gingerologist/am64x/(list of files, drawings)

Other design files:
01.SchDoc
02.SchDoc
03.SchDoc
04.SchDoc
05.SchDoc
06.SchDoc
07.SchDoc
08.SchDoc
09.SchDoc
10.SchDoc
11.SchDoc
12.SchDoc
13.SchDoc
14.SchDoc
15.SchDoc
16.SchDoc
17.SchDoc
18.SchDoc
19.SchDoc
20.SchDoc
21.SchDoc
22.SchDoc
23.SchDoc
24.SchDoc
25.SchDoc
26.SchDoc
27.SchDoc
28.SchDoc
29.SchDoc
30.SchDoc
31.SchDoc
32.SchDoc
33.SchDoc
34.SchDoc
35.SchDoc
36.SchDoc
37.SchDoc
38.SchDoc
39.SchDoc
40.SchDoc
PROC101D_SCH_With_Design_Updates..Notes_V1.0.PrjPcb
PROC101D_SCH_With_Design_Updates..Notes_V1.0_Library.SchLib
