gingerologist/am64x/09.kicad_sch

## KiCad design 09.kicad_sch (2024-08-05)

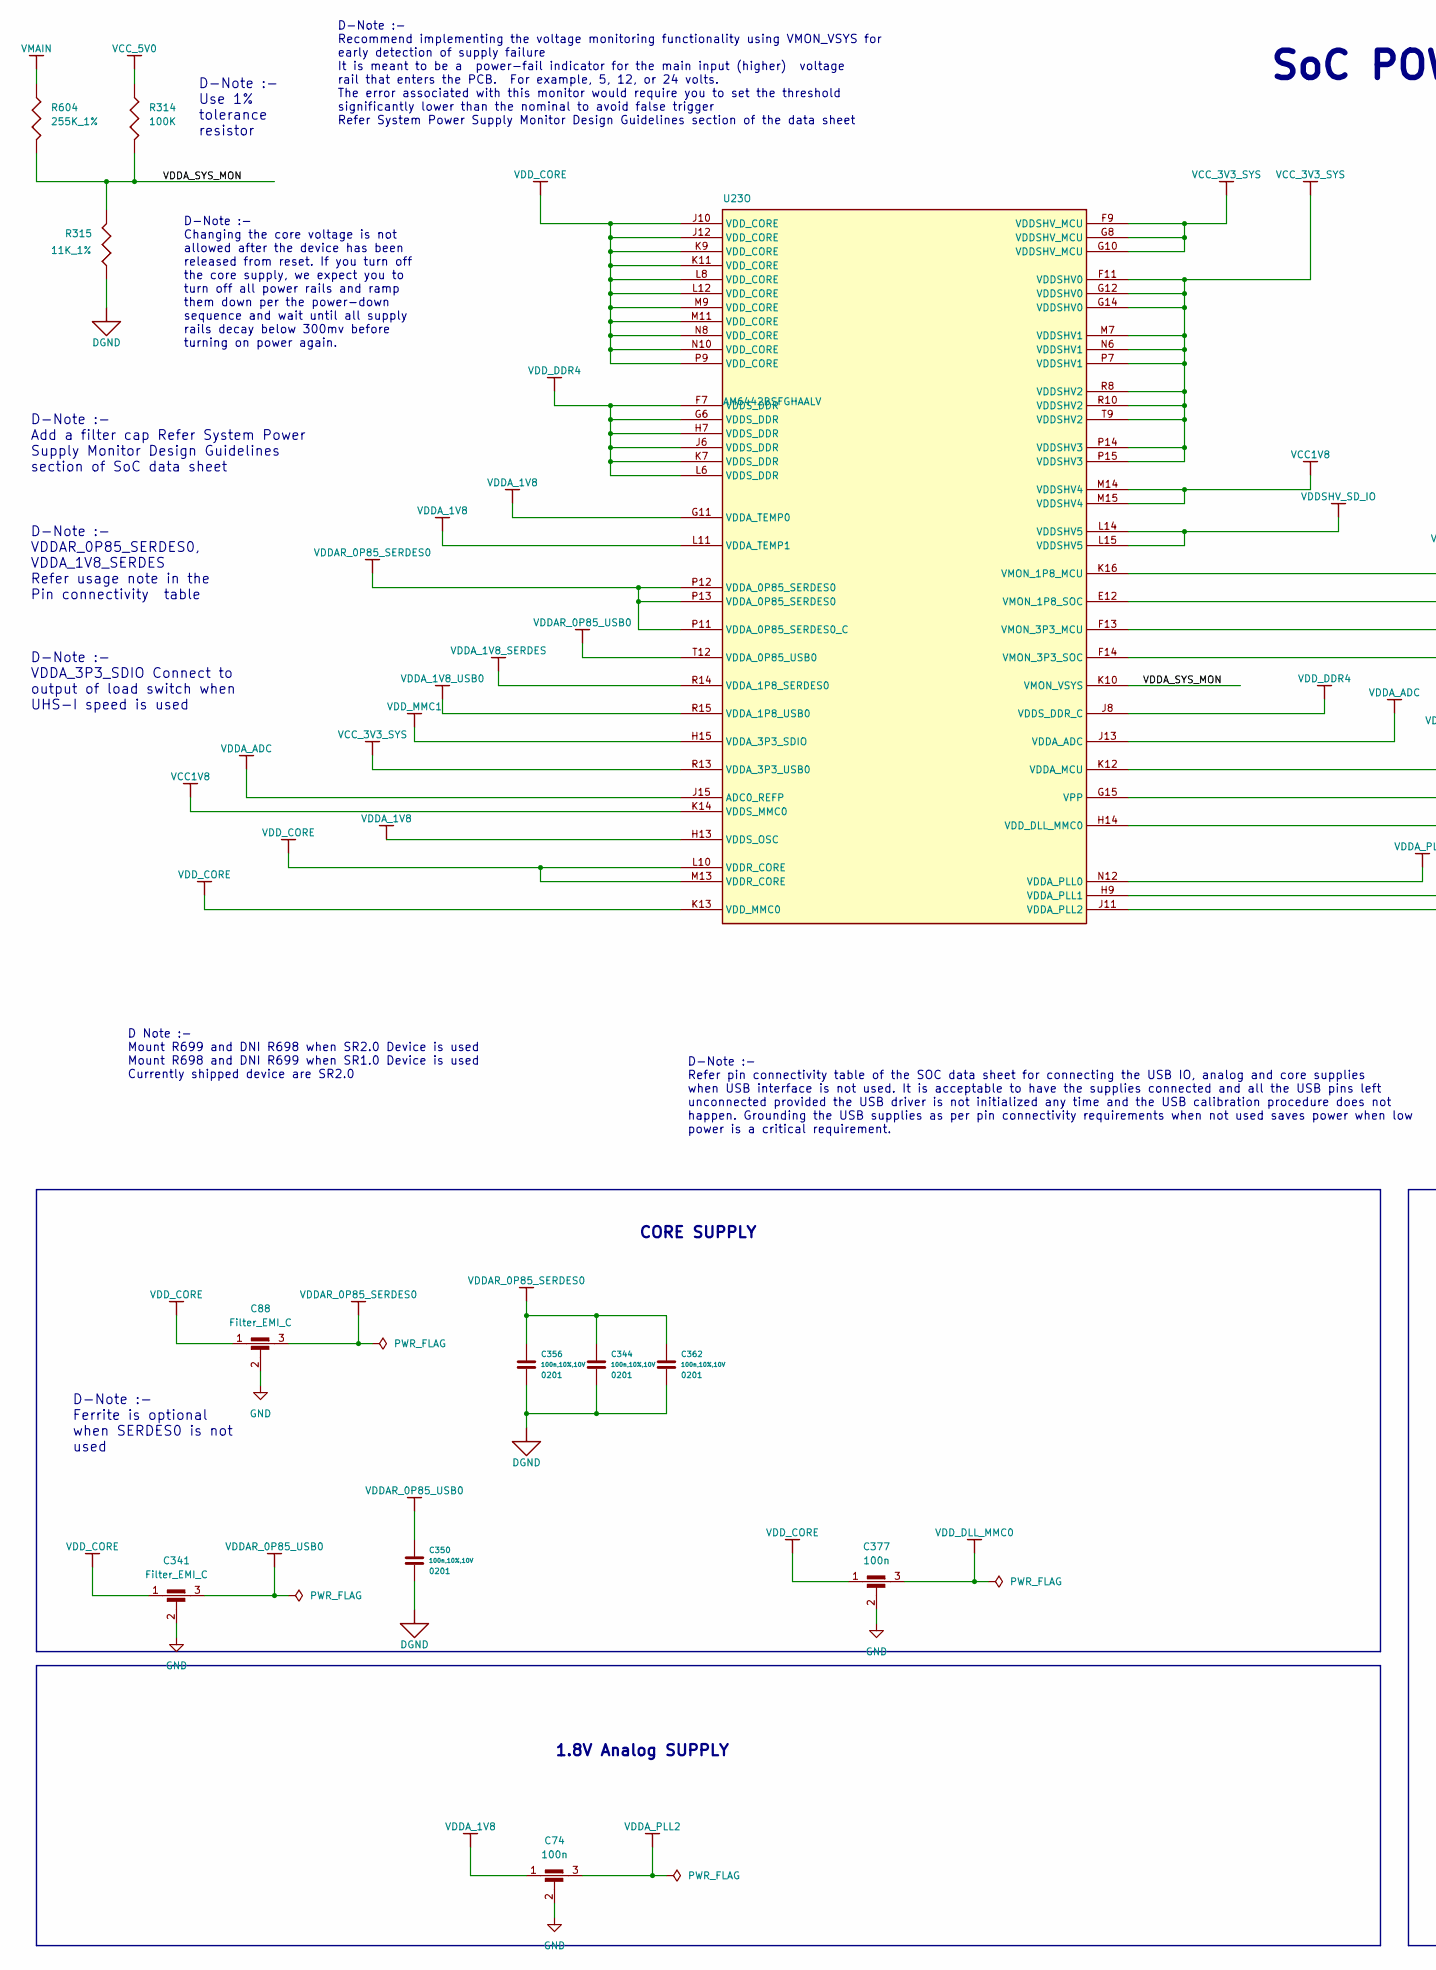
[picture p1: schematic 09.kicad_sch, part in row 1, column 1]

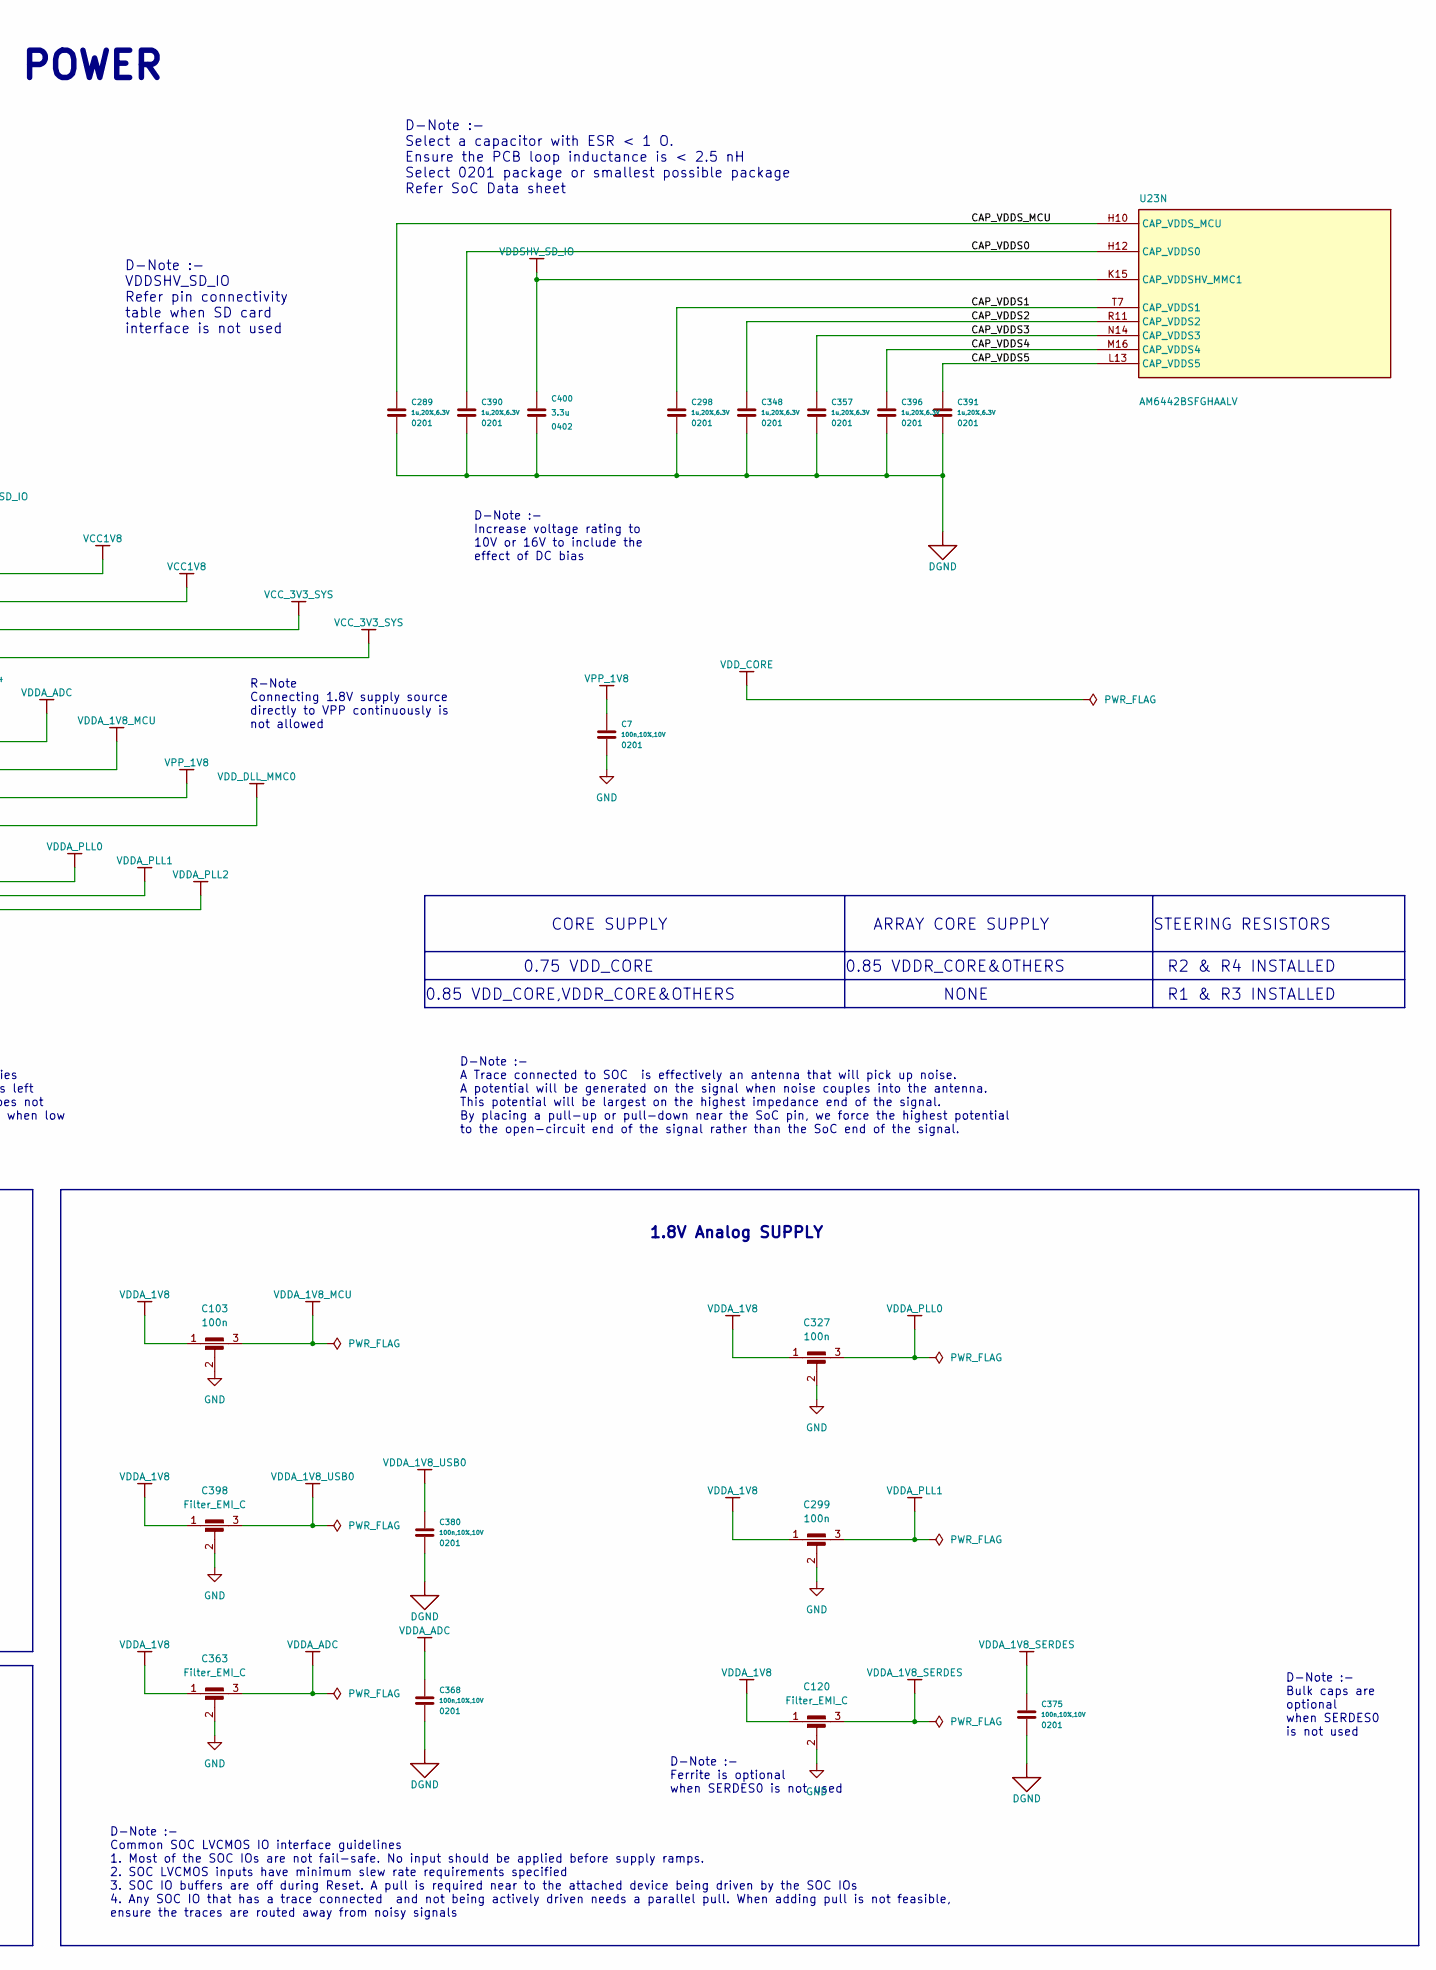
[picture p2: schematic 09.kicad_sch, part in row 1, column 2]

Parts:
C7, C344, C350, C356, C362, C368, C375, C380: 100n,10%,10V; C_0201_0603Metric_0.64x0.32mm_Courtyard; Manufacturer Part GRM033R61A104KE15D
C74, C103, C299, C327, C377: 100n; NFM15
C88, C120, C341, C363, C398: Filter_EMI_C; NFM15
C289, C298, C348, C357, C390, C391, C396: 1u,20%,6.3V; C_0201_0603Metric_0.64x0.32mm_Courtyard; Manufacturer Part GRM033R60J105MEA2D
C400: 3.3u; C_0402_1005Metric
R314: 100K; RES0402_0-5; VOLTAGE NA; TOLERANCE 5%; PART_TYPE RESISTOR~{S}FIXED
R315: 11K_1%; RES0402_0-5; TOLERANCE 1%; VOLTAGE NA; MISTRAL PART NO 110015110012-R
R604: 255K_1%; RES0402_0-5; VOLTAGE NA; TOLERANCE 1%; PART_TYPE RESISTOR~{S}FIXED
U23: AM6442BSFGHAALV; FCBGA441_31-49_680X680_2-6; TOLERANCE NA; VOLTAGE NA; MISTRAL PART NO 141220080002

Connections:
CAP_VDDS0: C390.1, U23.H12 (CAP_VDDS0)
CAP_VDDS1: C298.1, U23.T7 (CAP_VDDS1)
CAP_VDDS2: C348.1, U23.R11 (CAP_VDDS2)
CAP_VDDS3: C357.1, U23.N14 (CAP_VDDS3)
CAP_VDDS4: C396.1, U23.M16 (CAP_VDDS4)
CAP_VDDS5: C391.1, U23.L13 (CAP_VDDS5)
CAP_VDDS_MCU: C289.1, U23.H10 (CAP_VDDS_MCU)
DGND: C289.2, C298.2, C344.2, C348.2, C350.2, C356.2, C357.2, C362.2, C368.2, C375.2, C380.2, C390.2, C391.2, C396.2, C400.2, R315.2
GND: C7.2, C74.2, C88.2, C103.2, C120.2, C299.2, C327.2, C341.2, C363.2, C377.2, C398.2
VCC1V8: U23.E12 (VMON_1P8_SOC), U23.K14 (VDDS_MMC0), U23.K16 (VMON_1P8_MCU), U23.M14 (VDDSHV4), U23.M15 (VDDSHV4)
VCC_3V3_SYS: U23.F9 (VDDSHV_MCU), U23.F11 (VDDSHV0), U23.F13 (VMON_3P3_MCU), U23.F14 (VMON_3P3_SOC), U23.G8 (VDDSHV_MCU), U23.G10 (VDDSHV_MCU), U23.G12 (VDDSHV0), U23.G14 (VDDSHV0), U23.M7 (VDDSHV1), U23.N6 (VDDSHV1), U23.P7 (VDDSHV1), U23.P14 (VDDSHV3), U23.P15 (VDDSHV3), U23.R8 (VDDSHV2), U23.R10 (VDDSHV2), U23.R13 (VDDA_3P3_USB0), U23.T9 (VDDSHV2)
VCC_5V0: R314.1
VDDAR_0P85_SERDES0: C88.3, C344.1, C356.1, C362.1, U23.P11 (VDDA_0P85_SERDES0_C), U23.P12 (VDDA_0P85_SERDES0), U23.P13 (VDDA_0P85_SERDES0)
VDDAR_0P85_USB0: C341.3, C350.1, U23.T12 (VDDA_0P85_USB0)
VDDA_1V8: C74.1, C103.1, C120.1, C299.1, C327.1, C363.1, C398.1, U23.G11 (VDDA_TEMP0), U23.H13 (VDDS_OSC), U23.L11 (VDDA_TEMP1)
VDDA_1V8_MCU: C103.3, U23.K12 (VDDA_MCU)
VDDA_1V8_SERDES: C120.3, C375.1, U23.R14 (VDDA_1P8_SERDES0)
VDDA_1V8_USB0: C380.1, C398.3, U23.R15 (VDDA_1P8_USB0)
VDDA_ADC: C363.3, C368.1, U23.J13 (VDDA_ADC), U23.J15 (ADC0_REFP)
VDDA_PLL0: C327.3, U23.N12 (VDDA_PLL0)
VDDA_PLL1: C299.3, U23.H9 (VDDA_PLL1)
VDDA_PLL2: C74.3, U23.J11 (VDDA_PLL2)
VDDA_SYS_MON: R314.2, R315.1, R604.2, U23.K10 (VMON_VSYS)
VDDSHV_SD_IO: C400.1, U23.K15 (CAP_VDDSHV_MMC1), U23.L14 (VDDSHV5), U23.L15 (VDDSHV5)
VDD_CORE: C88.1, C341.1, C377.1, U23.J10 (VDD_CORE), U23.J12 (VDD_CORE), U23.K9 (VDD_CORE), U23.K11 (VDD_CORE), U23.K13 (VDD_MMC0), U23.L8 (VDD_CORE), U23.L10 (VDDR_CORE), U23.L12 (VDD_CORE), U23.M9 (VDD_CORE), U23.M11 (VDD_CORE), U23.M13 (VDDR_CORE), U23.N8 (VDD_CORE), U23.N10 (VDD_CORE), U23.P9 (VDD_CORE)
VDD_DDR4: U23.F7 (VDDS_DDR), U23.G6 (VDDS_DDR), U23.H7 (VDDS_DDR), U23.J6 (VDDS_DDR), U23.J8 (VDDS_DDR_C), U23.K7 (VDDS_DDR), U23.L6 (VDDS_DDR)
VDD_DLL_MMC0: C377.3, U23.H14 (VDD_DLL_MMC0)
VDD_MMC1: U23.H15 (VDDA_3P3_SDIO)
VMAIN: R604.1
VPP_1V8: C7.1, U23.G15 (VPP)

Notes on the sheet:
D-Note :- Changing the core voltage is not allowed after the device has been released from reset. If you turn off the core supply, we expect you to turn off all power rails and ramp them down per the power-down sequence and wait until all supply rails decay below 300mv before turning on power again.
D-Note :- Ferrite is optional when SERDES0 is not used
D-Note :- Bulk caps are optional when SERDES0 is not used
D-Note :- Increase voltage rating to 10V or 16V to include the effect of DC bias
D-Note :- Ferrite is optional when SERDES0 is not used
D-Note :- VDDAR_0P85_SERDES0, VDDA_1V8_SERDES Refer usage note in the Pin connectivity table
D-Note :- Recommend implementing the voltage monitoring functionality using VMON_VSYS for early detection of supply failure It is meant to be a power-fail indicator for the main input (higher) voltage rail that enters the PCB. For example, 5, 12, or 24 volts. The error associated with this monitor 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
R-Note Connecting 1.8V supply source directly to VPP continuously is not allowed
D-Note :- VDDA_3P3_SDIO Connect to output of load switch when UHS-I speed is used
D-Note :- Add a filter cap Refer System Power Supply Monitor Design Guidelines section of SoC data sheet
D Note :- Mount R699 and DNI R698 when SR2.0 Device is used Mount R698 and DNI R699 when SR1.0 Device is used Currently shipped device are SR2.0
D-Note :- A Trace connected to SOC is effectively an antenna that will pick up noise. A potential will be generated on the signal when noise couples into the antenna. This potential will be largest on the highest impedance end of the signal. By placing a pull-up or pull-down near the SoC pin, we fo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
D-Note :- Common SOC LVCMOS IO interface guidelines 1. Most of the SOC IOs are not fail-safe. No input should be applied before supply ramps. 2. SOC LVCMOS inputs have minimum slew rate requirements specified 3. SOC IO buffers are off during Reset. A pull is required near to the attached device bei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
D-Note :- Use 1% tolerance resistor
D-Note :- VDDSHV_SD_IO Refer pin connectivity table when SD card interface is not used
D-Note :- Select a capacitor with ESR < 1 O. Ensure the PCB loop inductance is < 2.5 nH Select 0201 package or smallest possible package Refer SoC Data sheet
D-Note :- Refer pin connectivity table of the SOC data sheet for connecting the USB IO, analog and core supplies when USB interface is not used. It is acceptable to have the supplies connected and all the USB pins left unconnected provided the USB driver is not initialized any time and the USB cali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
CORE SUPPLY
1.8V Analog SUPPLY
0.85 VDDR_CORE&OTHERS
SoC POWER
STEERING RESISTORS
NONE
0.85 VDD_CORE,VDDR_CORE&OTHERS
ARRAY CORE SUPPLY
R1 & R3 INSTALLED
0.75 VDD_CORE
R2 & R4 INSTALLED
