gingerologist/am64x/10.kicad_sch

## KiCad design 10.kicad_sch (2024-08-05)

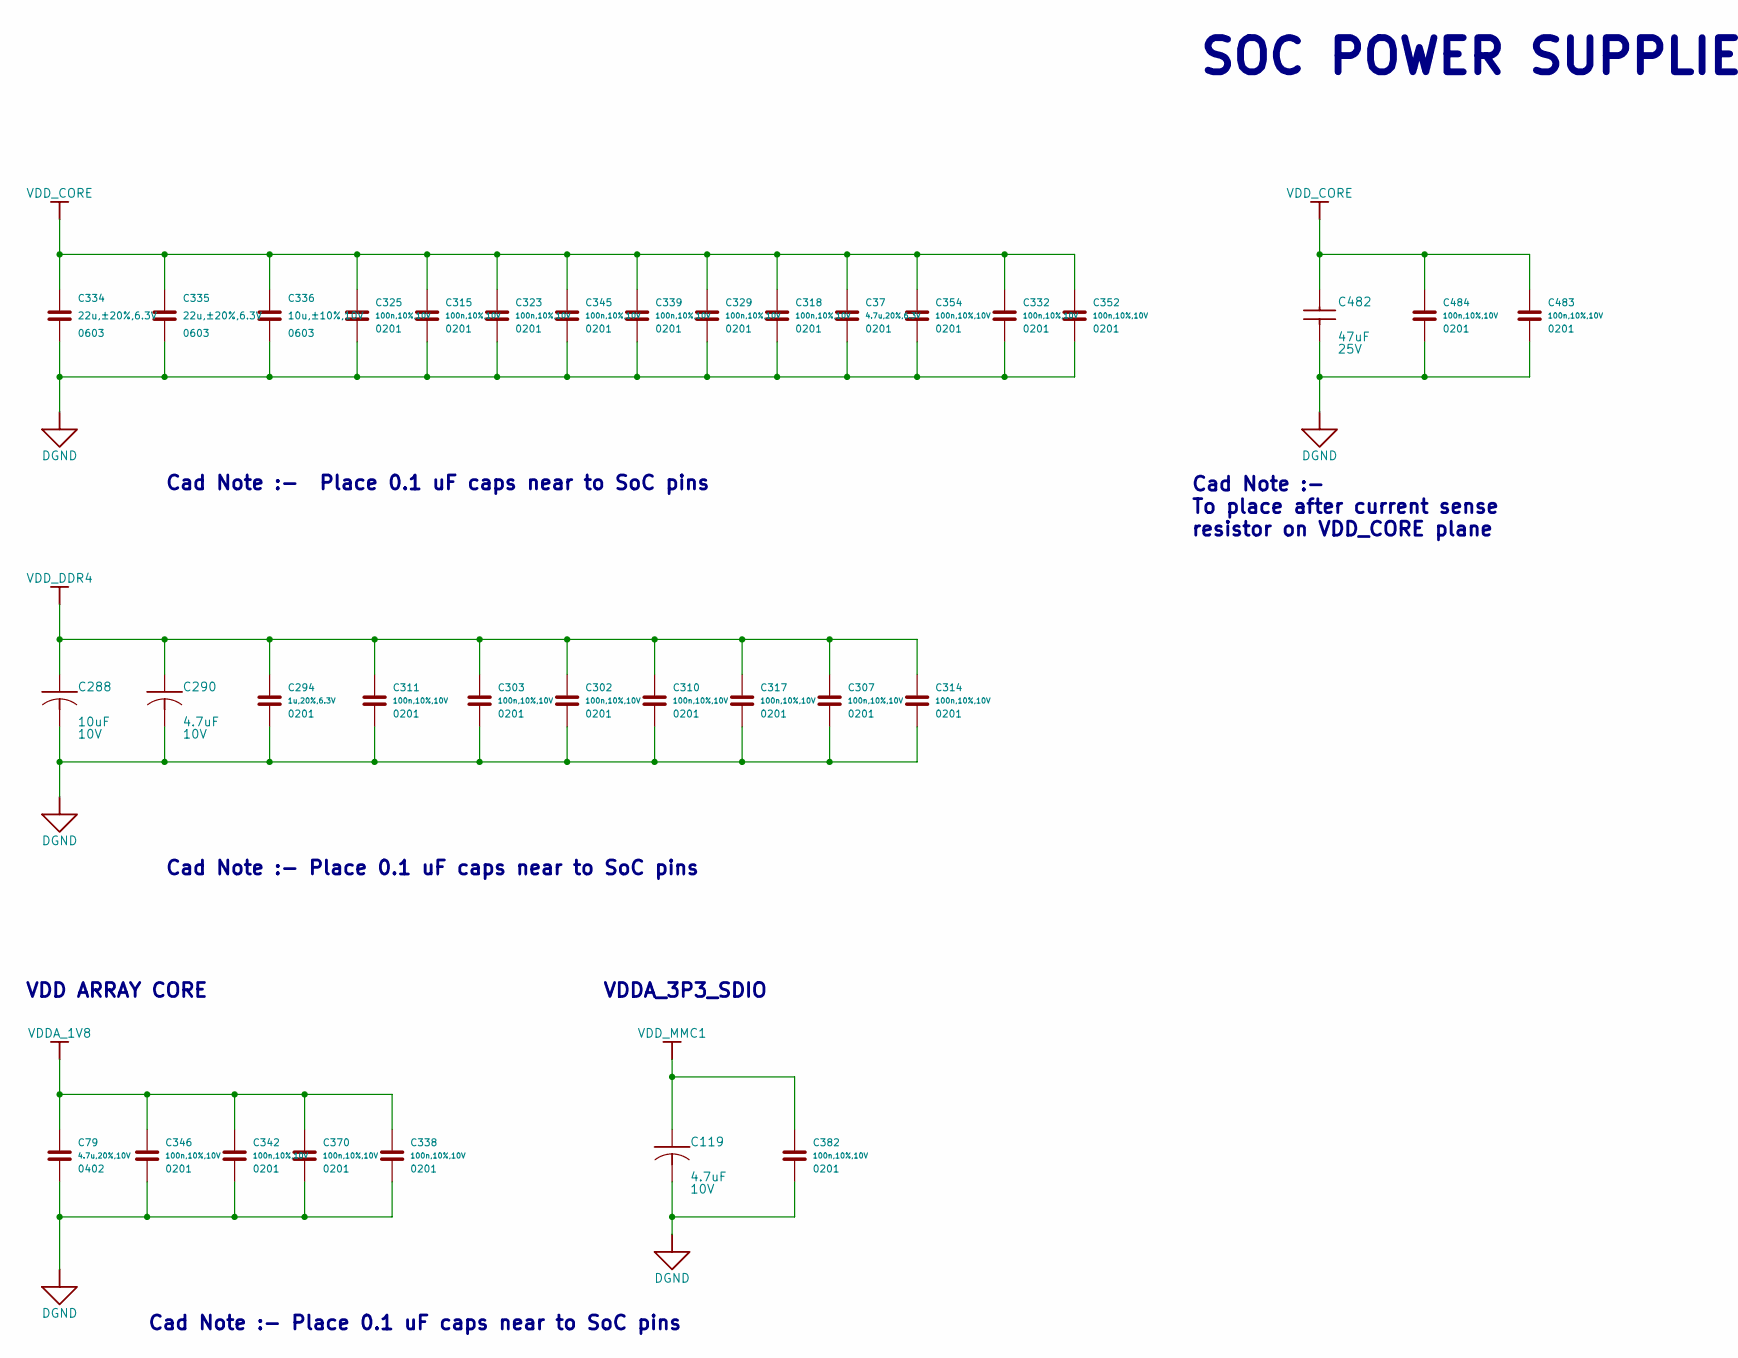
[picture p3: schematic 10.kicad_sch, part in row 1, column 1]

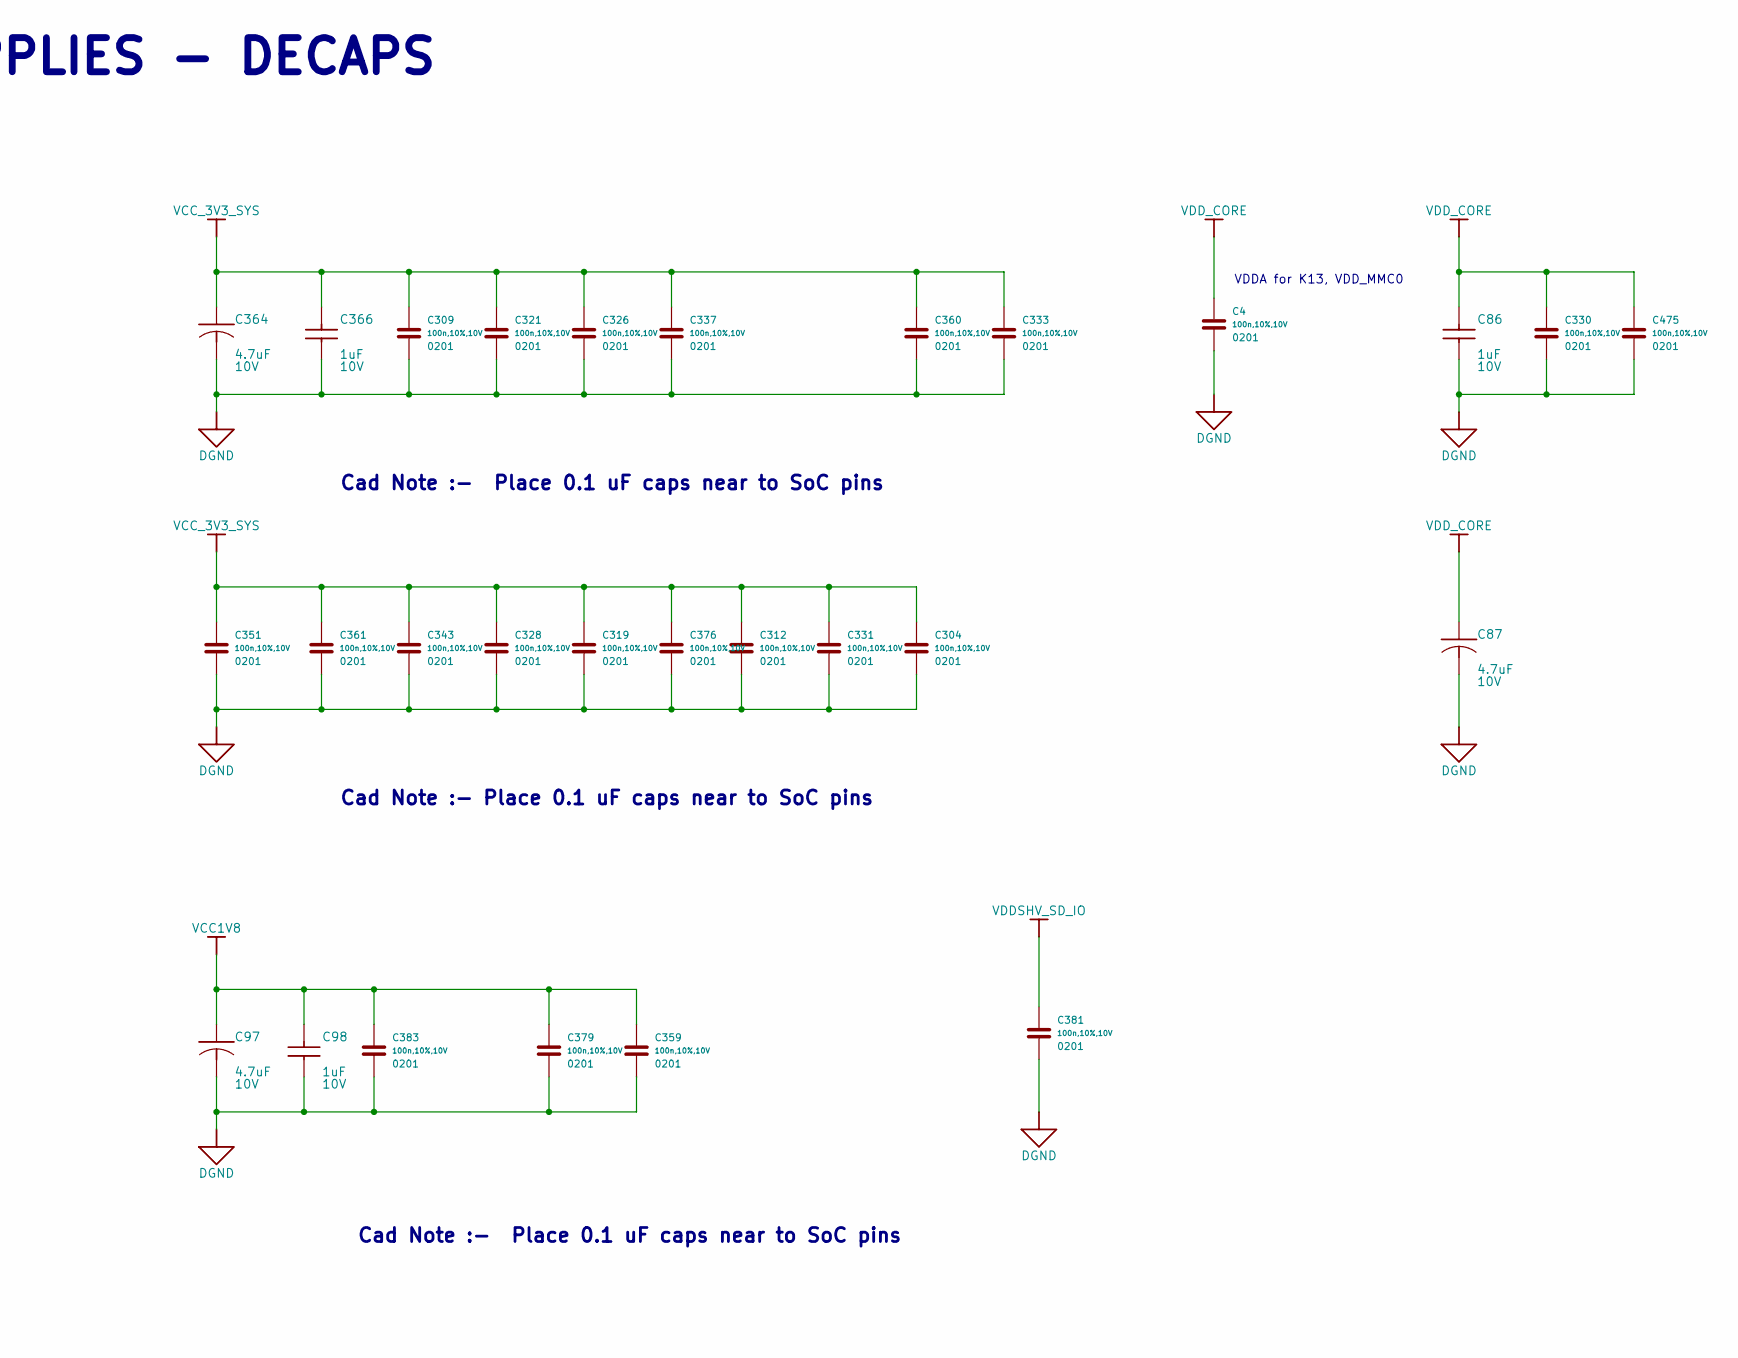
[picture p4: schematic 10.kicad_sch, part in row 1, column 2]

Parts:
C4, C302, C303, C304, C307, C309, C310, C311, C312, C314, C315, C317, C318, C319, C321, C323, C325, C326, C328, C329, C330, C331, C332, C333, C337, C338, C339, C342, C343, C345, C346, C351, C352, C354, C359, C360, C361, C370, C376, C379, C381, C382, C383, C475, C483, C484: 100n,10%,10V; C_0201_0603Metric_0.64x0.32mm_Courtyard; Manufacturer Part GRM033R61A104KE15D
C37: 4.7u,20%,6.3V; C_0201_0603Metric_0.64x0.32mm_Courtyard; Manufacturer Part GRM035R60J475ME15D
C79: 4.7u,20%,10V; C_0402_1005Metric_for_0.25mm_grid; Manufacturer Part CL05A475MP5NRNC
C86, C98: 1uF; CAP0402_0-75; TOLERANCE 20%; VOLTAGE 10V; MISTRAL PART NO 120020080009-R
C87, C119, C290, C364: 4.7uF; CAP0402_0-75; TOLERANCE 20%; VOLTAGE 10V; MISTRAL PART NO 120012060002-R
C97: 4.7uF; CAP0402_0-75; VOLTAGE 10V; TOLERANCE 20%; PART_TYPE CAPACITOR~{S}CERAMIC
C288: 10uF; CAP0402_0-75; TOLERANCE 20%; VOLTAGE 10V; MISTRAL PART NO 120013110019-R
C294: 1u,20%,6.3V; C_0201_0603Metric_0.64x0.32mm_Courtyard; Manufacturer Part GRM033R60J105MEA2D
C334, C335: 22u,±20%,6.3V; C_0603_1608Metric_1.28x0.64mm_Courtyard; Manufacturer Part CL10A226MQ8NRNC
C336: 10u,±10%,10V; C_0603_1608Metric_1.28x0.64mm_Courtyard; Manufacturer Part CL10A106KP8NNNC
C366: 1uF; CAP0402_0-75; VOLTAGE 10V; TOLERANCE 20%; PART_TYPE CAPACITOR~{S}CERAMIC
C482: 47uF; CAP1206_2; TOLERANCE 20%; VOLTAGE 25V; MISTRAL PART NO 120013050002-R

Connections:
DGND: C4.2, C37.2, C79.2, C86.1, C87.2, C97.2, C98.1, C119.2, C288.2, C290.2, C294.2, C302.2, C303.2, C304.2, C307.2, C309.2, C310.2, C311.2, C312.2, C314.2, C315.2, C317.2, C318.2, C319.2, C321.2, C323.2, C325.2, C326.2, C328.2, C329.2, C330.2, C331.2, C332.2, C333.2, C334.2, C335.2, C336.2, C337.2, C338.2, C339.2, C342.2, C343.2, C345.2, C346.2, C351.2, C352.2, C354.2, C359.2, C360.2, C361.2, C364.2, C366.1, C370.2, C376.2, C379.2, C381.2, C382.2, C383.2, C475.2, C482.2, C483.2, C484.2
VCC1V8: C97.1, C98.2, C359.1, C379.1, C383.1
VCC_3V3_SYS: C304.1, C309.1, C312.1, C319.1, C321.1, C326.1, C328.1, C331.1, C333.1, C337.1, C343.1, C351.1, C360.1, C361.1, C364.1, C366.2, C376.1
VDDA_1V8: C79.1, C338.1, C342.1, C346.1, C370.1
VDDSHV_SD_IO: C381.1
VDD_CORE: C4.1, C37.1, C86.2, C87.1, C315.1, C318.1, C323.1, C325.1, C329.1, C330.1, C332.1, C334.1, C335.1, C336.1, C339.1, C345.1, C352.1, C354.1, C475.1, C482.1, C483.1, C484.1
VDD_DDR4: C288.1, C290.1, C294.1, C302.1, C303.1, C307.1, C310.1, C311.1, C314.1, C317.1
VDD_MMC1: C119.1, C382.1

Notes on the sheet:
Cad Note :- To place after current sense resistor on VDD_CORE plane
Cad Note :- Place 0.1 uF caps near to SoC pins
Cad Note :- Place 0.1 uF caps near to SoC pins
SOC POWER SUPPLIES - DECAPS
VDDA_3P3_SDIO
VDDA for K13, VDD_MMC0
VDD ARRAY CORE
