gingerologist/am64x/11.kicad_sch

## KiCad design 11.kicad_sch (2024-08-05)

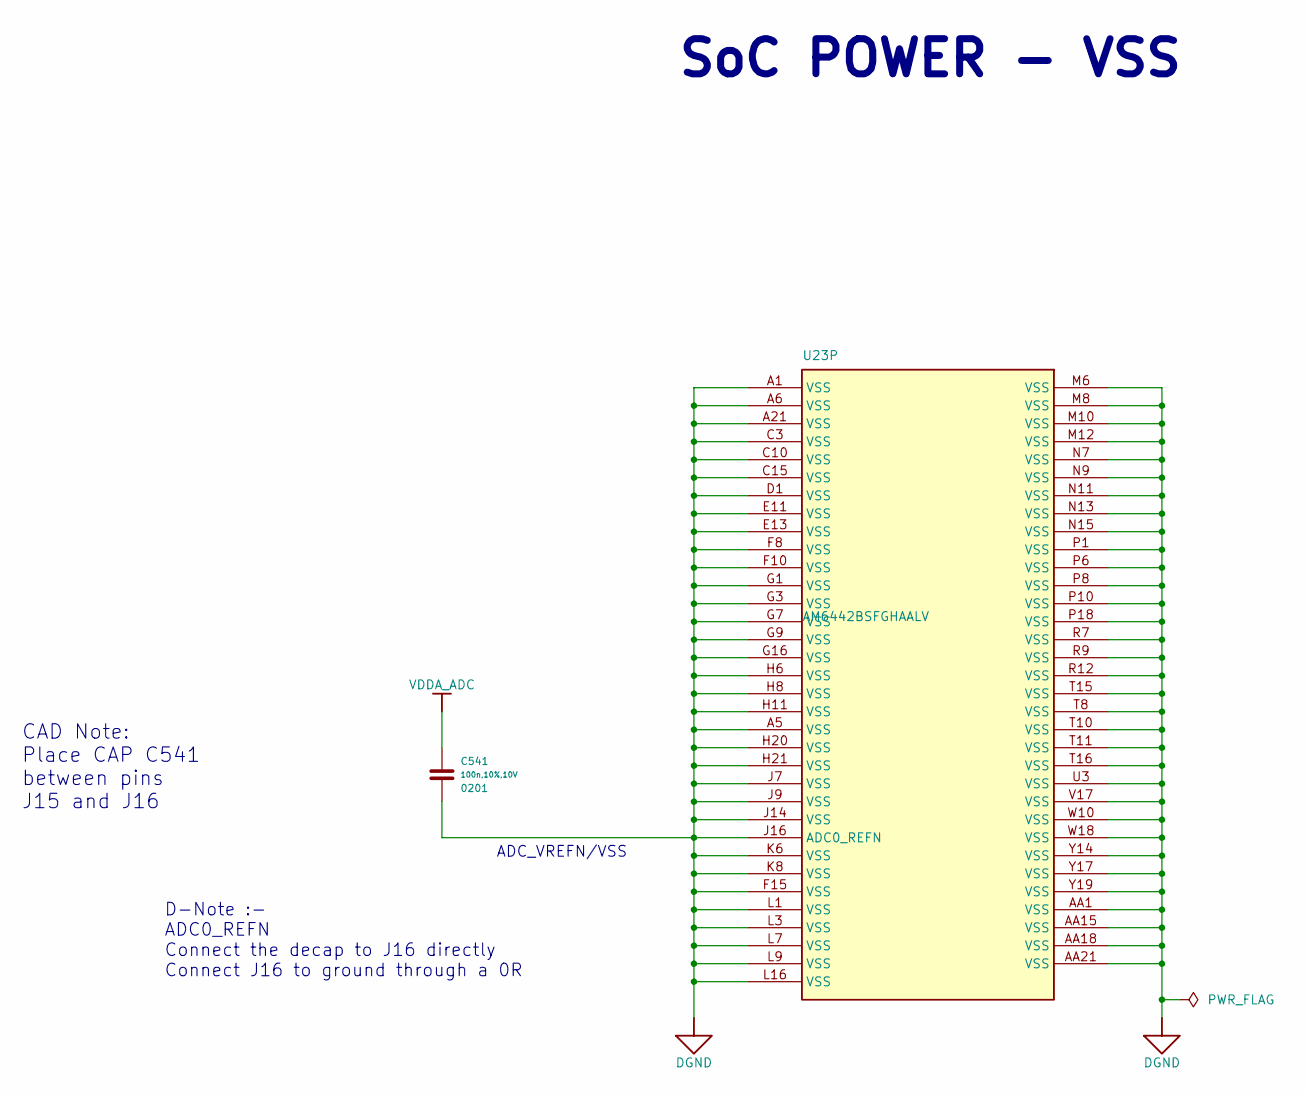
[picture p5: schematic 11.kicad_sch]

Parts:
C541: 100n,10%,10V; C_0201_0603Metric_0.64x0.32mm_Courtyard; Manufacturer Part GRM033R61A104KE15D
U23: AM6442BSFGHAALV; FCBGA441_31-49_680X680_2-6; TOLERANCE NA; VOLTAGE NA; MISTRAL PART NO 141220080002

Connections:
DGND: C541.2, U23.A1 (VSS), U23.A5 (VSS), U23.A6 (VSS), U23.A21 (VSS), U23.AA1 (VSS), U23.AA15 (VSS), U23.AA18 (VSS), U23.AA21 (VSS), U23.C3 (VSS), U23.C10 (VSS), U23.C15 (VSS), U23.D1 (VSS), U23.E11 (VSS), U23.E13 (VSS), U23.F8 (VSS), U23.F10 (VSS), U23.F15 (VSS), U23.G1 (VSS), U23.G3 (VSS), U23.G7 (VSS), U23.G9 (VSS), U23.G16 (VSS), U23.H6 (VSS), U23.H8 (VSS), U23.H11 (VSS), U23.H20 (VSS), U23.H21 (VSS), U23.J7 (VSS), U23.J9 (VSS), U23.J14 (VSS), U23.J16 (ADC0_REFN), U23.K6 (VSS), U23.K8 (VSS), U23.L1 (VSS), U23.L3 (VSS), U23.L7 (VSS), U23.L9 (VSS), U23.L16 (VSS), U23.M6 (VSS), U23.M8 (VSS), U23.M10 (VSS), U23.M12 (VSS), U23.N7 (VSS), U23.N9 (VSS), U23.N11 (VSS), U23.N13 (VSS), U23.N15 (VSS), U23.P1 (VSS), U23.P6 (VSS), U23.P8 (VSS), U23.P10 (VSS), U23.P18 (VSS), U23.R7 (VSS), U23.R9 (VSS), U23.R12 (VSS), U23.T8 (VSS), U23.T10 (VSS), U23.T11 (VSS), U23.T15 (VSS), U23.T16 (VSS), U23.U3 (VSS), U23.V17 (VSS), U23.W10 (VSS), U23.W18 (VSS), U23.Y14 (VSS), U23.Y17 (VSS), U23.Y19 (VSS)
VDDA_ADC: C541.1

Notes on the sheet:
D-Note :- ADC0_REFN Connect the decap to J16 directly Connect J16 to ground through a 0R
CAD Note: Place CAP C541 between pins J15 and J16
SoC POWER - VSS
ADC_VREFN/VSS
