gingerologist/am64x/12.kicad_sch

## KiCad design 12.kicad_sch (2024-08-05)

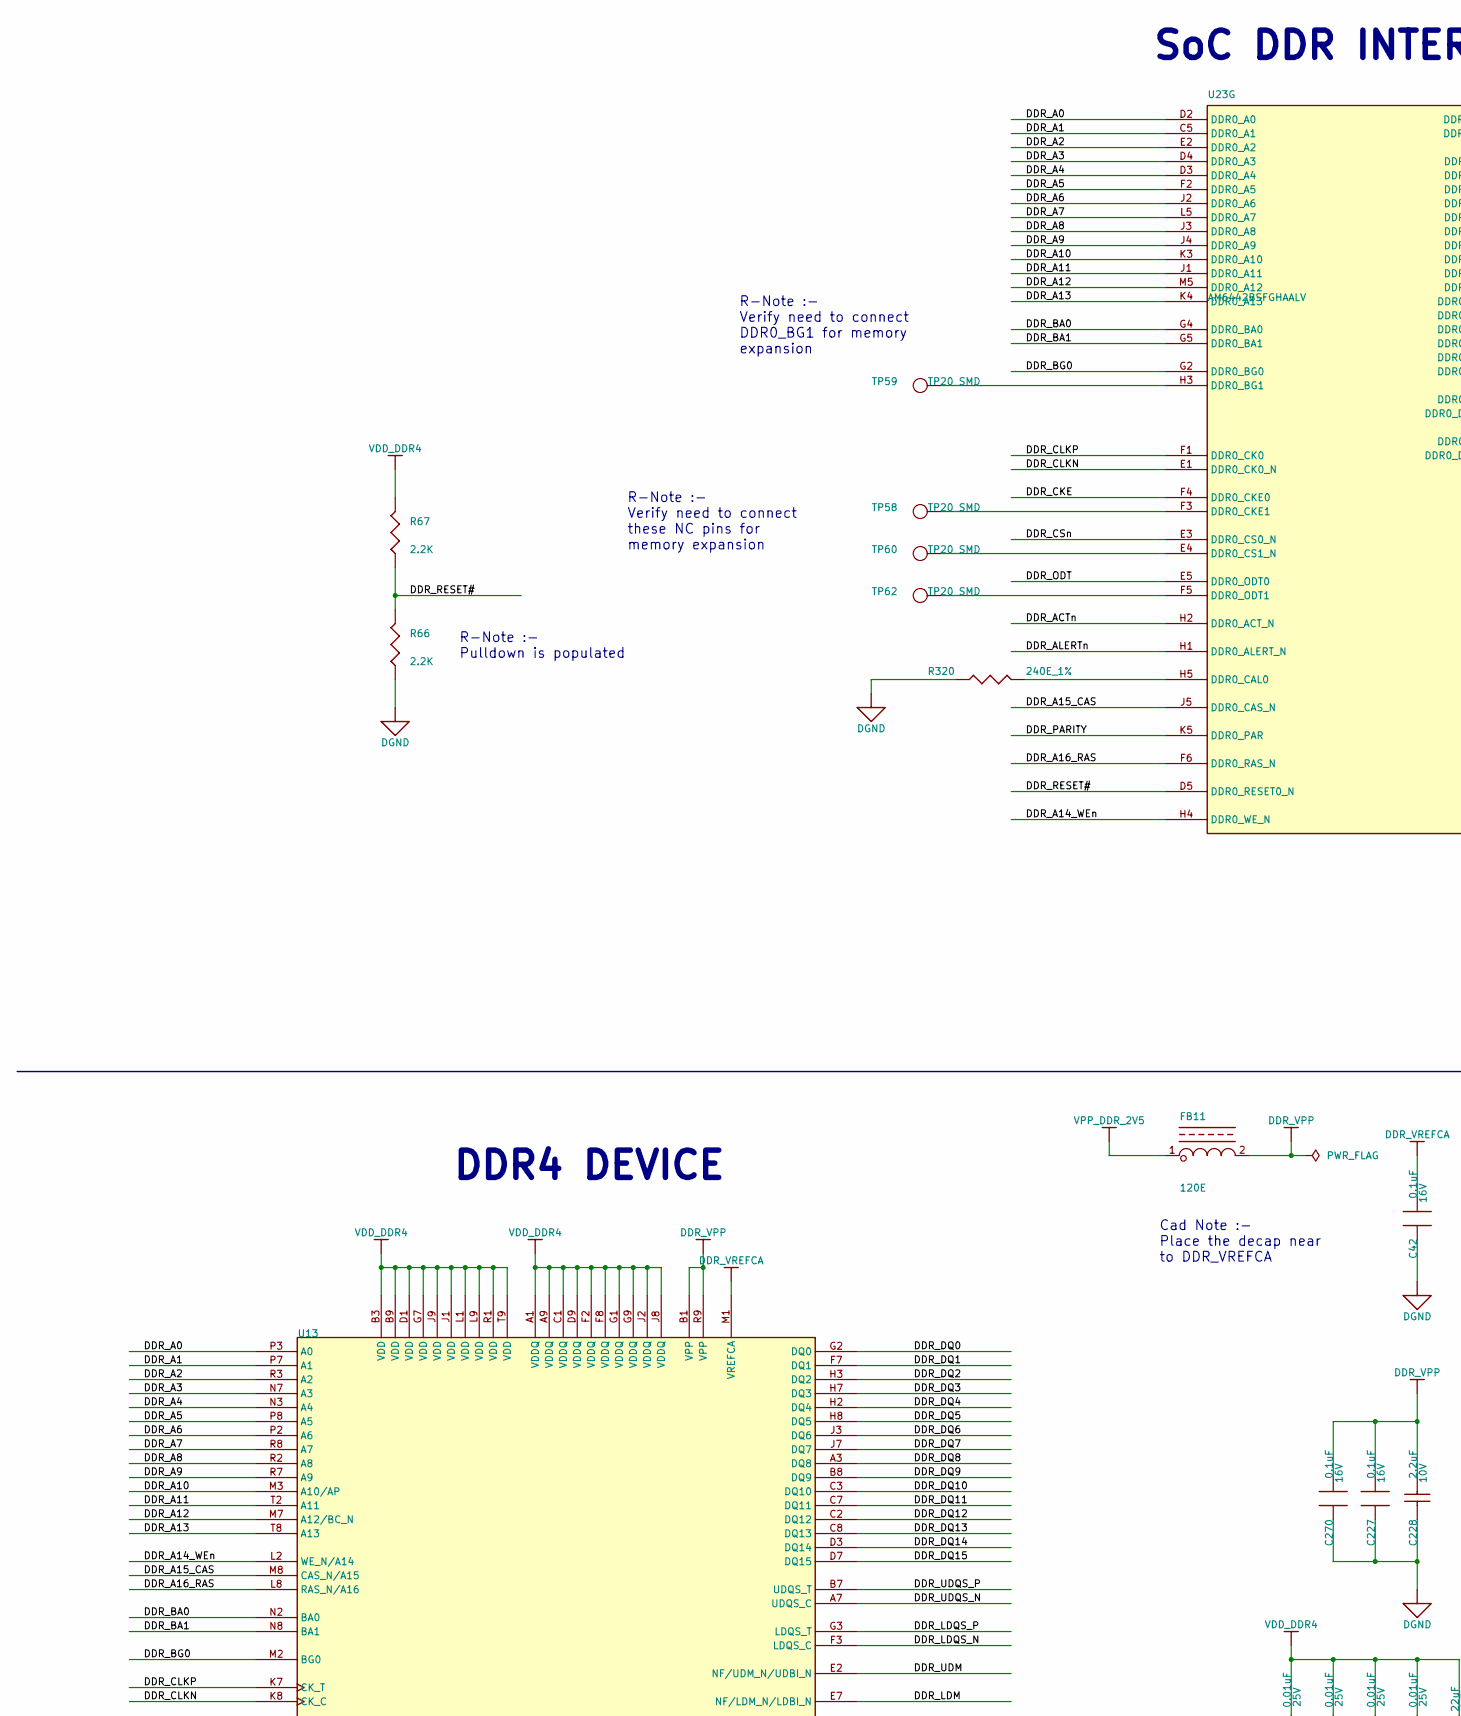
[picture p6: schematic 12.kicad_sch, part in row 1, column 1]

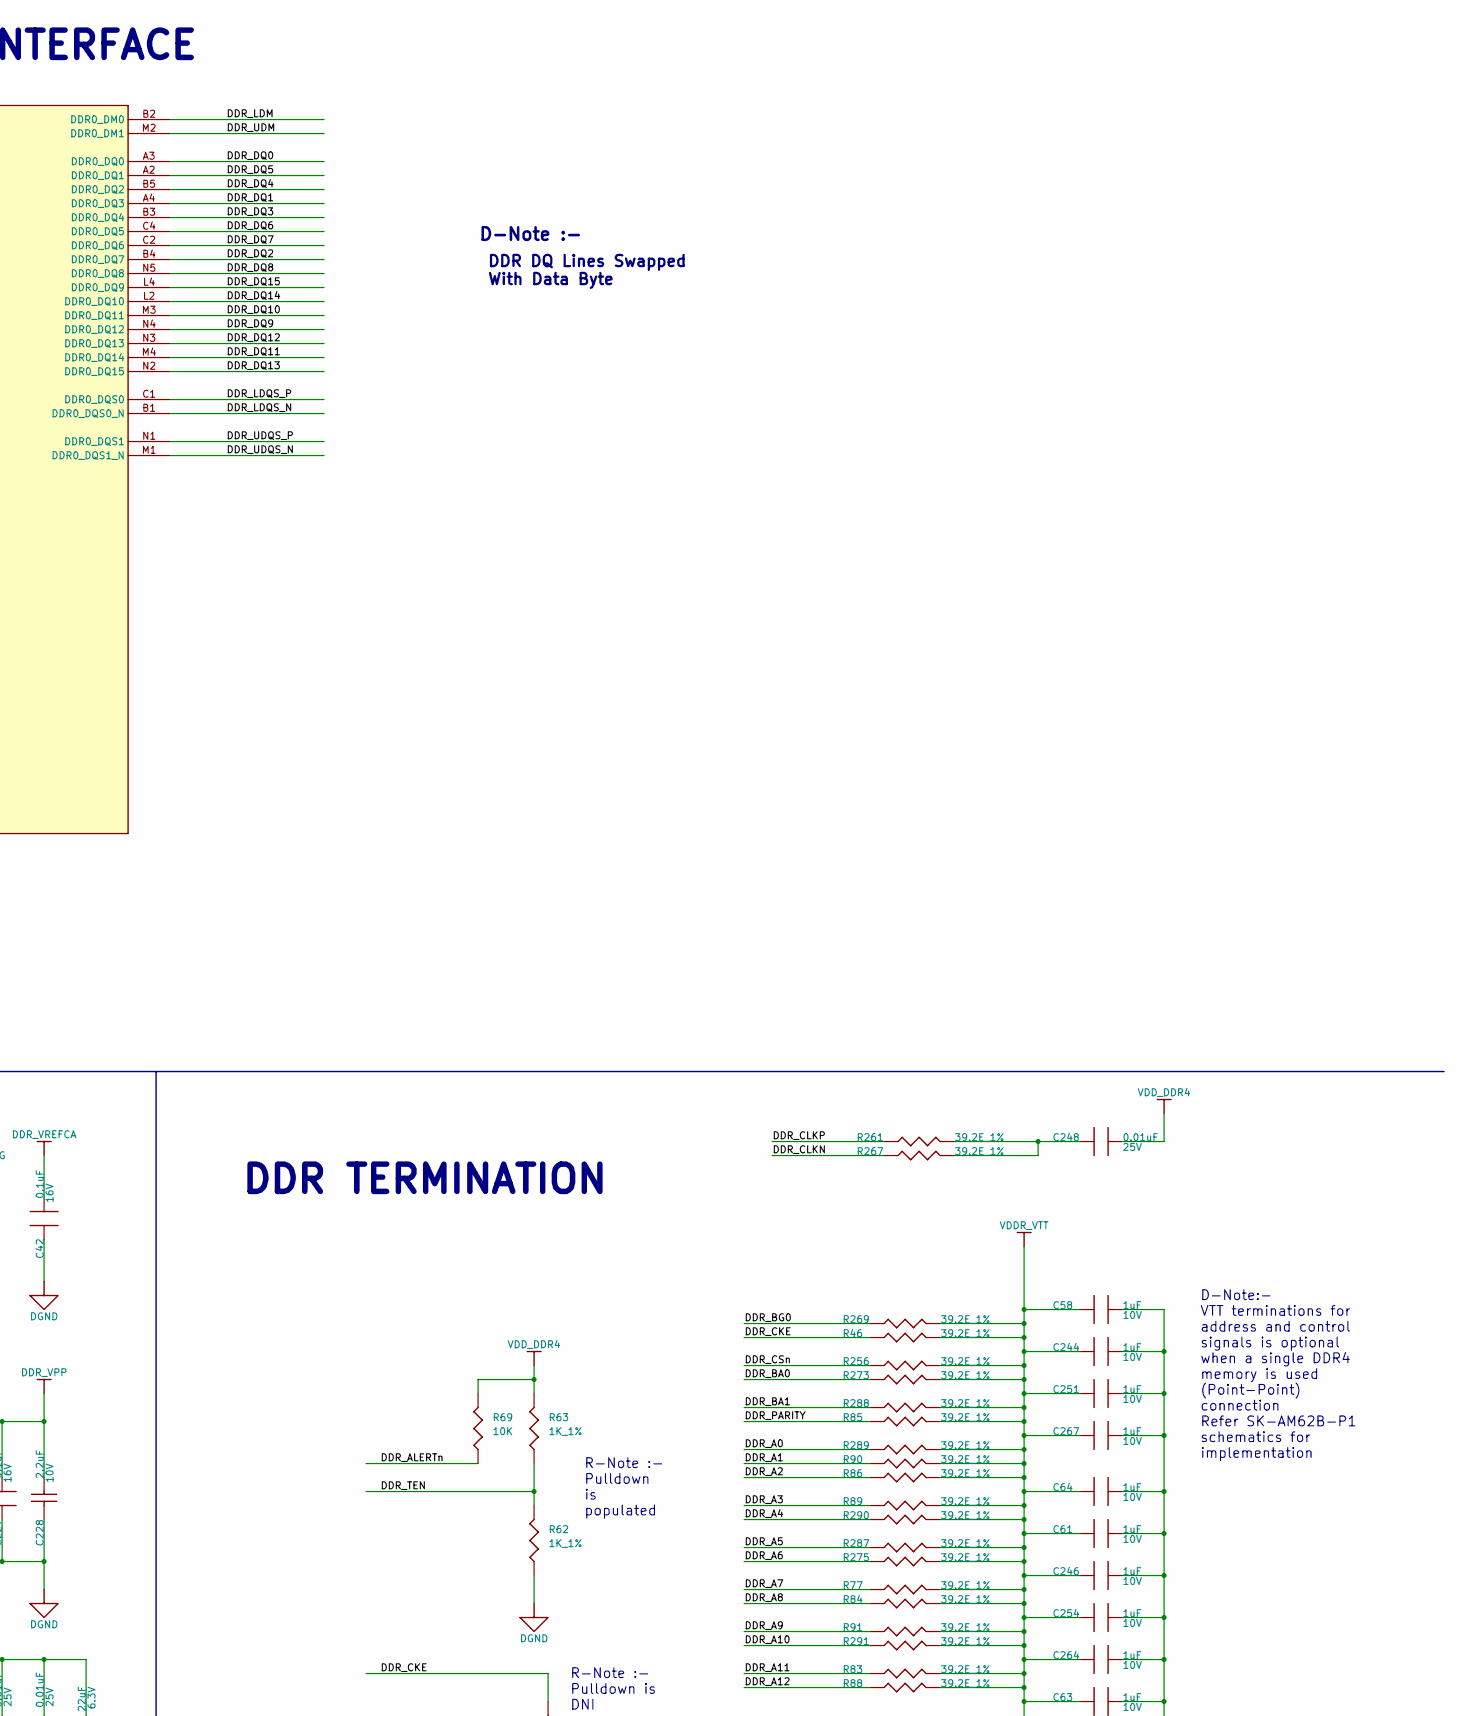
[picture p7: schematic 12.kicad_sch, part in row 1, column 2]

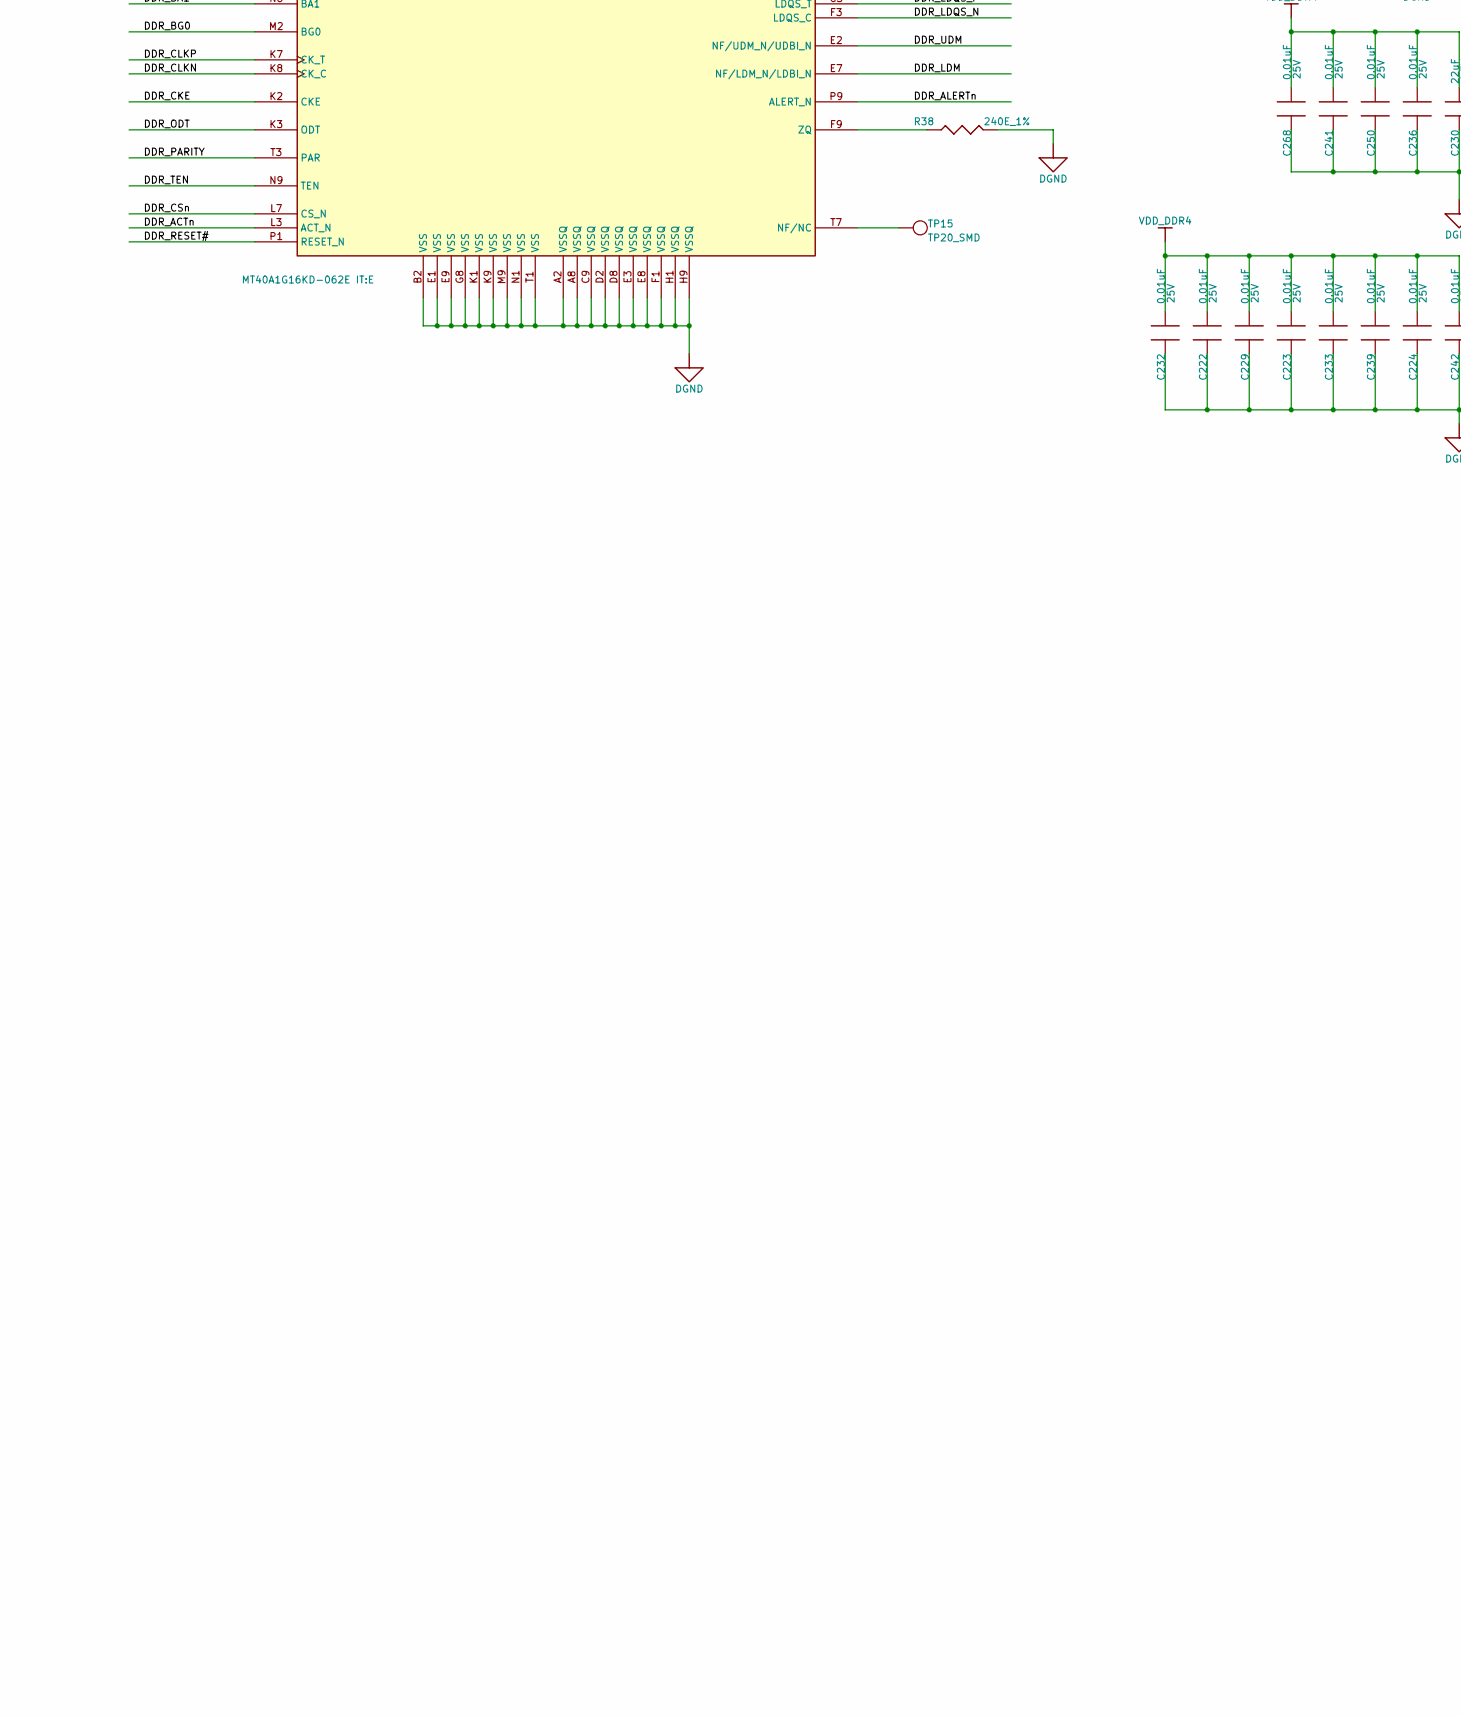
[picture p8: schematic 12.kicad_sch, part in row 2, column 1]

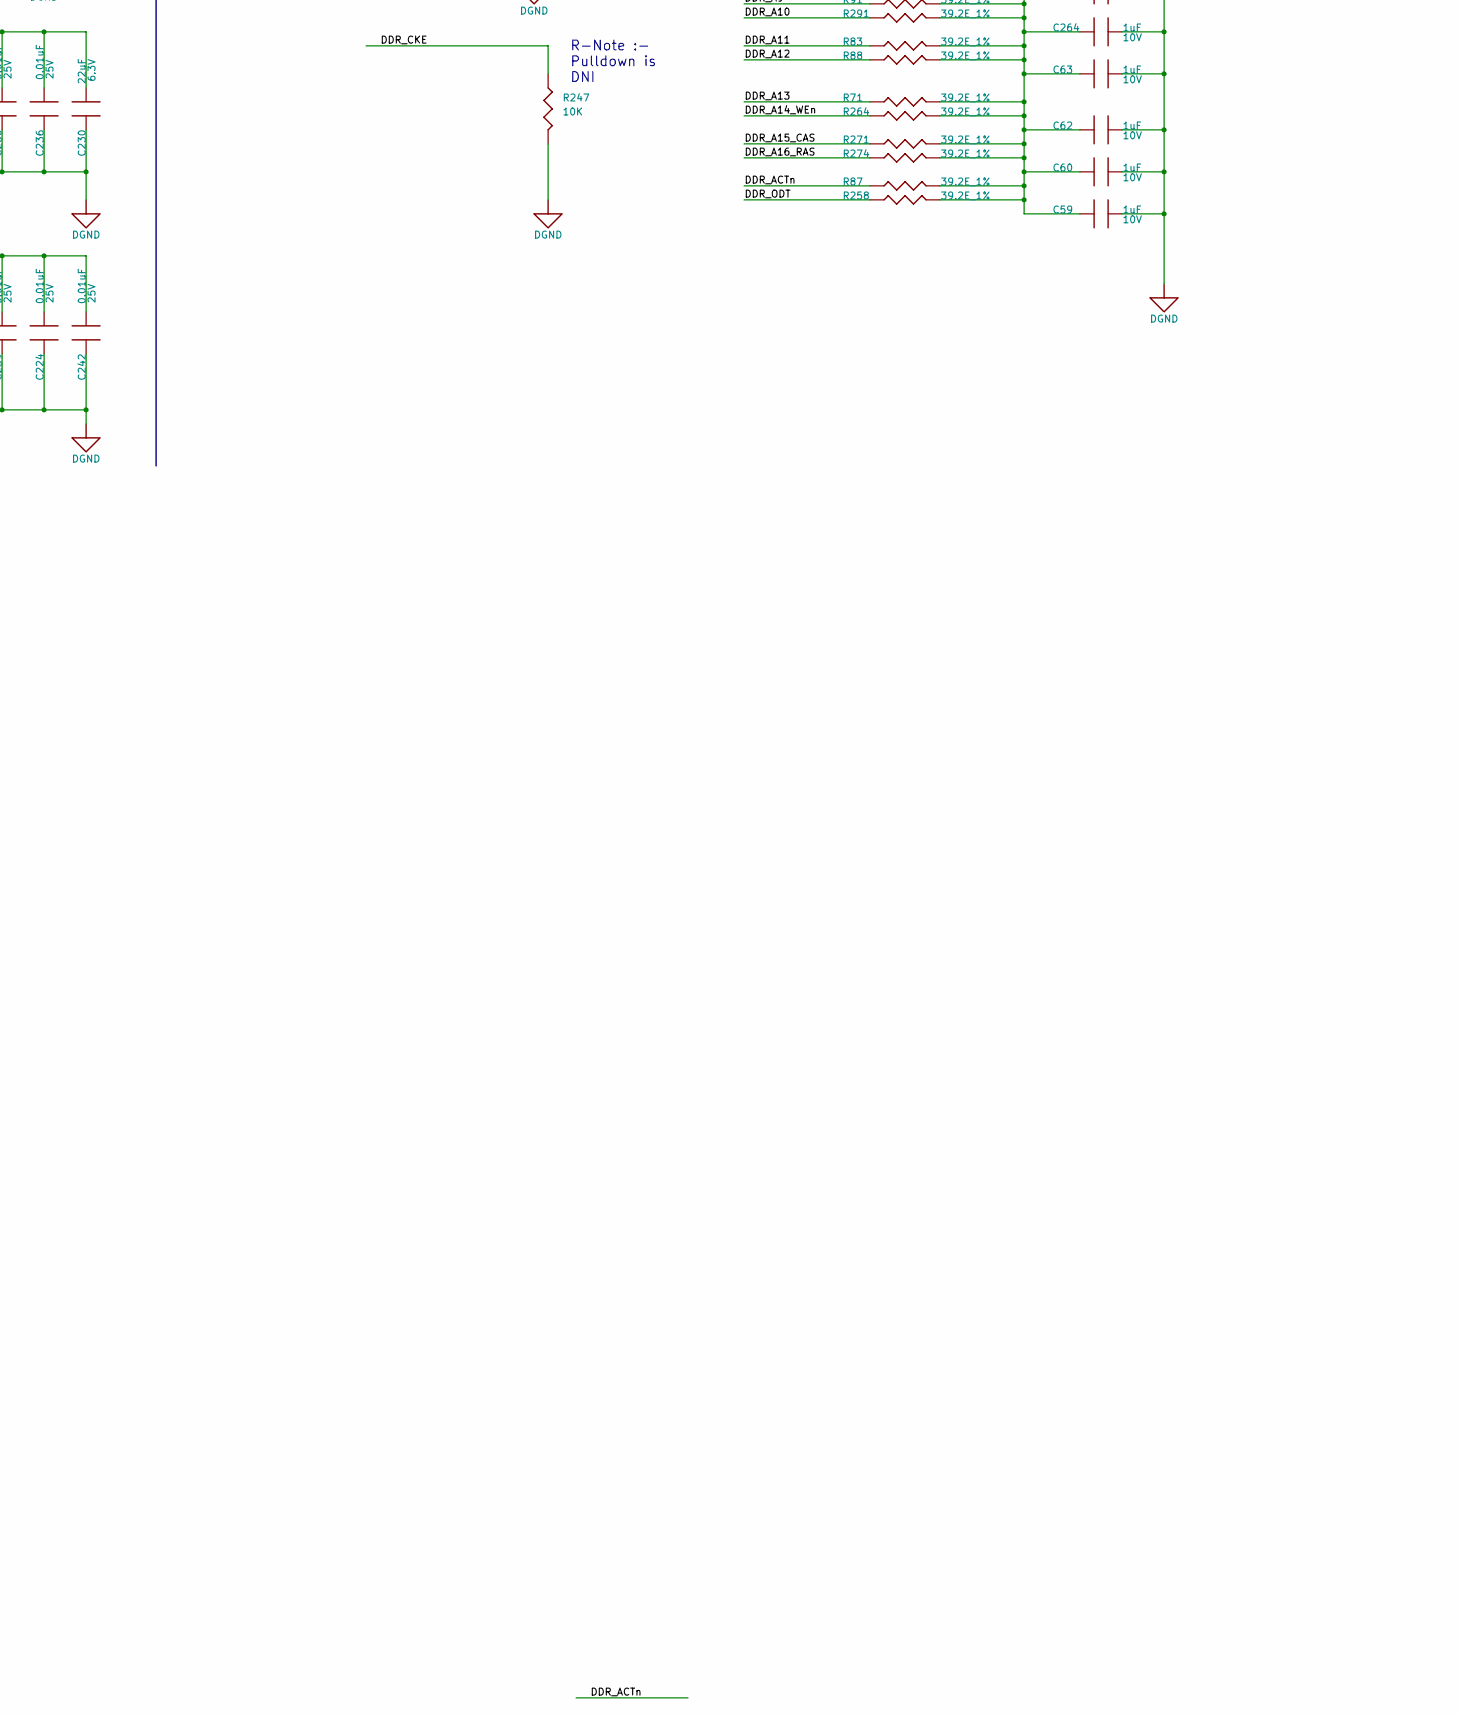
[picture p9: schematic 12.kicad_sch, part in row 2, column 2]

Parts:
C42: 0.1uF; CAP0402N; TOLERANCE 10%; VOLTAGE 16V; MISTRAL PART NO 120009030072-R
C58, C60, C61, C63, C64, C244, C246, C254, C264, C267: 1uF; CAP0402N; VOLTAGE 10V; TOLERANCE 20%; PART_TYPE CAPACITOR~{S}CERAMIC
C59, C62, C251: 1uF; CAP0402N; TOLERANCE 20%; VOLTAGE 10V; MISTRAL PART NO 120020080009-R
C222, C223, C224, C229, C232, C233, C236, C239, C241, C250, C268: 0.01uF; CAP0402N; VOLTAGE 25V; TOLERANCE 10%; PART_TYPE CAPACITOR~{S}CERAMIC
C227, C270: 0.1uF; CAP0402N; VOLTAGE 16V; TOLERANCE 10%; PART_TYPE CAPACITOR~{S}CERAMIC
C228: 2.2uF; CAP0402_0-75; TOLERANCE 20%; VOLTAGE 10V; MISTRAL PART NO 120019040036-R
C230: 22uF; CAP0402N; TOLERANCE 20%; VOLTAGE 6.3V; MISTRAL PART NO 120015090007-R
C242, C248: 0.01uF; CAP0402N; TOLERANCE 10%; VOLTAGE 25V; MISTRAL PART NO 120018010007-R
FB11: 120E; IND0603_1; TOLERANCE 25%; VOLTAGE NA; MISTRAL PART NO 130020080015-R
R38: 240E_1%; RES0402N; TOLERANCE 1%; VOLTAGE NA; MISTRAL PART NO 110011060017-R
R46, R71, R77, R83, R84, R87, R88, R89, R264, R269, R274, R275, R287, R288, R290: 39.2E_1%; RES0402_0-5; VOLTAGE NA; TOLERANCE 1%; PART_TYPE RESISTOR~{S}FIXED
R62: 1K_1%; RES0402_0-5; VOLTAGE NA; TOLERANCE 1%; PART_TYPE RESISTOR~{S}FIXED
R63: 1K_1%; RES0402_0-5; TOLERANCE 1%; VOLTAGE NA; MISTRAL PART NO 110009030411-R
R66, R67: 2.2K; RES0402_0-5; TOLERANCE 5%; VOLTAGE NA; MISTRAL PART NO 110010120018-R
R69: 10K; RES0402_0-5; VOLTAGE NA; TOLERANCE 5%; PART_TYPE RESISTOR~{S}FIXED
R85, R86, R90, R91, R256, R258, R261, R267, R271, R273, R289, R291: 39.2E_1%; RES0402_0-5; TOLERANCE 1%; VOLTAGE NA; MISTRAL PART NO 110011040030-R
R247: 10K; RES0402_0-5; TOLERANCE 5%; VOLTAGE NA; MISTRAL PART NO 110011060021-R
R320: 240E_1%; RES0402N; VOLTAGE NA; TOLERANCE 1%; PART_TYPE RESISTOR~{S}FIXED
TP15, TP58: TP20_SMD; TOLERANCE NA; VOLTAGE NA; PART_TYPE TESTPOINT
TP59: TP20_SMD; VOLTAGE NA; TOLERANCE NA; PART_TYPE TESTPOINT
TP60, TP62: TP20_SMD; TOLERANCE NA; VOLTAGE NA; MISTRAL PART NO NA
U13: MT40A1G16KD-062E IT:E; FBGA96_31-49_520X360_1-2; VOLTAGE NA; TOLERANCE NA; PART_TYPE IC~{S}DIGITA~{L}MEMORY
U23: AM6442BSFGHAALV; FCBGA441_31-49_680X680_2-6; TOLERANCE NA; VOLTAGE NA; MISTRAL PART NO 141220080002

Connections:
DDR_A0: R289.1, U13.P3 (A0), U23.D2 (DDR0_A0)
DDR_A1: R90.1, U13.P7 (A1), U23.C5 (DDR0_A1)
DDR_A2: R86.1, U13.R3 (A2), U23.E2 (DDR0_A2)
DDR_A3: R89.1, U13.N7 (A3), U23.D4 (DDR0_A3)
DDR_A4: R290.1, U13.N3 (A4), U23.D3 (DDR0_A4)
DDR_A5: R287.1, U13.P8 (A5), U23.F2 (DDR0_A5)
DDR_A6: R275.1, U13.P2 (A6), U23.J2 (DDR0_A6)
DDR_A7: R77.1, U13.R8 (A7), U23.L5 (DDR0_A7)
DDR_A8: R84.1, U13.R2 (A8), U23.J3 (DDR0_A8)
DDR_A9: R91.1, U13.R7 (A9), U23.J4 (DDR0_A9)
DDR_A10: R291.1, U13.M3 (A10/AP), U23.K3 (DDR0_A10)
DDR_A11: R83.1, U13.T2 (A11), U23.J1 (DDR0_A11)
DDR_A12: R88.1, U13.M7 (A12/BC_N), U23.M5 (DDR0_A12)
DDR_A13: R71.1, U13.T8 (A13), U23.K4 (DDR0_A13)
DDR_A14_WEn: R264.1, U13.L2 (WE_N/A14), U23.H4 (DDR0_WE_N)
DDR_A15_CAS: R271.1, U13.M8 (CAS_N/A15), U23.J5 (DDR0_CAS_N)
DDR_A16_RAS: R274.1, U13.L8 (RAS_N/A16), U23.F6 (DDR0_RAS_N)
DDR_ACTn: R87.1, U13.L3 (ACT_N), U23.H2 (DDR0_ACT_N)
DDR_ALERTn: R69.1, U13.P9 (ALERT_N), U23.H1 (DDR0_ALERT_N)
DDR_BA0: R273.1, U13.N2 (BA0), U23.G4 (DDR0_BA0)
DDR_BA1: R288.1, U13.N8 (BA1), U23.G5 (DDR0_BA1)
DDR_BG0: R269.1, U13.M2 (BG0), U23.G2 (DDR0_BG0)
DDR_CKE: R46.1, R247.1, U13.K2 (CKE), U23.F4 (DDR0_CKE0)
DDR_CLKN: R267.1, U13.K8 (CK_C), U23.E1 (DDR0_CK0_N)
DDR_CLKP: R261.1, U13.K7 (CK_T), U23.F1 (DDR0_CK0)
DDR_CSn: R256.1, U13.L7 (CS_N), U23.E3 (DDR0_CS0_N)
DDR_DQ0: U13.G2 (DQ0), U23.A3 (DDR0_DQ0)
DDR_DQ1: U13.F7 (DQ1), U23.A4 (DDR0_DQ3)
DDR_DQ2: U13.H3 (DQ2), U23.B4 (DDR0_DQ7)
DDR_DQ3: U13.H7 (DQ3), U23.B3 (DDR0_DQ4)
DDR_DQ4: U13.H2 (DQ4), U23.B5 (DDR0_DQ2)
DDR_DQ5: U13.H8 (DQ5), U23.A2 (DDR0_DQ1)
DDR_DQ6: U13.J3 (DQ6), U23.C4 (DDR0_DQ5)
DDR_DQ7: U13.J7 (DQ7), U23.C2 (DDR0_DQ6)
DDR_DQ8: U13.A3 (DQ8), U23.N5 (DDR0_DQ8)
DDR_DQ9: U13.B8 (DQ9), U23.N4 (DDR0_DQ12)
DDR_DQ10: U13.C3 (DQ10), U23.M3 (DDR0_DQ11)
DDR_DQ11: U13.C7 (DQ11), U23.M4 (DDR0_DQ14)
DDR_DQ12: U13.C2 (DQ12), U23.N3 (DDR0_DQ13)
DDR_DQ13: U13.C8 (DQ13), U23.N2 (DDR0_DQ15)
DDR_DQ14: U13.D3 (DQ14), U23.L2 (DDR0_DQ10)
DDR_DQ15: U13.D7 (DQ15), U23.L4 (DDR0_DQ9)
DDR_LDM: U13.E7 (NF/LDM_N/LDBI_N), U23.B2 (DDR0_DM0)
DDR_LDQS_N: U13.F3 (LDQS_C), U23.B1 (DDR0_DQS0_N)
DDR_LDQS_P: U13.G3 (LDQS_T), U23.C1 (DDR0_DQS0)
DDR_ODT: R258.1, U13.K3 (ODT), U23.E5 (DDR0_ODT0)
DDR_PARITY: R85.1, U13.T3 (PAR), U23.K5 (DDR0_PAR)
DDR_RESET#: R66.2, R67.1, U13.P1 (RESET_N), U23.D5 (DDR0_RESET0_N)
DDR_TEN: R62.2, R63.1, U13.N9 (TEN)
DDR_UDM: U13.E2 (NF/UDM_N/UDBI_N), U23.M2 (DDR0_DM1)
DDR_UDQS_N: U13.A7 (UDQS_C), U23.M1 (DDR0_DQS1_N)
DDR_UDQS_P: U13.B7 (UDQS_T), U23.N1 (DDR0_DQS1)
DDR_VPP: C227.2, C228.1, C270.2, FB11.2, U13.B1 (VPP), U13.R9 (VPP)
DDR_VREFCA: C42.2, U13.M1 (VREFCA)
DGND: C42.1, C58.2, C59.2, C60.2, C61.2, C62.2, C63.2, C64.2, C222.2, C223.2, C224.2, C227.1, C228.2, C229.2, C230.2, C232.2, C233.2, C236.2, C239.2, C241.2, C242.2, C244.2, C246.2, C250.2, C251.2, C254.2, C264.2, C267.2, C268.2, C270.1, R38.2, R62.1, R66.1, R247.2, R320.2, U13.A2 (VSSQ), U13.A8 (VSSQ), U13.B2 (VSS), U13.C9 (VSSQ), U13.D2 (VSSQ), U13.D8 (VSSQ), U13.E1 (VSS), U13.E3 (VSSQ), U13.E8 (VSSQ), U13.E9 (VSS), U13.F1 (VSSQ), U13.G8 (VSS), U13.H1 (VSSQ), U13.H9 (VSSQ), U13.K1 (VSS), U13.K9 (VSS), U13.M9 (VSS), U13.N1 (VSS), U13.T1 (VSS)
unnamed: C248.1, R261.2, R267.2
unnamed: R38.1, U13.F9 (ZQ)
unnamed: R320.1, U23.H5 (DDR0_CAL0)
unnamed: TP15.1, U13.T7 (NF/NC)
unnamed: TP58.1, U23.F3 (DDR0_CKE1)
unnamed: TP59.1, U23.H3 (DDR0_BG1)
unnamed: TP60.1, U23.E4 (DDR0_CS1_N)
unnamed: TP62.1, U23.F5 (DDR0_ODT1)
VDDR_VTT: C58.1, C59.1, C60.1, C61.1, C62.1, C63.1, C64.1, C244.1, C246.1, C251.1, C254.1, C264.1, C267.1, R46.2, R71.2, R77.2, R83.2, R84.2, R85.2, R86.2, R87.2, R88.2, R89.2, R90.2, R91.2, R256.2, R258.2, R264.2, R269.2, R271.2, R273.2, R274.2, R275.2, R287.2, R288.2, R289.2, R290.2, R291.2
VDD_DDR4: C222.1, C223.1, C224.1, C229.1, C230.1, C232.1, C233.1, C236.1, C239.1, C241.1, C242.1, C248.2, C250.1, C268.1, R63.2, R67.2, R69.2, U13.A1 (VDDQ), U13.A9 (VDDQ), U13.B3 (VDD), U13.B9 (VDD), U13.C1 (VDDQ), U13.D1 (VDD), U13.D9 (VDDQ), U13.F2 (VDDQ), U13.F8 (VDDQ), U13.G1 (VDDQ), U13.G7 (VDD), U13.G9 (VDDQ), U13.J1 (VDD), U13.J2 (VDDQ), U13.J8 (VDDQ), U13.J9 (VDD), U13.L1 (VDD), U13.L9 (VDD), U13.R1 (VDD), U13.T9 (VDD)
VPP_DDR_2V5: FB11.1

Notes on the sheet:
R-Note :- Verify need to connect DDR0_BG1 for memory expansion
Cad Note :- Place the decap near to DDR_VREFCA
R-Note :- Pulldown is DNI
R-Note :- Pulldown is populated
R-Note :- Verify need to connect these NC pins for memory expansion
DDR DQ Lines Swapped With Data Byte
R-Note :- Pulldown is populated
D-Note:- VTT terminations for address and control signals is optional when a single DDR4 memory is used (Point-Point) connection Refer SK-AM62B-P1 schematics for implementation
DDR4 DEVICE
DDR TERMINATION
SoC DDR INTERFACE
D-Note :-
