gingerologist/am64x/13.kicad_sch

## KiCad design 13.kicad_sch (2024-08-05)

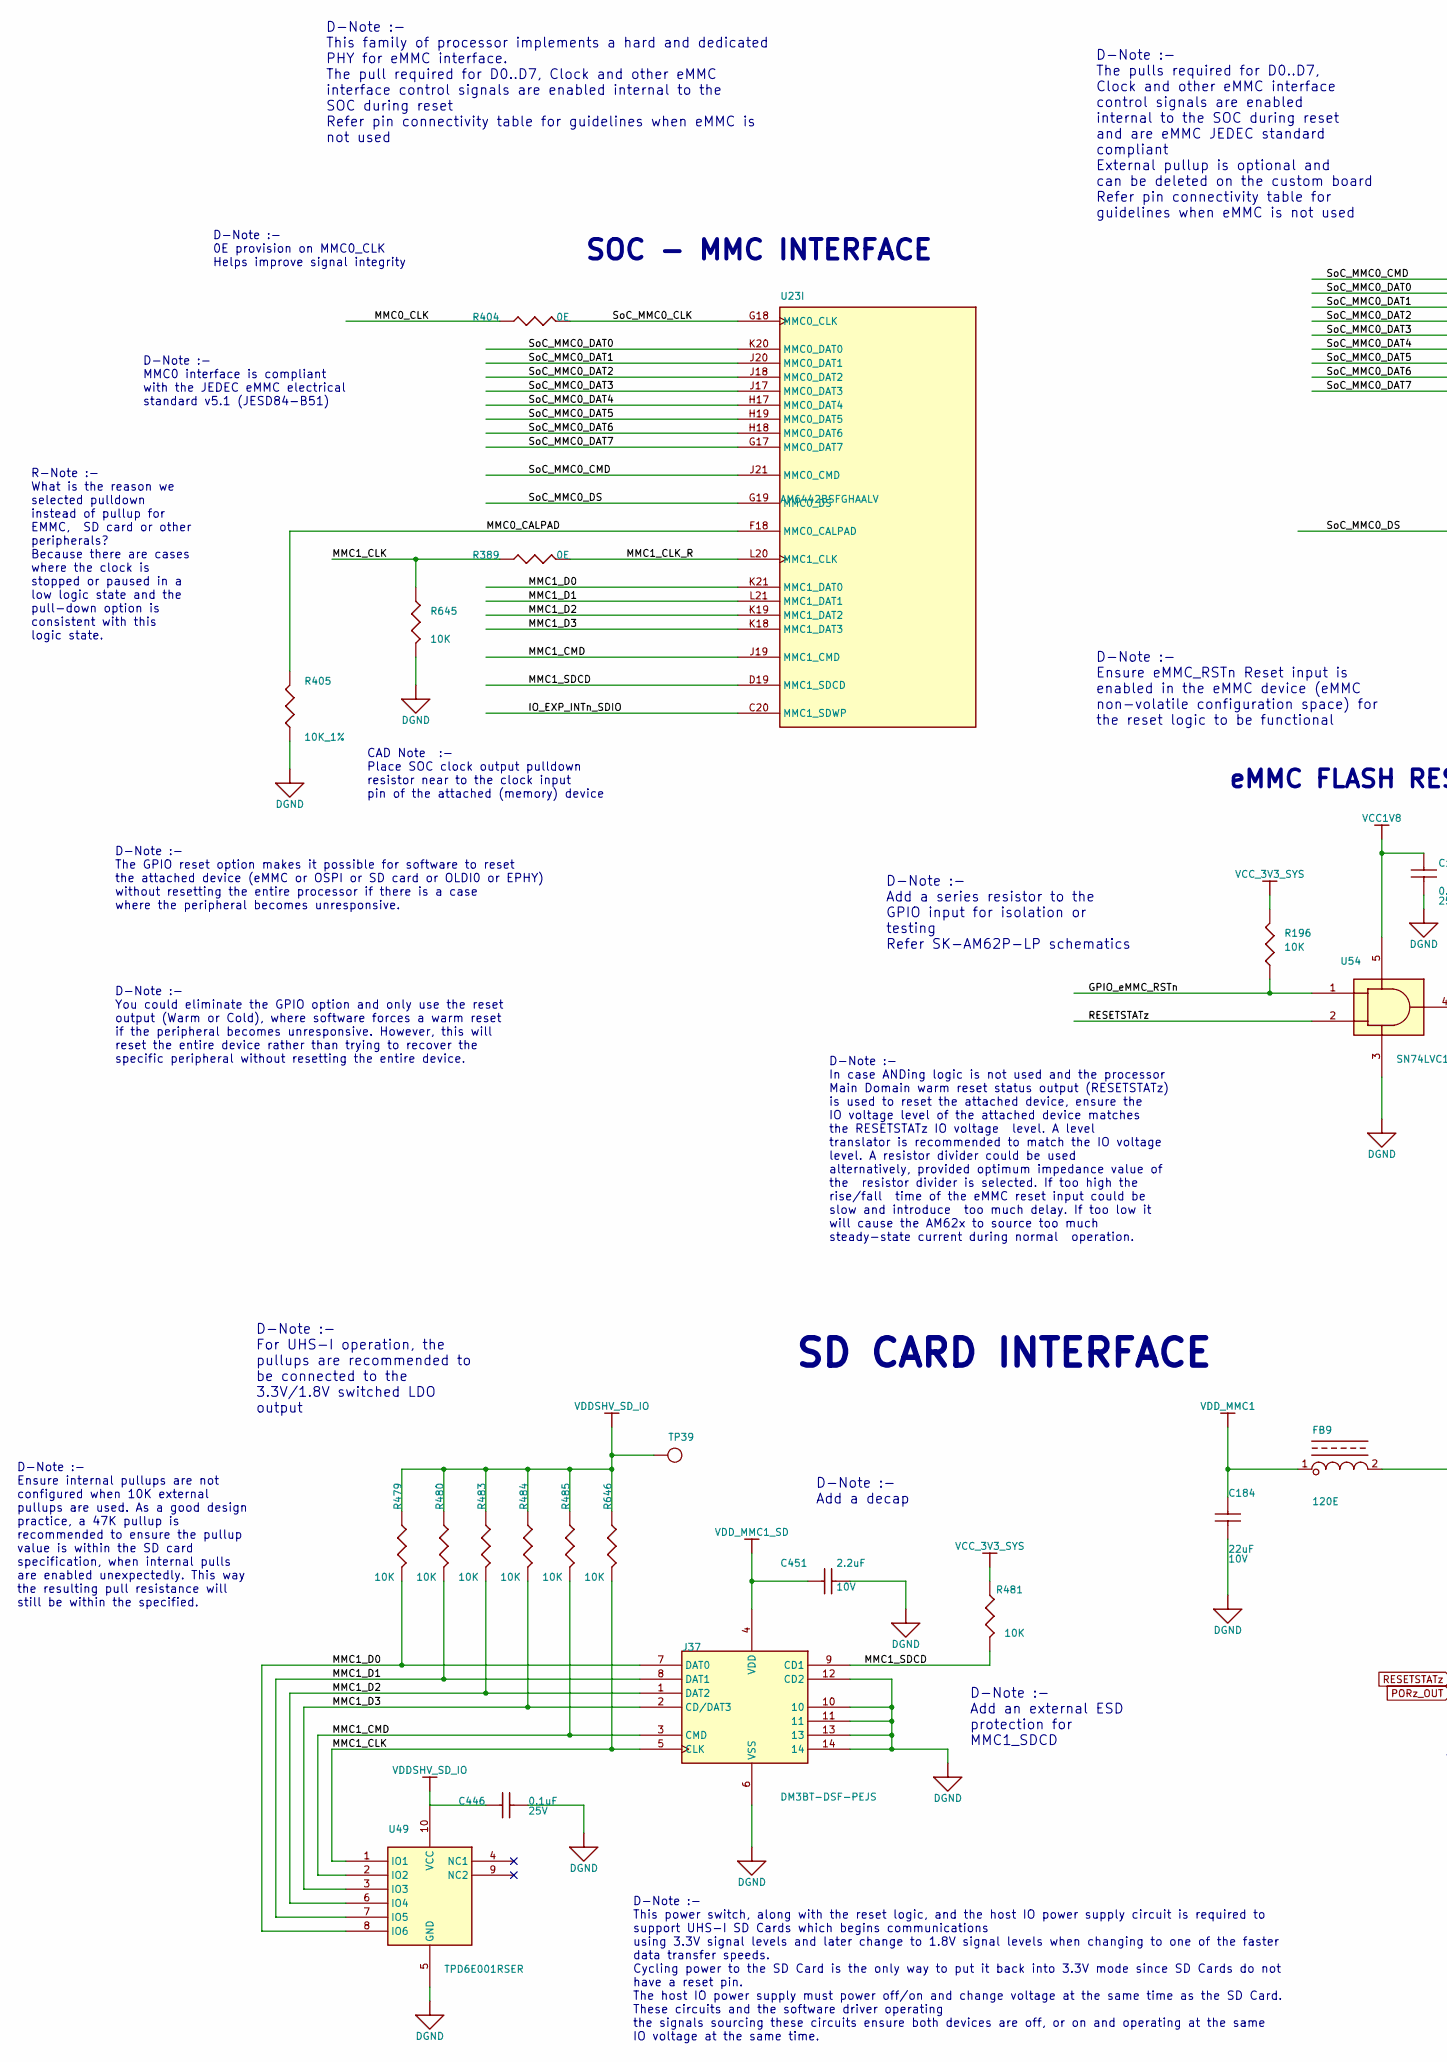
[picture p10: schematic 13.kicad_sch, part in row 1, column 1]

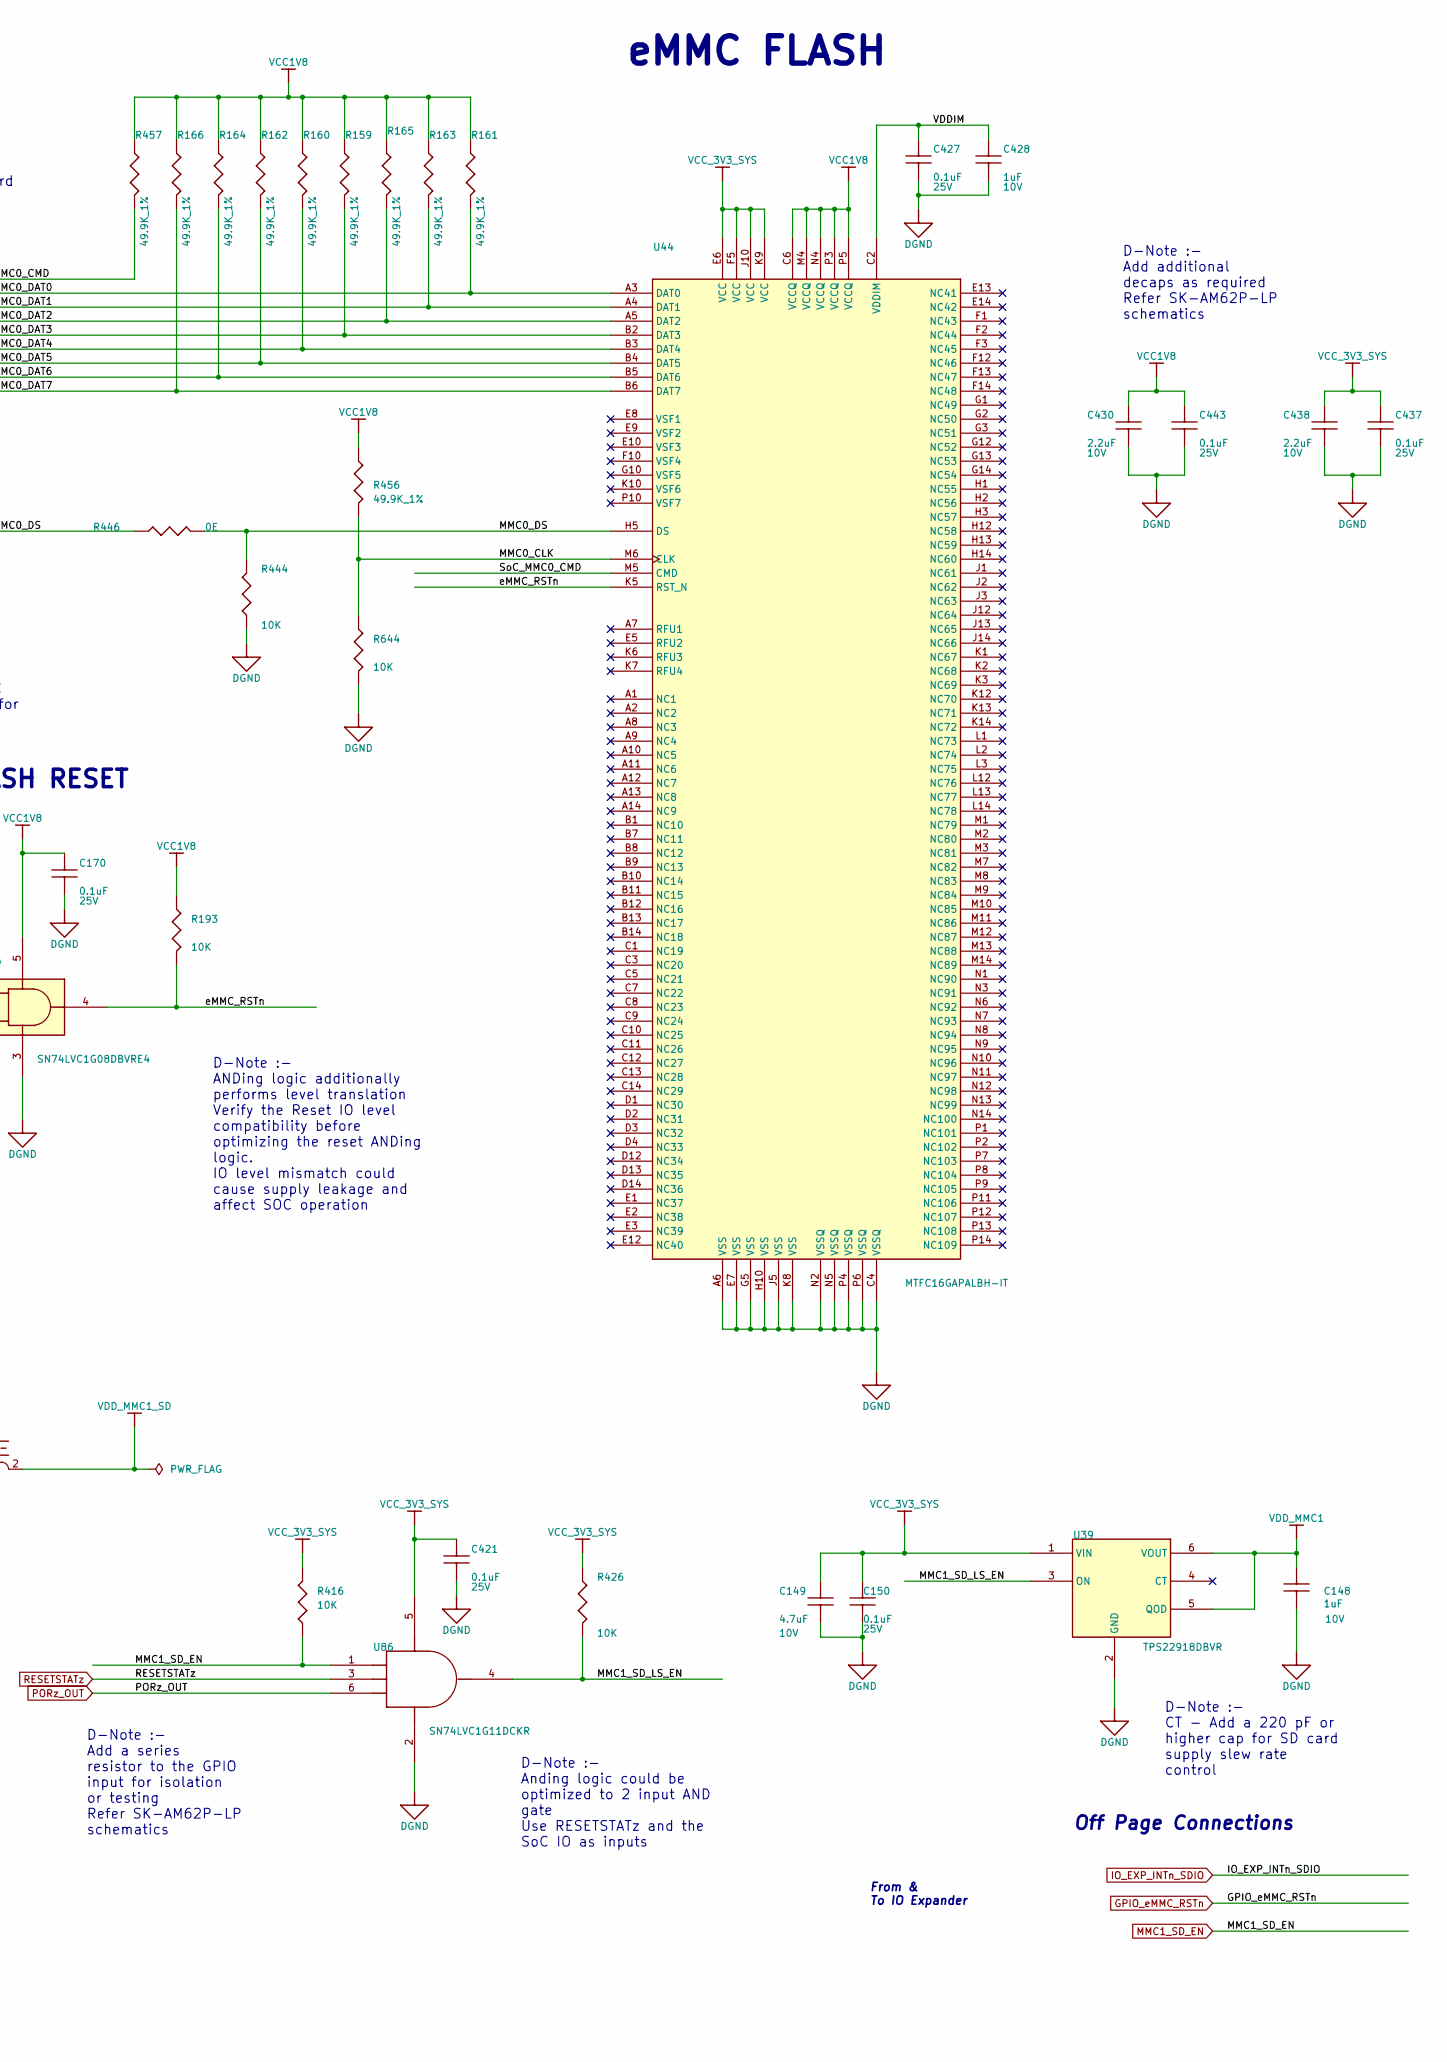
[picture p11: schematic 13.kicad_sch, part in row 1, column 2]

Parts:
C148, C428: 1uF; CAP0402_0-75; VOLTAGE 10V; TOLERANCE 20%; PART_TYPE CAPACITOR~{S}CERAMIC
C149: 4.7uF; CAP0402_0-75; TOLERANCE 20%; VOLTAGE 10V; MISTRAL PART NO 120012060002-R
C150, C170, C421, C427, C437, C443, C446: 0.1uF; CAP0402_0-75; TOLERANCE 20%; VOLTAGE 25V; MISTRAL PART NO 120020080003-R
C184: 22uF; CAP0805_1-5; TOLERANCE 20%; VOLTAGE 10V; MISTRAL PART NO 120020080010-R
C430, C438, C451: 2.2uF; CAP0402_0-75; TOLERANCE 20%; VOLTAGE 10V; MISTRAL PART NO 120019040036-R
FB9: 120E; IND0603_1; VOLTAGE NA; TOLERANCE 25%; PART_TYPE INDUCTOR
J37: CON_SDCARD10_DM3BT-DSF-PEJS; CON_SD10_DM3BT-DSF-PEJS_S_R_S_2-4; TOLERANCE NA; VOLTAGE NA; MISTRAL PART NO 150011010020-R
R159, R160, R161, R162, R163, R164, R166, R456, R457: 49.9K_1%; RES0402_0-5; VOLTAGE NA; TOLERANCE 1%; PART_TYPE RESISTOR~{S}FIXED
R165: 49.9K_1%; RES0402_0-5; TOLERANCE 1%; VOLTAGE NA; MISTRAL PART NO 110009030902-R
R193, R196, R426, R444, R479, R480, R481, R483, R484, R485, R644, R645: 10K; RES0402_0-5; TOLERANCE 5%; VOLTAGE NA; MISTRAL PART NO 110011060021-R
R389, R404: 0E; RES0402_0-5; VOLTAGE NA; TOLERANCE NA; PART_TYPE RESISTOR~{S}FIXED
R405: 10K_1%; RES0402_0-5; TOLERANCE 1%; VOLTAGE NA; MISTRAL PART NO 110015090015-R
R416, R646: 10K; RES0402_0-5; VOLTAGE NA; TOLERANCE 5%; PART_TYPE RESISTOR~{S}FIXED
R446: 0E; RES0402_0-5; TOLERANCE NA; VOLTAGE NA; MISTRAL PART NO 110010080019-R
TP39: TP20_SMD; TOLERANCE NA; VOLTAGE NA; MISTRAL PART NO NA
U23: AM6442BSFGHAALV; FCBGA441_31-49_680X680_2-6; VOLTAGE NA; TOLERANCE NA; PART_TYPE IC~{S}DIGITA~{L}MICROPROCESSOR
U39: TPS22918DBVR; SOT23-6; TOLERANCE NA; VOLTAGE NA; MISTRAL PART NO 142016050007-R
U44: MTFC16GAPALBH-IT; VFBGA153_19-68_460X520_1-1; TOLERANCE NA; VOLTAGE NA; MISTRAL PART NO 141120020001-R
U49: TPD6E001RSER; UQFN10_19-68_80X60_0-6; VOLTAGE NA; TOLERANCE NA; PART_TYPE IC~{S}INTERFACE
U54: SN74LVC1G08DBVRE4; SOT23-5; MISTRAL PART NO 141009060026-R
U86: SN74LVC1G11DCKR; SC70-6; MISTRAL PART NO 141009030230-R

Connections:
DGND: C148.2, C149.2, C150.2, C170.2, C184.2, C421.2, C427.2, C428.2, C430.2, C437.2, C438.2, C443.2, C446.2, C451.2, J37.6 (VSS), J37.10, J37.11, J37.12 (CD2), J37.13, J37.14, R405.2, R444.1, R644.2, R645.2, U39.2 (GND), U44.A6 (VSS), U44.C4 (VSSQ), U44.E7 (VSS), U44.G5 (VSS), U44.H10 (VSS), U44.J5 (VSS), U44.K8 (VSS), U44.N2 (VSSQ), U44.N5 (VSSQ), U44.P4 (VSSQ), U44.P6 (VSSQ), U49.5 (GND), U54.3 (GND), U86.2 (GND)
GPIO_eMMC_RSTn: R196.1, U54.1 (A)
IO_EXP_INTn_SDIO: U23.C20 (MMC1_SDWP)
MMC0_CALPAD: R405.1, U23.F18 (MMC0_CALPAD)
MMC0_CLK: R404.1, R456.2, R644.1, U44.M6 (CLK)
MMC0_DS: R444.2, R446.2, U44.H5 (DS)
MMC1_CLK: J37.5 (CLK), R389.1, R645.1, R646.2, U49.1 (IO1)
MMC1_CLK_R: R389.2, U23.L20 (MMC1_CLK)
MMC1_CMD: J37.3 (CMD), R485.2, U23.J19 (MMC1_CMD), U49.2 (IO2)
MMC1_D0: J37.7 (DAT0), R479.2, U23.K21 (MMC1_DAT0), U49.8 (IO6)
MMC1_D1: J37.8 (DAT1), R480.2, U23.L21 (MMC1_DAT1), U49.7 (IO5)
MMC1_D2: J37.1 (DAT2), R483.2, U23.K19 (MMC1_DAT2), U49.6 (IO4)
MMC1_D3: J37.2 (CD/DAT3), R484.2, U23.K18 (MMC1_DAT3), U49.3 (IO3)
MMC1_SDCD: J37.9 (CD1), R481.2, U23.D19 (MMC1_SDCD)
MMC1_SD_EN: R416.1, U86.1 (A)
MMC1_SD_LS_EN: R426.2, U39.3 (ON), U86.4 (Y)
PORz_OUT: U86.6 (C)
RESETSTATz: U54.2 (B), U86.3 (B)
SoC_MMC0_CLK: R404.2, U23.G18 (MMC0_CLK)
SoC_MMC0_CMD: R457.2, U23.J21 (MMC0_CMD), U44.M5 (CMD)
SoC_MMC0_DAT0: R161.2, U23.K20 (MMC0_DAT0), U44.A3 (DAT0)
SoC_MMC0_DAT1: R163.2, U23.J20 (MMC0_DAT1), U44.A4 (DAT1)
SoC_MMC0_DAT2: R165.2, U23.J18 (MMC0_DAT2), U44.A5 (DAT2)
SoC_MMC0_DAT3: R159.2, U23.J17 (MMC0_DAT3), U44.B2 (DAT3)
SoC_MMC0_DAT4: R160.2, U23.H17 (MMC0_DAT4), U44.B3 (DAT4)
SoC_MMC0_DAT5: R162.2, U23.H19 (MMC0_DAT5), U44.B4 (DAT5)
SoC_MMC0_DAT6: R164.2, U23.H18 (MMC0_DAT6), U44.B5 (DAT6)
SoC_MMC0_DAT7: R166.2, U23.G17 (MMC0_DAT7), U44.B6 (DAT7)
SoC_MMC0_DS: R446.1, U23.G19 (MMC0_DS)
VCC1V8: C170.1, C430.1, C443.1, R159.1, R160.1, R161.1, R162.1, R163.1, R164.1, R165.1, R166.1, R193.1, R456.1, R457.1, U44.C6 (VCCQ), U44.M4 (VCCQ), U44.N4 (VCCQ), U44.P3 (VCCQ), U44.P5 (VCCQ), U54.5 (VCC)
VCC_3V3_SYS: C149.1, C150.1, C421.1, C437.1, C438.1, R196.2, R416.2, R426.1, R481.1, U39.1 (VIN), U44.E6 (VCC), U44.F5 (VCC), U44.J10 (VCC), U44.K9 (VCC), U86.5 (VCC)
VDDIM: C427.1, C428.1, U44.C2 (VDDIM)
VDDSHV_SD_IO: C446.1, R479.1, R480.1, R483.1, R484.1, R485.1, R646.1, TP39.1, U49.10 (VCC)
VDD_MMC1: C148.1, C184.1, FB9.1, U39.5 (QOD), U39.6 (VOUT)
VDD_MMC1_SD: C451.1, FB9.2, J37.4 (VDD)
eMMC_RSTn: R193.2, U44.K5 (RST_N), U54.4 (Y)

Notes on the sheet:
D-Note :- Ensure eMMC_RSTn Reset input is enabled in the eMMC device (eMMC non-volatile configuration space) for the reset logic to be functional
D-Note :- In case ANDing logic is not used and the processor Main Domain warm reset status output (RESETSTATz) is used to reset the attached device, ensure the IO voltage level of the attached device matches the RESETSTATz IO voltage level. A level translator is recommended to match the IO voltage 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
D-Note :- Ensure internal pullups are not configured when 10K external pullups are used. As a good design practice, a 47K pullup is recommended to ensure the pullup value is within the SD card specification, when internal pulls are enabled unexpectedly. This way the resulting pull resistance will s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
D-Note :- For UHS-I operation, the pullups are recommended to be connected to the 3.3V/1.8V switched LDO output
D-Note :- 0E provision on MMC0_CLK Helps improve signal integrity
D-Note :- You could eliminate the GPIO option and only use the reset output (Warm or Cold), where software forces a warm reset if the peripheral becomes unresponsive. However, this will reset the entire device rather than trying to recover the specific peripheral without resetting the entire device.
R-Note :- What is the reason we selected pulldown instead of pullup for EMMC, SD card or other peripherals? Because there are cases where the clock is stopped or paused in a low logic state and the pull-down option is consistent with this logic state.
D-Note :- MMC0 interface is compliant with the JEDEC eMMC electrical standard v5.1 (JESD84-B51)
D-Note :- Add an external ESD protection for MMC1_SDCD
D-Note :- The pulls required for D0..D7, Clock and other eMMC interface control signals are enabled internal to the SOC during reset and are eMMC JEDEC standard compliant External pullup is optional and can be deleted on the custom board Refer pin connectivity table for guidelines when eMMC is not 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
D-Note :- ANDing logic additionally performs level translation Verify the Reset IO level compatibility before optimizing the reset ANDing logic. IO level mismatch could cause supply leakage and affect SOC operation
From & To IO Expander
D-Note :- This family of processor implements a hard and dedicated PHY for eMMC interface. The pull required for D0..D7, Clock and other eMMC interface control signals are enabled internal to the SOC during reset Refer pin connectivity table for guidelines when eMMC is not used
D-Note :- Anding logic could be optimized to 2 input AND gate Use RESETSTATz and the SoC IO as inputs
D-Note :- Add a decap
D-Note :- This power switch, along with the reset logic, and the host IO power supply circuit is required to support UHS-I SD Cards which begins communications using 3.3V signal levels and later change to 1.8V signal levels when changing to one of the faster data transfer speeds. Cycling power to t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
D-Note :- CT - Add a 220 pF or higher cap for SD card supply slew rate control
D-Note :- Add additional decaps as required Refer SK-AM62P-LP schematics
D-Note :- Add a series resistor to the GPIO input for isolation or testing Refer SK-AM62P-LP schematics
CAD Note :- Place SOC clock output pulldown resistor near to the clock input pin of the attached (memory) device
D-Note :- Add a series resistor to the GPIO input for isolation or testing Refer SK-AM62P-LP schematics
D-Note :- The GPIO reset option makes it possible for software to reset the attached device (eMMC or OSPI or SD card or OLDI0 or EPHY) without resetting the entire processor if there is a case where the peripheral becomes unresponsive.
SOC - MMC INTERFACE
eMMC FLASH
Off Page Connections
SD CARD INTERFACE
eMMC FLASH RESET
