gingerologist/am64x/14.kicad_sch

## KiCad design 14.kicad_sch (2024-08-05)

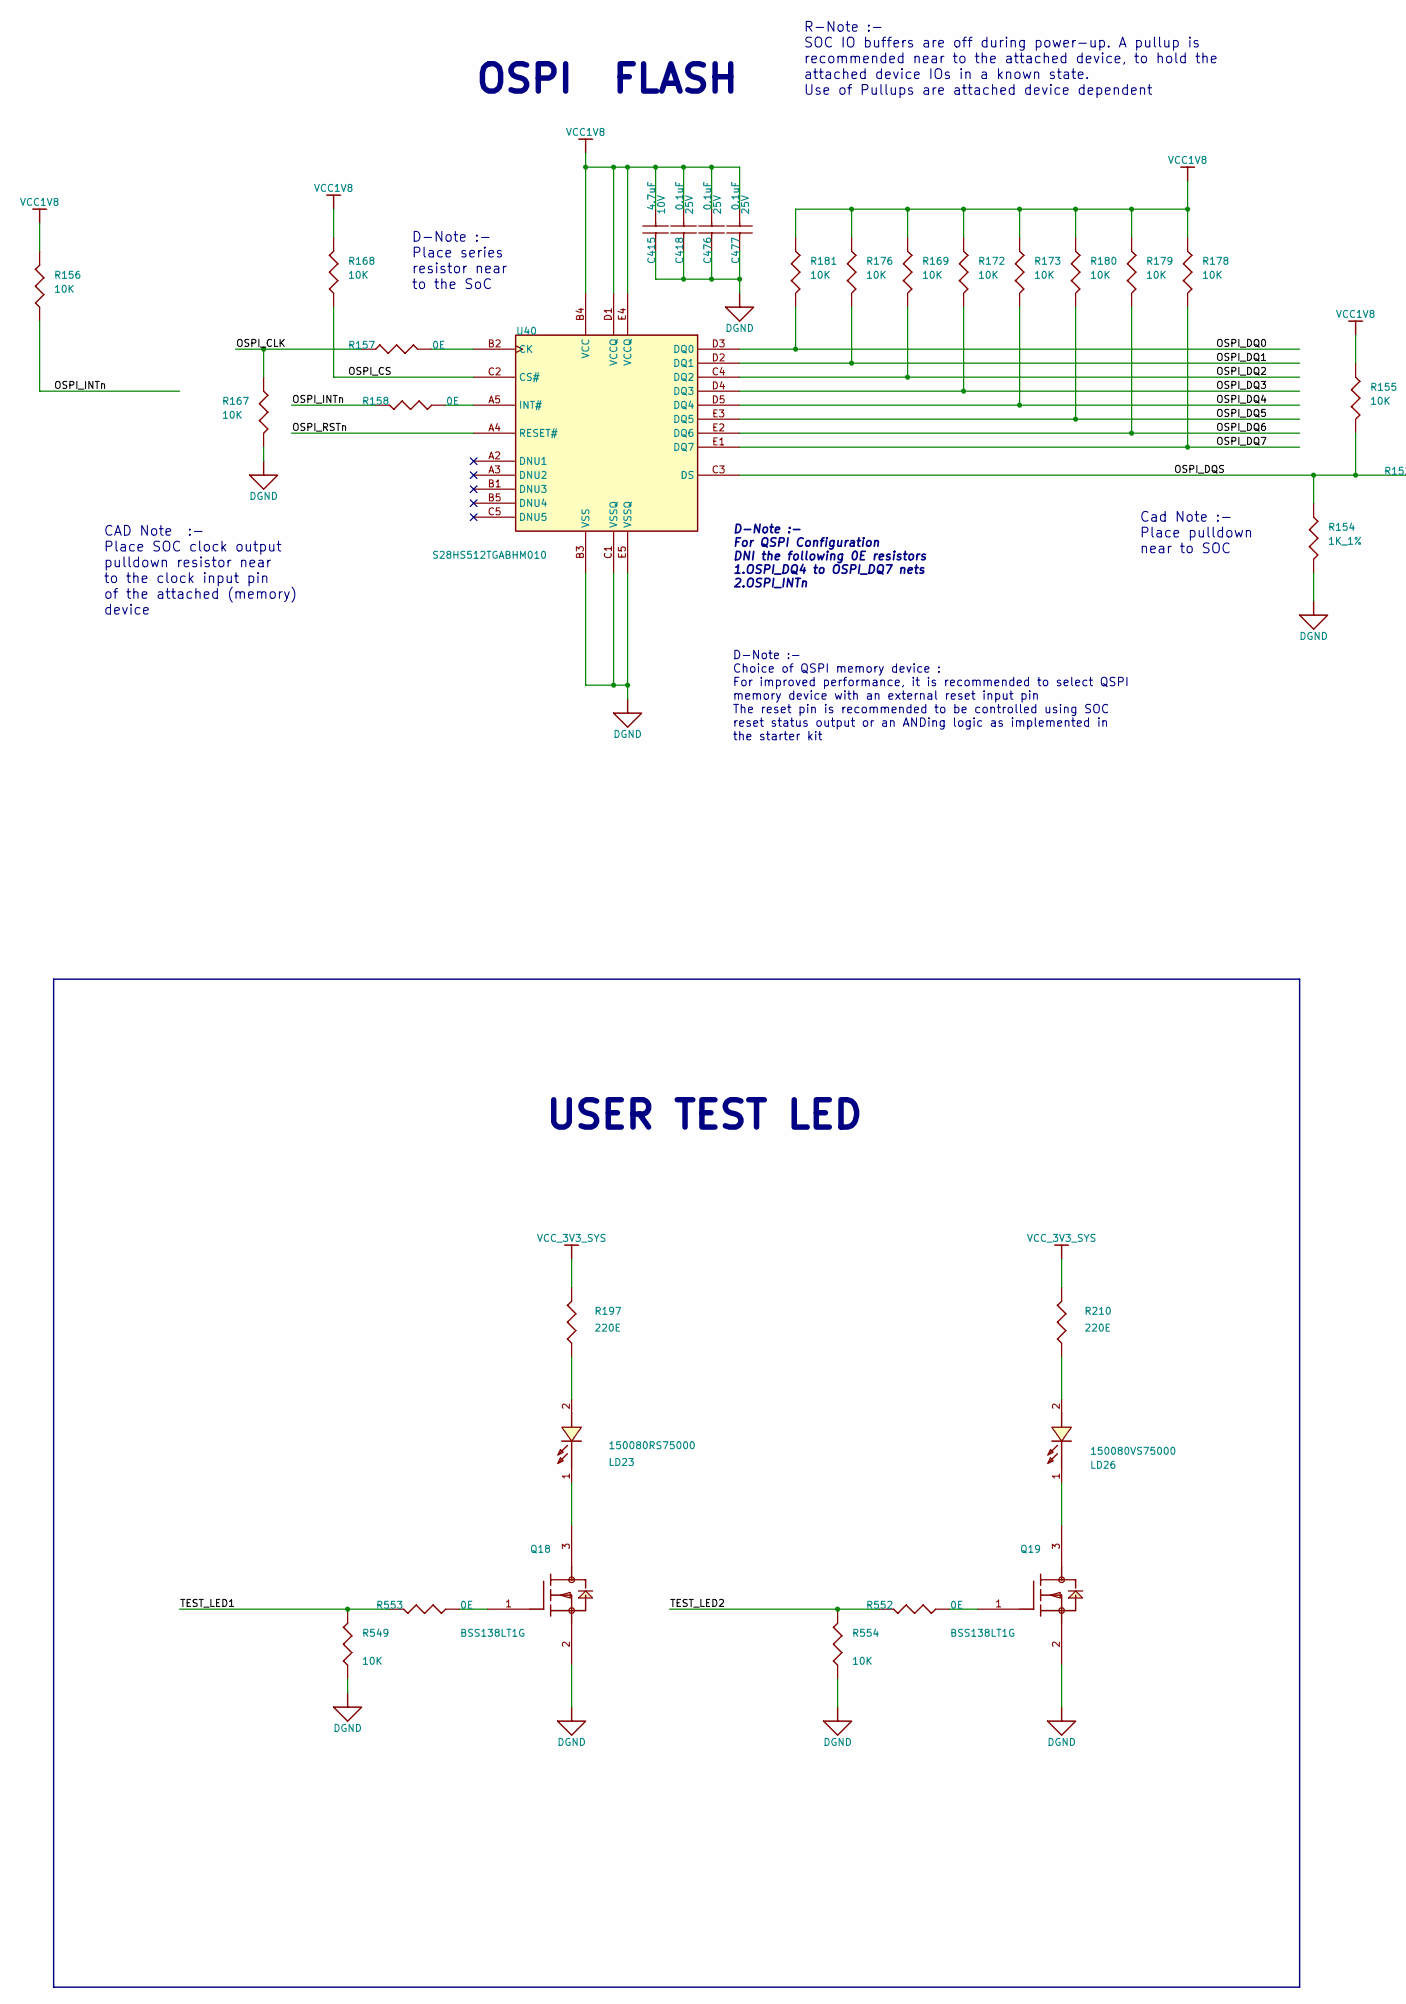
[picture p12: schematic 14.kicad_sch, part in row 1, column 1]

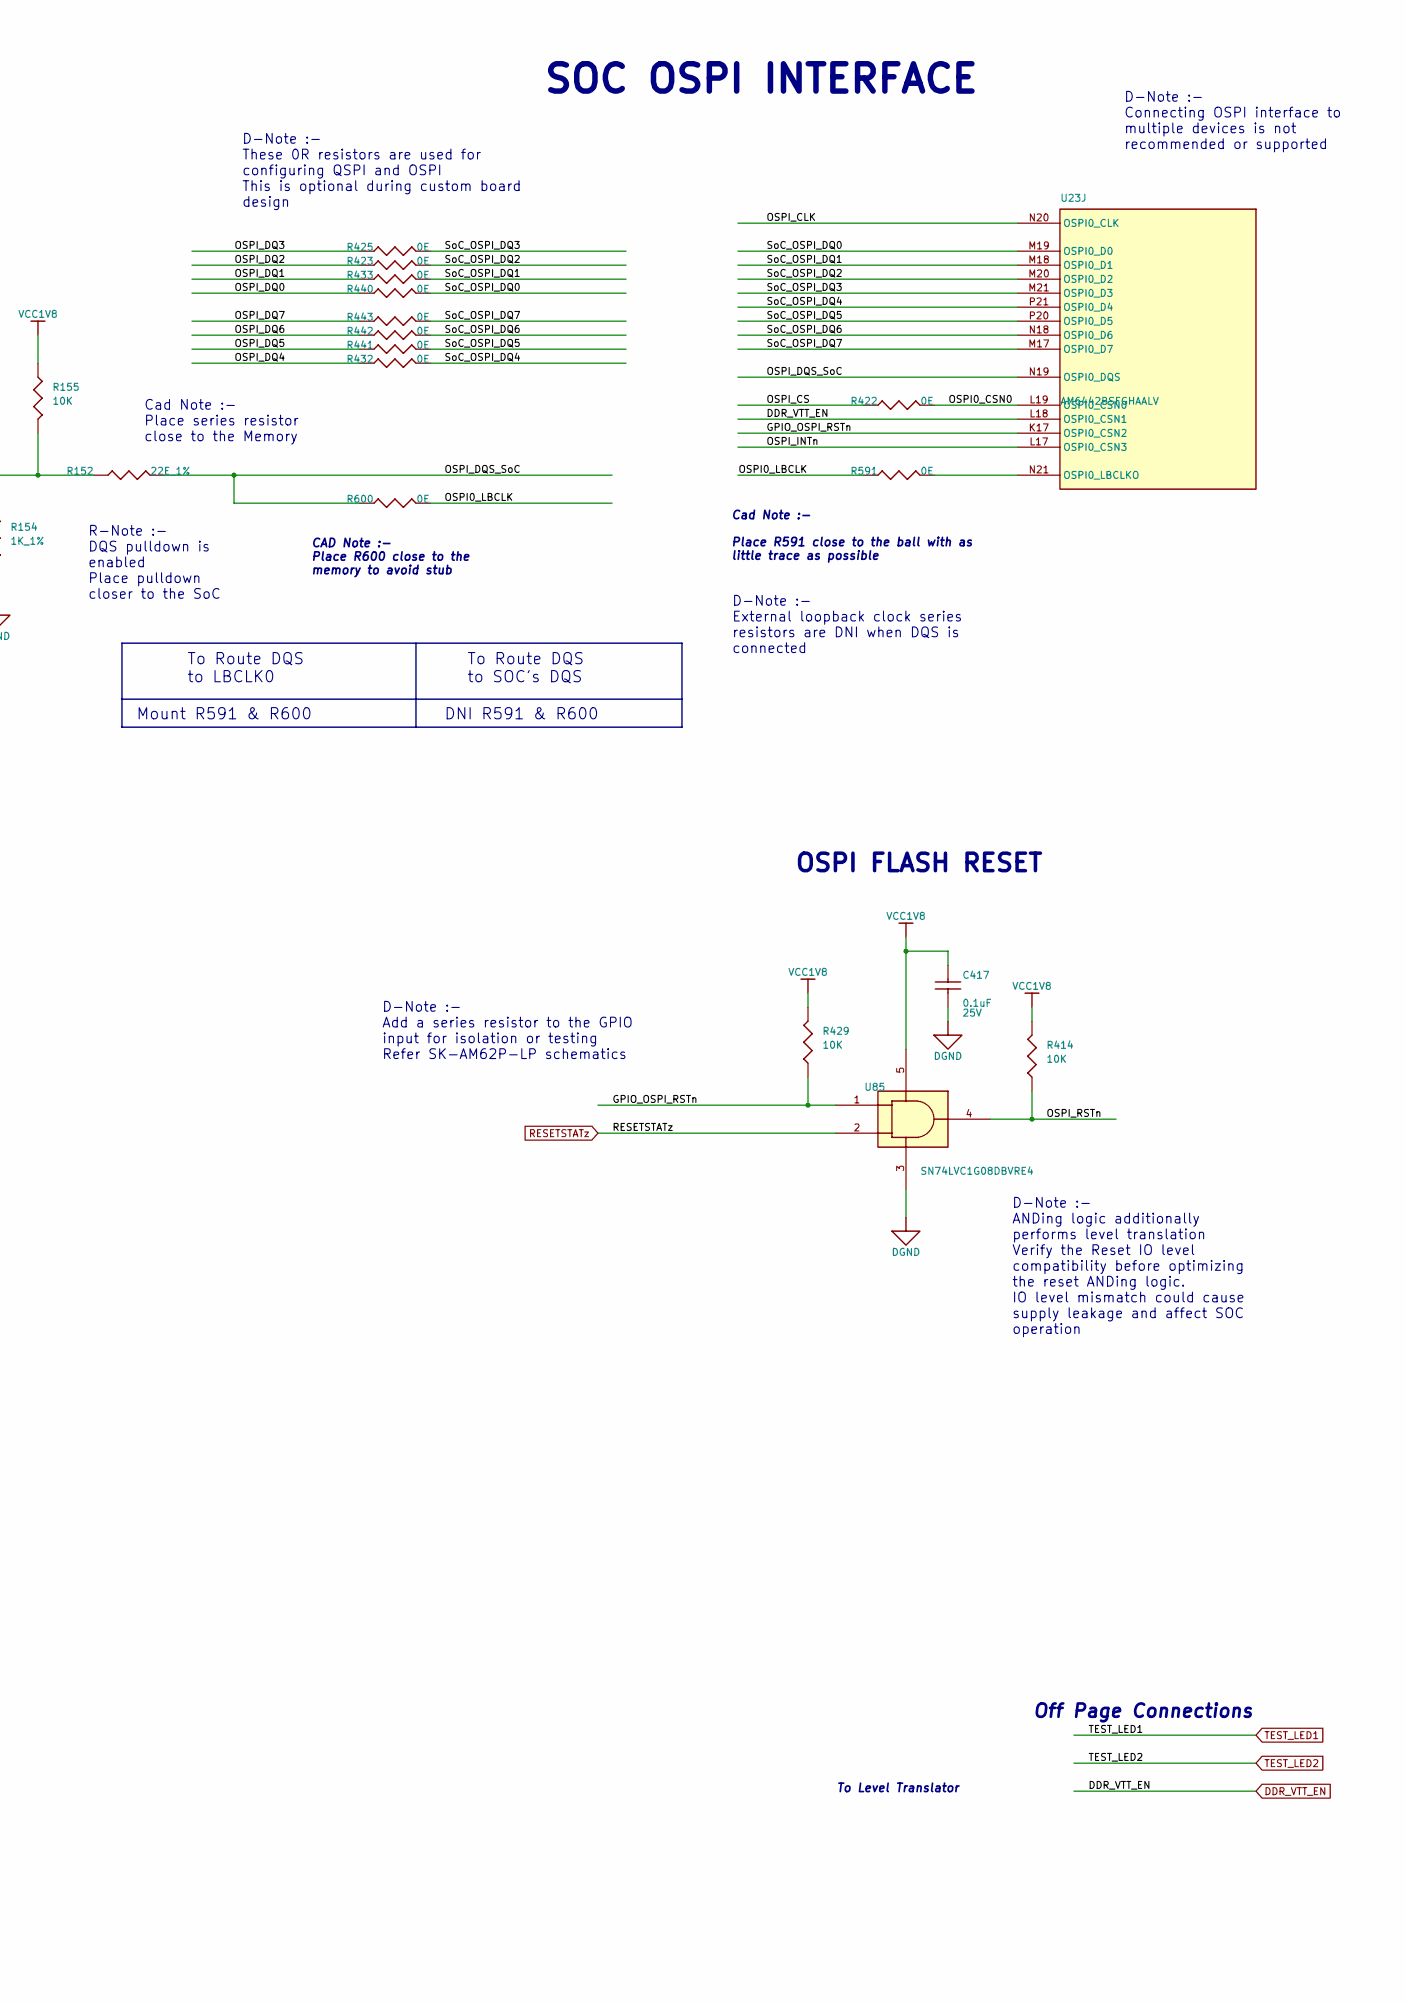
[picture p13: schematic 14.kicad_sch, part in row 1, column 2]

Parts:
C415: 4.7uF; CAP0402_0-75; TOLERANCE 20%; VOLTAGE 10V; MISTRAL PART NO 120012060002-R
C417, C418, C477: 0.1uF; CAP0402_0-75; VOLTAGE 25V; TOLERANCE 20%; PART_TYPE CAPACITOR~{S}CERAMIC
C476: 0.1uF; CAP0402_0-75; TOLERANCE 20%; VOLTAGE 25V; MISTRAL PART NO 120020080003-R
LD23: 150080RS75000; LED_150080VS75000_80X50_SMD_0-8; VOLTAGE NA; TOLERANCE NA; PART_TYPE OPT~{O}LED
LD26: 150080VS75000; LED_150080VS75000_80X50_SMD_0-8; TOLERANCE NA; VOLTAGE NA; MISTRAL PART NO 130020080012-R
Q18: BSS138LT1G; SOT23-123_1-2; VOLTAGE NA; TOLERANCE NA; PART_TYPE IC~{S}POWE~{R}MOSFET
Q19: BSS138LT1G; SOT23-123_1-2; TOLERANCE NA; VOLTAGE NA; MISTRAL PART NO 142016040001-R
R152: 22E_1%; RES0402_0-5; VOLTAGE NA; TOLERANCE 1%; PART_TYPE RESISTOR~{S}FIXED
R154: 1K_1%; RES0402_0-5; VOLTAGE NA; TOLERANCE 1%; PART_TYPE RESISTOR~{S}FIXED
R155, R181, R429, R554: 10K; RES0402_0-5; TOLERANCE 5%; VOLTAGE NA; MISTRAL PART NO 110011060021-R
R156, R167, R168, R169, R172, R173, R176, R178, R179, R180, R414, R549: 10K; RES0402_0-5; VOLTAGE NA; TOLERANCE 5%; PART_TYPE RESISTOR~{S}FIXED
R157: 0E; RES0402N; VOLTAGE NA; TOLERANCE NA; MISTRAL PART NO 110010080019-R
R158, R422, R432, R441, R442, R443, R552, R591, R600: 0E; RES0402_0-5; TOLERANCE NA; VOLTAGE NA; MISTRAL PART NO 110010080019-R
R197: 220E; RES0402_0-5; TOLERANCE 5%; VOLTAGE NA; PART_TYPE RESISTOR~{S}FIXED
R210: 220E; RES0402_0-5; VOLTAGE NA; TOLERANCE 5%; MISTRAL PART NO 110009030506-R
R423, R425, R433, R440, R553: 0E; RES0402_0-5; VOLTAGE NA; TOLERANCE NA; PART_TYPE RESISTOR~{S}FIXED
U23: AM6442BSFGHAALV; FCBGA441_31-49_680X680_2-6; VOLTAGE NA; TOLERANCE NA; PART_TYPE IC~{S}DIGITA~{L}MICROPROCESSOR
U40: S28HS512TGABHM010; BGA24_39-37_240X310_1; TOLERANCE NA; VOLTAGE NA; MISTRAL PART NO 141120010002
U85: SN74LVC1G08DBVRE4; SOT23-5; MISTRAL PART NO 141009060026-R

Connections:
DDR_VTT_EN: U23.L18 (OSPI0_CSN1)
DGND: C415.2, C417.2, C418.2, C476.2, C477.2, Q18.2 (S), Q19.2 (S), R154.2, R167.2, R549.1, R554.1, U40.B3 (VSS), U40.C1 (VSSQ), U40.E5 (VSSQ), U85.3 (GND)
GPIO_OSPI_RSTn: R429.1, U23.K17 (OSPI0_CSN2), U85.1 (A)
unnamed: LD23.1 (CATHODE), Q18.3 (D)
unnamed: LD23.2 (ANODE), R197.1
unnamed: LD26.1 (CATHODE), Q19.3 (D)
unnamed: LD26.2 (ANODE), R210.1
unnamed: Q18.1 (G), R553.1
unnamed: Q19.1 (G), R552.1
unnamed: R157.2, U40.B2 (CK)
unnamed: R158.1, U40.A5 (INT#)
unnamed: R591.2, U23.N21 (OSPI0_LBCLKO)
OSPI0_CSN0: R422.2, U23.L19 (OSPI0_CSN0)
OSPI0_LBCLK: R591.1, R600.2
OSPI_CLK: R157.1, R167.1, U23.N20 (OSPI0_CLK)
OSPI_CS: R168.1, R422.1, U40.C2 (CS#)
OSPI_DQ0: R181.2, R440.1, U40.D3 (DQ0)
OSPI_DQ1: R176.2, R433.1, U40.D2 (DQ1)
OSPI_DQ2: R169.2, R423.1, U40.C4 (DQ2)
OSPI_DQ3: R172.2, R425.1, U40.D4 (DQ3)
OSPI_DQ4: R173.2, R432.1, U40.D5 (DQ4)
OSPI_DQ5: R180.2, R441.1, U40.E3 (DQ5)
OSPI_DQ6: R179.2, R442.1, U40.E2 (DQ6)
OSPI_DQ7: R178.2, R443.1, U40.E1 (DQ7)
OSPI_DQS: R152.1, R154.1, R155.2, U40.C3 (DS)
OSPI_DQS_SoC: R152.2, R600.1, U23.N19 (OSPI0_DQS)
OSPI_INTn: R156.1, R158.2, U23.L17 (OSPI0_CSN3)
OSPI_RSTn: R414.1, U40.A4 (RESET#), U85.4 (Y)
RESETSTATz: U85.2 (B)
SoC_OSPI_DQ0: R440.2, U23.M19 (OSPI0_D0)
SoC_OSPI_DQ1: R433.2, U23.M18 (OSPI0_D1)
SoC_OSPI_DQ2: R423.2, U23.M20 (OSPI0_D2)
SoC_OSPI_DQ3: R425.2, U23.M21 (OSPI0_D3)
SoC_OSPI_DQ4: R432.2, U23.P21 (OSPI0_D4)
SoC_OSPI_DQ5: R441.2, U23.P20 (OSPI0_D5)
SoC_OSPI_DQ6: R442.2, U23.N18 (OSPI0_D6)
SoC_OSPI_DQ7: R443.2, U23.M17 (OSPI0_D7)
TEST_LED1: R549.2, R553.2
TEST_LED2: R552.2, R554.2
VCC1V8: C415.1, C417.1, C418.1, C476.1, C477.1, R155.1, R156.2, R168.2, R169.1, R172.1, R173.1, R176.1, R178.1, R179.1, R180.1, R181.1, R414.2, R429.2, U40.B4 (VCC), U40.D1 (VCCQ), U40.E4 (VCCQ), U85.5 (VCC)
VCC_3V3_SYS: R197.2, R210.2

Notes on the sheet:
CAD Note :- Place R600 close to the memory to avoid stub
To Route DQS to LBCLK0
D-Note :- Choice of QSPI memory device : For improved performance, it is recommended to select QSPI memory device with an external reset input pin The reset pin is recommended to be controlled using SOC reset status output or an ANDing logic as implemented in the starter kit
Cad Note :- Place series resistor close to the Memory
D-Note :- These 0R resistors are used for configuring QSPI and OSPI This is optional during custom board design
CAD Note :- Place SOC clock output pulldown resistor near to the clock input pin of the attached (memory) device
R-Note :- DQS pulldown is enabled Place pulldown closer to the SoC
D-Note :- ANDing logic additionally performs level translation Verify the Reset IO level compatibility before optimizing the reset ANDing logic. IO level mismatch could cause supply leakage and affect SOC operation
Cad Note :- Place pulldown near to SOC
Cad Note :- Place R591 close to the ball with as little trace as possible
D-Note :- For QSPI Configuration DNI the following 0E resistors 1.OSPI_DQ4 to OSPI_DQ7 nets 2.OSPI_INTn
D-Note :- External loopback clock series resistors are DNI when DQS is connected
D-Note :- Connecting OSPI interface to multiple devices is not recommended or supported
To Route DQS to SOC's DQS
D-Note :- Add a series resistor to the GPIO input for isolation or testing Refer SK-AM62P-LP schematics
D-Note :- Place series resistor near to the SoC
R-Note :- SOC IO buffers are off during power-up. A pullup is recommended near to the attached device, to hold the attached device IOs in a known state. Use of Pullups are attached device dependent
USER TEST LED
Off Page Connections
DNI R591 & R600
To Level Translator
OSPI FLASH RESET
OSPI FLASH
SOC OSPI INTERFACE
Mount R591 & R600
