gingerologist/am64x/15.kicad_sch

## KiCad design 15.kicad_sch (2024-08-05)

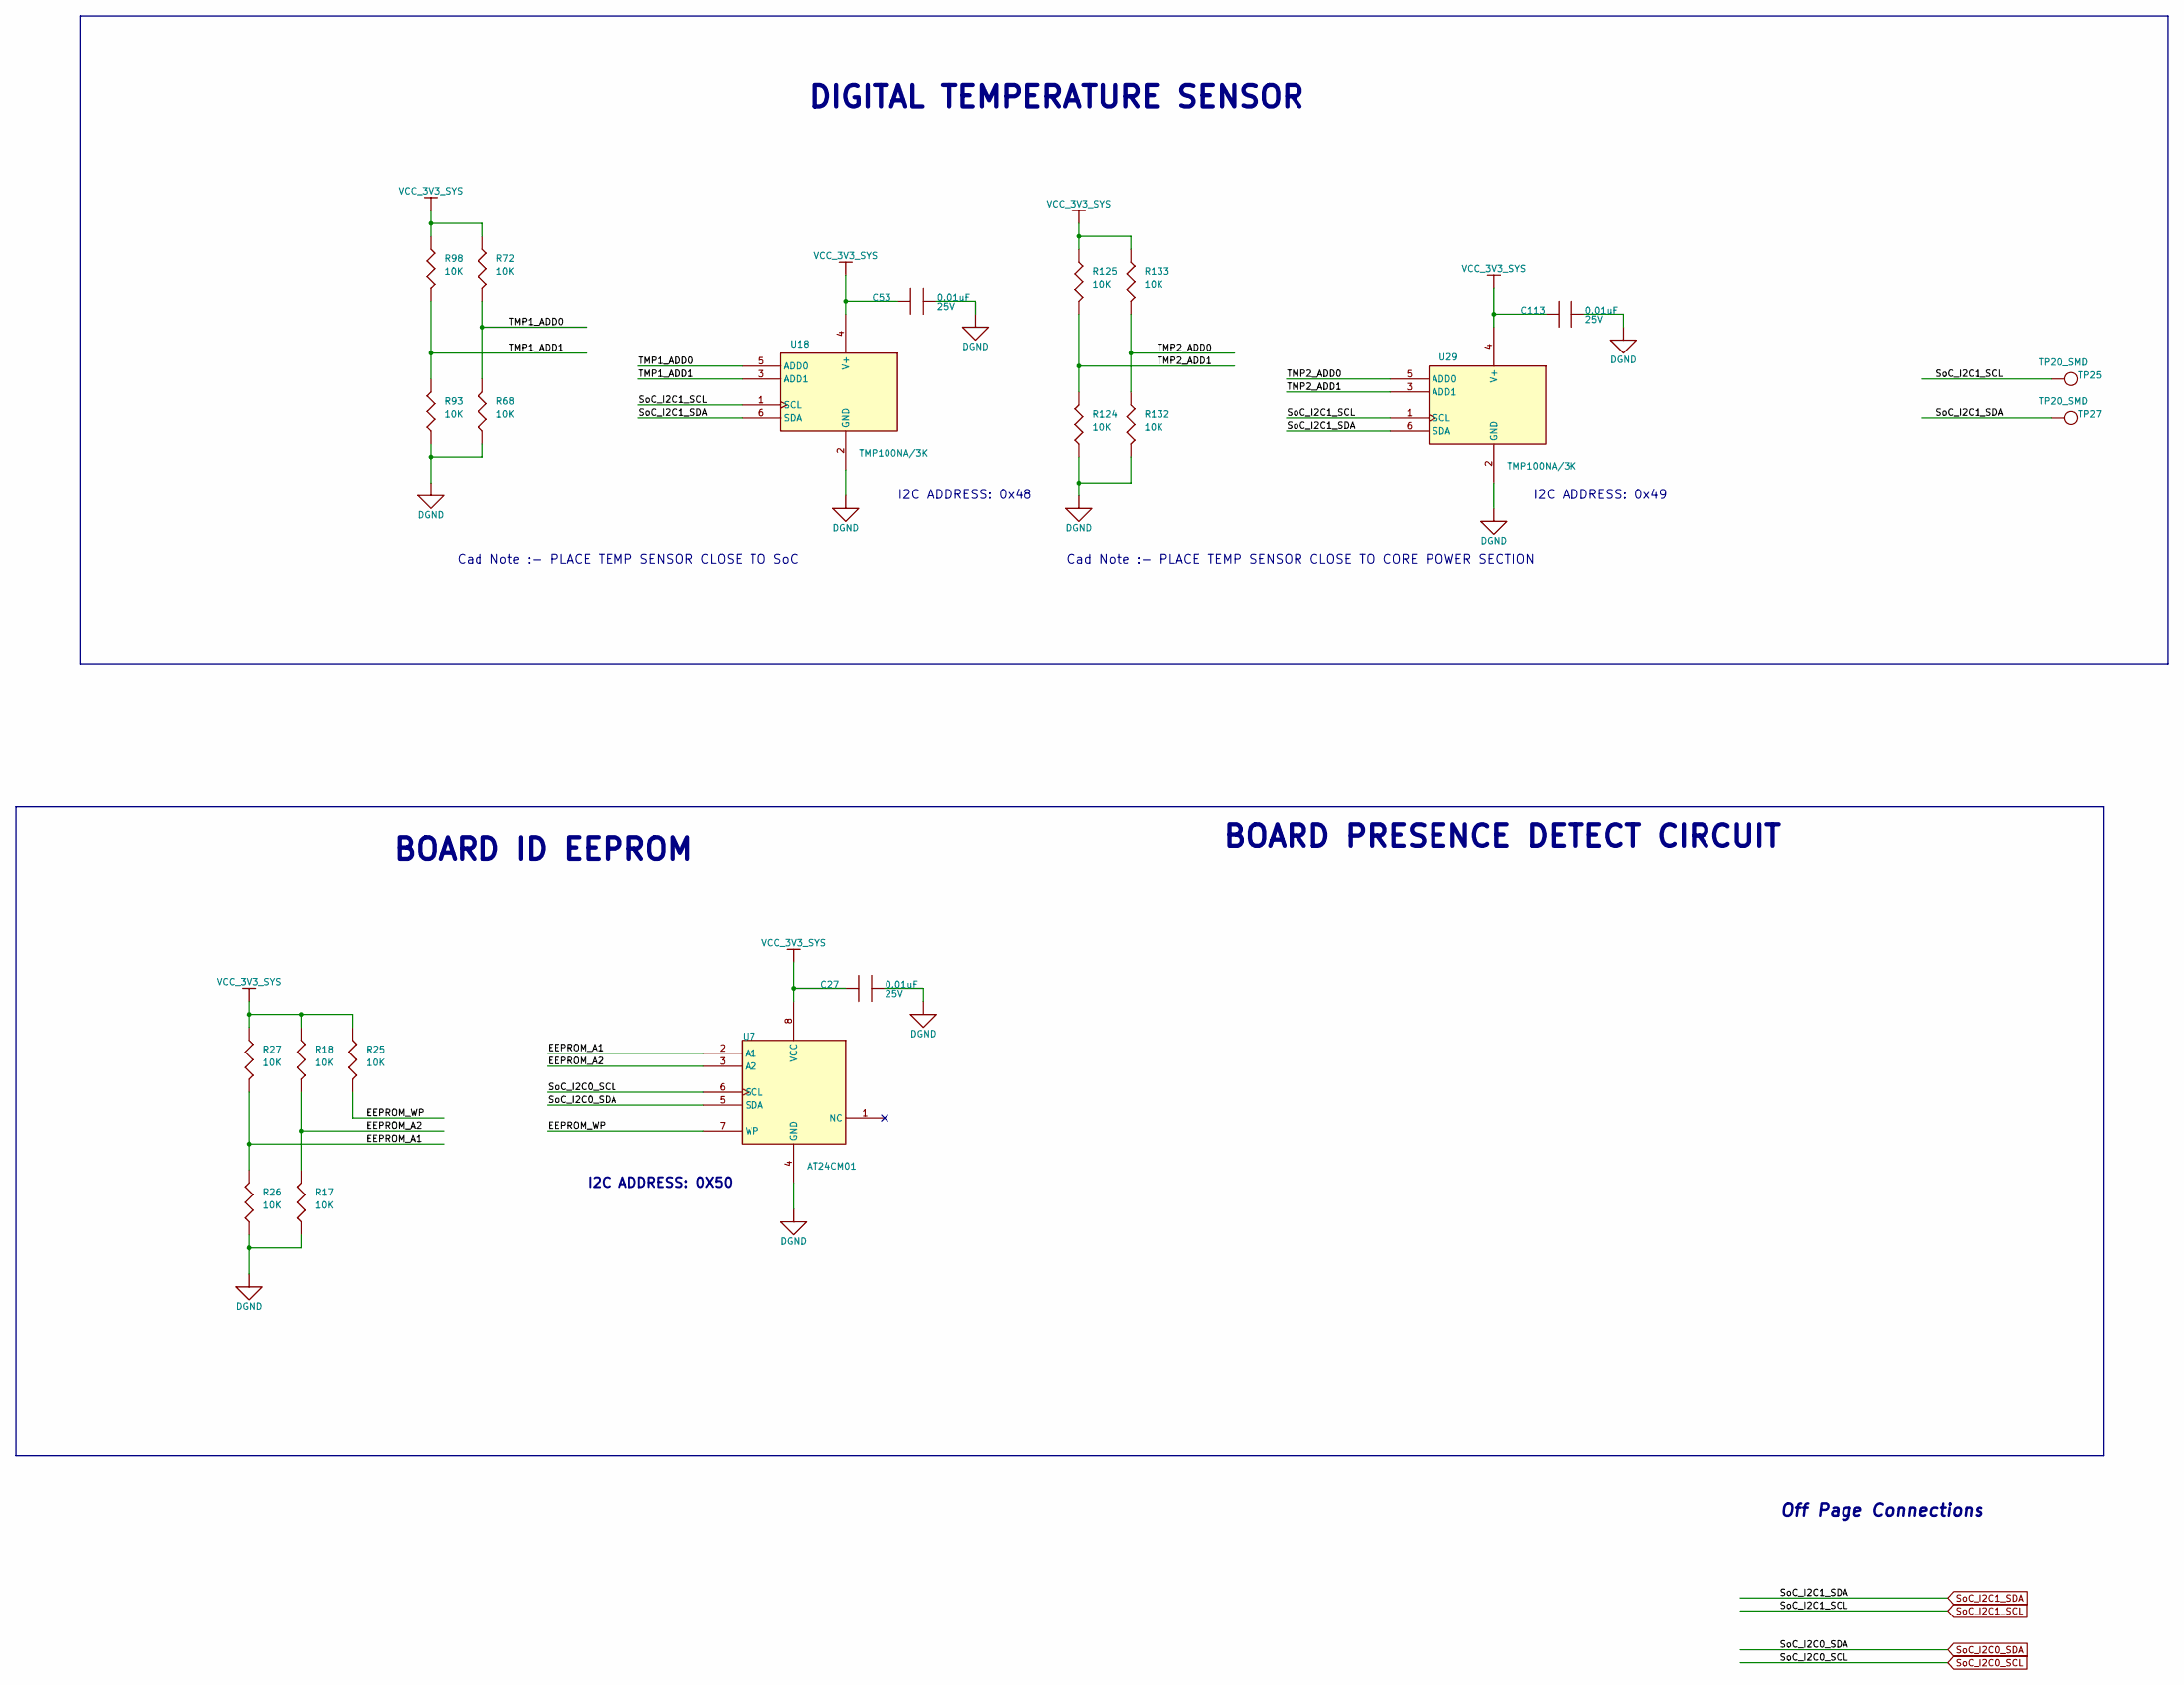
[picture p14: schematic 15.kicad_sch]

Parts:
C27: 0.01uF; CAP0402N; VOLTAGE 25V; TOLERANCE 10%; PART_TYPE CAPACITOR~{S}CERAMIC
C53, C113: 0.01uF; CAP0402N; TOLERANCE 10%; VOLTAGE 25V; MISTRAL PART NO 120011090040-R
R17, R68, R72, R98, R124: 10K; RES0402_0-5; VOLTAGE NA; TOLERANCE 5%; PART_TYPE RESISTOR~{S}FIXED
R18, R25, R26, R27, R93, R125, R132, R133: 10K; RES0402_0-5; TOLERANCE 5%; VOLTAGE NA; MISTRAL PART NO 110011060021-R
TP25, TP27: TP20_SMD; TOLERANCE NA; VOLTAGE NA; MISTRAL PART NO NA
U7: AT24CM01; TSSOP8_25-59_125X180_1-2; TOLERANCE NA; VOLTAGE NA; MISTRAL PART NO 141114090006-R
U18: TMP100NA/3K; SOT23-6_1-5; VOLTAGE NA; TOLERANCE NA; PART_TYPE IC~{S}DIGITA~{L}PERIPHERAL
U29: TMP100NA/3K; SOT23-6_1-5; TOLERANCE NA; VOLTAGE NA; MISTRAL PART NO 141017080030-R

Connections:
DGND: C27.1, C53.1, C113.1, R17.1, R26.1, R68.1, R93.1, R124.1, R132.2, U7.4 (GND), U18.2 (GND), U29.2 (GND)
EEPROM_A1: R26.2, R27.2, U7.2 (A1)
EEPROM_A2: R17.2, R18.2, U7.3 (A2)
EEPROM_WP: R25.2, U7.7 (WP)
SoC_I2C0_SCL: U7.6 (SCL)
SoC_I2C0_SDA: U7.5 (SDA)
SoC_I2C1_SCL: TP25.1, U18.1 (SCL), U29.1 (SCL)
SoC_I2C1_SDA: TP27.1, U18.6 (SDA), U29.6 (SDA)
TMP1_ADD0: R68.2, R72.2, U18.5 (ADD0)
TMP1_ADD1: R93.2, R98.2, U18.3 (ADD1)
TMP2_ADD0: R132.1, R133.2, U29.5 (ADD0)
TMP2_ADD1: R124.2, R125.2, U29.3 (ADD1)
VCC_3V3_SYS: C27.2, C53.2, C113.2, R18.1, R25.1, R27.1, R72.1, R98.1, R125.1, R133.1, U7.8 (VCC), U18.4 (V+), U29.4 (V+)

Notes on the sheet:
DIGITAL TEMPERATURE SENSOR
I2C ADDRESS: 0x49
BOARD ID EEPROM
I2C ADDRESS: 0x48
Off Page Connections
BOARD PRESENCE DETECT CIRCUIT
Cad Note :- PLACE TEMP SENSOR CLOSE TO SoC
I2C ADDRESS: 0X50
Cad Note :- PLACE TEMP SENSOR CLOSE TO CORE POWER SECTION
