gingerologist/am64x/16.kicad_sch

## KiCad design 16.kicad_sch (2024-08-05)

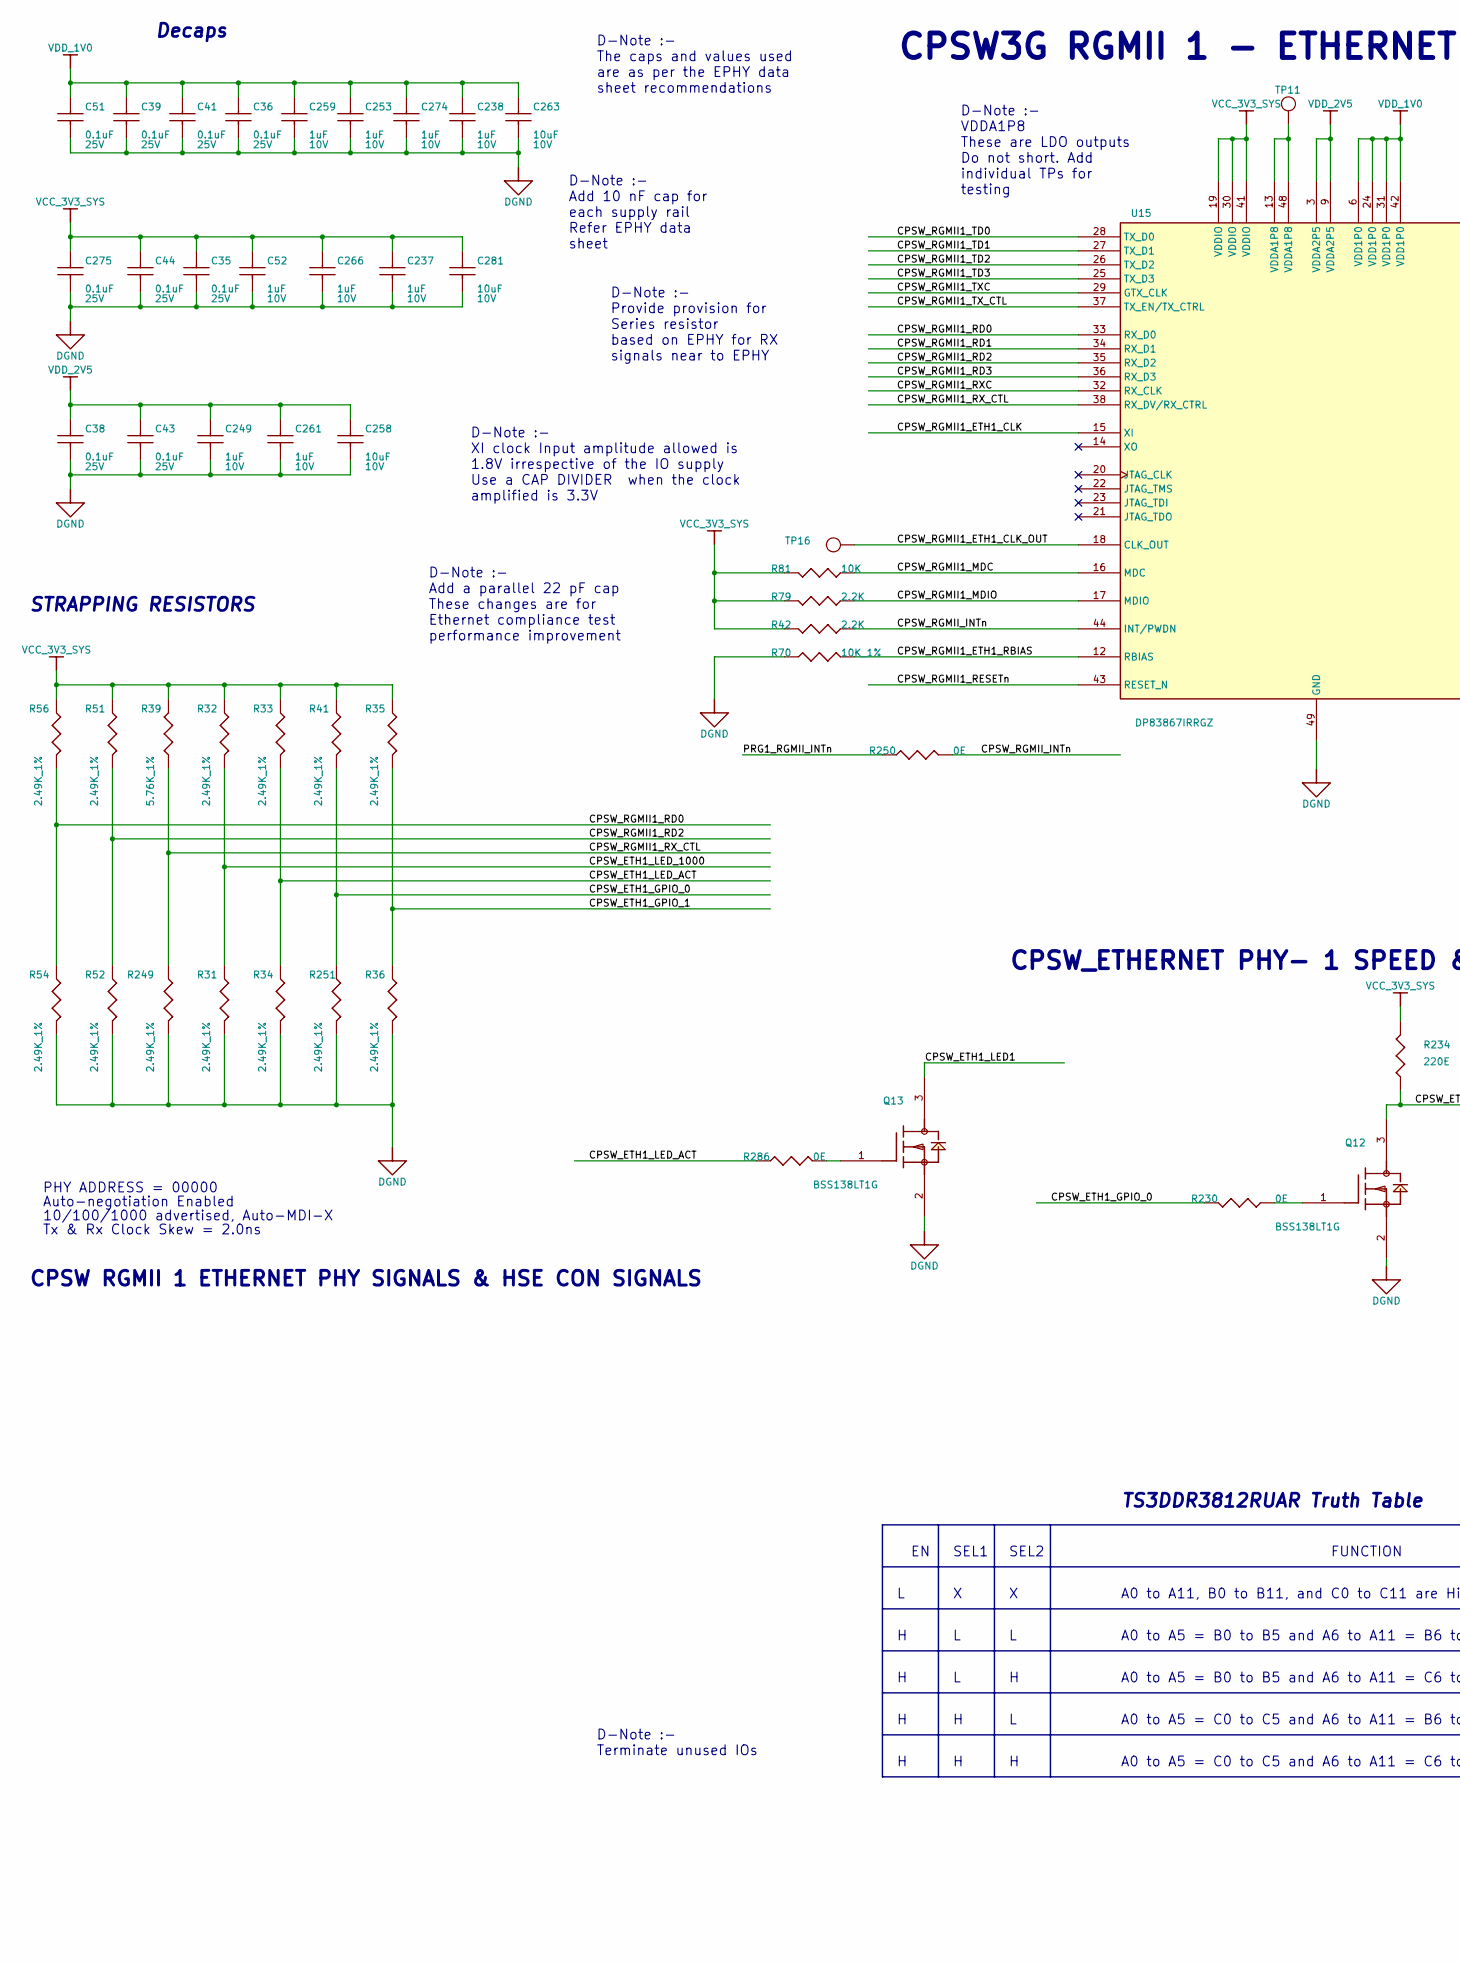
[picture p15: schematic 16.kicad_sch, part in row 1, column 1]

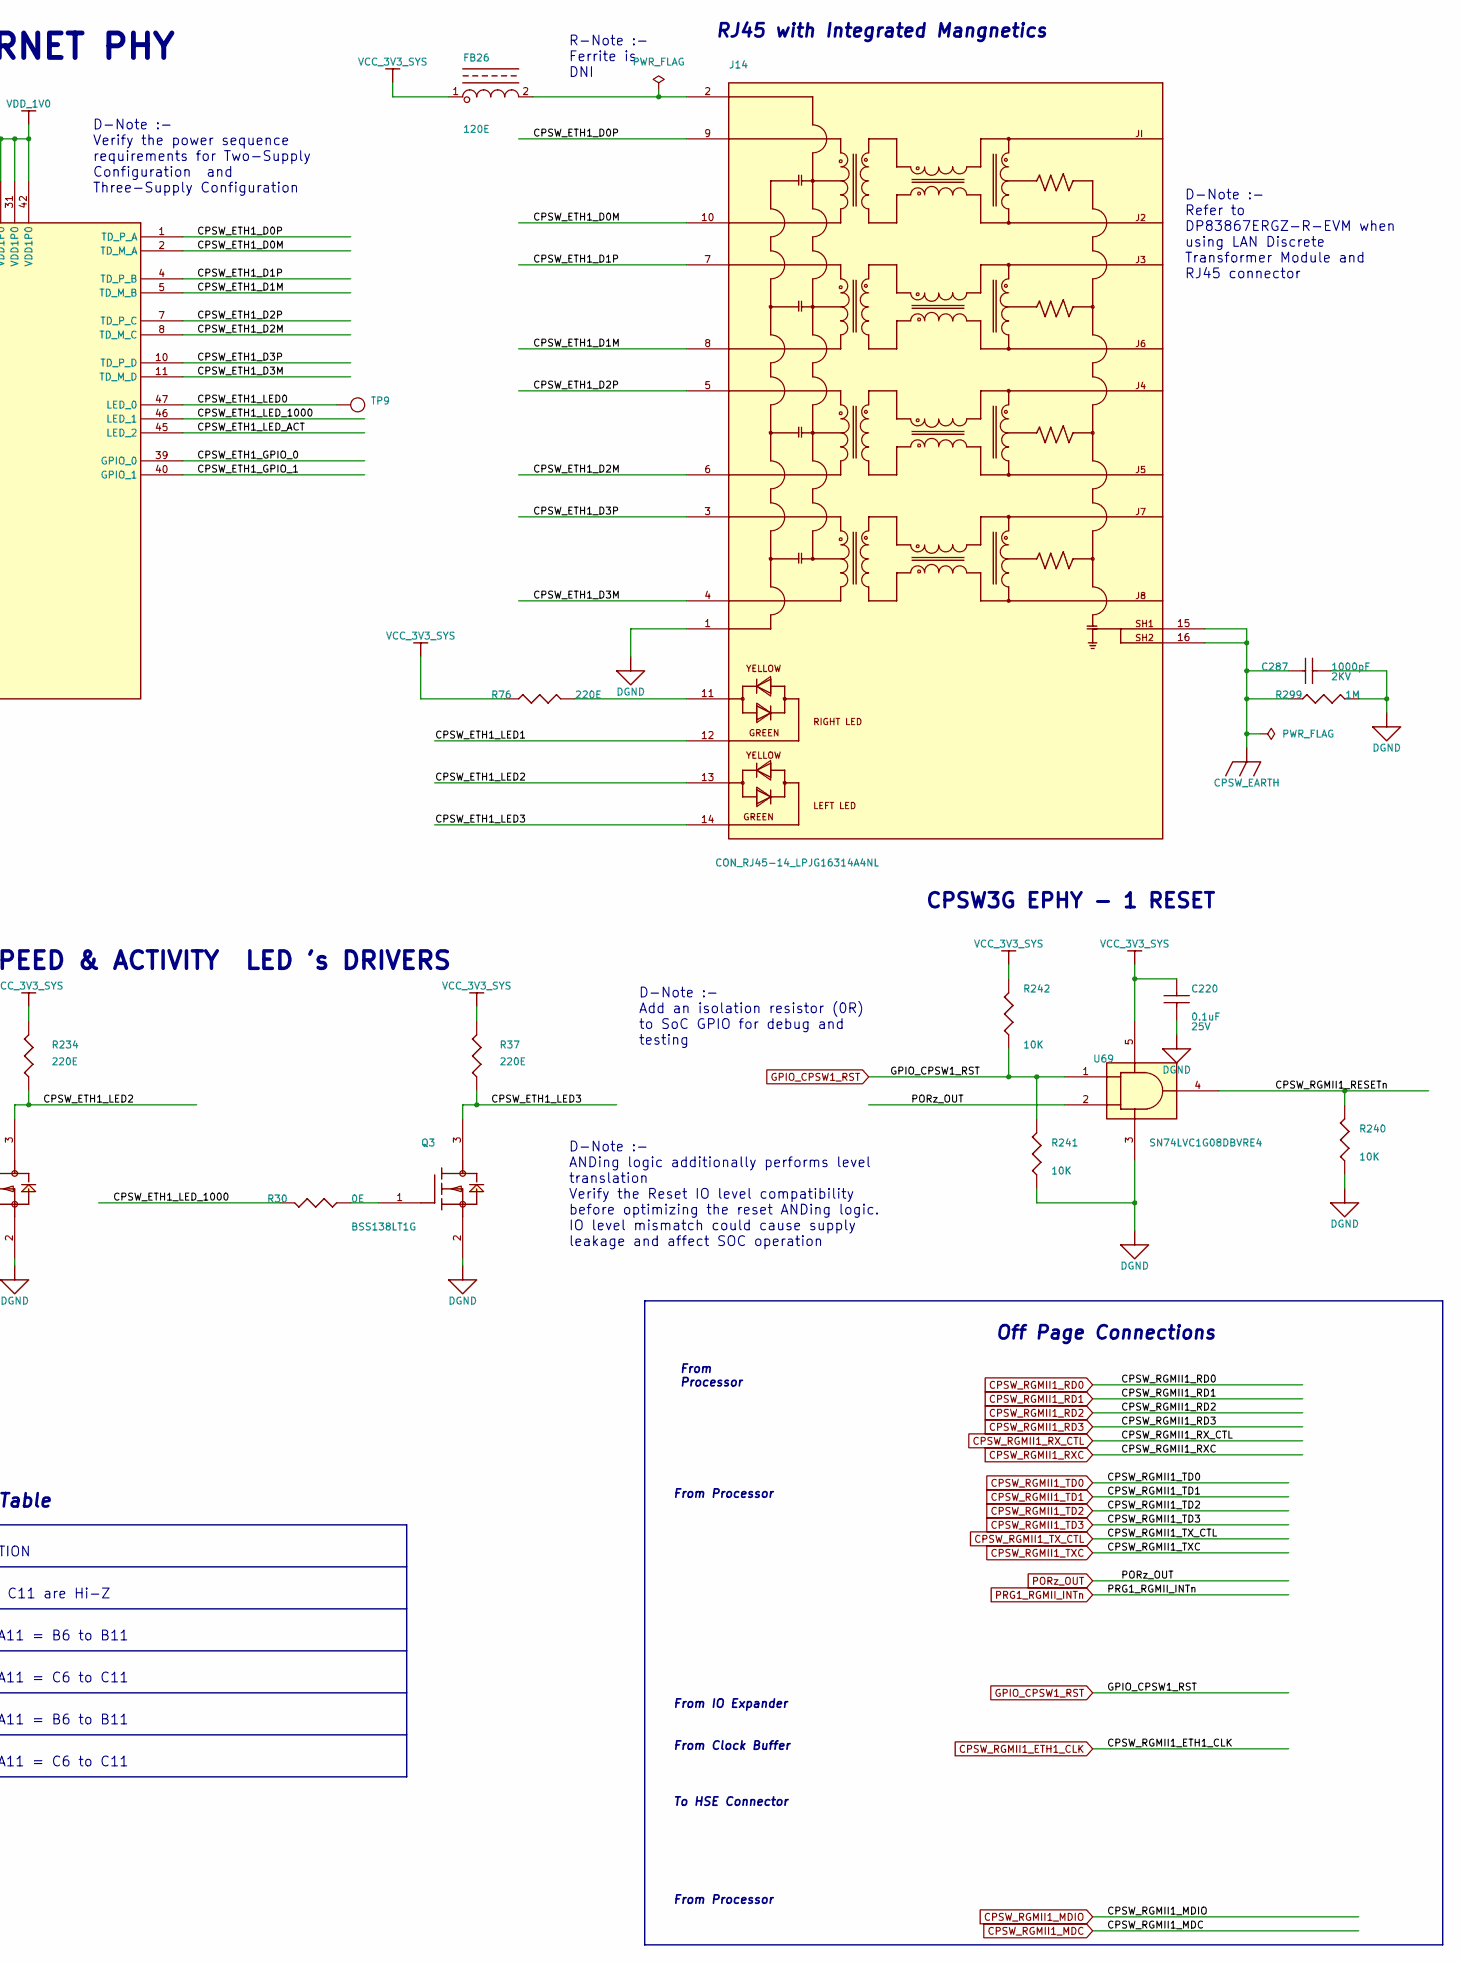
[picture p16: schematic 16.kicad_sch, part in row 1, column 2]

Parts:
C35, C36, C38, C39, C41, C43, C44, C51, C275: 0.1uF; CAP0402_0-75; TOLERANCE 20%; VOLTAGE 25V; MISTRAL PART NO 120020080003-R
C52, C249, C259, C261, C266, C274: 1uF; CAP0402_0-75; VOLTAGE 10V; TOLERANCE 20%; PART_TYPE CAPACITOR~{S}CERAMIC
C220: 0.1uF; CAP0402_0-75; VOLTAGE 25V; TOLERANCE 20%; PART_TYPE CAPACITOR~{S}CERAMIC
C237, C238, C253: 1uF; CAP0402_0-75; TOLERANCE 20%; VOLTAGE 10V; MISTRAL PART NO 120020080009-R
C258, C281: 10uF; CAP0402_0-75; VOLTAGE 10V; TOLERANCE 20%; PART_TYPE CAPACITOR~{S}CERAMIC
C263: 10uF; CAP0402_0-75; TOLERANCE 20%; VOLTAGE 10V; MISTRAL PART NO 120013110019-R
C287: 1000pF; CAP1206_1-75; TOLERANCE 10%; VOLTAGE 2KV; MISTRAL PART NO 120015080006-R
FB26: 120E; IND0603_1; VOLTAGE NA; TOLERANCE 25%; PART_TYPE INDUCTOR
J14: CON_RJ45-14_LPJG16314A4NL; CON_RJ45-14_LPJG16314A4NL_S_R_T_13-6; TOLERANCE NA; VOLTAGE NA; MISTRAL PART NO 150014060029-R
Q3: BSS138LT1G; SOT23-123_1-2; TOLERANCE NA; VOLTAGE NA; MISTRAL PART NO 142016040001-R
Q12, Q13: BSS138LT1G; SOT23-123_1-2; VOLTAGE NA; TOLERANCE NA; PART_TYPE IC~{S}POWE~{R}MOSFET
R30: 0E; RES0402_0-5; TOLERANCE NA; VOLTAGE NA; MISTRAL PART NO 110010080019-R
R31, R34, R35, R36, R41, R51, R54, R251: 2.49K_1%; RES0402_0-5; VOLTAGE NA; TOLERANCE 1%; PART_TYPE RESISTOR~{S}FIXED
R32, R33, R52, R56, R249: 2.49K_1%; RES0402_0-5; TOLERANCE 1%; VOLTAGE NA; MISTRAL PART NO 110016050020-R
R37: 220E; RES0402_0-5; VOLTAGE NA; TOLERANCE 5%; MISTRAL PART NO 110009030506-R
R39: 5.76K_1%; RES0402_0-5; VOLTAGE NA; TOLERANCE 1%; PART_TYPE RESISTOR~{S}FIXED
R42: 2.2K; RES0402_0-5; VOLTAGE NA; TOLERANCE 5%; PART_TYPE RESISTOR~{S}FIXED
R70: 10K_1%; RES0402_0-5; TOLERANCE 1%; VOLTAGE NA; MISTRAL PART NO 110020100039-R
R76: 220E; RES0402_0-5; TOLERANCE 5%; VOLTAGE NA; PART_TYPE RESISTOR~{S}FIXED
R79: 2.2K; RES0402_0-5; TOLERANCE 5%; VOLTAGE NA; MISTRAL PART NO 110010120018-R
R81, R240, R242: 10K; RES0402_0-5; TOLERANCE 5%; VOLTAGE NA; MISTRAL PART NO 110011060021-R
R230, R250, R286: 0E; RES0402_0-5; VOLTAGE NA; TOLERANCE NA; PART_TYPE RESISTOR~{S}FIXED
R234: 220E; RES0402_0-5; VOLTAGE NA; TOLERANCE 5%; PART_TYPE RESISTOR~{S}FIXED
R241: 10K; RES0402_0-5; VOLTAGE NA; TOLERANCE 5%; PART_TYPE RESISTOR~{S}FIXED
R299: 1M; RES0603_0-75; VOLTAGE NA; TOLERANCE 5%; PART_TYPE RESISTOR~{S}FIXED
TP9, TP16: TP20_SMD; TOLERANCE NA; VOLTAGE NA; PART_TYPE TESTPOINT
TP11: TP20_SMD; VOLTAGE NA; TOLERANCE NA; PART_TYPE TESTPOINT
U15: DP83867IRRGZ; QFN48_19-68_280X280_1; TOLERANCE NA; VOLTAGE NA; MISTRAL PART NO 143017080002-R
U69: SN74LVC1G08DBVRE4; SOT23-5; MISTRAL PART NO 141009060026-R

Connections:
CPSW_EARTH: C287.1, J14.15 (SH1), J14.16 (SH2), R299.1
CPSW_ETH1_D0M: J14.10 (MX0-), U15.2 (TD_M_A)
CPSW_ETH1_D0P: J14.9 (MX0+), U15.1 (TD_P_A)
CPSW_ETH1_D1M: J14.8 (MX1-), U15.5 (TD_M_B)
CPSW_ETH1_D1P: J14.7 (MX1+), U15.4 (TD_P_B)
CPSW_ETH1_D2M: J14.6 (MX2-), U15.8 (TD_M_C)
CPSW_ETH1_D2P: J14.5 (MX2+), U15.7 (TD_P_C)
CPSW_ETH1_D3M: J14.4 (MX3-), U15.11 (TD_M_D)
CPSW_ETH1_D3P: J14.3 (MX3+), U15.10 (TD_P_D)
CPSW_ETH1_GPIO_0: R41.2, R230.2, R251.1, U15.39 (GPIO_0)
CPSW_ETH1_GPIO_1: R35.2, R36.1, U15.40 (GPIO_1)
CPSW_ETH1_LED0: TP9.1, U15.47 (LED_0)
CPSW_ETH1_LED1: J14.12, Q13.3 (D)
CPSW_ETH1_LED2: J14.13, Q12.3 (D), R234.1
CPSW_ETH1_LED3: J14.14, Q3.3 (D), R37.1
CPSW_ETH1_LED_1000: R30.2, R31.1, R32.2, U15.46 (LED_1)
CPSW_ETH1_LED_ACT: R33.2, R34.1, R286.1, U15.45 (LED_2)
CPSW_RGMII1_ETH1_CLK: U15.15 (XI)
CPSW_RGMII1_ETH1_CLK_OUT: TP16.1, U15.18 (CLK_OUT)
CPSW_RGMII1_ETH1_RBIAS: R70.1, U15.12 (RBIAS)
CPSW_RGMII1_MDC: R81.2, U15.16 (MDC)
CPSW_RGMII1_MDIO: R79.1, U15.17 (MDIO)
CPSW_RGMII1_RD0: R54.1, R56.2, U15.33 (RX_D0)
CPSW_RGMII1_RD1: U15.34 (RX_D1)
CPSW_RGMII1_RD2: R51.2, R52.1, U15.35 (RX_D2)
CPSW_RGMII1_RD3: U15.36 (RX_D3)
CPSW_RGMII1_RESETn: R240.1, U15.43 (RESET_N), U69.4 (Y)
CPSW_RGMII1_RXC: U15.32 (RX_CLK)
CPSW_RGMII1_RX_CTL: R39.1, R249.1, U15.38 (RX_DV/RX_CTRL)
CPSW_RGMII1_TD0: U15.28 (TX_D0)
CPSW_RGMII1_TD1: U15.27 (TX_D1)
CPSW_RGMII1_TD2: U15.26 (TX_D2)
CPSW_RGMII1_TD3: U15.25 (TX_D3)
CPSW_RGMII1_TXC: U15.29 (GTX_CLK)
CPSW_RGMII1_TX_CTL: U15.37 (TX_EN/TX_CTRL)
CPSW_RGMII_INTn: R42.1, R250.2, U15.44 (INT/PWDN)
DGND: C35.2, C36.2, C38.2, C39.2, C41.2, C43.2, C44.2, C51.2, C52.2, C220.2, C237.2, C238.2, C249.2, C253.2, C258.2, C259.2, C261.2, C263.2, C266.2, C274.2, C275.2, C281.2, C287.2, J14.1 (CH-GND), Q3.2 (S), Q12.2 (S), Q13.2 (S), R31.2, R34.2, R36.2, R52.2, R54.2, R70.2, R240.2, R241.2, R249.2, R251.2, R299.2, U15.49 (GND), U69.3 (GND)
GPIO_CPSW1_RST: R241.1, R242.1, U69.1 (A)
unnamed: FB26.2, J14.2 (VCC)
unnamed: J14.11, R76.2
unnamed: Q3.1 (G), R30.1
unnamed: Q12.1 (G), R230.1
unnamed: Q13.1 (G), R286.2
unnamed: TP11.1, U15.13 (VDDA1P8), U15.48 (VDDA1P8)
PORz_OUT: U69.2 (B)
PRG1_RGMII_INTn: R250.1
VCC_3V3_SYS: C35.1, C44.1, C52.1, C220.1, C237.1, C266.1, C275.1, C281.1, FB26.1, R32.1, R33.1, R35.1, R37.2, R39.2, R41.1, R42.2, R51.1, R56.1, R76.1, R79.2, R81.1, R234.2, R242.2, U15.19 (VDDIO), U15.30 (VDDIO), U15.41 (VDDIO), U69.5 (VCC)
VDD_1V0: C36.1, C39.1, C41.1, C51.1, C238.1, C253.1, C259.1, C263.1, C274.1, U15.6 (VDD1P0), U15.24 (VDD1P0), U15.31 (VDD1P0), U15.42 (VDD1P0)
VDD_2V5: C38.1, C43.1, C249.1, C258.1, C261.1, U15.3 (VDDA2P5), U15.9 (VDDA2P5)

Notes on the sheet:
D-Note :- ANDing logic additionally performs level translation Verify the Reset IO level compatibility before optimizing the reset ANDing logic. IO level mismatch could cause supply leakage and affect SOC operation
D-Note :- Provide provision for Series resistor based on EPHY for RX signals near to EPHY
D-Note :- Verify the power sequence requirements for Two-Supply Configuration and Three-Supply Configuration
D-Note :- VDDA1P8 These are LDO outputs Do not short. Add individual TPs for testing
D-Note :- Add an isolation resistor (0R) to SoC GPIO for debug and testing
D-Note :- Terminate unused IOs
D-Note :- Add a parallel 22 pF cap These changes are for Ethernet compliance test performance improvement
D-Note :- The caps and values used are as per the EPHY data sheet recommendations
From Processor
R-Note :- Ferrite is DNI
D-Note :- Refer to DP83867ERGZ-R-EVM when using LAN Discrete Transformer Module and RJ45 connector
D-Note :- XI clock Input amplitude allowed is 1.8V irrespective of the IO supply Use a CAP DIVIDER when the clock amplified is 3.3V
D-Note :- Add 10 nF cap for each supply rail Refer EPHY data sheet
FUNCTION
CPSW_ETHERNET PHY- 1 SPEED & ACTIVITY LED 's DRIVERS
STRAPPING RESISTORS
TS3DDR3812RUAR Truth Table
A0 to A5 = B0 to B5 and A6 to A11 = C6 to C11
PHY ADDRESS = 00000
SEL1
From Processor
10/100/1000 advertised, Auto-MDI-X
Decaps
A0 to A5 = C0 to C5 and A6 to A11 = B6 to B11
A0 to A5 = C0 to C5 and A6 to A11 = C6 to C11
Off Page Connections
RJ45 with Integrated Mangnetics
From IO Expander
Tx & Rx Clock Skew = 2.0ns
Auto-negotiation Enabled
CPSW3G EPHY - 1 RESET
To HSE Connector
From Clock Buffer
CPSW RGMII 1 ETHERNET PHY SIGNALS & HSE CON SIGNALS
A0 to A5 = B0 to B5 and A6 to A11 = B6 to B11
SEL2
CPSW3G RGMII 1 - ETHERNET PHY
A0 to A11, B0 to B11, and C0 to C11 are Hi-Z
