gingerologist/am64x/17.kicad_sch

## KiCad design 17.kicad_sch (2024-07-26)

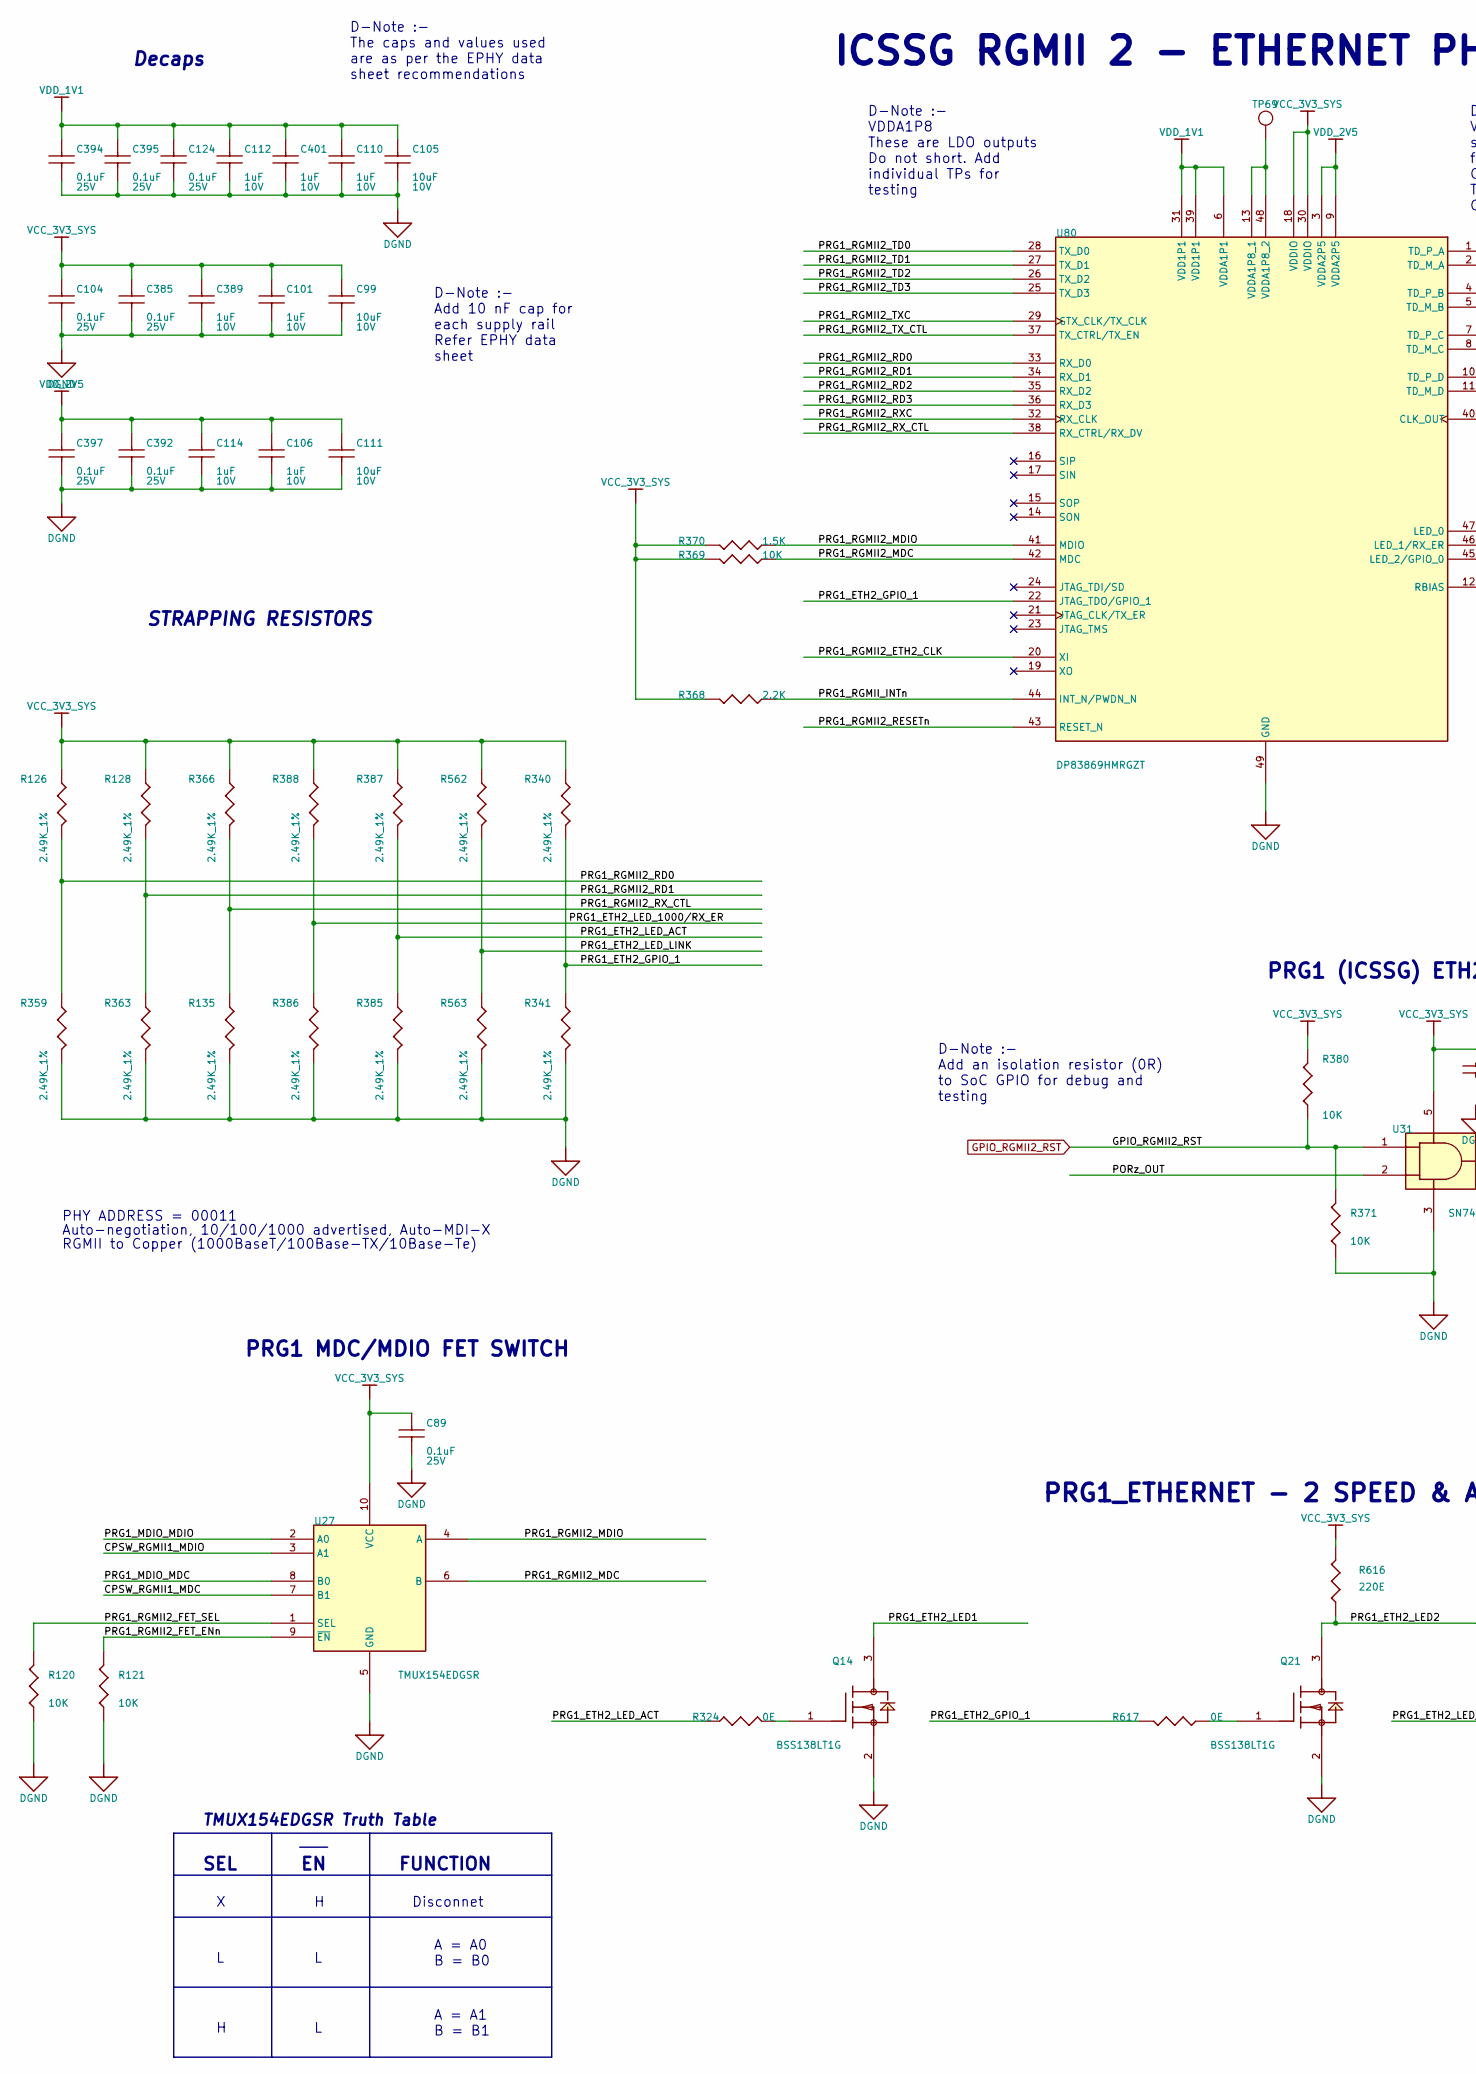
[picture p17: schematic 17.kicad_sch, part in row 1, column 1]

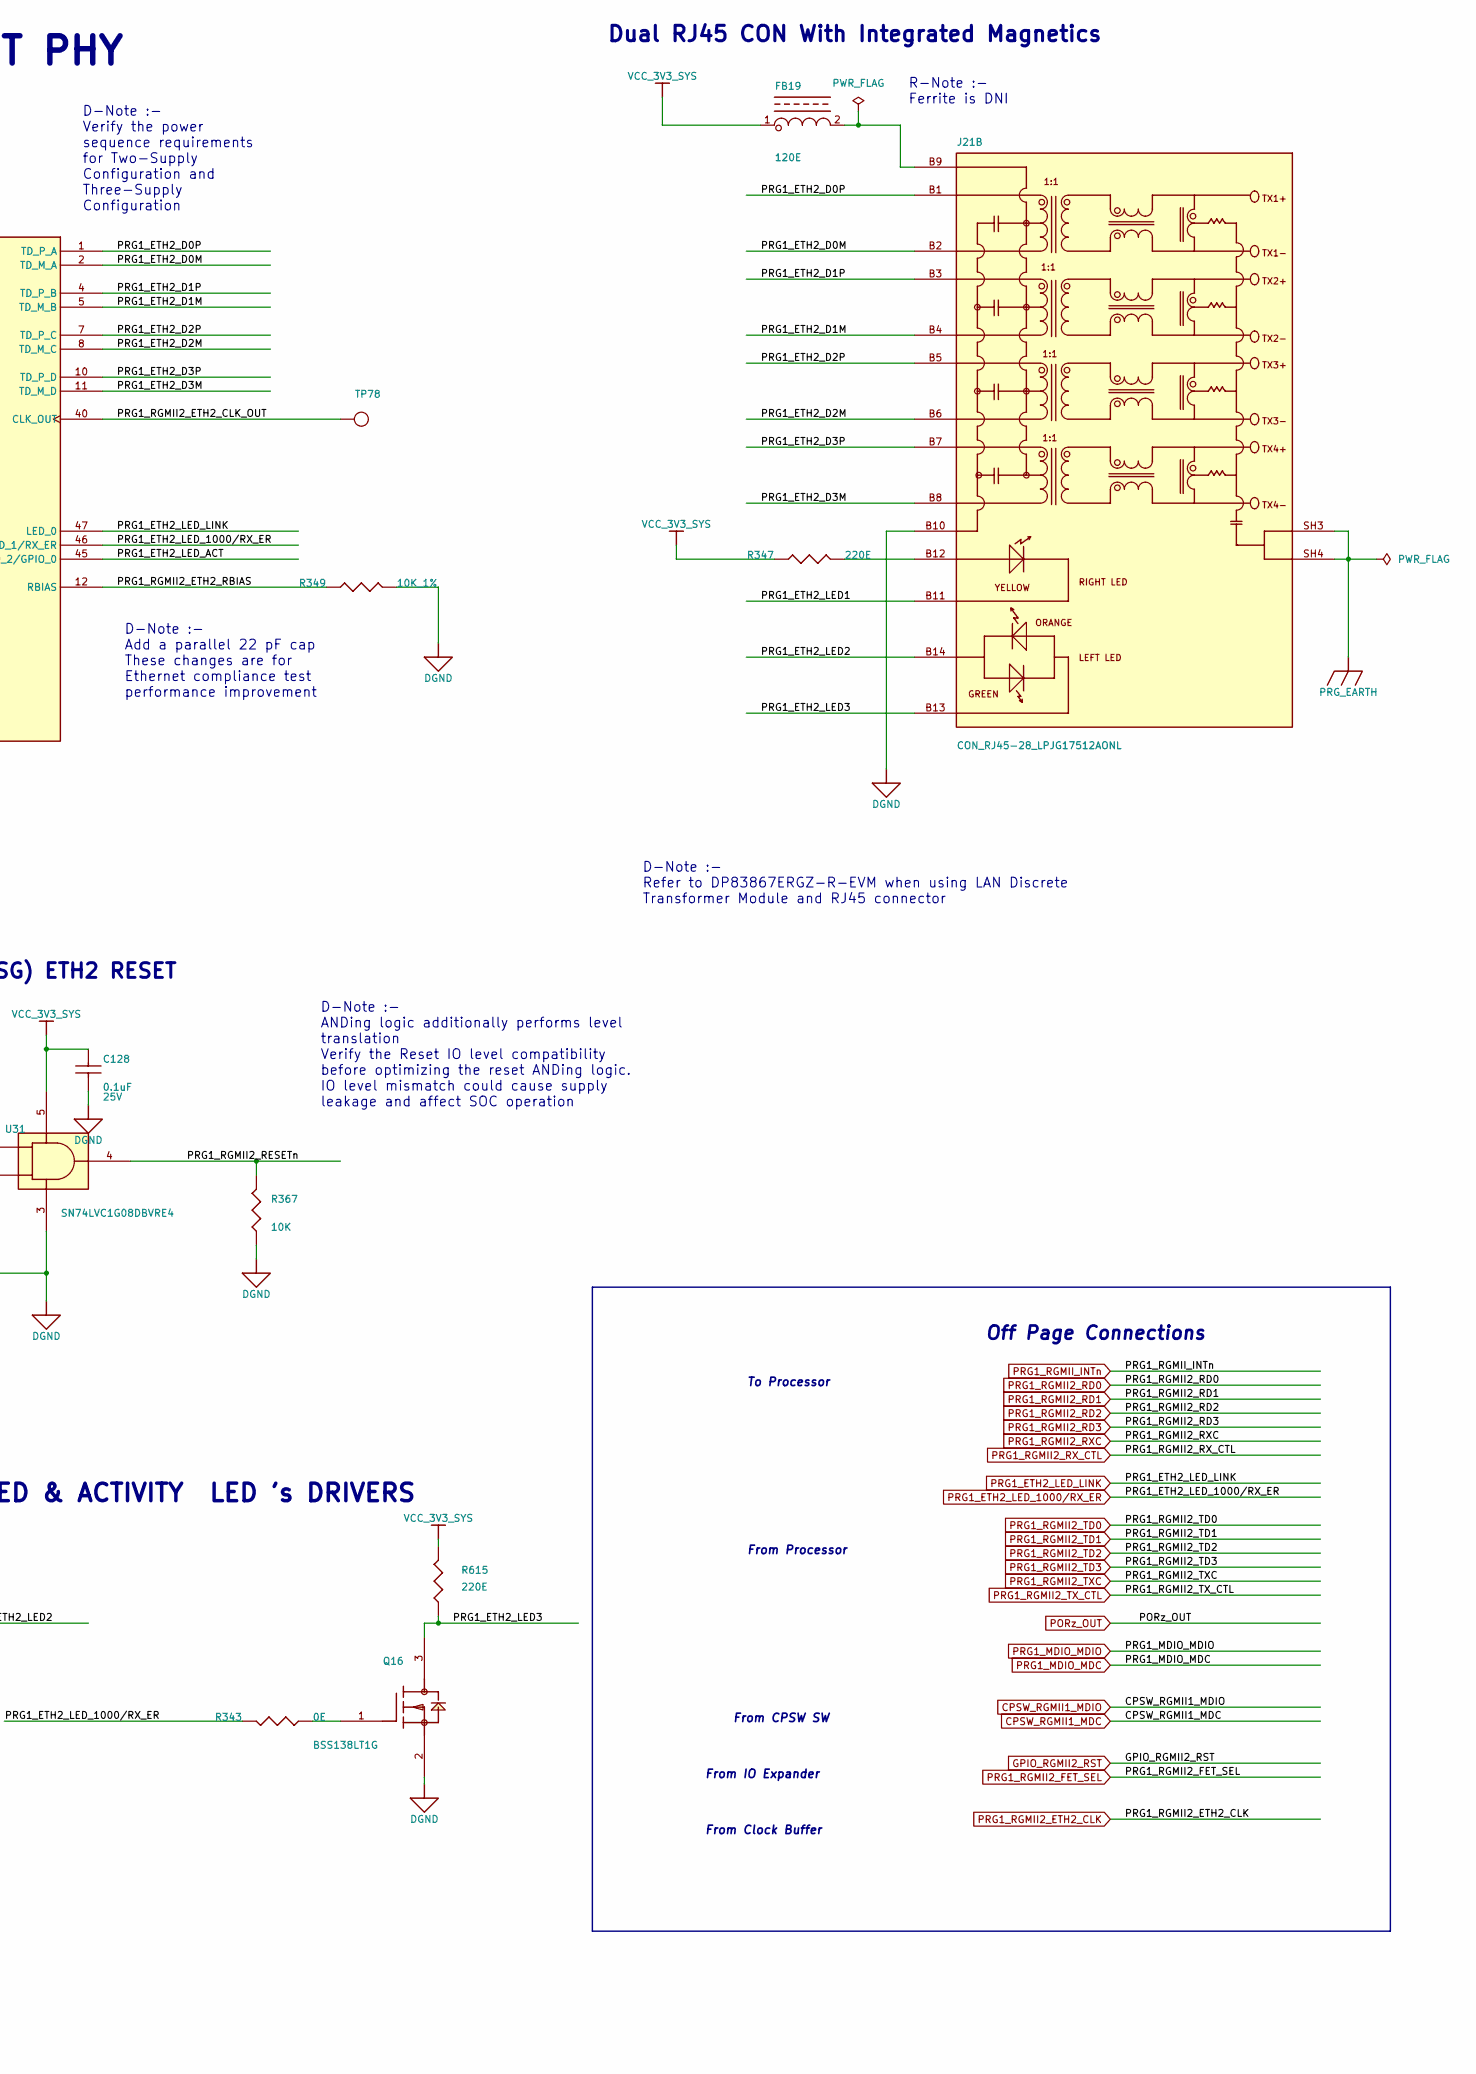
[picture p18: schematic 17.kicad_sch, part in row 1, column 2]

Parts:
C89, C104, C124, C128, C385, C392, C394, C395, C397: 0.1uF; CAP0402_0-75; TOLERANCE 20%; VOLTAGE 25V; MISTRAL PART NO 120020080003-R
C99, C111: 10uF; CAP0402_0-75; VOLTAGE 10V; TOLERANCE 20%; PART_TYPE CAPACITOR~{S}CERAMIC
C101, C106, C110, C112, C114, C389: 1uF; CAP0402_0-75; VOLTAGE 10V; TOLERANCE 20%; PART_TYPE CAPACITOR~{S}CERAMIC
C105: 10uF; CAP0402_0-75; TOLERANCE 20%; VOLTAGE 10V; MISTRAL PART NO 120013110019-R
C401: 1uF; CAP0402_0-75; TOLERANCE 20%; VOLTAGE 10V; MISTRAL PART NO 120020080009-R
FB19: 120E; IND0603_1; TOLERANCE 25%; VOLTAGE NA; MISTRAL PART NO 130020080015-R
J21: CON_RJ45-28_LPJG17512AONL; CON_RJ45-28_LPJG17512_S_R_T_25-3; TOLERANCE NA; VOLTAGE NA; MISTRAL PART NO 150017080001-R
Q14, Q16, Q21: BSS138LT1G; SOT23-123_1-2; TOLERANCE NA; VOLTAGE NA; MISTRAL PART NO 142016040001-R
R120, R367, R380: 10K; RES0402_0-5; TOLERANCE 5%; VOLTAGE NA; MISTRAL PART NO 110011060021-R
R121, R369, R371: 10K; RES0402_0-5; VOLTAGE NA; TOLERANCE 5%; PART_TYPE RESISTOR~{S}FIXED
R126, R128, R341, R359, R366, R386, R388, R563: 2.49K_1%; RES0402_0-5; VOLTAGE NA; TOLERANCE 1%; PART_TYPE RESISTOR~{S}FIXED
R135, R340, R363, R385, R387, R562: 2.49K_1%; RES0402_0-5; TOLERANCE 1%; VOLTAGE NA; MISTRAL PART NO 110016050020-R
R324, R343, R617: 0E; RES0402_0-5; VOLTAGE NA; TOLERANCE NA; PART_TYPE RESISTOR~{S}FIXED
R347: 220E; RES0402_0-5; TOLERANCE 5%; VOLTAGE NA; MISTRAL PART NO 110009030506-R
R349: 10K_1%; RES0402_0-5; VOLTAGE NA; TOLERANCE 1%; PART_TYPE RESISTOR~{S}FIXED
R368: 2.2K; RES0402_0-5; VOLTAGE NA; TOLERANCE 5%; PART_TYPE RESISTOR~{S}FIXED
R370: 1.5K; RES0402_0-5; TOLERANCE 5%; VOLTAGE NA; MISTRAL PART NO 110010120012-R
R615, R616: 220E; RES0402_0-5; VOLTAGE NA; TOLERANCE 5%; MISTRAL PART NO 110009030506-R
TP69: TP20_SMD; TOLERANCE NA; VOLTAGE NA; MISTRAL PART NO NA
TP78: TP20_SMD; VOLTAGE NA; TOLERANCE NA; MISTRAL PART NO NA
U27: TMUX154EDGSR; MSOP10_19-68_120X120_1-1; TOLERANCE NA; VOLTAGE NA; MISTRAL PART NO 140118090001-R
U31: SN74LVC1G08DBVRE4; SOT23-5; PART_TYPE IC~{S}DIGITA~{L}GATES
U80: DP83869HMRGZT; QFN48_19-68_280X280_1_EP4-2; TOLERANCE NA; VOLTAGE NA; MISTRAL PART NO 143019050002-R

Connections:
CPSW_RGMII1_MDC: U27.7 (B1)
CPSW_RGMII1_MDIO: U27.3 (A1)
DGND: C89.2, C99.2, C101.2, C104.2, C105.2, C106.2, C110.2, C111.2, C112.2, C114.2, C124.2, C128.2, C385.2, C389.2, C392.2, C394.2, C395.2, C397.2, C401.2, J21.B10 (GND), Q14.2 (S), Q16.2 (S), Q21.2 (S), R120.2, R121.2, R135.2, R341.2, R349.1, R359.2, R363.2, R367.2, R371.2, R385.2, R386.2, R563.2, U27.5 (GND), U31.3 (GND), U80.49 (GND)
GPIO_RGMII2_RST: R371.1, R380.1, U31.1 (A)
unnamed: FB19.2, J21.B9 (VCC)
unnamed: J21.B12, R347.2
unnamed: Q14.1 (G), R324.2
unnamed: Q16.1 (G), R343.1
unnamed: Q21.1 (G), R617.1
unnamed: TP69.1, U80.13 (VDDA1P8_1), U80.48 (VDDA1P8_2)
PORz_OUT: U31.2 (B)
PRG1_ETH2_D0M: J21.B2 (TD1-_2), U80.2 (TD_M_A)
PRG1_ETH2_D0P: J21.B1 (TD1+_2), U80.1 (TD_P_A)
PRG1_ETH2_D1M: J21.B4 (TD2-_2), U80.5 (TD_M_B)
PRG1_ETH2_D1P: J21.B3 (TD2+_2), U80.4 (TD_P_B)
PRG1_ETH2_D2M: J21.B6 (TD3-_2), U80.8 (TD_M_C)
PRG1_ETH2_D2P: J21.B5 (TD3+_2), U80.7 (TD_P_C)
PRG1_ETH2_D3M: J21.B8 (TD4-_2), U80.11 (TD_M_D)
PRG1_ETH2_D3P: J21.B7 (TD4+_2), U80.10 (TD_P_D)
PRG1_ETH2_GPIO_1: R340.2, R341.1, R617.2, U80.22 (JTAG_TDO/GPIO_1)
PRG1_ETH2_LED1: J21.B11, Q14.3 (D)
PRG1_ETH2_LED2: J21.B14, Q21.3 (D), R616.1
PRG1_ETH2_LED3: J21.B13, Q16.3 (D), R615.1
PRG1_ETH2_LED_1000/RX_ER: R343.2, R386.1, R388.2, U80.46 (LED_1/RX_ER)
PRG1_ETH2_LED_ACT: R324.1, R385.1, R387.2, U80.45 (LED_2/GPIO_0)
PRG1_ETH2_LED_LINK: R562.2, R563.1, U80.47 (LED_0)
PRG1_MDIO_MDC: U27.8 (B0)
PRG1_MDIO_MDIO: U27.2 (A0)
PRG1_RGMII2_ETH2_CLK: U80.20 (XI)
PRG1_RGMII2_ETH2_CLK_OUT: TP78.1, U80.40 (CLK_OUT)
PRG1_RGMII2_ETH2_RBIAS: R349.2, U80.12 (RBIAS)
PRG1_RGMII2_FET_ENn: R121.1, U27.9 (~EN)
PRG1_RGMII2_FET_SEL: R120.1, U27.1 (SEL)
PRG1_RGMII2_MDC: R369.2, U27.6 (B), U80.42 (MDC)
PRG1_RGMII2_MDIO: R370.1, U27.4 (A), U80.41 (MDIO)
PRG1_RGMII2_RD0: R126.2, R359.1, U80.33 (RX_D0)
PRG1_RGMII2_RD1: R128.2, R363.1, U80.34 (RX_D1)
PRG1_RGMII2_RD2: U80.35 (RX_D2)
PRG1_RGMII2_RD3: U80.36 (RX_D3)
PRG1_RGMII2_RESETn: R367.1, U31.4 (Y), U80.43 (RESET_N)
PRG1_RGMII2_RXC: U80.32 (RX_CLK)
PRG1_RGMII2_RX_CTL: R135.1, R366.2, U80.38 (RX_CTRL/RX_DV)
PRG1_RGMII2_TD0: U80.28 (TX_D0)
PRG1_RGMII2_TD1: U80.27 (TX_D1)
PRG1_RGMII2_TD2: U80.26 (TX_D2)
PRG1_RGMII2_TD3: U80.25 (TX_D3)
PRG1_RGMII2_TXC: U80.29 (GTX_CLK/TX_CLK)
PRG1_RGMII2_TX_CTL: U80.37 (TX_CTRL/TX_EN)
PRG1_RGMII_INTn: R368.1, U80.44 (INT_N/PWDN_N)
PRG_EARTH: J21.SH3, J21.SH4
VCC_3V3_SYS: C89.1, C99.1, C101.1, C104.1, C128.1, C385.1, C389.1, FB19.1, R126.1, R128.1, R340.1, R347.1, R366.1, R368.2, R369.1, R370.2, R380.2, R387.1, R388.1, R562.1, R615.2, R616.2, U27.10 (VCC), U31.5 (VCC), U80.18 (VDDIO), U80.30 (VDDIO)
VDD_1V1: C105.1, C110.1, C112.1, C124.1, C394.1, C395.1, C401.1, U80.6 (VDDA1P1), U80.31 (VDD1P1), U80.39 (VDD1P1)
VDD_2V5: C106.1, C111.1, C114.1, C392.1, C397.1, U80.3 (VDDA2P5), U80.9 (VDDA2P5)

Notes on the sheet:
A = A1 B = B1
D-Note :- Verify the power sequence requirements for Two-Supply Configuration and Three-Supply Configuration
D-Note :- Refer to DP83867ERGZ-R-EVM when using LAN Discrete Transformer Module and RJ45 connector
D-Note :- ANDing logic additionally performs level translation Verify the Reset IO level compatibility before optimizing the reset ANDing logic. IO level mismatch could cause supply leakage and affect SOC operation
R-Note :- Ferrite is DNI
D-Note :- The caps and values used are as per the EPHY data sheet recommendations
A = A0 B = B0
D-Note :- Add an isolation resistor (0R) to SoC GPIO for debug and testing
D-Note :- Add a parallel 22 pF cap These changes are for Ethernet compliance test performance improvement
D-Note :- Add 10 nF cap for each supply rail Refer EPHY data sheet
D-Note :- VDDA1P8 These are LDO outputs Do not short. Add individual TPs for testing
RGMII to Copper (1000BaseT/100Base-TX/10Base-Te)
PRG1 MDC/MDIO FET SWITCH
Decaps
TMUX154EDGSR Truth Table
STRAPPING RESISTORS
From Clock Buffer
Off Page Connections
From IO Expander
Dual RJ45 CON With Integrated Magnetics
PRG1_ETHERNET - 2 SPEED & ACTIVITY LED 's DRIVERS
From CPSW SW
To Processor
ICSSG RGMII 2 - ETHERNET PHY
Auto-negotiation, 10/100/1000 advertised, Auto-MDI-X
SEL
FUNCTION
PHY ADDRESS = 00011
From Processor
PRG1 (ICSSG) ETH2 RESET
Disconnet
