gingerologist/am64x/18.kicad_sch

## KiCad design 18.kicad_sch (2024-07-26)

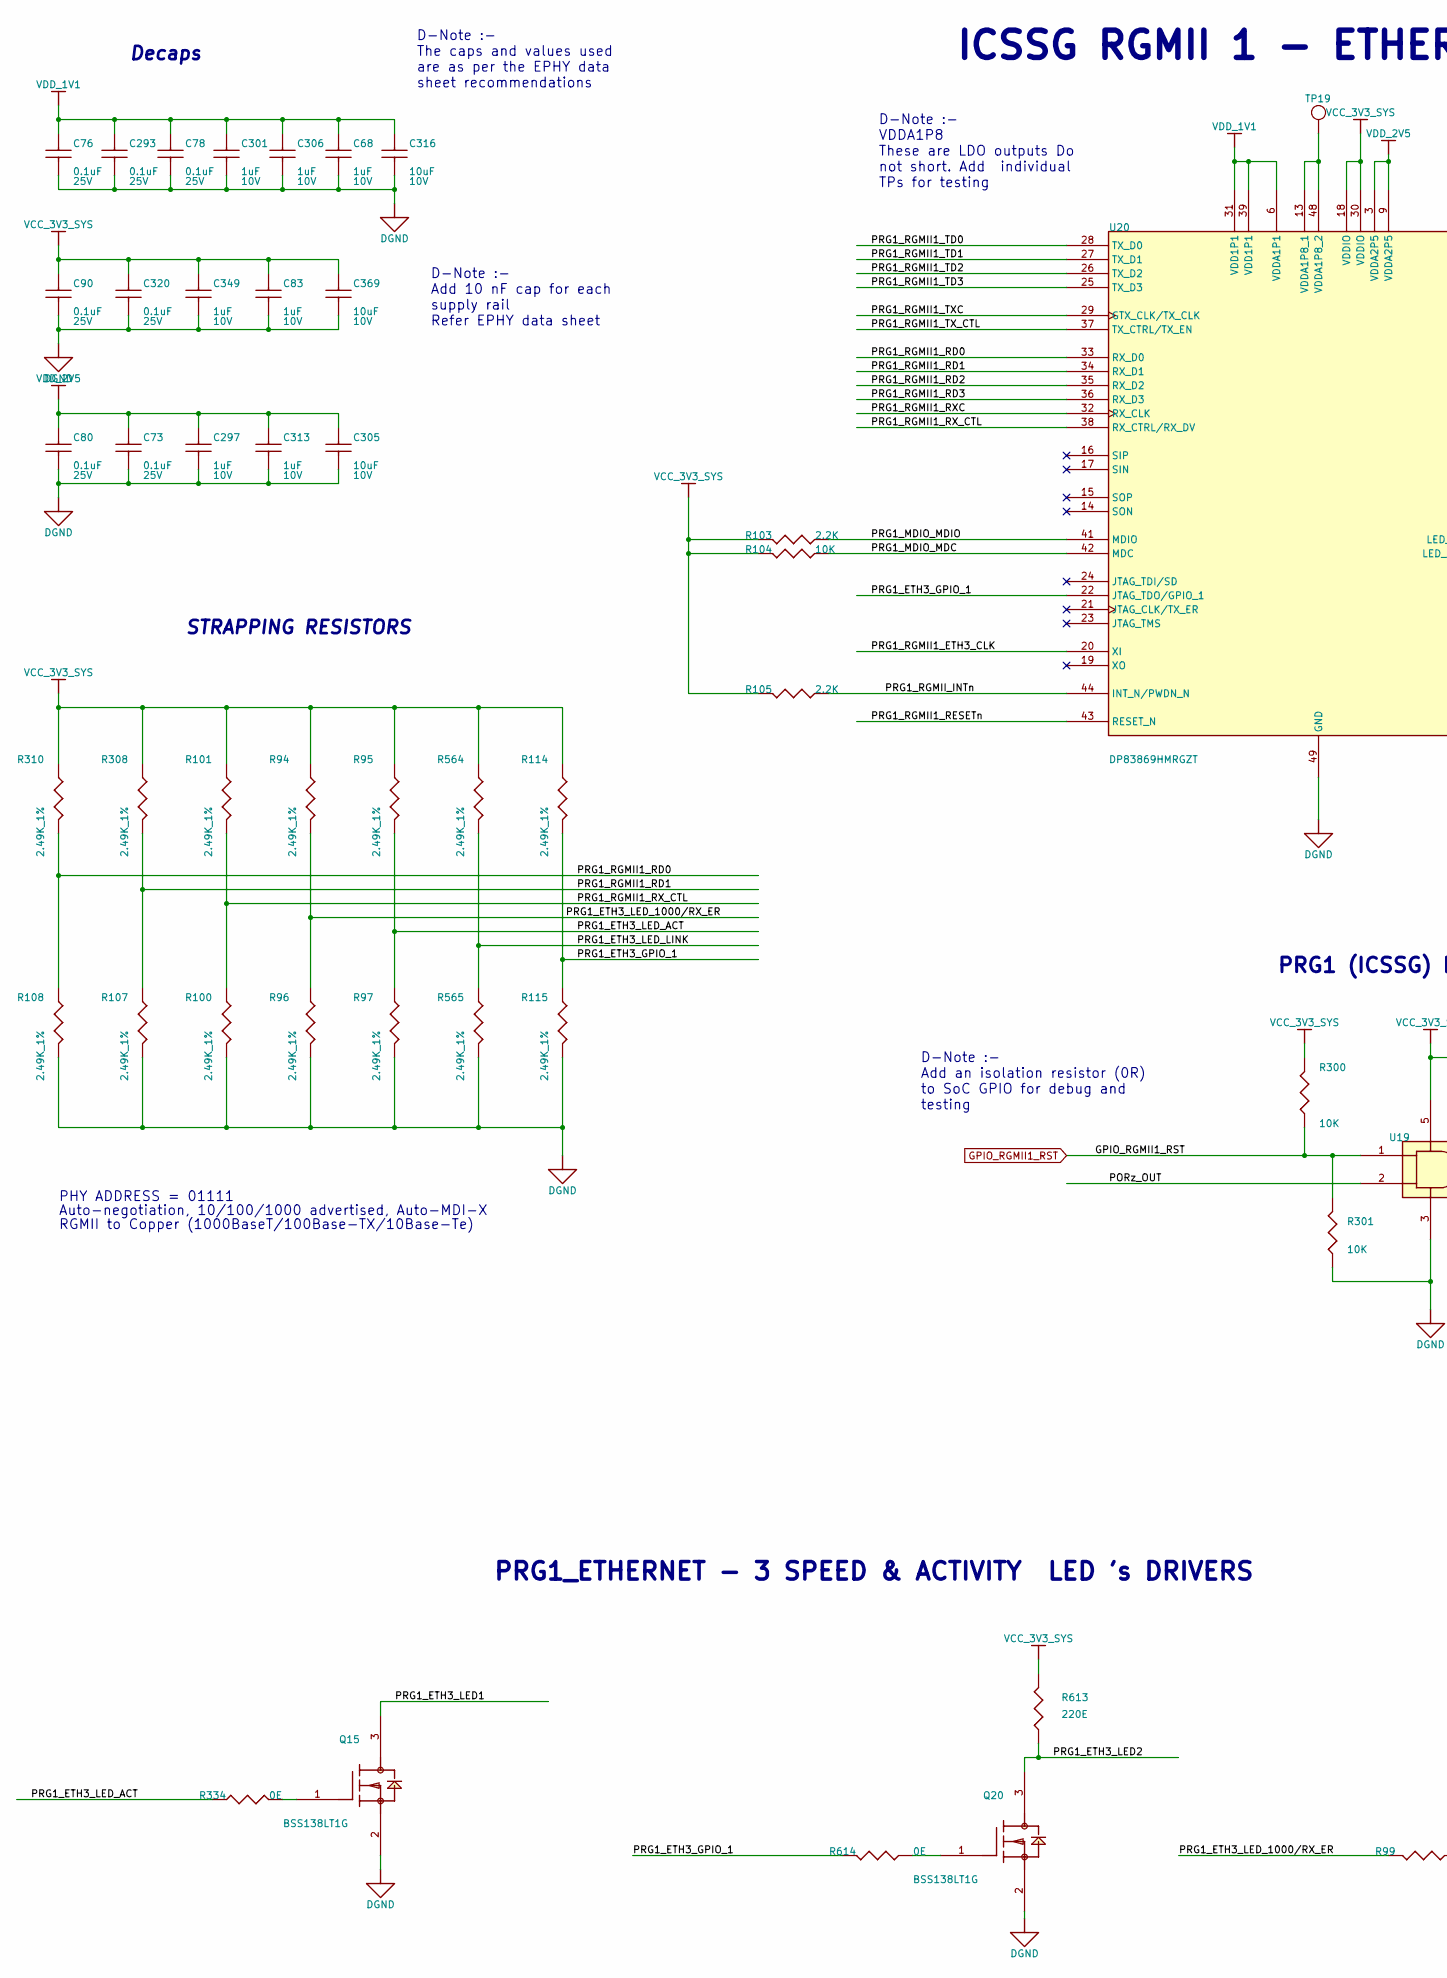
[picture p19: schematic 18.kicad_sch, part in row 1, column 1]

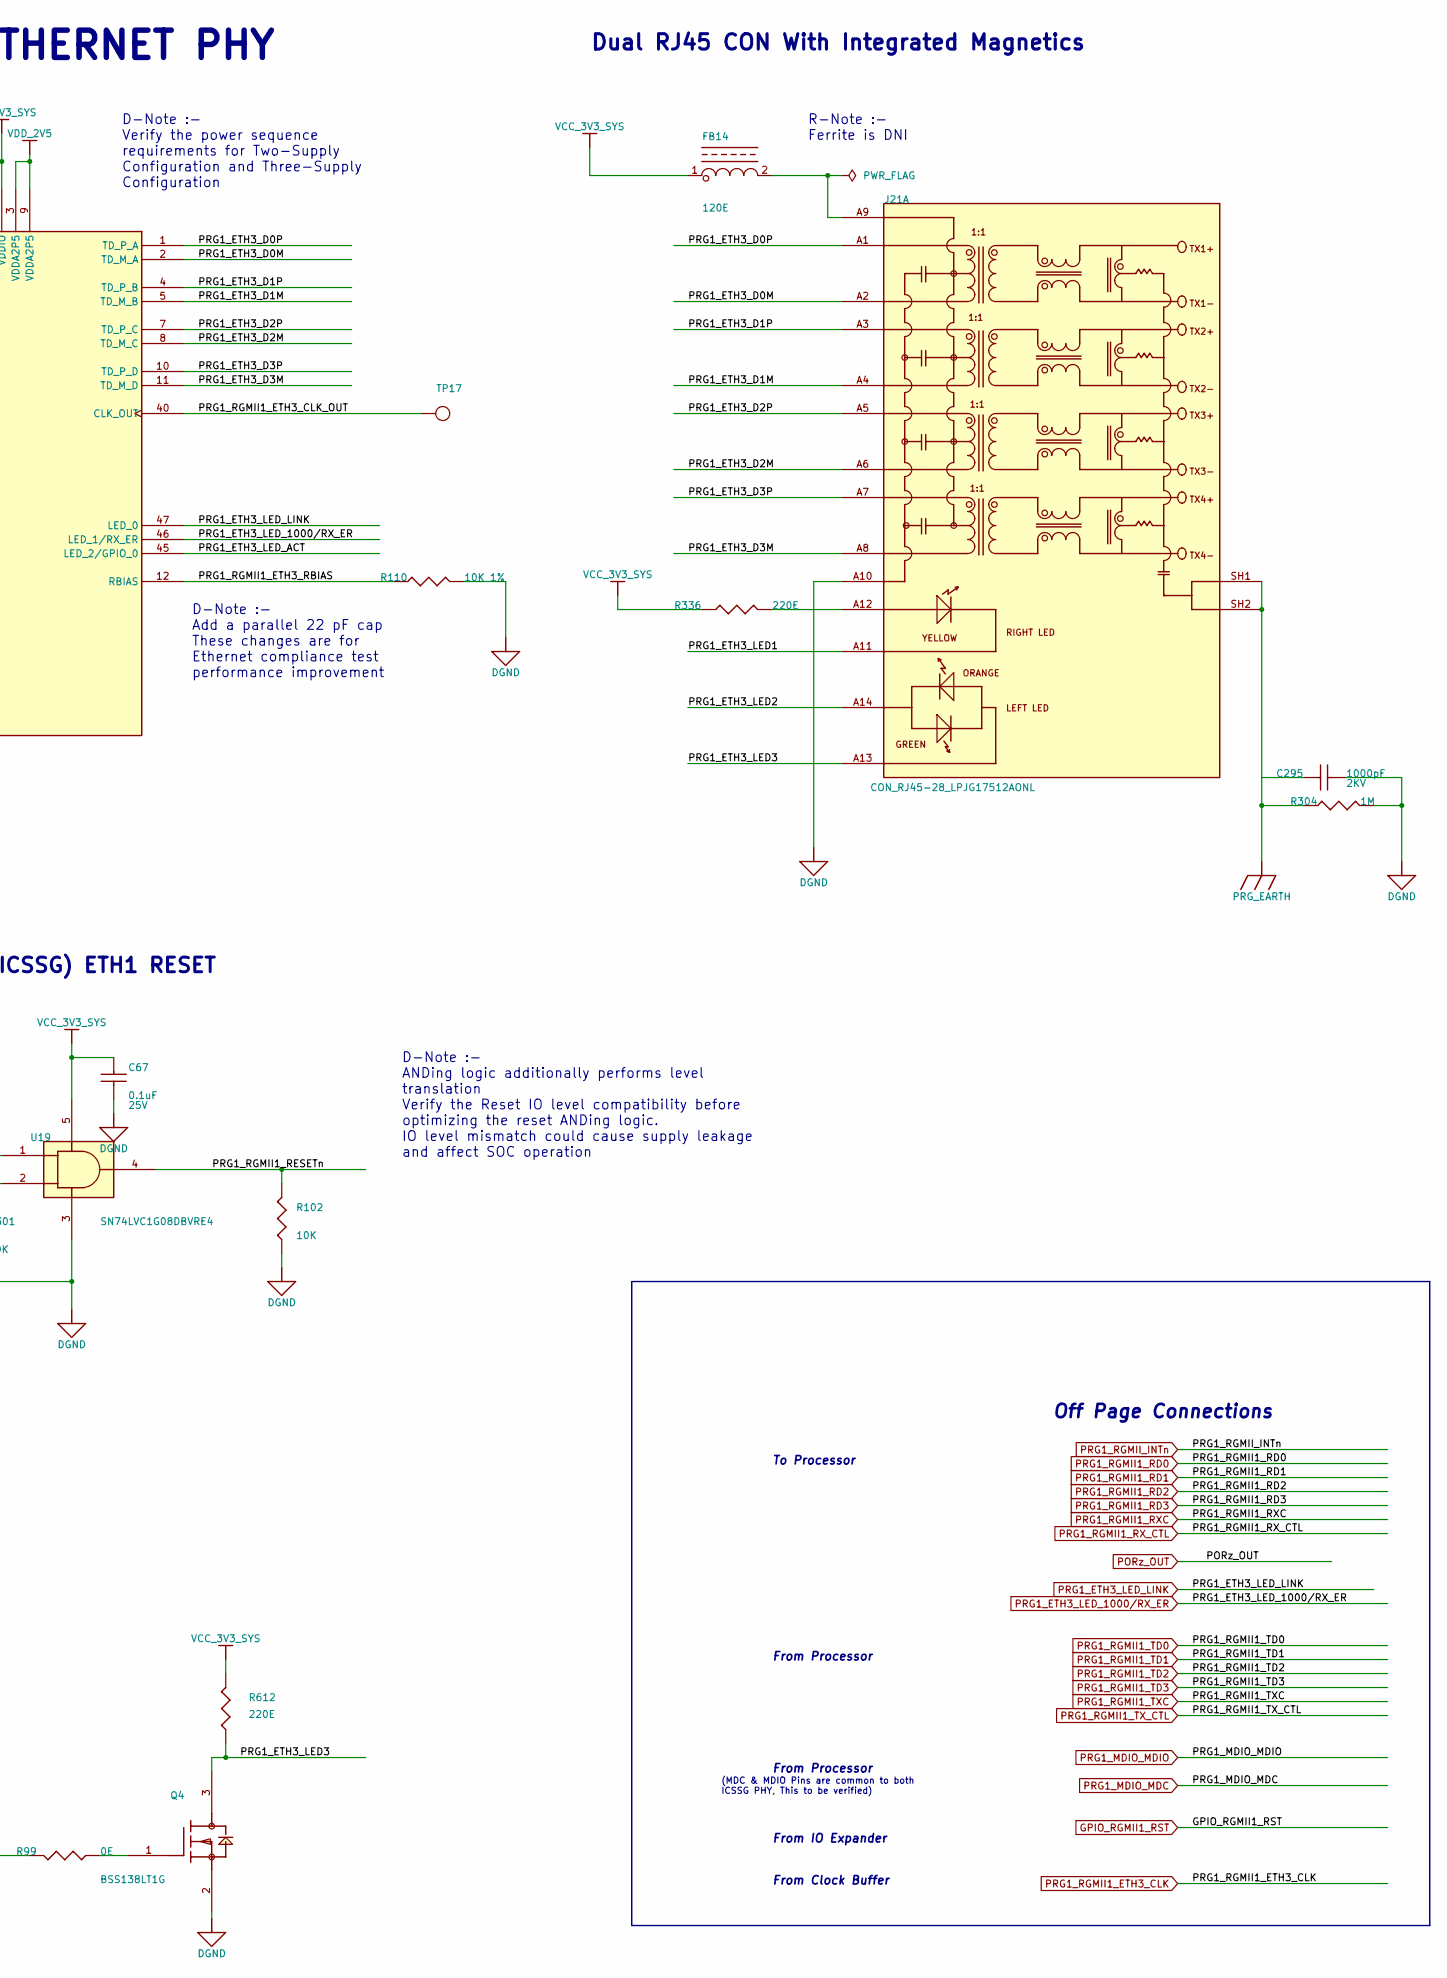
[picture p20: schematic 18.kicad_sch, part in row 1, column 2]

Parts:
C67, C73, C76, C78, C80, C90, C293, C320: 0.1uF; CAP0402_0-75; VOLTAGE 25V; TOLERANCE 20%; PART_TYPE CAPACITOR~{S}CERAMIC
C68, C297, C301, C313, C349: 1uF; CAP0402_0-75; VOLTAGE 10V; TOLERANCE 20%; PART_TYPE CAPACITOR~{S}CERAMIC
C83, C306: 1uF; CAP0402_0-75; TOLERANCE 20%; VOLTAGE 10V; MISTRAL PART NO 120020080009-R
C295: 1000pF; CAP1206_1-75; TOLERANCE 10%; VOLTAGE 2KV; MISTRAL PART NO 120015080006-R
C305, C369: 10uF; CAP0402_0-75; VOLTAGE 10V; TOLERANCE 20%; PART_TYPE CAPACITOR~{S}CERAMIC
C316: 10uF; CAP0402_0-75; TOLERANCE 20%; VOLTAGE 10V; MISTRAL PART NO 120013110019-R
FB14: 120E; IND0603_1; TOLERANCE 25%; VOLTAGE NA; MISTRAL PART NO 130020080015-R
J21: CON_RJ45-28_LPJG17512AONL; CON_RJ45-28_LPJG17512_S_R_T_25-3; TOLERANCE NA; VOLTAGE NA; MISTRAL PART NO 150017080001-R
Q4, Q15, Q20: BSS138LT1G; SOT23-123_1-2; TOLERANCE NA; VOLTAGE NA; MISTRAL PART NO 142016040001-R
R94, R97, R115, R308, R310, R564, R565: 2.49K_1%; RES0402_0-5; TOLERANCE 1%; VOLTAGE NA; MISTRAL PART NO 110016050020-R
R95, R96, R100, R101, R107, R108, R114: 2.49K_1%; RES0402_0-5; VOLTAGE NA; TOLERANCE 1%; PART_TYPE RESISTOR~{S}FIXED
R99, R614: 0E; RES0402_0-5; TOLERANCE NA; VOLTAGE NA; MISTRAL PART NO 110010080019-R
R102, R104, R300: 10K; RES0402_0-5; TOLERANCE 5%; VOLTAGE NA; MISTRAL PART NO 110011060021-R
R103, R105: 2.2K; RES0402_0-5; TOLERANCE 5%; VOLTAGE NA; MISTRAL PART NO 110010120018-R
R110: 10K_1%; RES0402_0-5; VOLTAGE NA; TOLERANCE 1%; PART_TYPE RESISTOR~{S}FIXED
R301: 10K; RES0402_0-5; VOLTAGE NA; TOLERANCE 5%; PART_TYPE RESISTOR~{S}FIXED
R304: 1M; RES0603_0-75; TOLERANCE 5%; VOLTAGE NA; MISTRAL PART NO 110009030413-R
R334: 0E; RES0402_0-5; VOLTAGE NA; TOLERANCE NA; PART_TYPE RESISTOR~{S}FIXED
R336: 220E; RES0402_0-5; TOLERANCE 5%; VOLTAGE NA; MISTRAL PART NO 110009030506-R
R612, R613: 220E; RES0402_0-5; TOLERANCE 5%; VOLTAGE NA; PART_TYPE RESISTOR~{S}FIXED
TP17: TP20_SMD; VOLTAGE NA; TOLERANCE NA; MISTRAL PART NO NA
TP19: TP20_SMD; TOLERANCE NA; VOLTAGE NA; MISTRAL PART NO NA
U19: SN74LVC1G08DBVRE4; SOT23-5; PART_TYPE IC~{S}DIGITA~{L}GATES
U20: DP83869HMRGZT; QFN48_19-68_280X280_1_EP4-2; TOLERANCE NA; VOLTAGE NA; MISTRAL PART NO 143019050002-R

Connections:
DGND: C67.2, C68.2, C73.2, C76.2, C78.2, C80.2, C83.2, C90.2, C293.2, C295.2, C297.2, C301.2, C305.2, C306.2, C313.2, C316.2, C320.2, C349.2, C369.2, J21.A10 (GND), Q4.2 (S), Q15.2 (S), Q20.2 (S), R96.2, R97.2, R100.2, R102.2, R107.2, R108.2, R110.1, R115.2, R301.2, R304.2, R565.2, U19.3 (GND), U20.49 (GND)
GPIO_RGMII1_RST: R300.1, R301.1, U19.1 (A)
unnamed: FB14.2, J21.A9 (VCC)
unnamed: J21.A12, R336.2
unnamed: Q4.1 (G), R99.1
unnamed: Q15.1 (G), R334.2
unnamed: Q20.1 (G), R614.1
unnamed: TP19.1, U20.13 (VDDA1P8_1), U20.48 (VDDA1P8_2)
PORz_OUT: U19.2 (B)
PRG1_ETH3_D0M: J21.A2 (TD1-_1), U20.2 (TD_M_A)
PRG1_ETH3_D0P: J21.A1 (TD1+_1), U20.1 (TD_P_A)
PRG1_ETH3_D1M: J21.A4 (TD2-_1), U20.5 (TD_M_B)
PRG1_ETH3_D1P: J21.A3 (TD2+_1), U20.4 (TD_P_B)
PRG1_ETH3_D2M: J21.A6 (TD3-_1), U20.8 (TD_M_C)
PRG1_ETH3_D2P: J21.A5 (TD3+_1), U20.7 (TD_P_C)
PRG1_ETH3_D3M: J21.A8 (TD4-_1), U20.11 (TD_M_D)
PRG1_ETH3_D3P: J21.A7 (TD4+_1), U20.10 (TD_P_D)
PRG1_ETH3_GPIO_1: R114.2, R115.1, R614.2, U20.22 (JTAG_TDO/GPIO_1)
PRG1_ETH3_LED1: J21.A11, Q15.3 (D)
PRG1_ETH3_LED2: J21.A14, Q20.3 (D), R613.1
PRG1_ETH3_LED3: J21.A13, Q4.3 (D), R612.1
PRG1_ETH3_LED_1000/RX_ER: R94.2, R96.1, R99.2, U20.46 (LED_1/RX_ER)
PRG1_ETH3_LED_ACT: R95.2, R97.1, R334.1, U20.45 (LED_2/GPIO_0)
PRG1_ETH3_LED_LINK: R564.2, R565.1, U20.47 (LED_0)
PRG1_MDIO_MDC: R104.2, U20.42 (MDC)
PRG1_MDIO_MDIO: R103.1, U20.41 (MDIO)
PRG1_RGMII1_ETH3_CLK: U20.20 (XI)
PRG1_RGMII1_ETH3_CLK_OUT: TP17.1, U20.40 (CLK_OUT)
PRG1_RGMII1_ETH3_RBIAS: R110.2, U20.12 (RBIAS)
PRG1_RGMII1_RD0: R108.1, R310.2, U20.33 (RX_D0)
PRG1_RGMII1_RD1: R107.1, R308.2, U20.34 (RX_D1)
PRG1_RGMII1_RD2: U20.35 (RX_D2)
PRG1_RGMII1_RD3: U20.36 (RX_D3)
PRG1_RGMII1_RESETn: R102.1, U19.4 (Y), U20.43 (RESET_N)
PRG1_RGMII1_RXC: U20.32 (RX_CLK)
PRG1_RGMII1_RX_CTL: R100.1, R101.2, U20.38 (RX_CTRL/RX_DV)
PRG1_RGMII1_TD0: U20.28 (TX_D0)
PRG1_RGMII1_TD1: U20.27 (TX_D1)
PRG1_RGMII1_TD2: U20.26 (TX_D2)
PRG1_RGMII1_TD3: U20.25 (TX_D3)
PRG1_RGMII1_TXC: U20.29 (GTX_CLK/TX_CLK)
PRG1_RGMII1_TX_CTL: U20.37 (TX_CTRL/TX_EN)
PRG1_RGMII_INTn: R105.1, U20.44 (INT_N/PWDN_N)
PRG_EARTH: C295.1, J21.SH1, J21.SH2, R304.1
VCC_3V3_SYS: C67.1, C83.1, C90.1, C320.1, C349.1, C369.1, FB14.1, R94.1, R95.1, R101.1, R103.2, R104.1, R105.2, R114.1, R300.2, R308.1, R310.1, R336.1, R564.1, R612.2, R613.2, U19.5 (VCC), U20.18 (VDDIO), U20.30 (VDDIO)
VDD_1V1: C68.1, C76.1, C78.1, C293.1, C301.1, C306.1, C316.1, U20.6 (VDDA1P1), U20.31 (VDD1P1), U20.39 (VDD1P1)
VDD_2V5: C73.1, C80.1, C297.1, C305.1, C313.1, U20.3 (VDDA2P5), U20.9 (VDDA2P5)

Notes on the sheet:
D-Note :- The caps and values used are as per the EPHY data sheet recommendations
D-Note :- Verify the power sequence requirements for Two-Supply Configuration and Three-Supply Configuration
R-Note :- Ferrite is DNI
D-Note :- VDDA1P8 These are LDO outputs Do not short. Add individual TPs for testing
D-Note :- ANDing logic additionally performs level translation Verify the Reset IO level compatibility before optimizing the reset ANDing logic. IO level mismatch could cause supply leakage and affect SOC operation
D-Note :- Add 10 nF cap for each supply rail Refer EPHY data sheet
D-Note :- Add a parallel 22 pF cap These changes are for Ethernet compliance test performance improvement
D-Note :- Add an isolation resistor (0R) to SoC GPIO for debug and testing
(MDC & MDIO Pins are common to both ICSSG PHY, This to be verified)
To Processor
Auto-negotiation, 10/100/1000 advertised, Auto-MDI-X
From Processor
RGMII to Copper (1000BaseT/100Base-TX/10Base-Te)
ICSSG RGMII 1 - ETHERNET PHY
PRG1_ETHERNET - 3 SPEED & ACTIVITY LED 's DRIVERS
PHY ADDRESS = 01111
Dual RJ45 CON With Integrated Magnetics
PRG1 (ICSSG) ETH1 RESET
From IO Expander
Decaps
From Clock Buffer
Off Page Connections
STRAPPING RESISTORS
