gingerologist/am64x/19.kicad_sch

## KiCad design 19.kicad_sch (2024-07-28)

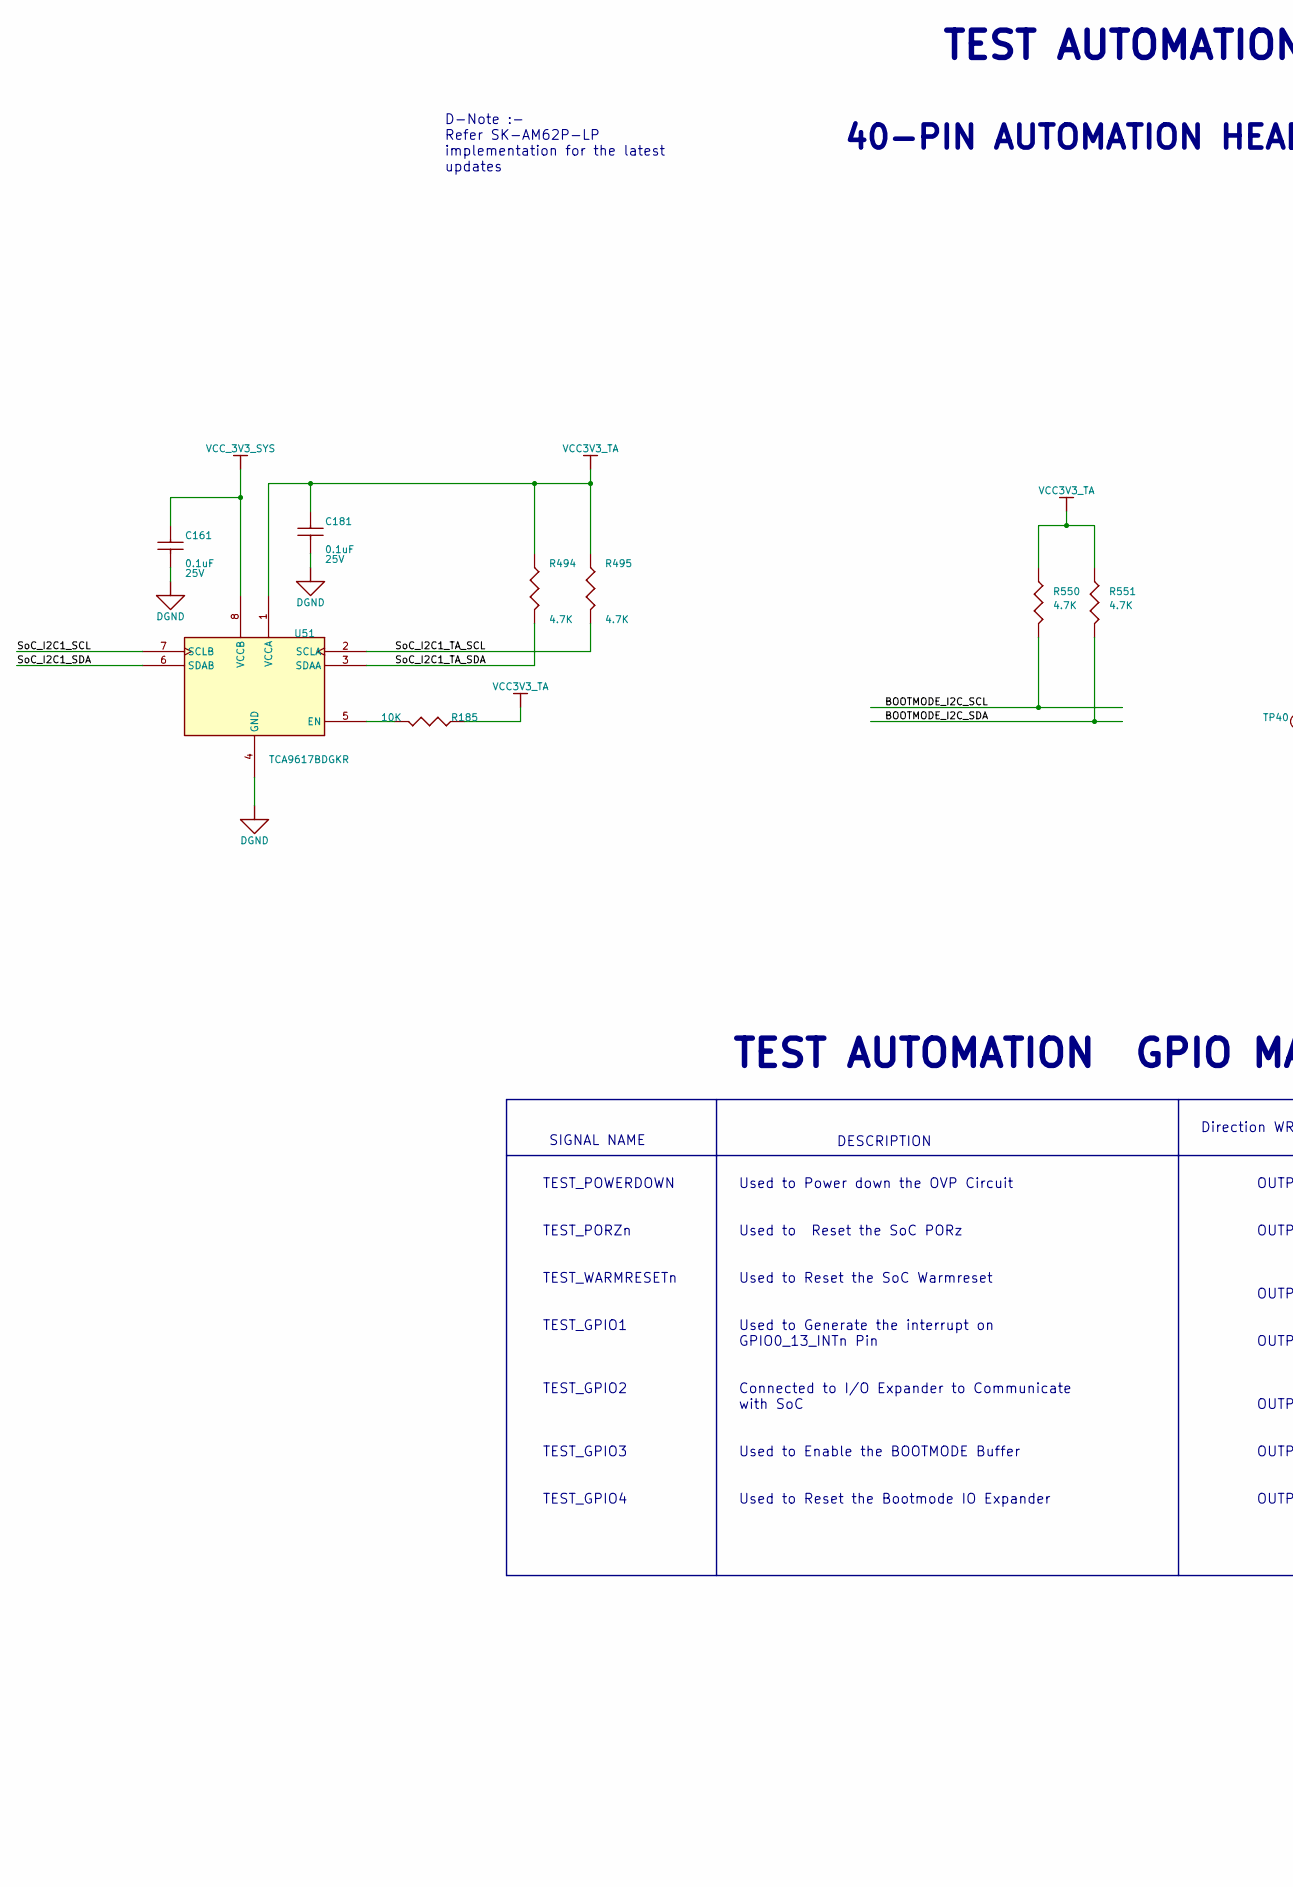
[picture p21: schematic 19.kicad_sch, part in row 1, column 1]

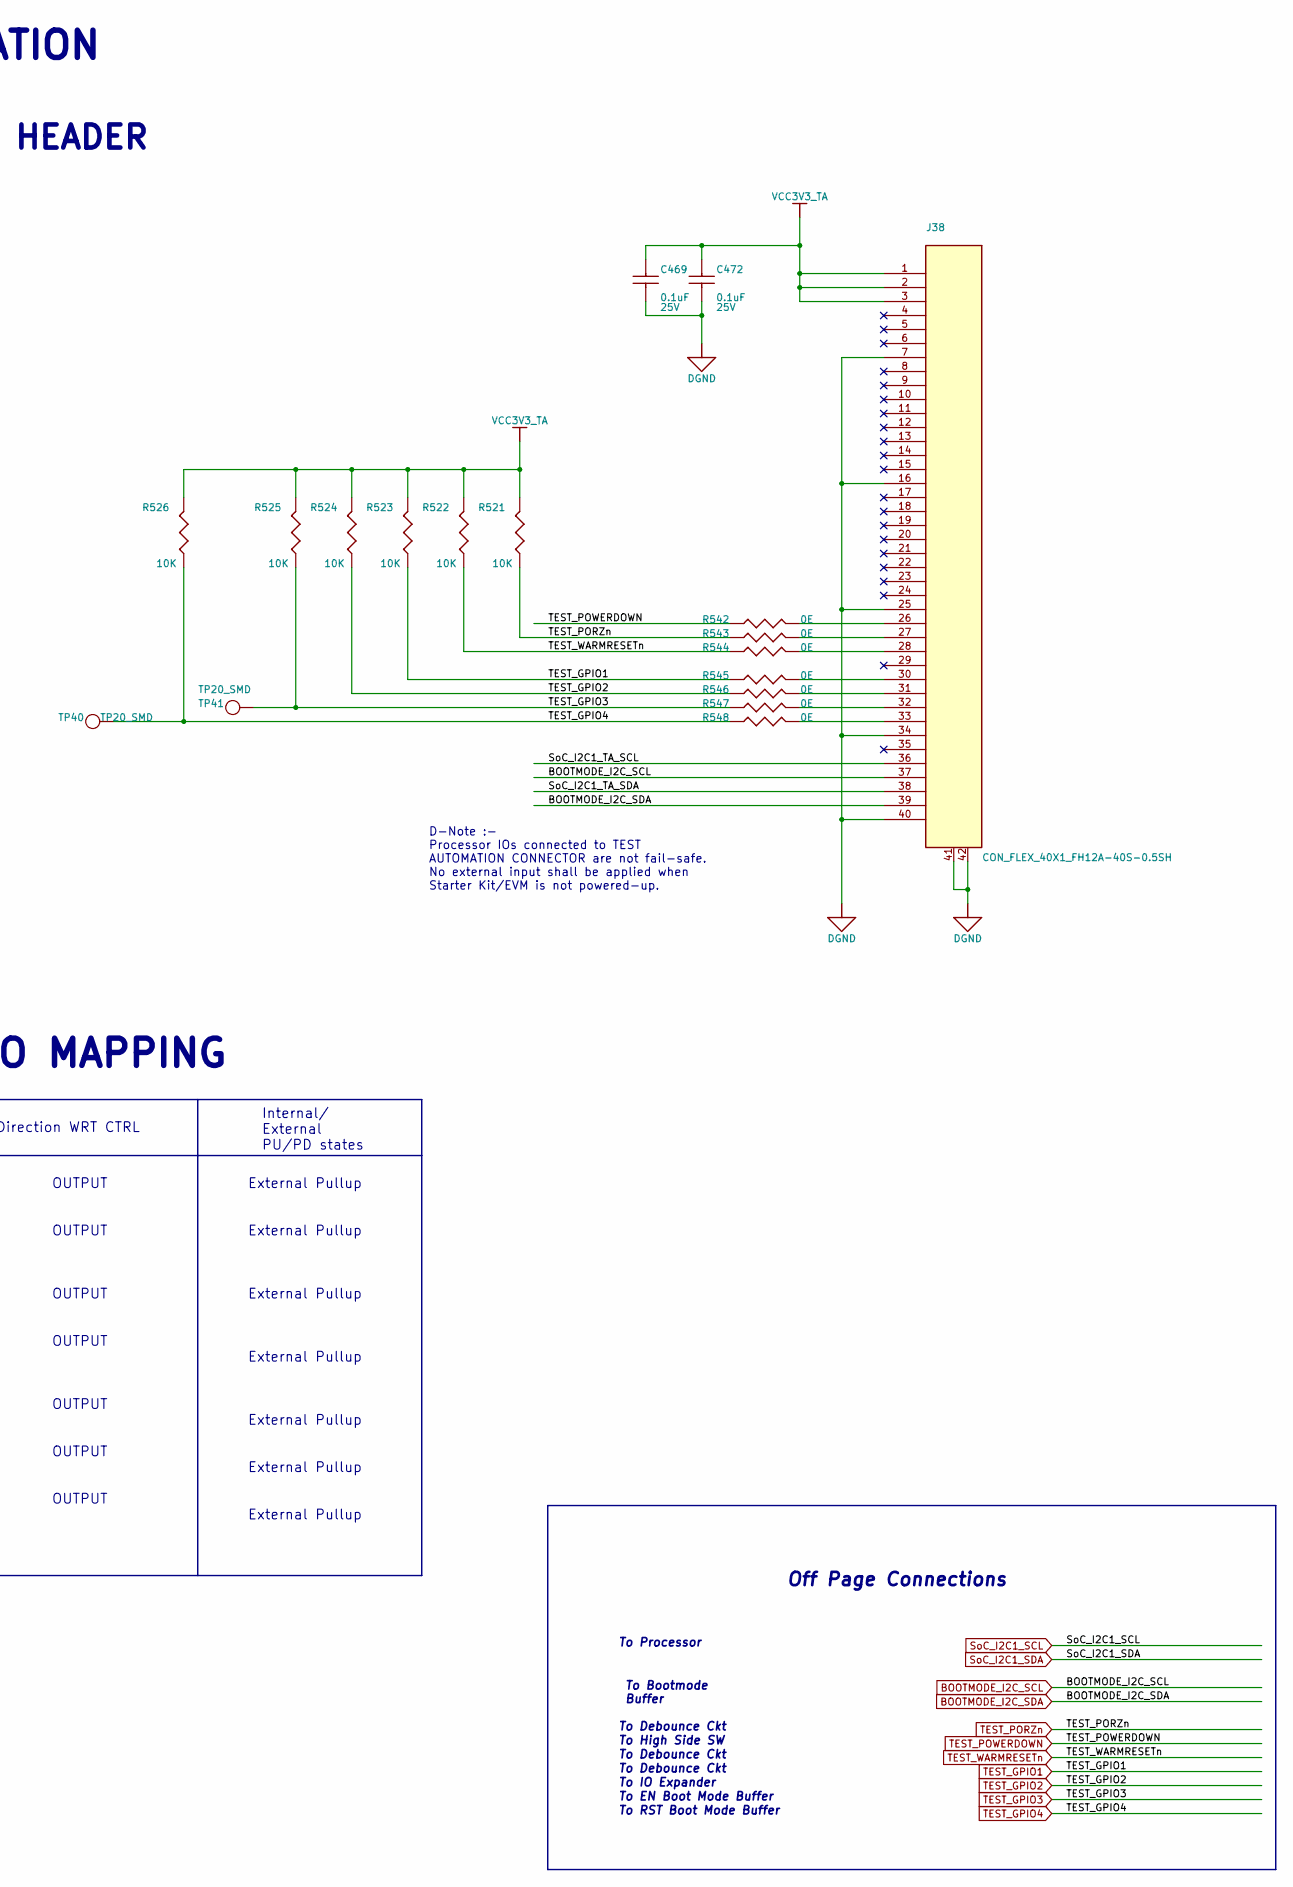
[picture p22: schematic 19.kicad_sch, part in row 1, column 2]

Parts:
C161, C469, C472: 0.1uF; CAP0402_0-75; TOLERANCE 20%; VOLTAGE 25V; MISTRAL PART NO 120020080003-R
C181: 0.1uF; CAP0402_0-75; VOLTAGE 25V; TOLERANCE 20%; PART_TYPE CAPACITOR~{S}CERAMIC
J38: CON_FLEX_40X1_FH12A-40S-0.5SH; CON_FLEX40X1_FH12A_S_R_S; MISTRAL PART NO 150009030176-R
R185, R526: 10K; RES0402_0-5; VOLTAGE NA; TOLERANCE 5%; PART_TYPE RESISTOR~{S}FIXED
R494, R495, R550, R551: 4.7K; RES0402_0-5; TOLERANCE 5%; VOLTAGE NA; MISTRAL PART NO 110011060001-R
R521, R522, R523, R524, R525: 10K; RES0402_0-5; TOLERANCE 5%; VOLTAGE NA; MISTRAL PART NO 110011060021-R
R542, R544, R545, R546, R548: 0E; RES0402_0-5; VOLTAGE NA; TOLERANCE NA; PART_TYPE RESISTOR~{S}FIXED
R543, R547: 0E; RES0402_0-5; TOLERANCE NA; VOLTAGE NA; MISTRAL PART NO 110010080019-R
TP40, TP41: TP20_SMD; TOLERANCE NA; VOLTAGE NA; MISTRAL PART NO NA
U51: TCA9617BDGKR; VSSOP8_25-59_120X120_1-1; TOLERANCE NA; VOLTAGE NA; MISTRAL PART NO 141017100010-R

Connections:
BOOTMODE_I2C_SCL: J38.37, R550.2
BOOTMODE_I2C_SDA: J38.39, R551.2
DGND: C161.2, C181.2, C469.2, C472.2, J38.7, J38.16, J38.25, J38.34, J38.40, J38.41, J38.42, U51.4 (GND)
unnamed: J38.26, R542.2
unnamed: J38.27, R543.2
unnamed: J38.28, R544.2
unnamed: J38.30, R545.2
unnamed: J38.31, R546.2
unnamed: J38.32, R547.2
unnamed: J38.33, R548.2
unnamed: R185.1, U51.5 (EN)
SoC_I2C1_SCL: U51.7 (SCLB)
SoC_I2C1_SDA: U51.6 (SDAB)
SoC_I2C1_TA_SCL: J38.36, R495.2, U51.2 (SCLA)
SoC_I2C1_TA_SDA: J38.38, R494.2, U51.3 (SDAA)
TEST_GPIO1: R523.1, R545.1
TEST_GPIO2: R524.1, R546.1
TEST_GPIO3: R525.1, R547.1, TP41.1
TEST_GPIO4: R526.1, R548.1, TP40.1
TEST_PORZn: R521.1, R543.1
TEST_POWERDOWN: R542.1
TEST_WARMRESETn: R522.1, R544.1
VCC3V3_TA: C181.1, C469.1, C472.1, J38.1, J38.2, J38.3, R185.2, R494.1, R495.1, R521.2, R522.2, R523.2, R524.2, R525.2, R526.2, R550.1, R551.1, U51.1 (VCCA)
VCC_3V3_SYS: C161.1, U51.8 (VCCB)

Notes on the sheet:
OUTPUT OUTPUT OUTPUT OUTPUT OUTPUT OUTPUT OUTPUT
Internal/ External PU/PD states
TEST_POWERDOWN TEST_PORZn TEST_WARMRESETn TEST_GPIO1 TEST_GPIO2 TEST_GPIO3 TEST_GPIO4
To Bootmode Buffer
Used to Power down the OVP Circuit Used to Reset the SoC PORz Used to Reset the SoC Warmreset Used to Generate the interrupt on GPIO0_13_INTn Pin Connected to I/O Expander to Communicate with SoC Used to Enable the BOOTMODE Buffer Used to Reset the Bootmode IO Expander
D-Note :- Refer SK-AM62P-LP implementation for the latest updates
External Pullup External Pullup External Pullup External Pullup External Pullup External Pullup External Pullup
D-Note :- Processor IOs connected to TEST AUTOMATION CONNECTOR are not fail-safe. No external input shall be applied when Starter Kit/EVM is not powered-up.
Direction WRT CTRL
DESCRIPTION
Off Page Connections
40-PIN AUTOMATION HEADER
To RST Boot Mode Buffer
To Processor
To Debounce Ckt
TEST AUTOMATION
To IO Expander
To EN Boot Mode Buffer
TEST AUTOMATION GPIO MAPPING
To High Side SW
SIGNAL NAME
