gingerologist/am64x/20.kicad_sch

## KiCad design 20.kicad_sch (2024-08-05)

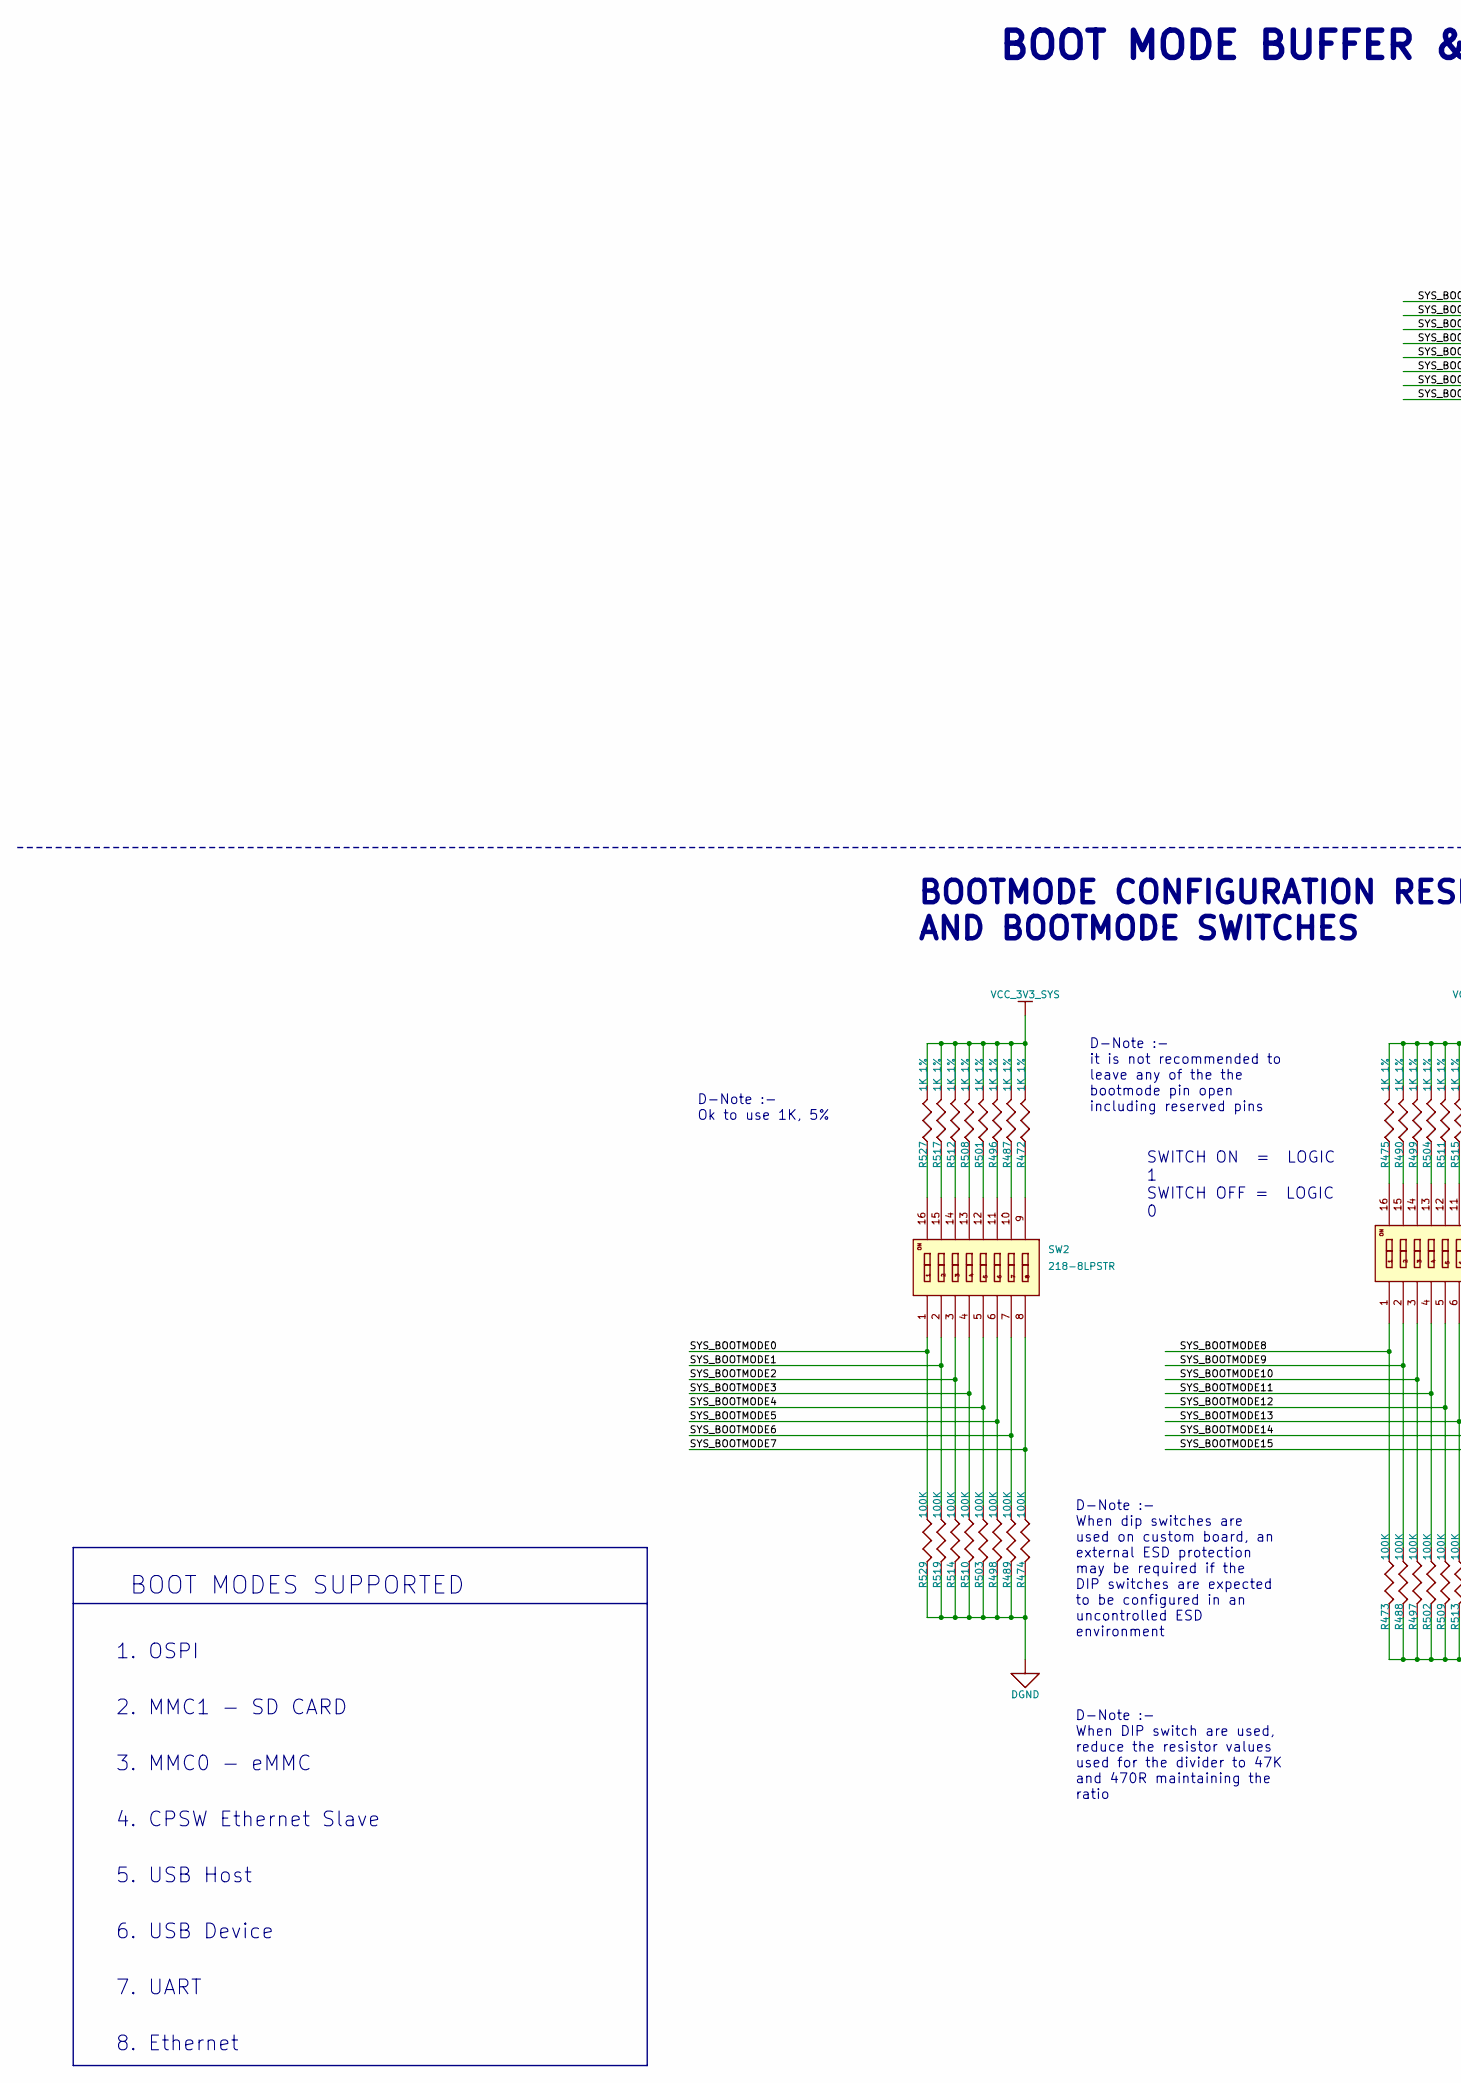
[picture p23: schematic 20.kicad_sch, part in row 1, column 1]

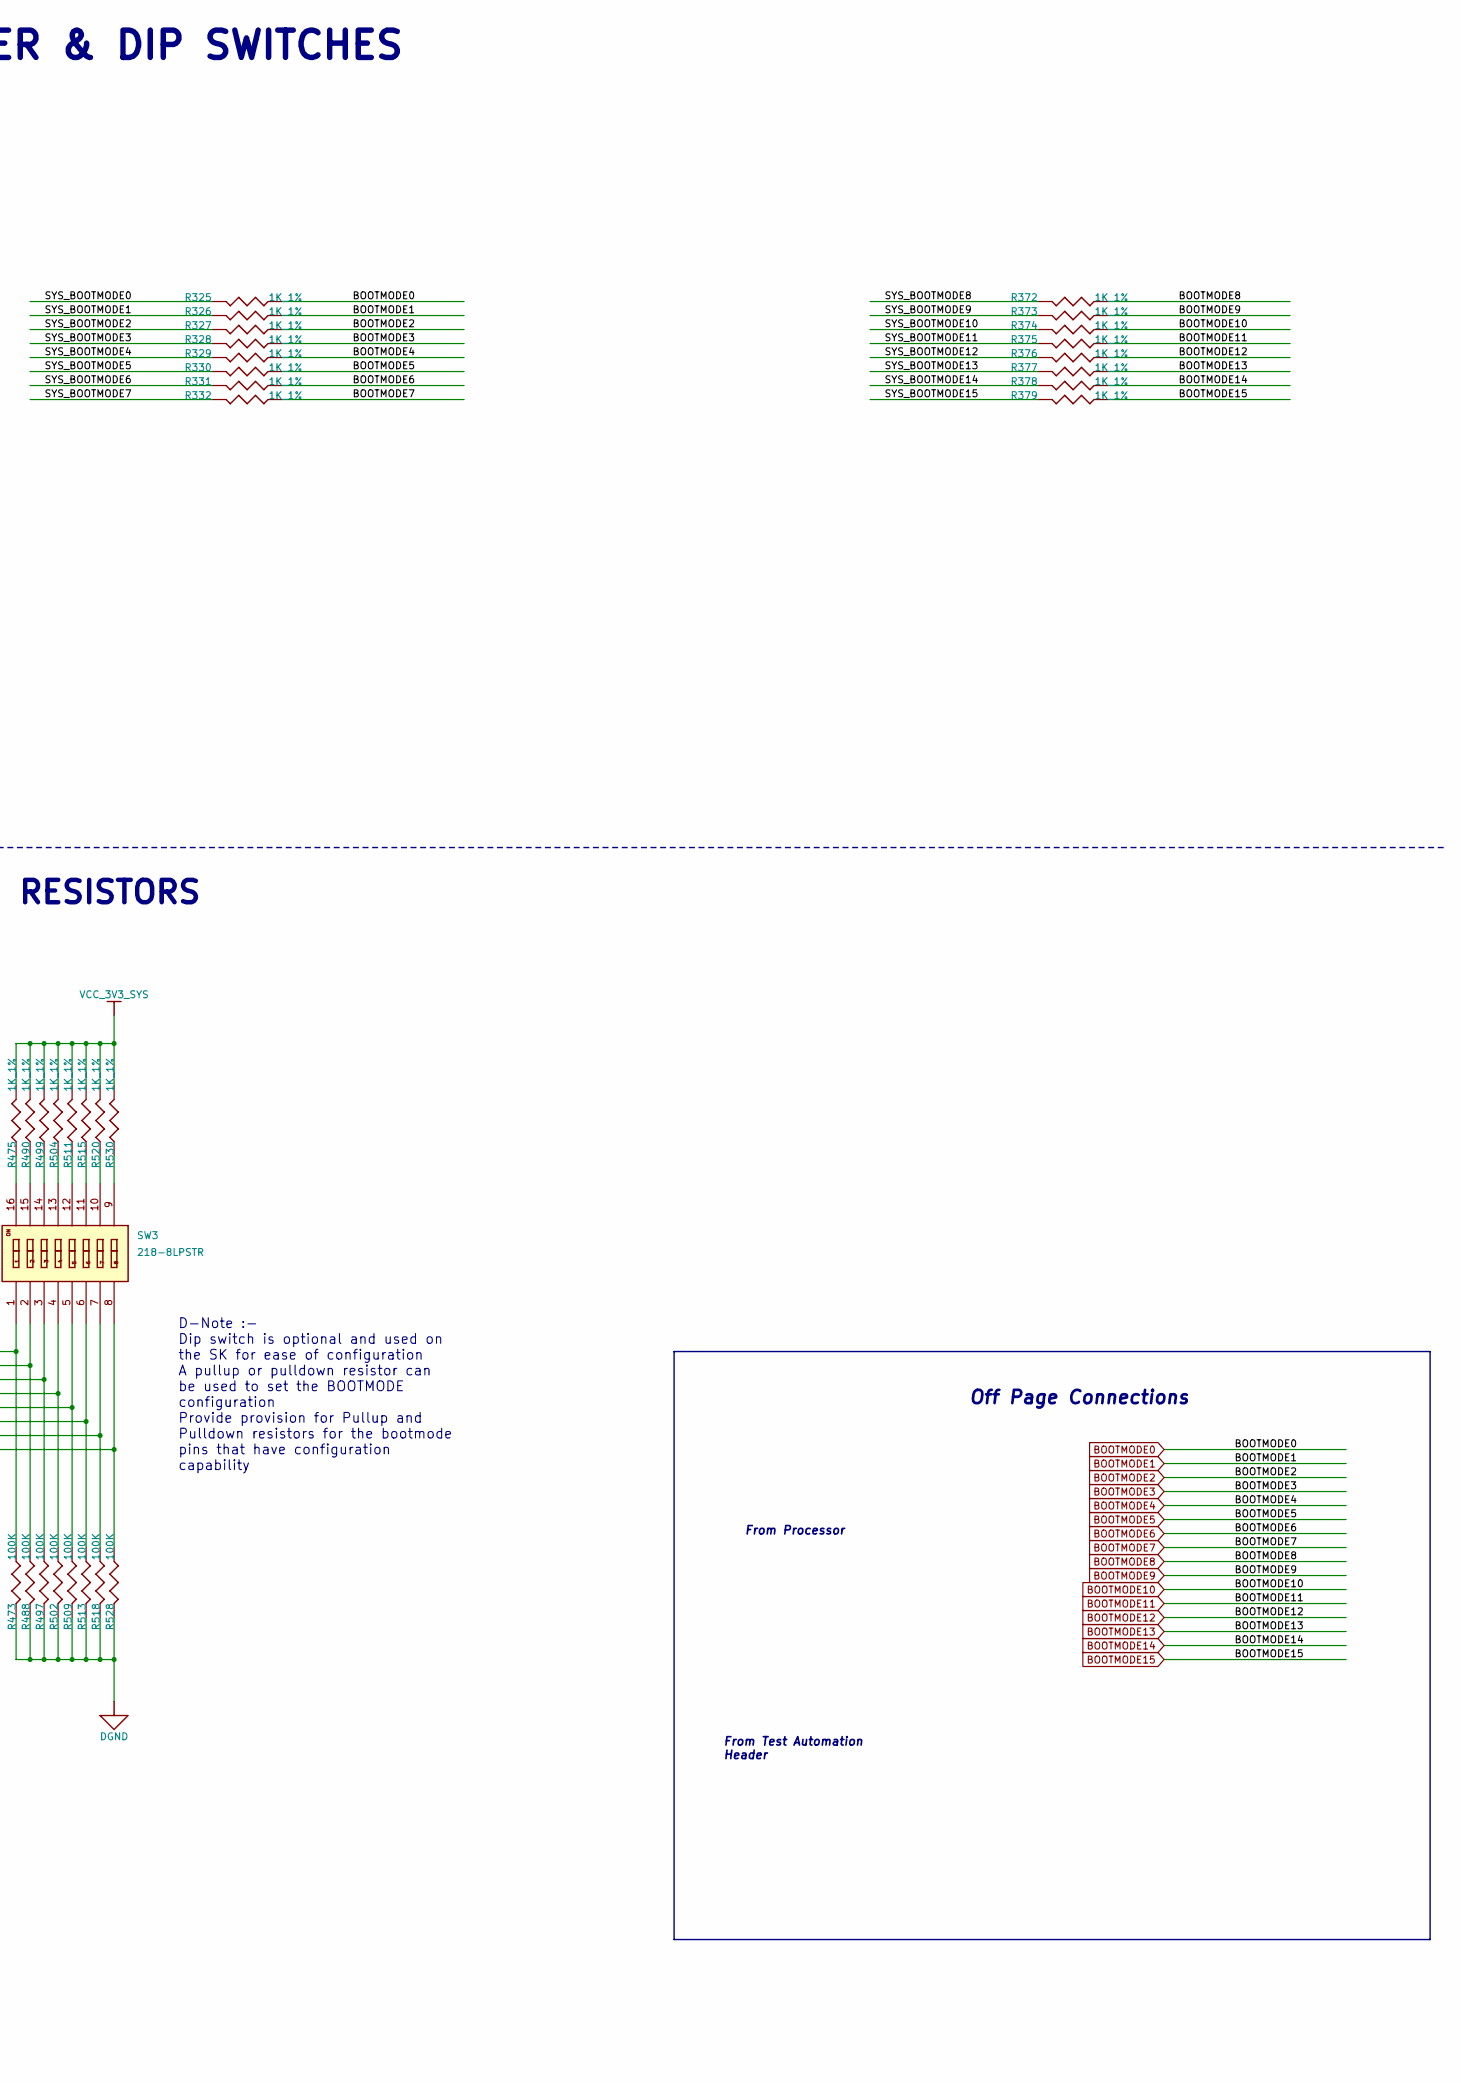
[picture p24: schematic 20.kicad_sch, part in row 1, column 2]

Parts:
R325, R326, R327, R328, R329, R330, R331, R332, R472, R475, R487, R490, R496, R499, R501, R504, R508, R511, R512, R515, R517, R520, R527, R530: 1K_1%; RES0402_0-5; VOLTAGE NA; TOLERANCE 1%; PART_TYPE RESISTOR~{S}FIXED
R372, R373, R374, R375, R376, R377, R378, R379: 1K_1%; RES0402_0-5; TOLERANCE 1%; VOLTAGE NA; MISTRAL PART NO 110009030411-R
R473, R489, R497, R503, R509, R510, R519, R528: 100K; RES0402_0-5; VOLTAGE NA; TOLERANCE 5%; PART_TYPE RESISTOR~{S}FIXED
R474, R488, R498, R502, R513, R514, R518, R529: 100K; RES0402_0-5; TOLERANCE 5%; VOLTAGE NA; MISTRAL PART NO 110011060002-R
SW2, SW3: 218-8LPSTR; SW6_1P27_8p75x6p0_GDH; TOLERANCE NA; VOLTAGE NA; PART NO (MANUFACTURER) GDH06S04 (Tyco Electronics)

Connections:
BOOTMODE0: R325.1
BOOTMODE1: R326.1
BOOTMODE2: R327.1
BOOTMODE3: R328.1
BOOTMODE4: R329.1
BOOTMODE5: R330.1
BOOTMODE6: R331.1
BOOTMODE7: R332.1
BOOTMODE8: R372.1
BOOTMODE9: R373.1
BOOTMODE10: R374.1
BOOTMODE11: R375.1
BOOTMODE12: R376.1
BOOTMODE13: R377.1
BOOTMODE14: R378.1
BOOTMODE15: R379.1
DGND: R473.2, R474.2, R488.2, R489.2, R497.2, R498.2, R502.2, R503.2, R509.2, R510.2, R513.2, R514.2, R518.2, R519.2, R528.2, R529.2
unnamed: R472.1, SW2.9
unnamed: R475.1, SW3.16
unnamed: R487.1, SW2.10
unnamed: R490.1, SW3.15
unnamed: R496.1, SW2.11
unnamed: R499.1, SW3.14
unnamed: R501.1, SW2.12
unnamed: R504.1, SW3.13
unnamed: R508.1, SW2.13
unnamed: R511.1, SW3.12
unnamed: R512.1, SW2.14
unnamed: R515.1, SW3.11
unnamed: R517.1, SW2.15
unnamed: R520.1, SW3.10
unnamed: R527.1, SW2.16
unnamed: R530.1, SW3.9
SYS_BOOTMODE0: R325.2, R529.1, SW2.1
SYS_BOOTMODE1: R326.2, R519.1, SW2.2
SYS_BOOTMODE2: R327.2, R514.1, SW2.3
SYS_BOOTMODE3: R328.2, R510.1, SW2.4
SYS_BOOTMODE4: R329.2, R503.1, SW2.5
SYS_BOOTMODE5: R330.2, R498.1, SW2.6
SYS_BOOTMODE6: R331.2, R489.1, SW2.7
SYS_BOOTMODE7: R332.2, R474.1, SW2.8
SYS_BOOTMODE8: R372.2, R473.1, SW3.1
SYS_BOOTMODE9: R373.2, R488.1, SW3.2
SYS_BOOTMODE10: R374.2, R497.1, SW3.3
SYS_BOOTMODE11: R375.2, R502.1, SW3.4
SYS_BOOTMODE12: R376.2, R509.1, SW3.5
SYS_BOOTMODE13: R377.2, R513.1, SW3.6
SYS_BOOTMODE14: R378.2, R518.1, SW3.7
SYS_BOOTMODE15: R379.2, R528.1, SW3.8
VCC_3V3_SYS: R472.2, R475.2, R487.2, R490.2, R496.2, R499.2, R501.2, R504.2, R508.2, R511.2, R512.2, R515.2, R517.2, R520.2, R527.2, R530.2

Notes on the sheet:
D-Note :- it is not recommended to leave any of the the bootmode pin open including reserved pins
SWITCH ON = LOGIC 1 SWITCH OFF = LOGIC 0
BOOTMODE CONFIGURATION RESISTORS AND BOOTMODE SWITCHES
D-Note :- Dip switch is optional and used on the SK for ease of configuration A pullup or pulldown resistor can be used to set the BOOTMODE configuration Provide provision for Pullup and Pulldown resistors for the bootmode pins that have configuration capability
D-Note :- Ok to use 1K, 5%
D-Note :- When dip switches are used on custom board, an external ESD protection may be required if the DIP switches are expected to be configured in an uncontrolled ESD environment
D-Note :- When DIP switch are used, reduce the resistor values used for the divider to 47K and 470R maintaining the ratio
From Test Automation Header
BOOT MODES SUPPORTED
Off Page Connections
1. OSPI
6. USB Device
3. MMC0 - eMMC
BOOT MODE BUFFER & DIP SWITCHES
From Processor
8. Ethernet
4. CPSW Ethernet Slave
7. UART
2. MMC1 - SD CARD
5. USB Host
