gingerologist/am64x/21.kicad_sch

## KiCad design 21.kicad_sch (2024-08-05)

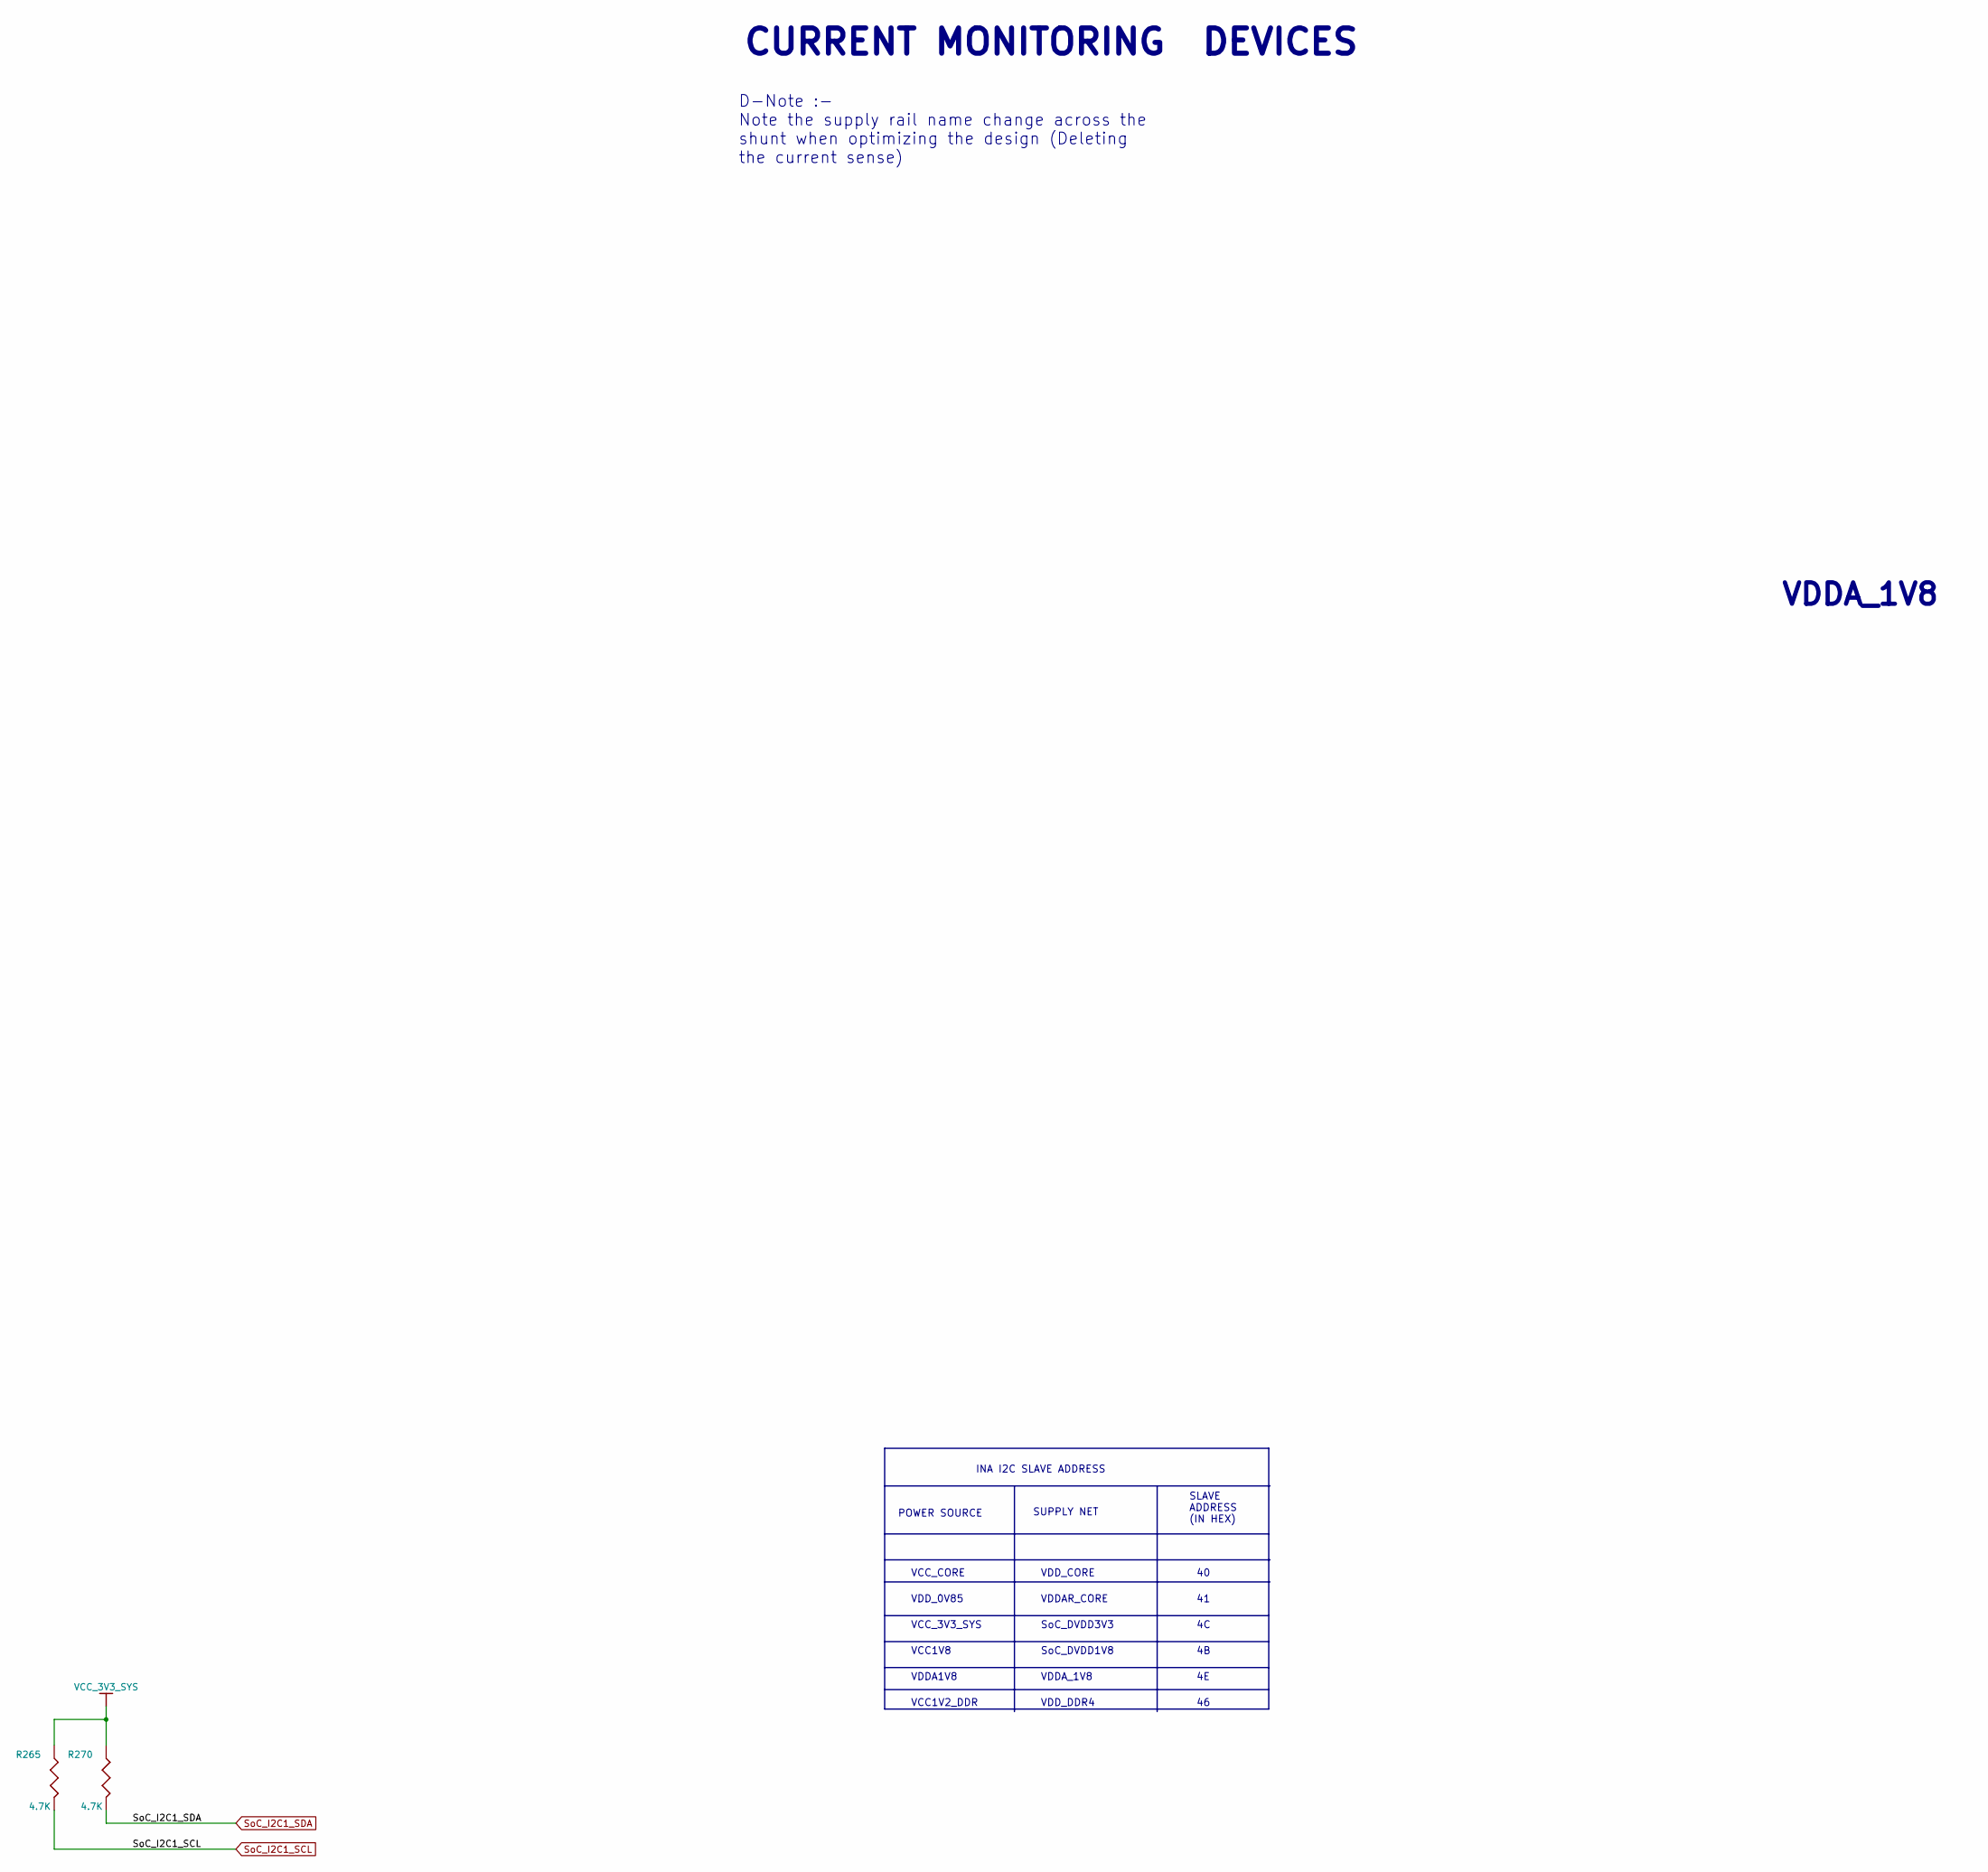
[picture p25: schematic 21.kicad_sch]

Parts:
R265: 4.7K; RES0402_0-5; TOLERANCE 5%; VOLTAGE NA; MISTRAL PART NO 110011060001-R
R270: 4.7K; RES0402_0-5; VOLTAGE NA; TOLERANCE 5%; PART_TYPE RESISTOR~{S}FIXED

Connections:
SoC_I2C1_SCL: R265.2
SoC_I2C1_SDA: R270.2
VCC_3V3_SYS: R265.1, R270.1

Notes on the sheet:
D-Note :- Note the supply rail name change across the shunt when optimizing the design (Deleting the current sense)
SLAVE ADDRESS (IN HEX)
SoC_DVDD1V8
VDDAR_CORE
VDDA1V8
VDDA_1V8
VCC_CORE
VDD_DDR4
CURRENT MONITORING DEVICES
SoC_DVDD3V3
VCC1V2_DDR
INA I2C SLAVE ADDRESS
VCC1V8
SUPPLY NET
VDD_0V85
POWER SOURCE
VDD_CORE
VCC_3V3_SYS
