gingerologist/am64x/22.kicad_sch

## KiCad design 22.kicad_sch (2024-07-26)

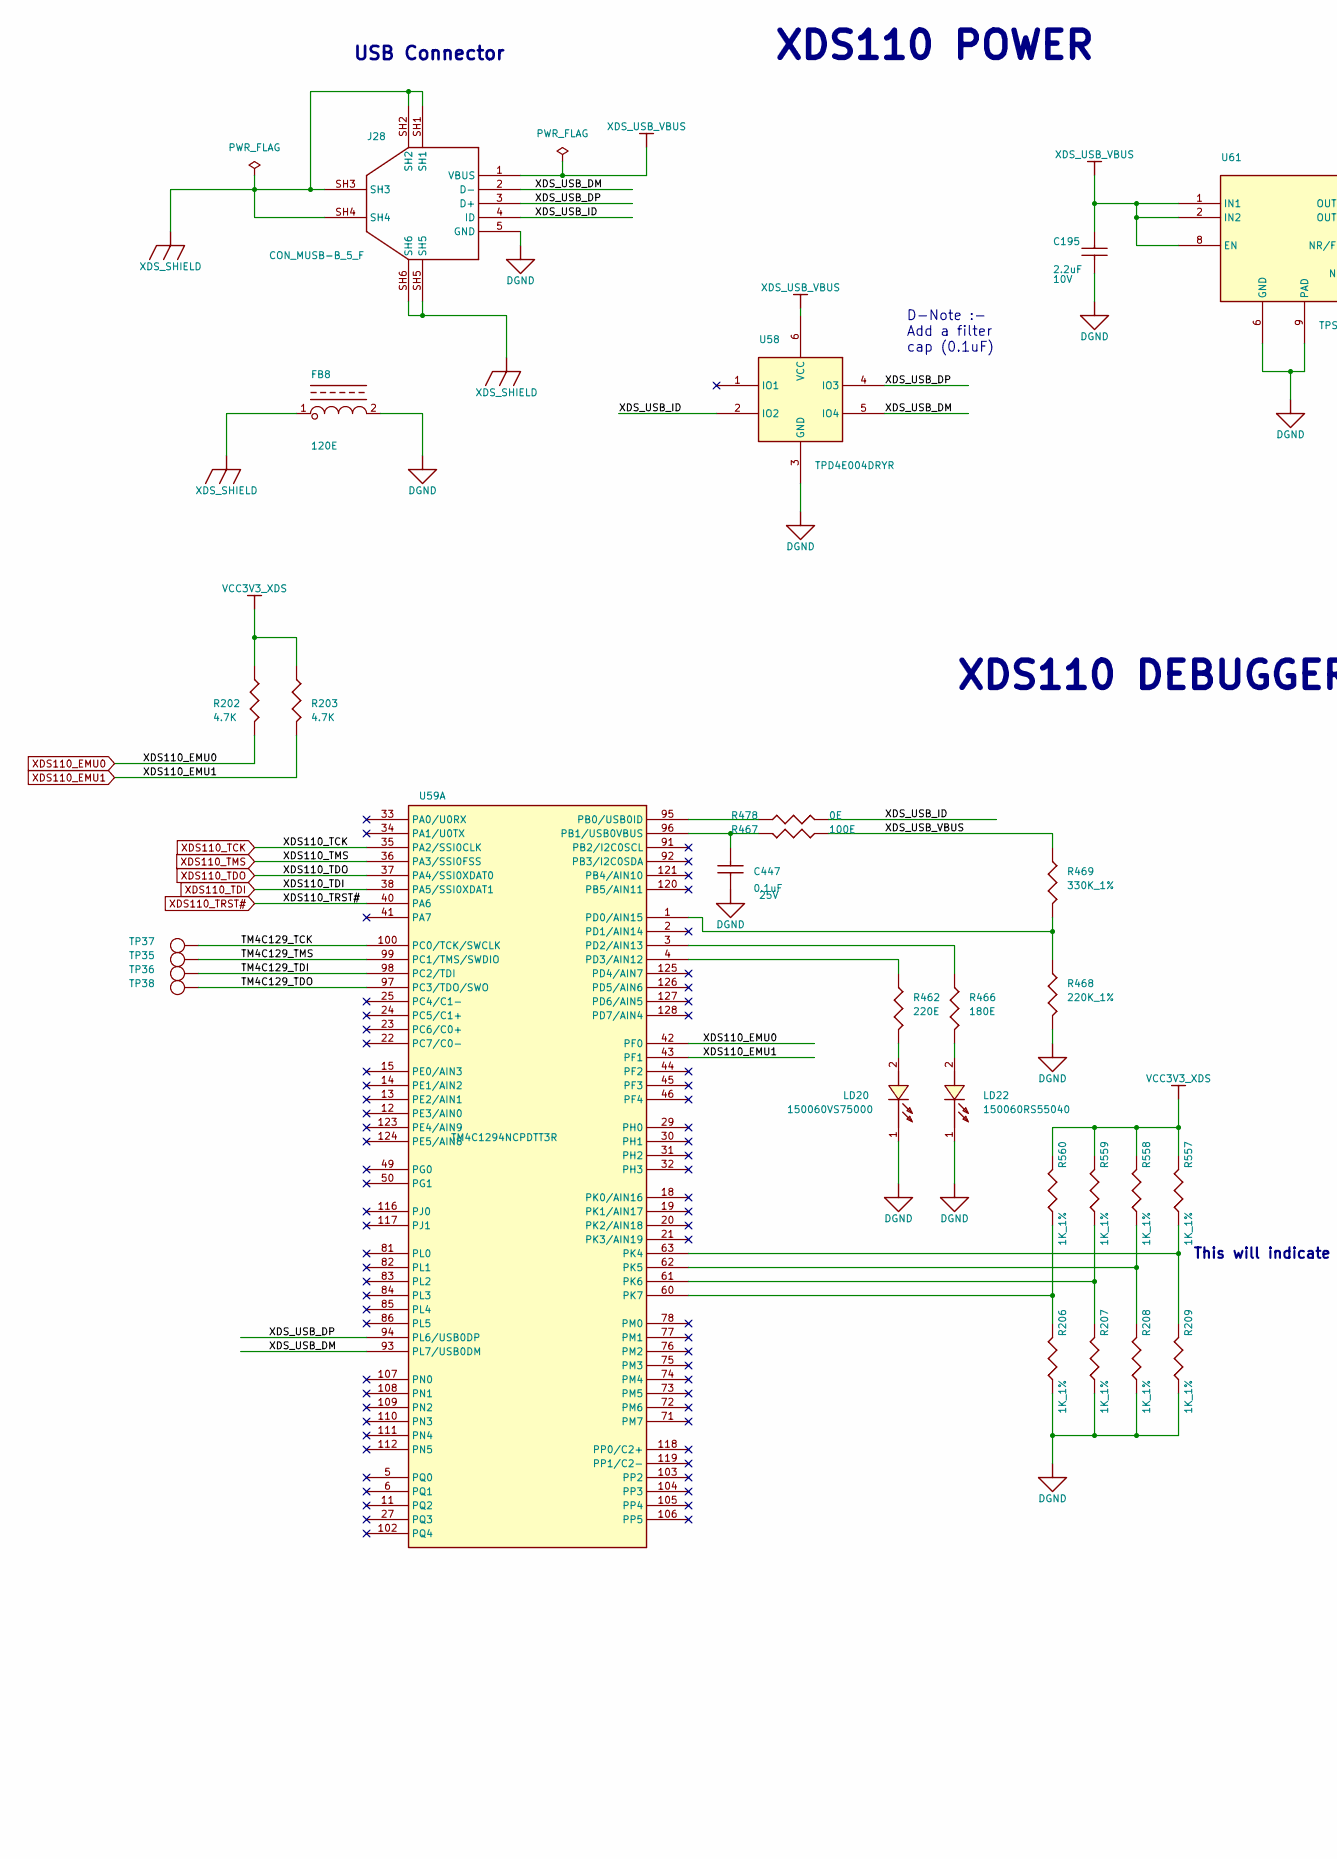
[picture p26: schematic 22.kicad_sch, part in row 1, column 1]

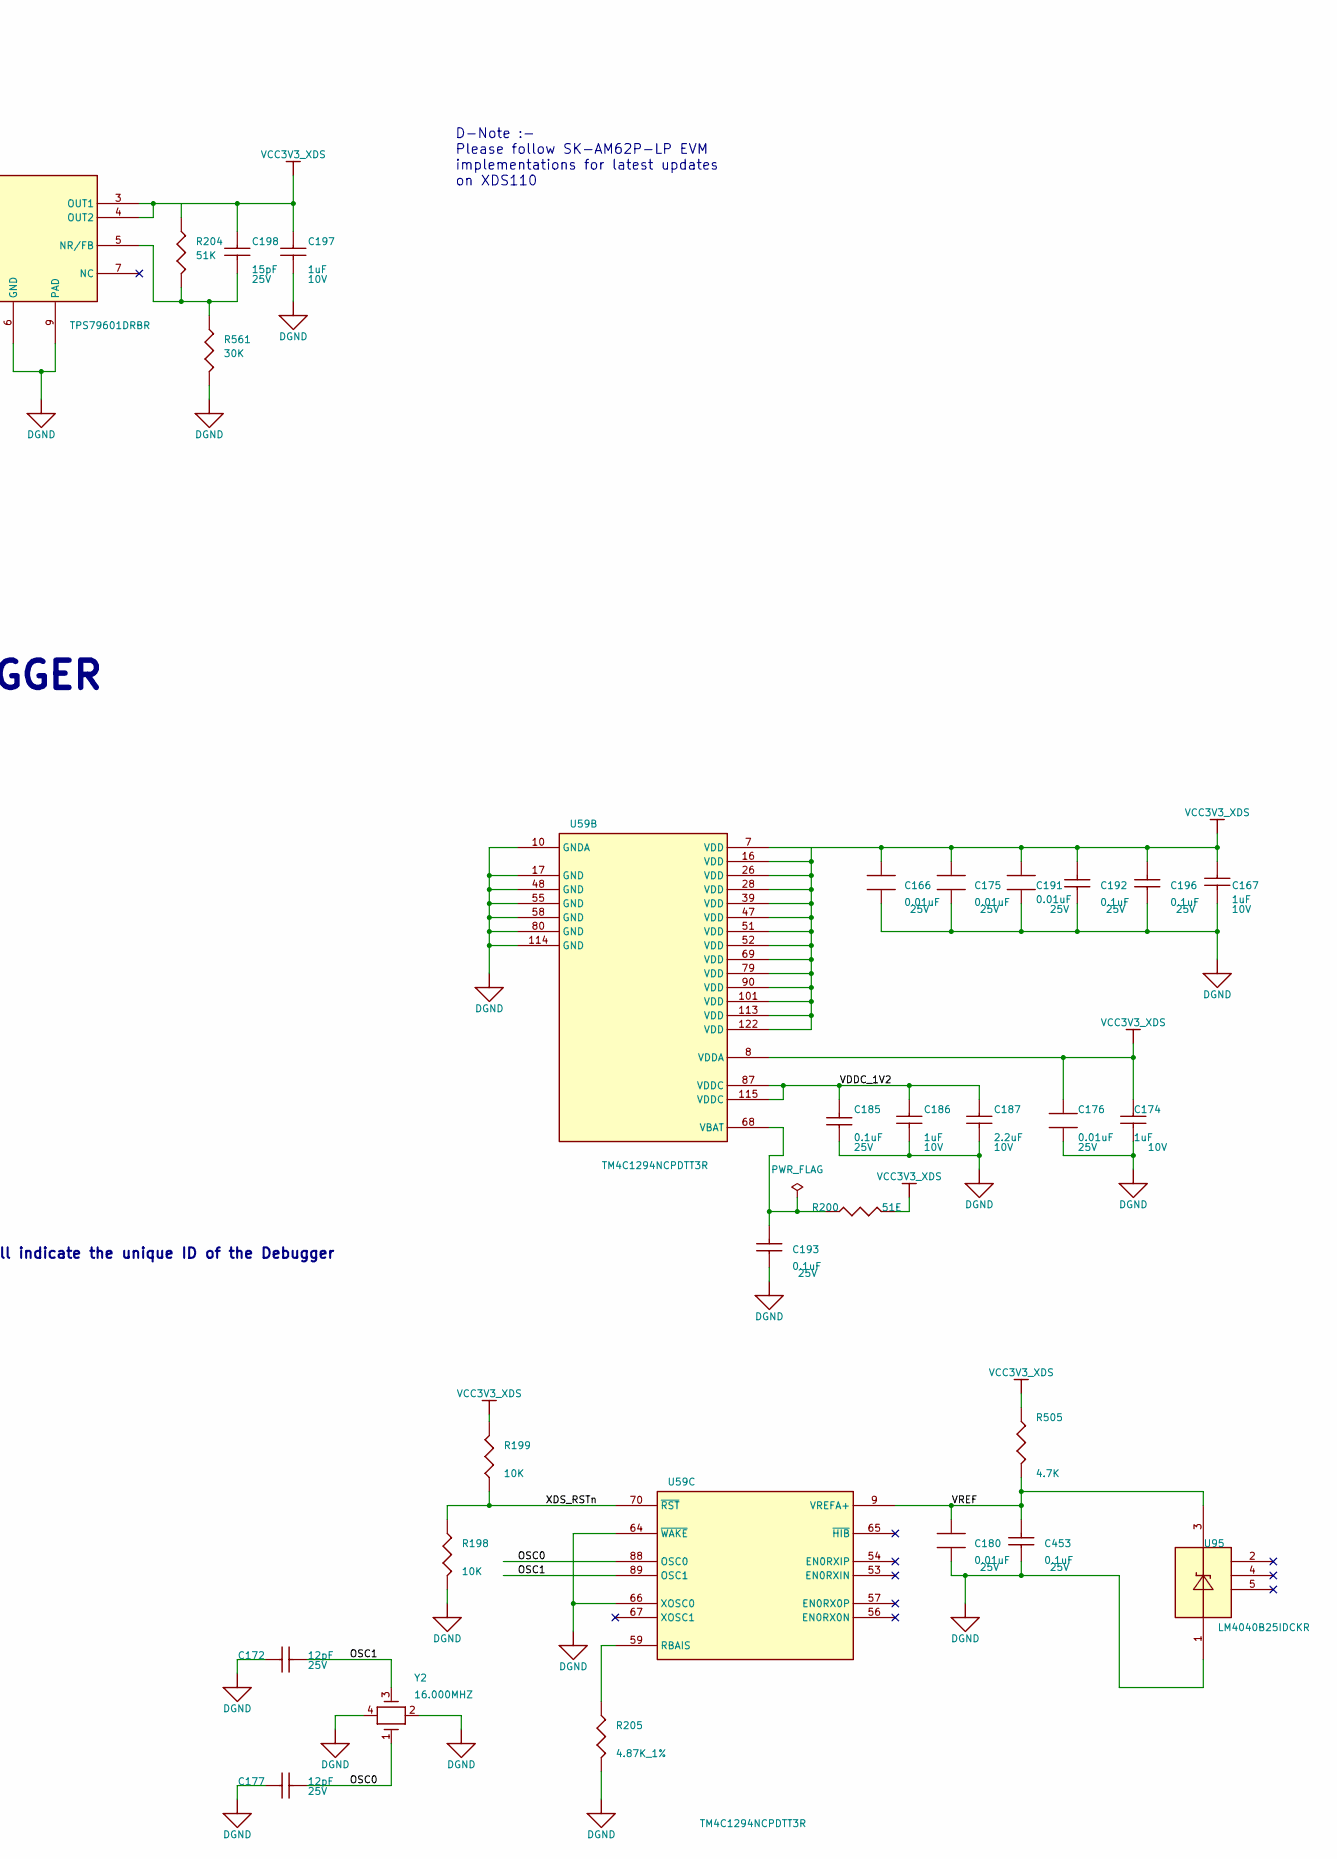
[picture p27: schematic 22.kicad_sch, part in row 1, column 2]

Parts:
C166, C175, C180, C191: 0.01uF; CAP0402N; TOLERANCE 10%; VOLTAGE 25V; MISTRAL PART NO 120011090040-R
C167, C174: 1uF; CAP0402_0-75; VOLTAGE 10V; TOLERANCE 20%; PART_TYPE CAPACITOR~{S}CERAMIC
C172: 12pF; CAP0201_0-5; VOLTAGE 25V; TOLERANCE 5%; PART_TYPE CAPACITOR~{S}CERAMIC
C176: 0.01uF; CAP0402N; VOLTAGE 25V; TOLERANCE 10%; PART_TYPE CAPACITOR~{S}CERAMIC
C177: 12pF; CAP0201_0-5; TOLERANCE 5%; VOLTAGE 25V; MISTRAL PART NO 120009030213-R
C185, C196: 0.1uF; CAP0402_0-75; TOLERANCE 20%; VOLTAGE 25V; MISTRAL PART NO 120020080003-R
C186, C197: 1uF; CAP0402_0-75; TOLERANCE 20%; VOLTAGE 10V; MISTRAL PART NO 120020080009-R
C187, C195: 2.2uF; CAP0402_0-75; VOLTAGE 10V; TOLERANCE 20%; PART_TYPE CAPACITOR~{S}CERAMIC
C192, C193, C447, C453: 0.1uF; CAP0402_0-75; VOLTAGE 25V; TOLERANCE 20%; PART_TYPE CAPACITOR~{S}CERAMIC
C198: 15pF; CAP0402_0-75; VOLTAGE 25V; TOLERANCE 5%; PART_TYPE CAPACITOR~{S}CERAMIC
FB8: 120E; IND0603_1; VOLTAGE NA; TOLERANCE 25%; PART_TYPE INDUCTOR
J28: CON_MUSB-B_5_F; CON_MUSBB5_1051640001_S_R_S_2-5; VOLTAGE NA; TOLERANCE NA; PART_TYPE CONNECTO~{R}USB
LD20: 150060VS75000; LED_150060SS75000_70X40_SMD_0-8; VOLTAGE NA; TOLERANCE NA; PART_TYPE OPT~{O}LED
LD22: 150060RS55040; LED_150060RS55040_70X40_SMD_0-5; TOLERANCE NA; VOLTAGE NA; MISTRAL PART NO 130020080014-R
R198: 10K; RES0402_0-5; TOLERANCE 5%; VOLTAGE NA; MISTRAL PART NO 110011060021-R
R199: 10K; RES0402_0-5; VOLTAGE NA; TOLERANCE 5%; PART_TYPE RESISTOR~{S}FIXED
R200: 51E; RES0402_0-5; VOLTAGE NA; TOLERANCE 5%; PART_TYPE RESISTOR~{S}FIXED
R202, R505: 4.7K; RES0402_0-5; TOLERANCE 5%; VOLTAGE NA; MISTRAL PART NO 110011060001-R
R203: 4.7K; RES0402_0-5; VOLTAGE NA; TOLERANCE 5%; PART_TYPE RESISTOR~{S}FIXED
R204: 51K; RES0402_0-5; TOLERANCE 5%; VOLTAGE NA; MISTRAL PART NO 110009030966-R
R205: 4.87K_1%; RES0402_0-5; VOLTAGE NA; TOLERANCE 1%; PART_TYPE RESISTOR~{S}FIXED
R206, R207, R208, R209, R557, R558, R559, R560: 1K_1%; RES0402_0-5; VOLTAGE NA; TOLERANCE 1%; PART_TYPE RESISTOR~{S}FIXED
R462: 220E; RES0402_0-5; TOLERANCE 5%; VOLTAGE NA; MISTRAL PART NO 110009030506-R
R466: 180E; RES0402_0-5; TOLERANCE 5%; VOLTAGE NA; MISTRAL PART NO 110009030371-R
R467: 100E; RES0402_0-5; TOLERANCE 5%; VOLTAGE NA; MISTRAL PART NO 110014060039-R
R468: 220K_1%; RES0402_0-5; TOLERANCE 1%; VOLTAGE NA; MISTRAL PART NO 110017080025-R
R469: 330K_1%; RES0402_0-5; TOLERANCE 1%; VOLTAGE NA; MISTRAL PART NO 110017080024-R
R478: 0E; RES0402_0-5; VOLTAGE NA; TOLERANCE NA; PART_TYPE RESISTOR~{S}FIXED
R561: 30K; RES0402_0-5; TOLERANCE 5%; VOLTAGE NA; MISTRAL PART NO 110017080023-R
TP35, TP38: TP20_SMD; VOLTAGE NA; TOLERANCE NA; MISTRAL PART NO NA
TP36, TP37: TP20_SMD; TOLERANCE NA; VOLTAGE NA; PART_TYPE TESTPOINT
U58: TPD4E004DRYR; SON6_19-68_40X60_PB_0-6; TOLERANCE NA; VOLTAGE NA; PART_TYPE IC~{S}INTERFACE
U59: TM4C1294NCPDTT3R; TQFP128_15-74_550X550_1-2; VOLTAGE NA; TOLERANCE NA; PART_TYPE IC~{S}DIGITA~{L}MICROCONTROLLER
U61: TPS79601DRBR; SON8_25-59_130X130_1; TOLERANCE NA; VOLTAGE NA; PART_TYPE IC~{S}POWE~{R}VOLTAGE REGULATOR
U95: LM4040B25IDCKR; SC70-5_1-1; VOLTAGE NA; TOLERANCE NA; PART_TYPE IC~{S}POWE~{R}VOLTAGE REGULATOR
Y2: 16.000MHZ; XTAL4_NX3225GA_130X100_SMD_0-9; TOLERANCE NA; VOLTAGE NA; MISTRAL PART NO 130017080024-R

Connections:
DGND: C166.2, C167.2, C172.1, C174.2, C175.2, C176.2, C177.1, C180.2, C185.1, C186.2, C187.2, C191.2, C192.1, C193.1, C195.2, C196.1, C197.2, C447.1, C453.1, FB8.2, J28.5 (GND), LD20.1 (CATHODE), LD22.1 (CATHODE), R198.2, R205.2, R206.1, R207.1, R208.1, R209.1, R468.2, R561.2, U58.3 (GND), U59.10 (GNDA), U59.17 (GND), U59.48 (GND), U59.55 (GND), U59.58 (GND), U59.64 (~WAKE), U59.66 (XOSC0), U59.80 (GND), U59.114 (GND), U61.6 (GND), U61.9 (PAD), U95.1 (ANODE), Y2.2, Y2.4
unnamed: C193.2, R200.1, U59.68 (VBAT)
unnamed: C198.2, R204.2, R561.1, U61.5 (NR/FB)
unnamed: C447.2, R467.2, U59.96 (PB1/USB0VBUS)
unnamed: LD20.2 (ANODE), R462.2
unnamed: LD22.2 (ANODE), R466.2
unnamed: R205.1, U59.59 (RBAIS)
unnamed: R206.2, R560.1, U59.60 (PK7)
unnamed: R207.2, R559.1, U59.61 (PK6)
unnamed: R208.2, R558.1, U59.62 (PK5)
unnamed: R209.2, R557.1, U59.63 (PK4)
unnamed: R462.1, U59.4 (PD3/AIN12)
unnamed: R466.1, U59.3 (PD2/AIN13)
unnamed: R468.1, R469.2, U59.1 (PD0/AIN15)
unnamed: R478.1, U59.95 (PB0/USB0ID)
OSC0: C177.2, U59.88 (OSC0), Y2.1
OSC1: C172.2, U59.89 (OSC1), Y2.3
TM4C129_TCK: TP37.1, U59.100 (PC0/TCK/SWCLK)
TM4C129_TDI: TP36.1, U59.98 (PC2/TDI)
TM4C129_TDO: TP38.1, U59.97 (PC3/TDO/SWO)
TM4C129_TMS: TP35.1, U59.99 (PC1/TMS/SWDIO)
VCC3V3_XDS: C166.1, C167.1, C174.1, C175.1, C176.1, C191.1, C192.2, C196.2, C197.1, C198.1, R199.2, R200.2, R202.1, R203.1, R204.1, R505.1, R557.2, R558.2, R559.2, R560.2, U59.7 (VDD), U59.8 (VDDA), U59.16 (VDD), U59.26 (VDD), U59.28 (VDD), U59.39 (VDD), U59.47 (VDD), U59.51 (VDD), U59.52 (VDD), U59.69 (VDD), U59.79 (VDD), U59.90 (VDD), U59.101 (VDD), U59.113 (VDD), U59.122 (VDD), U61.3 (OUT1), U61.4 (OUT2)
VDDC_1V2: C185.2, C186.1, C187.1, U59.87 (VDDC), U59.115 (VDDC)
VREF: C180.1, C453.2, R505.2, U59.9 (VREFA+), U95.3 (CATHODE)
XDS110_EMU0: R202.2, U59.42 (PF0)
XDS110_EMU1: R203.2, U59.43 (PF1)
XDS110_TCK: U59.35 (PA2/SSI0CLK)
XDS110_TDI: U59.38 (PA5/SSI0XDAT1)
XDS110_TDO: U59.37 (PA4/SSI0XDAT0)
XDS110_TMS: U59.36 (PA3/SSI0FSS)
XDS110_TRST#: U59.40 (PA6)
XDS_RSTn: R198.1, R199.1, U59.70 (~RST)
XDS_SHIELD: FB8.1, J28.SH1, J28.SH2, J28.SH3, J28.SH4, J28.SH5, J28.SH6
XDS_USB_DM: J28.2 (D-), U58.5 (IO4), U59.93 (PL7/USB0DM)
XDS_USB_DP: J28.3 (D+), U58.4 (IO3), U59.94 (PL6/USB0DP)
XDS_USB_ID: J28.4 (ID), R478.2, U58.2 (IO2)
XDS_USB_VBUS: C195.1, J28.1 (VBUS), R467.1, R469.1, U58.6 (VCC), U61.1 (IN1), U61.2 (IN2), U61.8 (EN)

Notes on the sheet:
D-Note :- Add a filter cap (0.1uF)
D-Note :- Please follow SK-AM62P-LP EVM implementations for latest updates on XDS110
XDS110 DEBUGGER
USB Connector
XDS110 POWER
This will indicate the unique ID of the Debugger
