gingerologist/am64x/23.kicad_sch

## KiCad design 23.kicad_sch (2024-08-05)

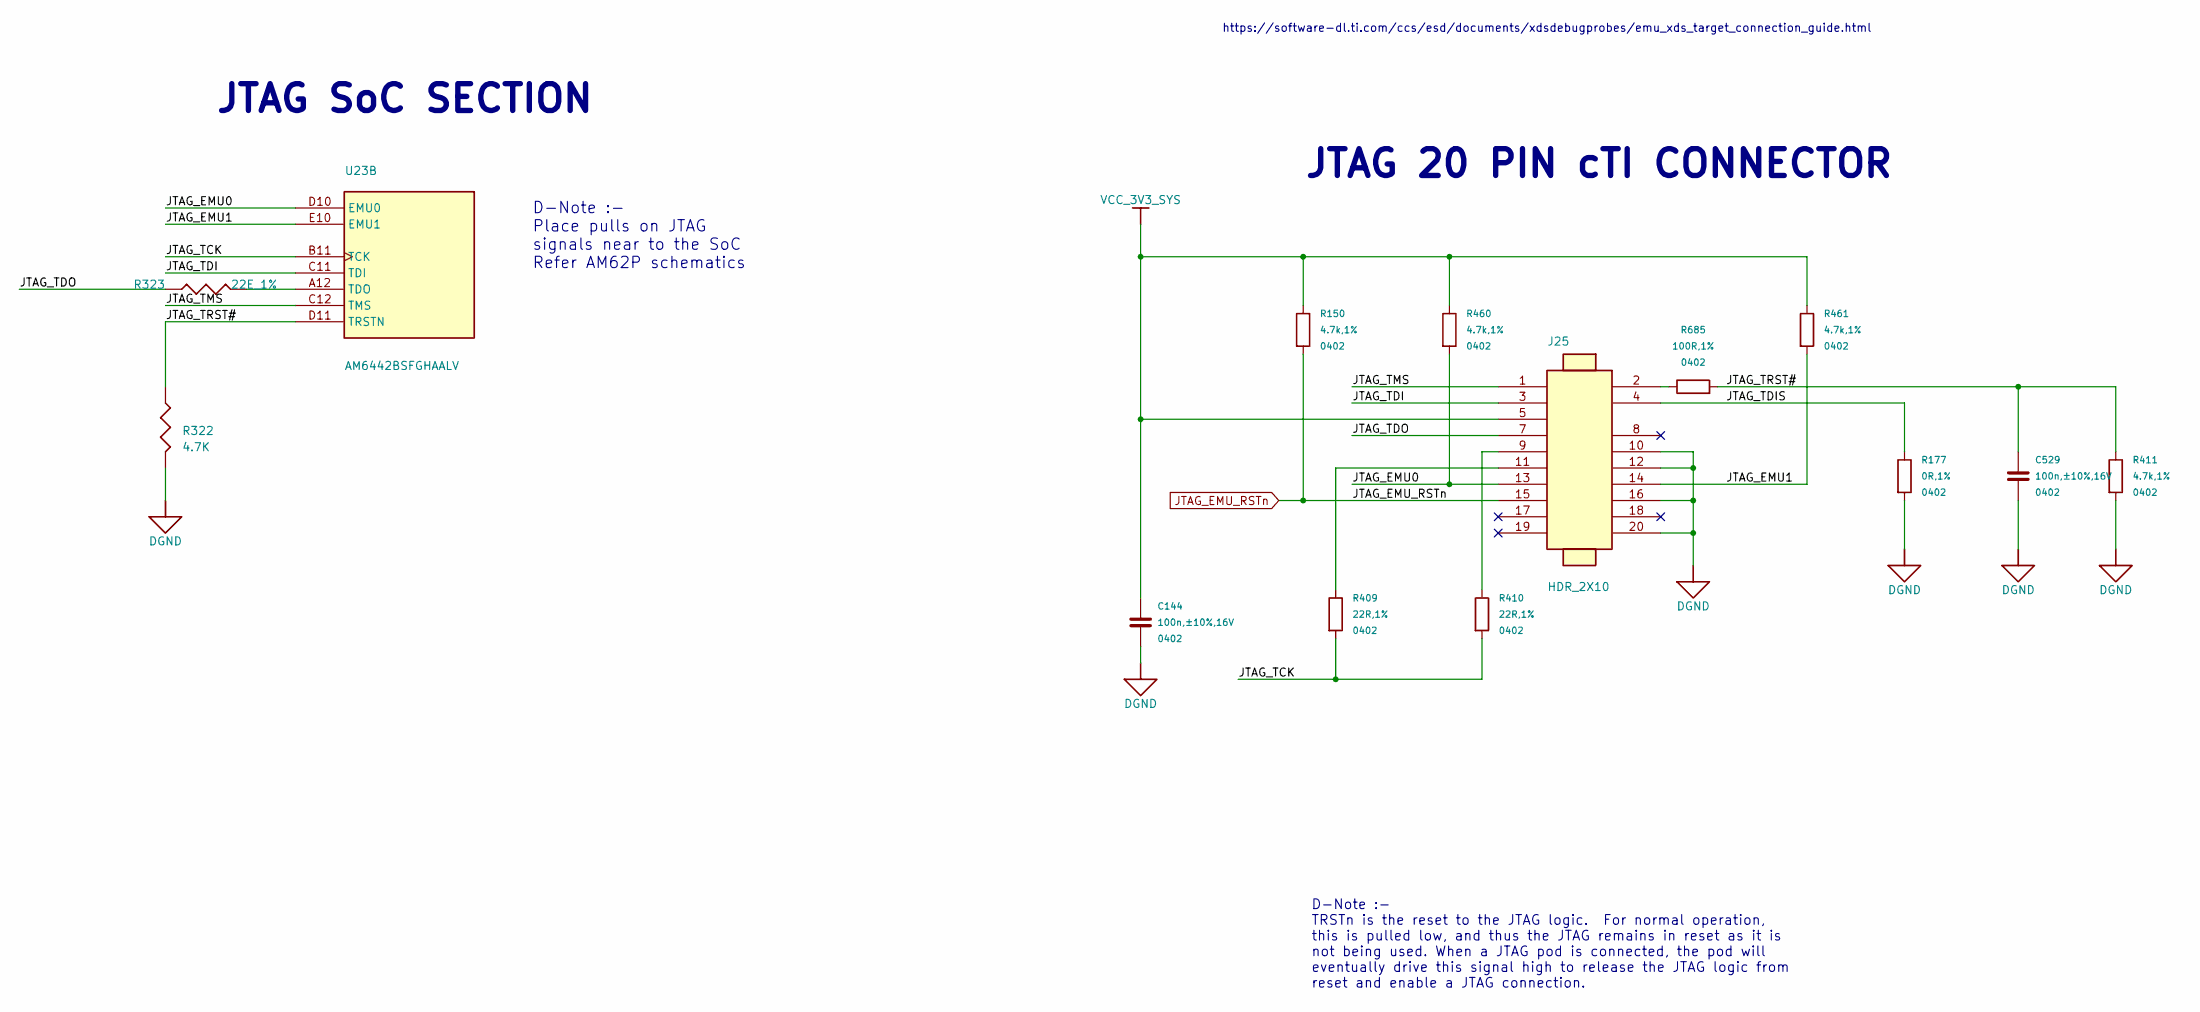
[picture p28: schematic 23.kicad_sch]

Parts:
C144, C529: 100n,±10%,16V; C_0402_1005Metric_for_0.25mm_grid; Manufacturer Part CL05B104KO5NNNC
J25: HDR_2X10; HDR_2X10_FTR-110-51-D-06_S_S_8-7; TOLERANCE NA; VOLTAGE NA; MISTRAL PART NO 150011090001-R
R150, R411, R460, R461: 4.7k,1%; R_0402_1005Metric_for_0.25mm_grid; Manufacturer Part 0402WGF4701TCE
R177: 0R,1%; R_0402_1005Metric_for_0.25mm_grid; Manufacturer Part 0402WGF0000TCE
R322: 4.7K; RES0402_0-5; TOLERANCE 5%; VOLTAGE NA; MISTRAL PART NO 110011060001-R
R323: 22E_1%; RES0402_0-5; TOLERANCE 1%; VOLTAGE NA; MISTRAL PART NO 110009090004-R
R409, R410: 22R,1%; R_0402_1005Metric_for_0.25mm_grid; Manufacturer Part 0402WGF220JTCE
R685: 100R,1%; R_0402_1005Metric_for_0.25mm_grid; Manufacturer Part 0402WGF1000TCE
U23: AM6442BSFGHAALV; FCBGA441_31-49_680X680_2-6; TOLERANCE NA; VOLTAGE NA; MISTRAL PART NO 141220080002

Connections:
DGND: C144.2, C529.2, J25.10, J25.12, J25.16, J25.20, R177.2, R322.2, R411.2
JTAG_EMU0: J25.13, R460.2, U23.D10 (EMU0)
JTAG_EMU1: J25.14, R461.2, U23.E10 (EMU1)
JTAG_EMU_RSTn: J25.15, R150.2
JTAG_TCK: R409.2, R410.2, U23.B11 (TCK)
JTAG_TDI: J25.3, U23.C11 (TDI)
JTAG_TDIS: J25.4, R177.1
JTAG_TDO: J25.7, R323.1
JTAG_TMS: J25.1, U23.C12 (TMS)
JTAG_TRST#: C529.1, R322.1, R411.1, R685.2, U23.D11 (TRSTN)
unnamed: J25.2, R685.1
unnamed: J25.9, R410.1
unnamed: J25.11, R409.1
unnamed: R323.2, U23.A12 (TDO)
VCC_3V3_SYS: C144.1, J25.5, R150.1, R460.1, R461.1

Notes on the sheet:
D-Note :- TRSTn is the reset to the JTAG logic. For normal operation, this is pulled low, and thus the JTAG remains in reset as it is not being used. When a JTAG pod is connected, the pod will eventually drive this signal high to release the JTAG logic from reset and enable a JTAG connection.
D-Note :- Place pulls on JTAG signals near to the SoC Refer AM62P schematics
JTAG 20 PIN cTI CONNECTOR
JTAG SoC SECTION
https://software-dl.ti.com/ccs/esd/documents/xdsdebugprobes/emu_xds_target_connection_guide.html
