gingerologist/am64x/24.kicad_sch

## KiCad design 24.kicad_sch (2024-08-05)

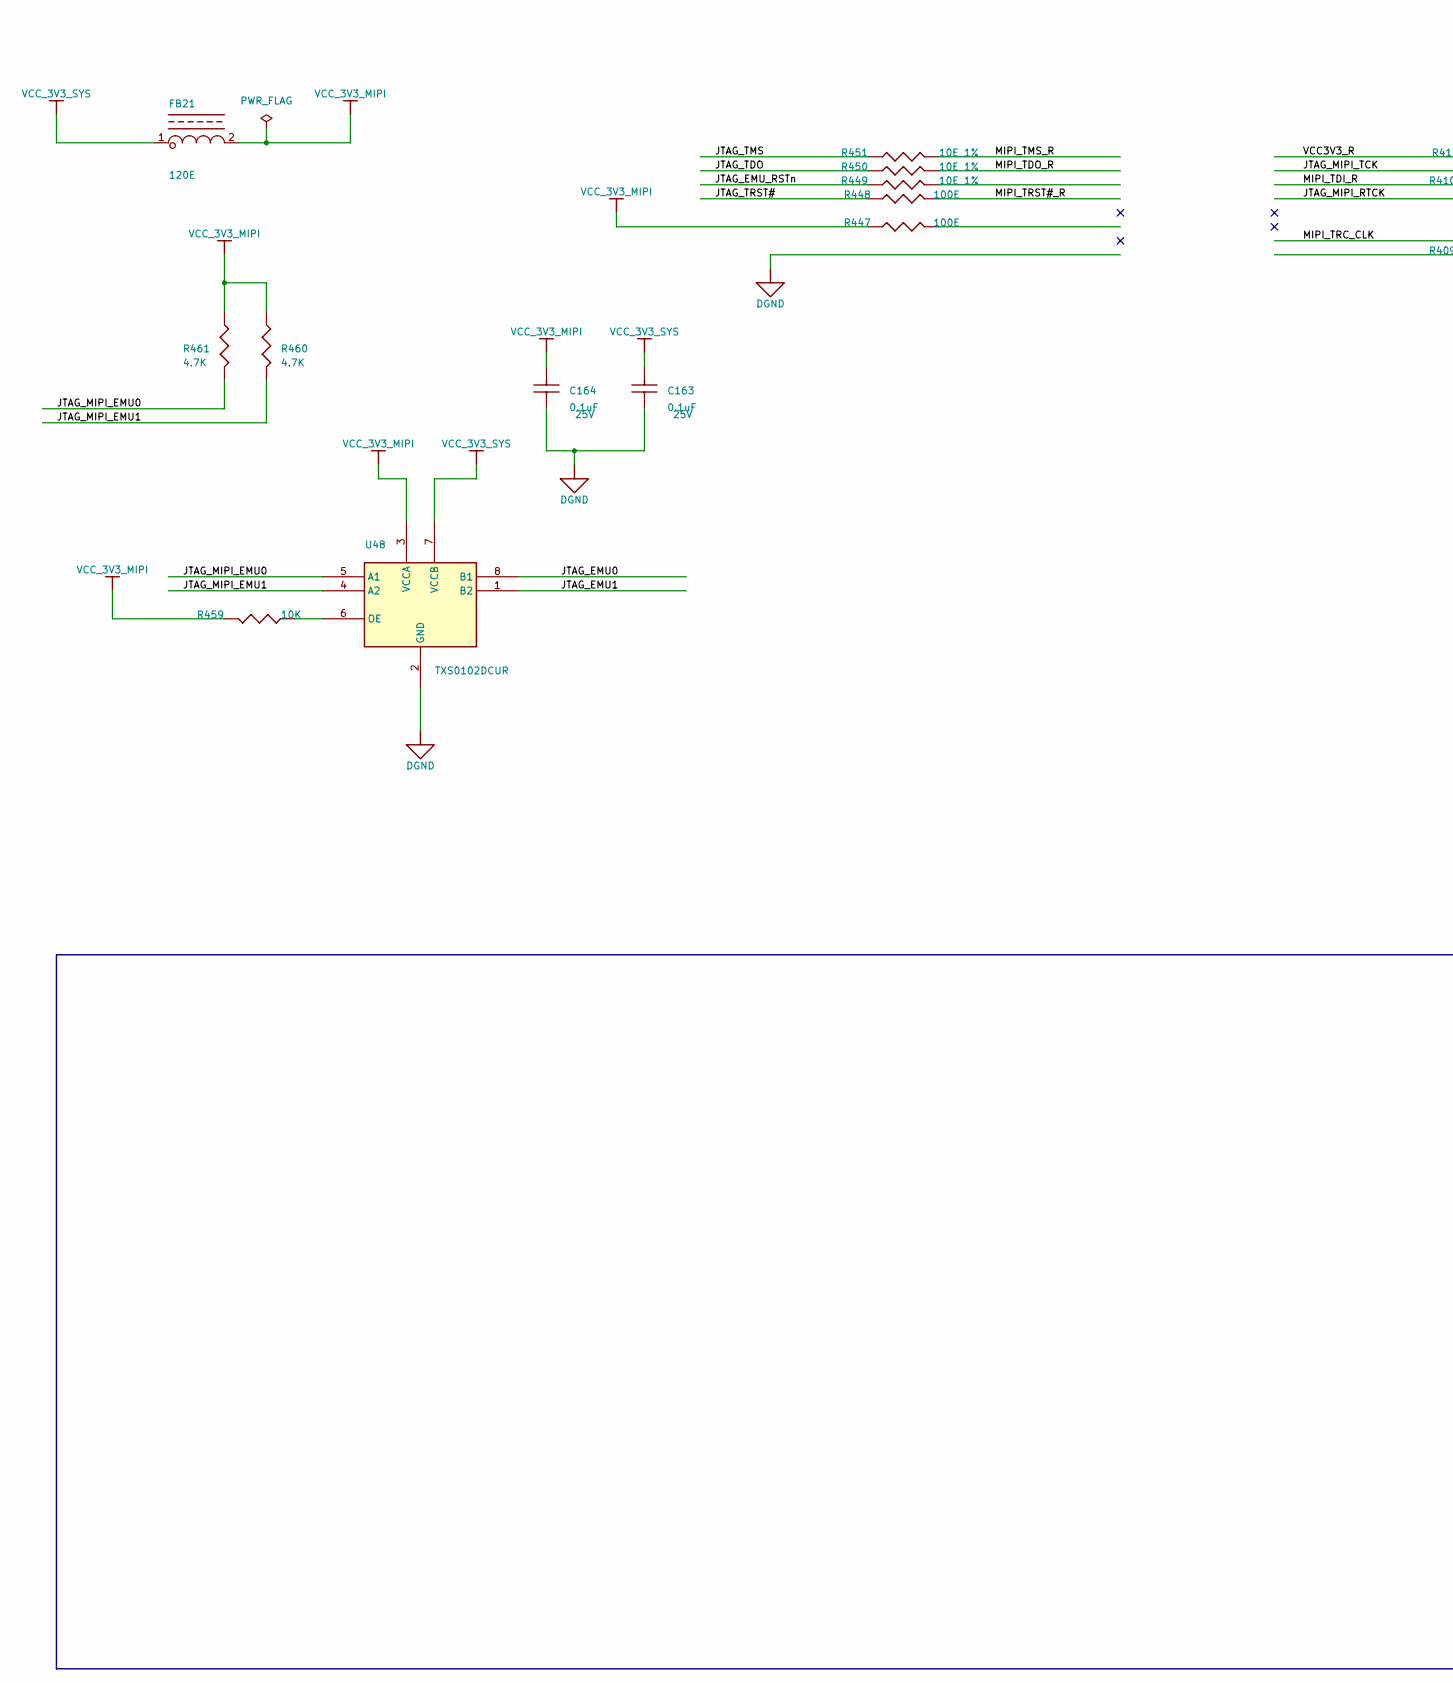
[picture p29: schematic 24.kicad_sch, part in row 1, column 1]

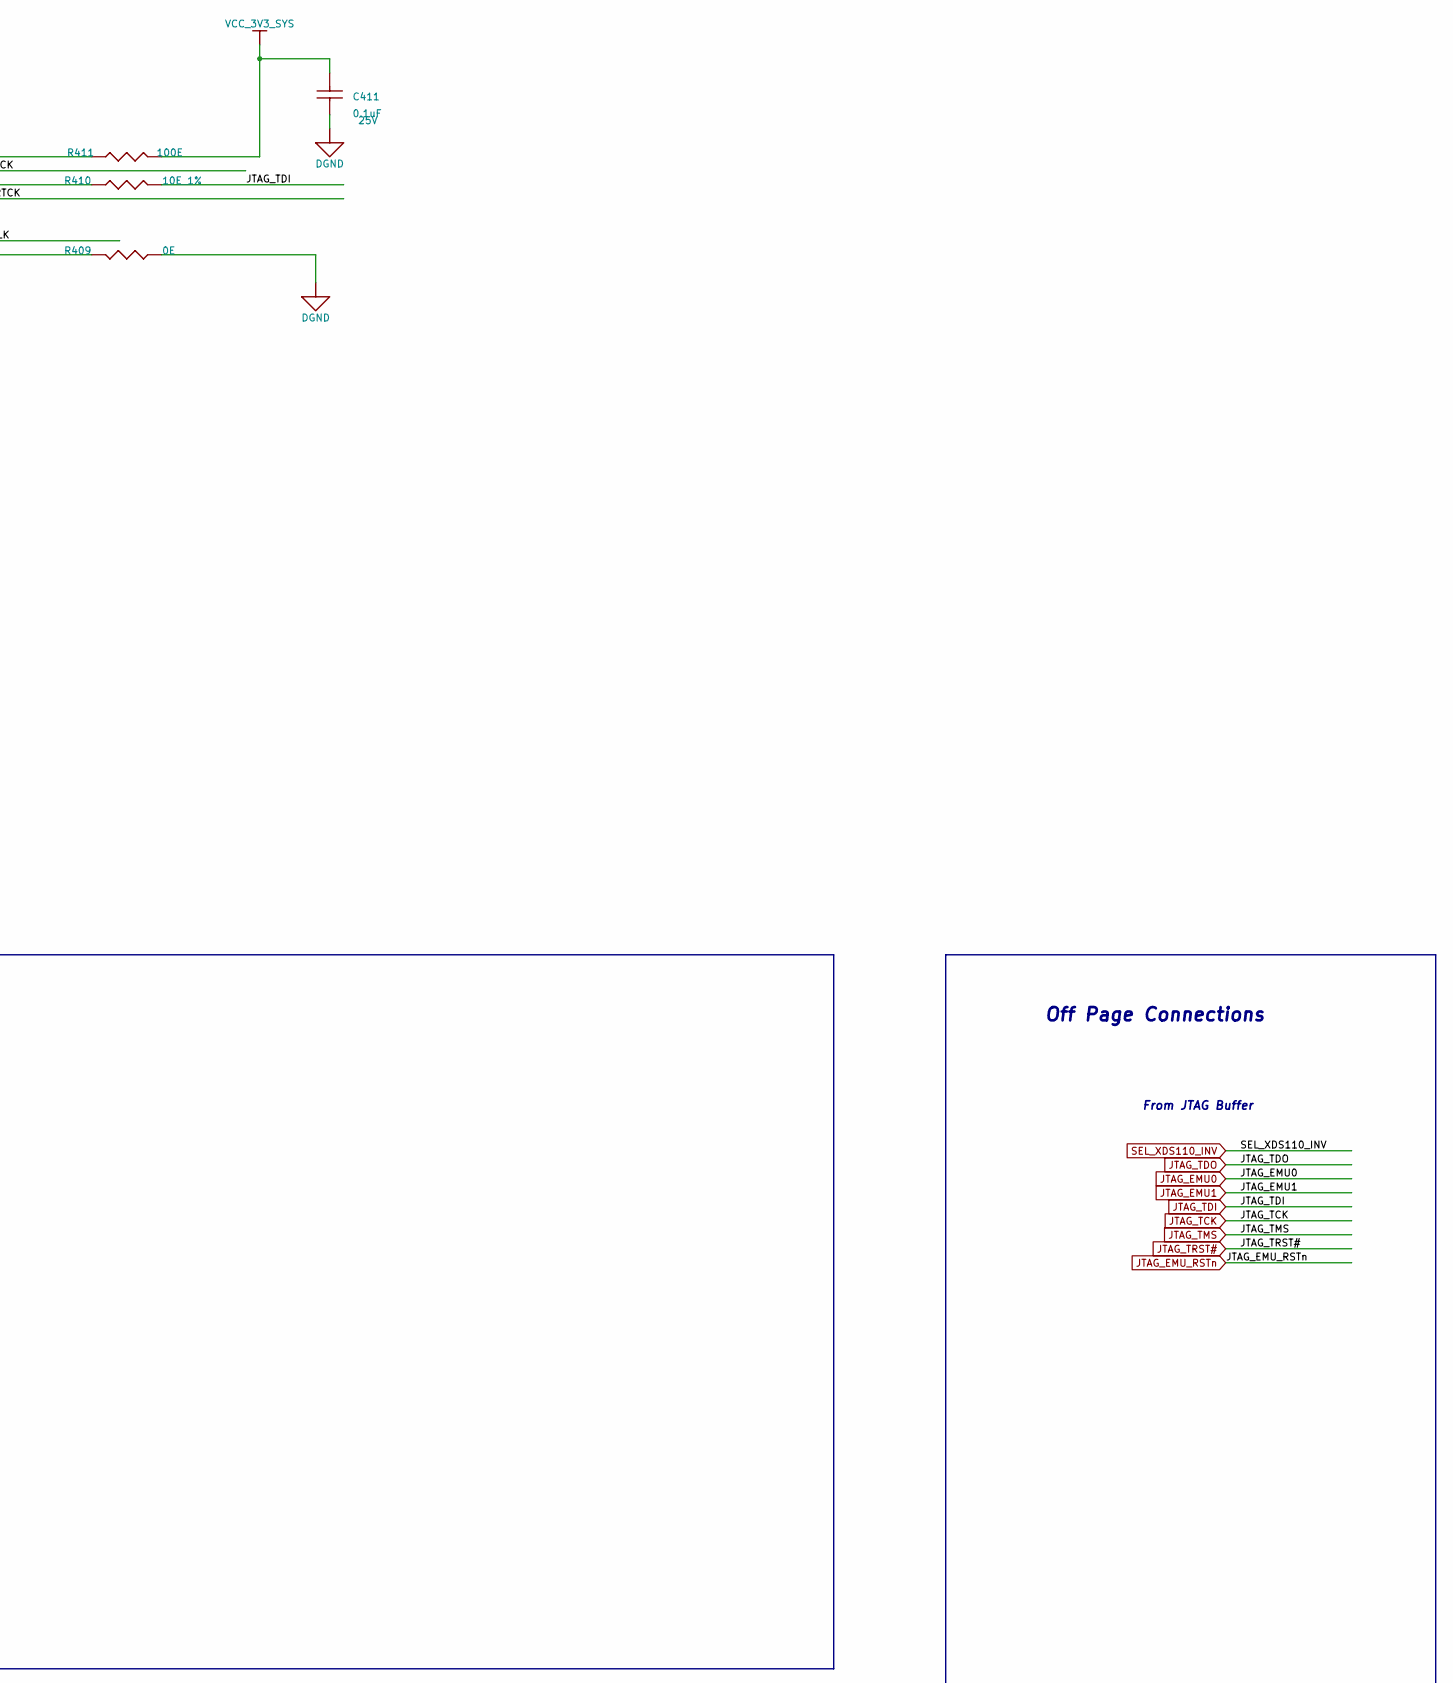
[picture p30: schematic 24.kicad_sch, part in row 1, column 2]

Parts:
C163, C164, C411: 0.1uF; CAP0402_0-75; VOLTAGE 25V; TOLERANCE 20%; PART_TYPE CAPACITOR~{S}CERAMIC
FB21: 120E; IND0603_1; VOLTAGE NA; TOLERANCE 25%; PART_TYPE INDUCTOR
R409: 0E; RES0402N; VOLTAGE NA; TOLERANCE NA; MISTRAL PART NO 110010080019-R
R410: 10E_1%; RES0402N; VOLTAGE NA; TOLERANCE 1%; MISTRAL PART NO 110018020004-R
R411, R448: 100E; RES0402N; VOLTAGE NA; TOLERANCE 5%; PART_TYPE RESISTOR~{S}FIXED
R447: 100E; RES0402N; TOLERANCE 5%; VOLTAGE NA; MISTRAL PART NO 110014060039-R
R449, R451: 10E_1%; RES0402N; TOLERANCE 1%; VOLTAGE NA; PART_TYPE RESISTOR~{S}FIXED
R450: 10E_1%; RES0402N; TOLERANCE 1%; VOLTAGE NA; MISTRAL PART NO 110018020004-R
R459: 10K; RES0402_0-5; VOLTAGE NA; TOLERANCE 5%; PART_TYPE RESISTOR~{S}FIXED
R460: 4.7K; RES0402_0-5; TOLERANCE 5%; VOLTAGE NA; MISTRAL PART NO 110011060001-R
R461: 4.7K; RES0402_0-5; VOLTAGE NA; TOLERANCE 5%; PART_TYPE RESISTOR~{S}FIXED
U48: TXS0102DCUR; VSSOP8_19-68_85X95_0-9; VOLTAGE NA; TOLERANCE NA; PART_TYPE IC~{S}INTERFAC~{E}LEVEL TRANSLATOR

Connections:
DGND: C163.1, C164.1, C411.1, R409.1, U48.2 (GND)
JTAG_EMU0: U48.8 (B1)
JTAG_EMU1: U48.1 (B2)
JTAG_EMU_RSTn: R449.1
JTAG_MIPI_EMU0: R461.2, U48.5 (A1)
JTAG_MIPI_EMU1: R460.2, U48.4 (A2)
JTAG_TDI: R410.2
JTAG_TDO: R450.1
JTAG_TMS: R451.1
JTAG_TRST#: R448.1
MIPI_TDI_R: R410.1
MIPI_TDO_R: R450.2
MIPI_TMS_R: R451.2
MIPI_TRST#_R: R448.2
unnamed: R459.1, U48.6 (OE)
VCC3V3_R: R411.1
VCC_3V3_MIPI: C164.2, FB21.2, R447.1, R459.2, R460.1, R461.1, U48.3 (VCCA)
VCC_3V3_SYS: C163.2, C411.2, FB21.1, R411.2, U48.7 (VCCB)

Notes on the sheet:
From JTAG Buffer
It should be connected to PORz of the SoC TBD
Off Page Connections
