gingerologist/am64x/25.kicad_sch

## KiCad design 25.kicad_sch (2024-08-05)

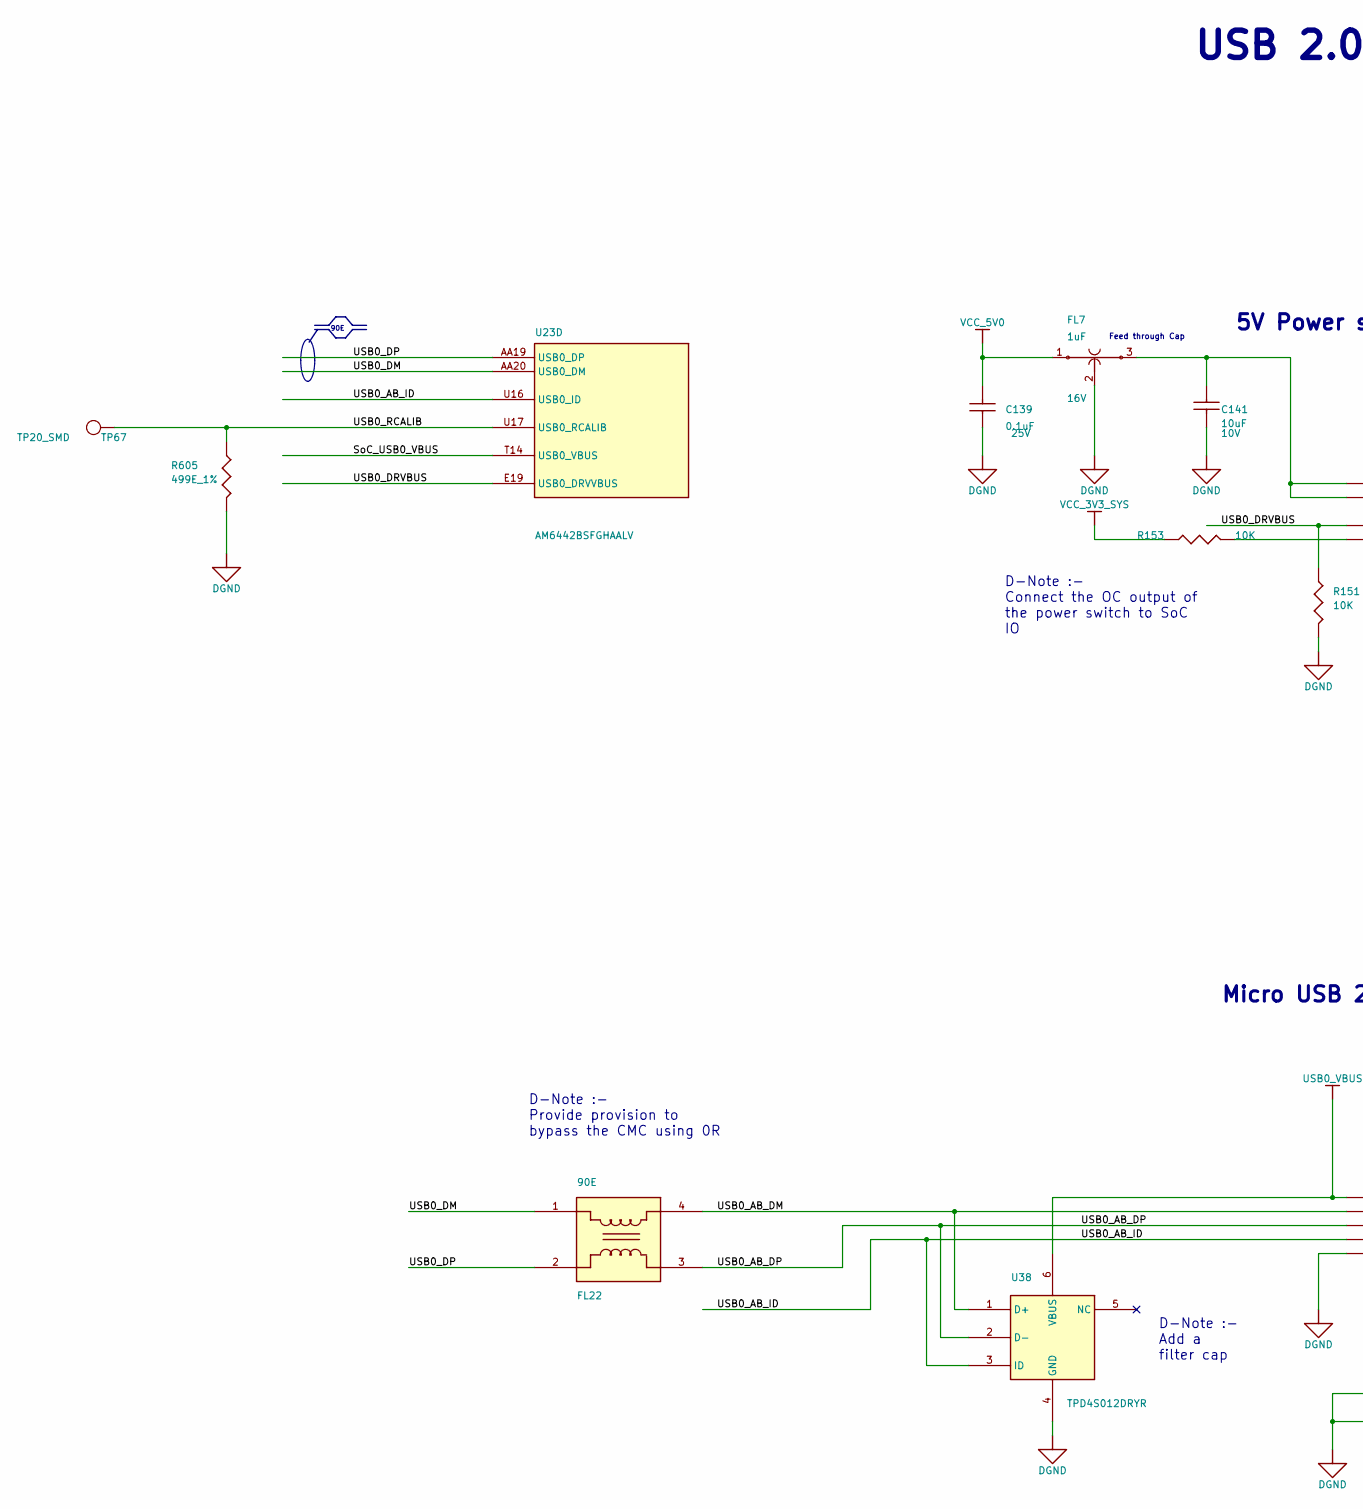
[picture p31: schematic 25.kicad_sch, part in row 1, column 1]

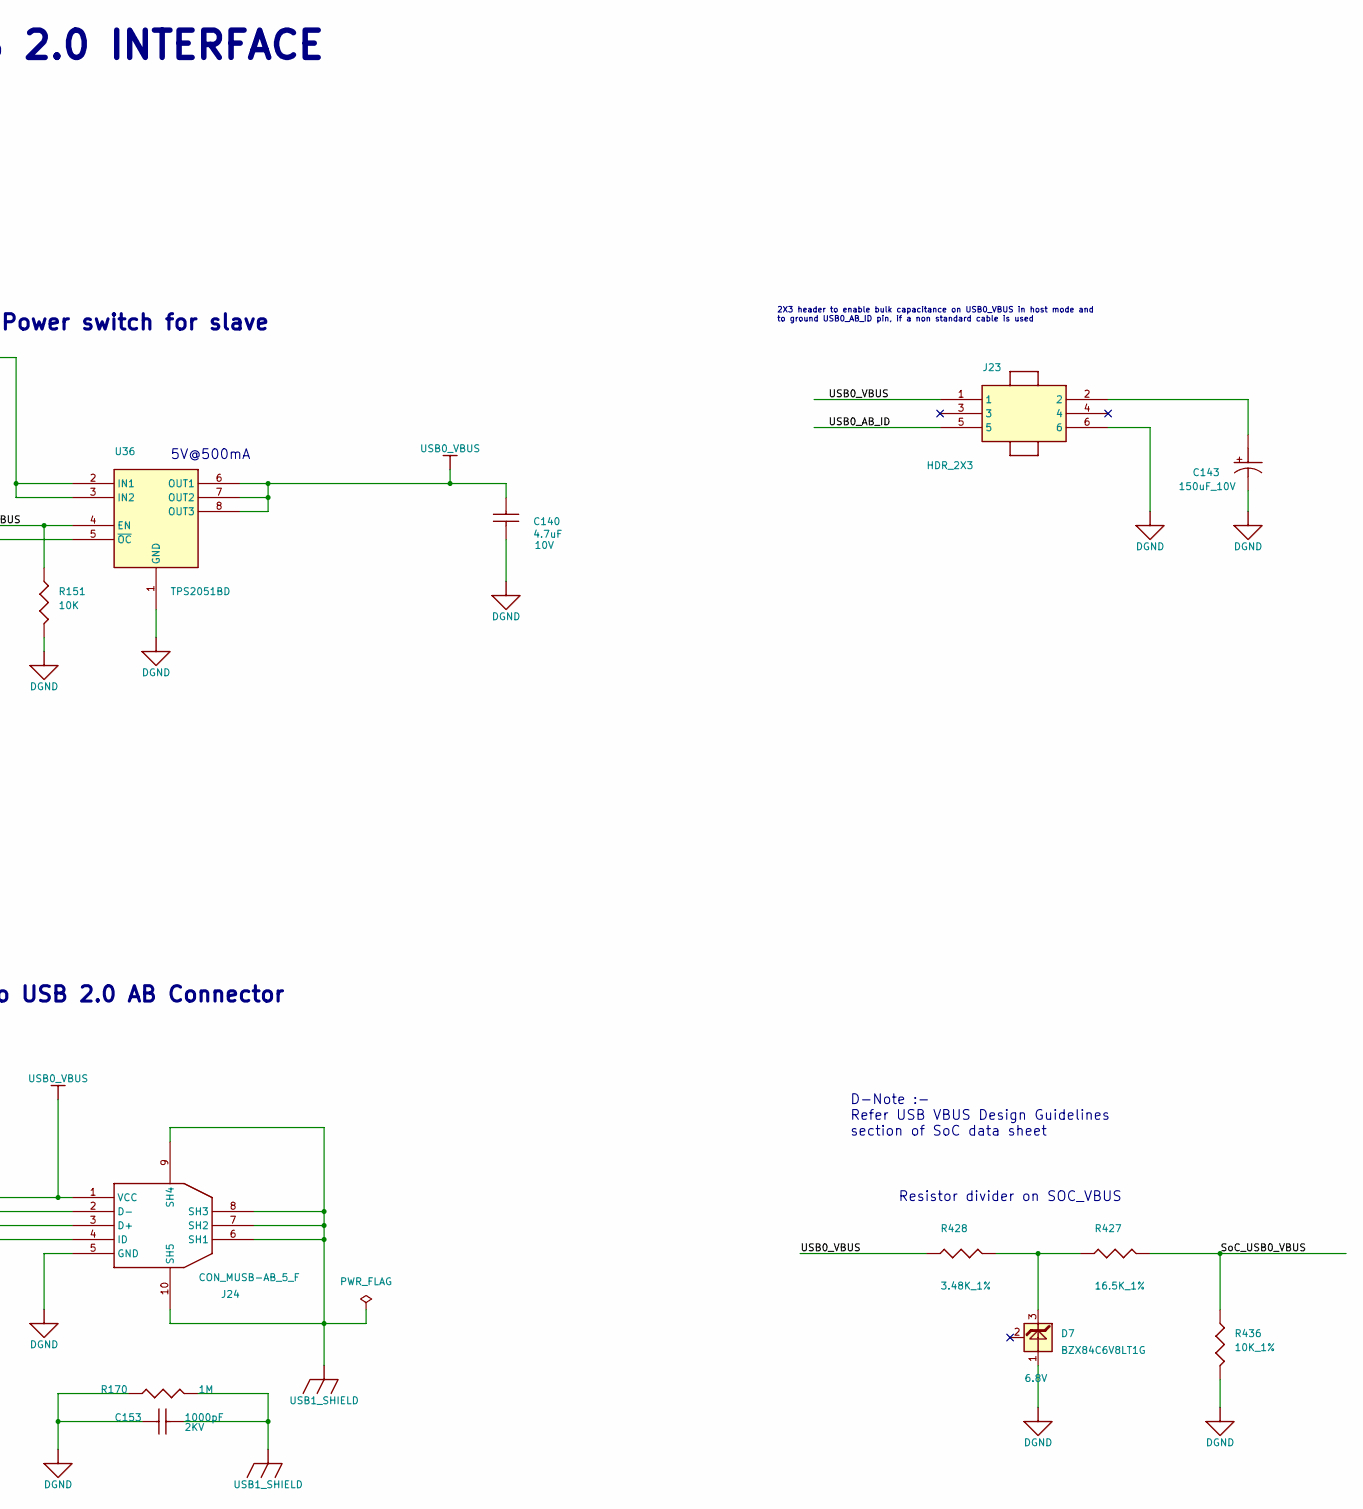
[picture p32: schematic 25.kicad_sch, part in row 1, column 2]

Parts:
C139: 0.1uF; CAP0402_0-75; TOLERANCE 20%; VOLTAGE 25V; MISTRAL PART NO 120020080003-R
C140: 4.7uF; CAP0402_0-75; TOLERANCE 20%; VOLTAGE 10V; MISTRAL PART NO 120012060002-R
C141: 10uF; CAP0402_0-75; TOLERANCE 20%; VOLTAGE 10V; MISTRAL PART NO 120013110019-R
C143: 150uF_10V; CAPT7343D_3-25; VOLTAGE 10V; TOLERANCE 10%; PART_TYPE CAPACITOR~{S}TANTALUM
C153: 1000pF; CAP1206_1-75; VOLTAGE 2KV; TOLERANCE 10%; PART_TYPE CAPACITOR~{S}CERAMIC
D7: BZX84C6V8LT1G; SOT23-123_1-2; TOLERANCE NA; VOLTAGE 6.8V; MISTRAL PART NO 130017100002-R
FL7: 1uF; FILT3_NFM21PC_0805_1; TOLERANCE NA; VOLTAGE 16V; MISTRAL PART NO 130016030041-R
FL22: 90E; IND4_ACM2012_90X50_SMD_1-3; VOLTAGE NA; TOLERANCE NA; MISTRAL PART NO 130009030803-R
J23: HDR_2X3; CON_3X2_SM_2MM; VOLTAGE NA; TOLERANCE NA; PART_TYPE CONNECTO~{R}HEADERS
J24: CON_MUSB-AB_5_F; CON_USBAB5_ZX62RD-AB-5P8_S_R_S_3-2; VOLTAGE NA; TOLERANCE NA; PART_TYPE CONNECTO~{R}USB
R151, R153: 10K; RES0402_0-5; VOLTAGE NA; TOLERANCE 5%; PART_TYPE RESISTOR~{S}FIXED
R170: 1M; RES0603_0-75; TOLERANCE 5%; VOLTAGE NA; MISTRAL PART NO 110009030413-R
R427: 16.5K_1%; RES0402_0-5; VOLTAGE NA; TOLERANCE 1%; PART_TYPE RESISTOR~{S}FIXED
R428: 3.48K_1%; RES0402_0-5; VOLTAGE NA; TOLERANCE 1%; PART_TYPE RESISTOR~{S}FIXED
R436: 10K_1%; RES0402_0-5; VOLTAGE NA; TOLERANCE 1%; PART_TYPE RESISTOR~{S}FIXED
R605: 499E_1%; RES0402_0-5; VOLTAGE NA; TOLERANCE 1%; PART_TYPE RESISTOR~{S}FIXED
TP67: TP20_SMD; VOLTAGE NA; TOLERANCE NA; PART_TYPE TESTPOINT
U23: AM6442BSFGHAALV; FCBGA441_31-49_680X680_2-6; VOLTAGE NA; TOLERANCE NA; PART_TYPE IC~{S}DIGITA~{L}MICROPROCESSOR
U36: TPS2051BD; SOIC8_1-8; VOLTAGE NA; TOLERANCE NA; PART_TYPE IC~{S}POWER
U38: TPD4S012DRYR; SON6_SN74LVC2G17_40X60_0-6; TOLERANCE NA; VOLTAGE NA; MISTRAL PART NO 141011080022-R

Connections:
DGND: C139.1, C140.2, C141.2, C143.2, C153.1, D7.1 (A), FL7.2 (GND), J23.6, J24.5 (GND), R151.2, R170.1, R436.2, R605.2, U36.1 (GND), U38.4 (GND)
unnamed: C141.1, FL7.3 (OUTPUT), U36.2 (IN1), U36.3 (IN2)
unnamed: C143.1, J23.2
unnamed: D7.3 (C), R427.1, R428.2
unnamed: R153.2, U36.5 (~OC)
SoC_USB0_VBUS: R427.2, R436.1, U23.T14 (USB0_VBUS)
USB0_AB_DM: FL22.4, J24.2 (D-), U38.1 (D+)
USB0_AB_DP: FL22.3, J24.3 (D+), U38.2 (D-)
USB0_AB_ID: J23.5, J24.4 (ID), U23.U16 (USB0_ID), U38.3 (ID)
USB0_DM: FL22.1, U23.AA20 (USB0_DM)
USB0_DP: FL22.2, U23.AA19 (USB0_DP)
USB0_DRVBUS: R151.1, U23.E19 (USB0_DRVVBUS), U36.4 (EN)
USB0_RCALIB: R605.1, TP67.1, U23.U17 (USB0_RCALIB)
USB0_VBUS: C140.1, J23.1, J24.1 (VCC), R428.1, U36.6 (OUT1), U36.7 (OUT2), U36.8 (OUT3), U38.6 (VBUS)
USB1_SHIELD: C153.2, J24.6 (SH1), J24.7 (SH2), J24.8 (SH3), J24.9 (SH4), J24.10 (SH5), R170.2
VCC_3V3_SYS: R153.1
VCC_5V0: C139.2, FL7.1 (INPUT)

Notes on the sheet:
D-Note :- Provide provision to bypass the CMC using 0R
D-Note :- Refer USB VBUS Design Guidelines section of SoC data sheet
2X3 header to enable bulk capacitance on USB0_VBUS in host mode and to ground USB0_AB_ID pin, if a non standard cable is used
D-Note :- Connect the OC output of the power switch to SoC IO
D-Note :- Add a filter cap
5V Power switch for slave
Feed through Cap
USB 2.0 INTERFACE
Micro USB 2.0 AB Connector
5V@500mA
Resistor divider on SOC_VBUS
90E
