gingerologist/am64x/26.kicad_sch

## KiCad design 26.kicad_sch (2024-07-26)

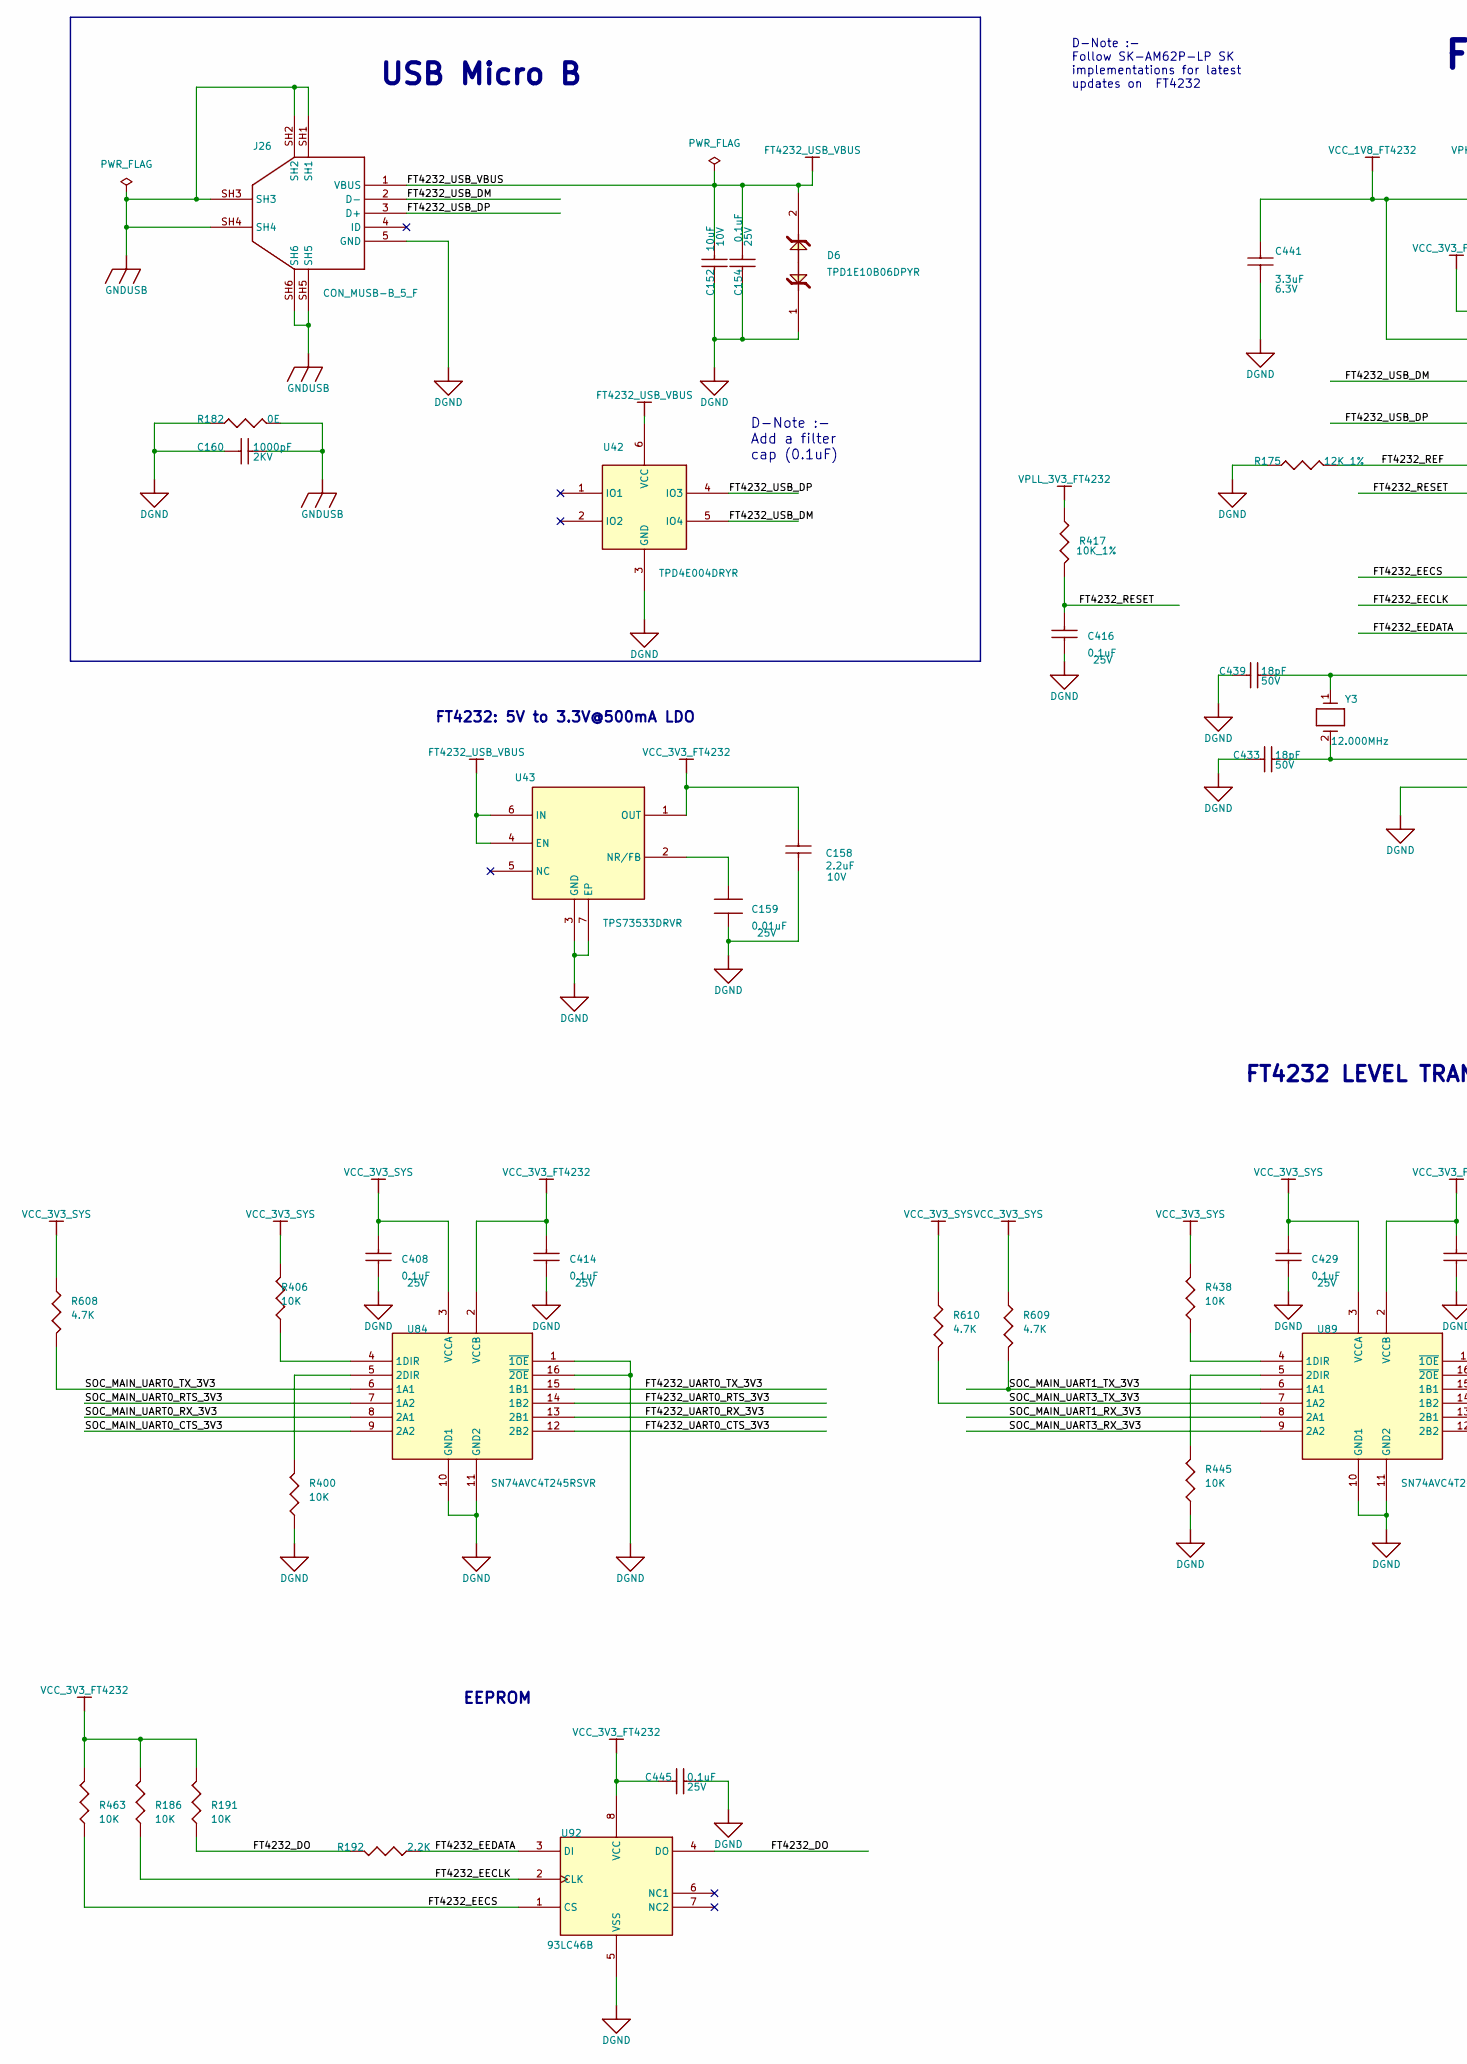
[picture p33: schematic 26.kicad_sch, part in row 1, column 1]

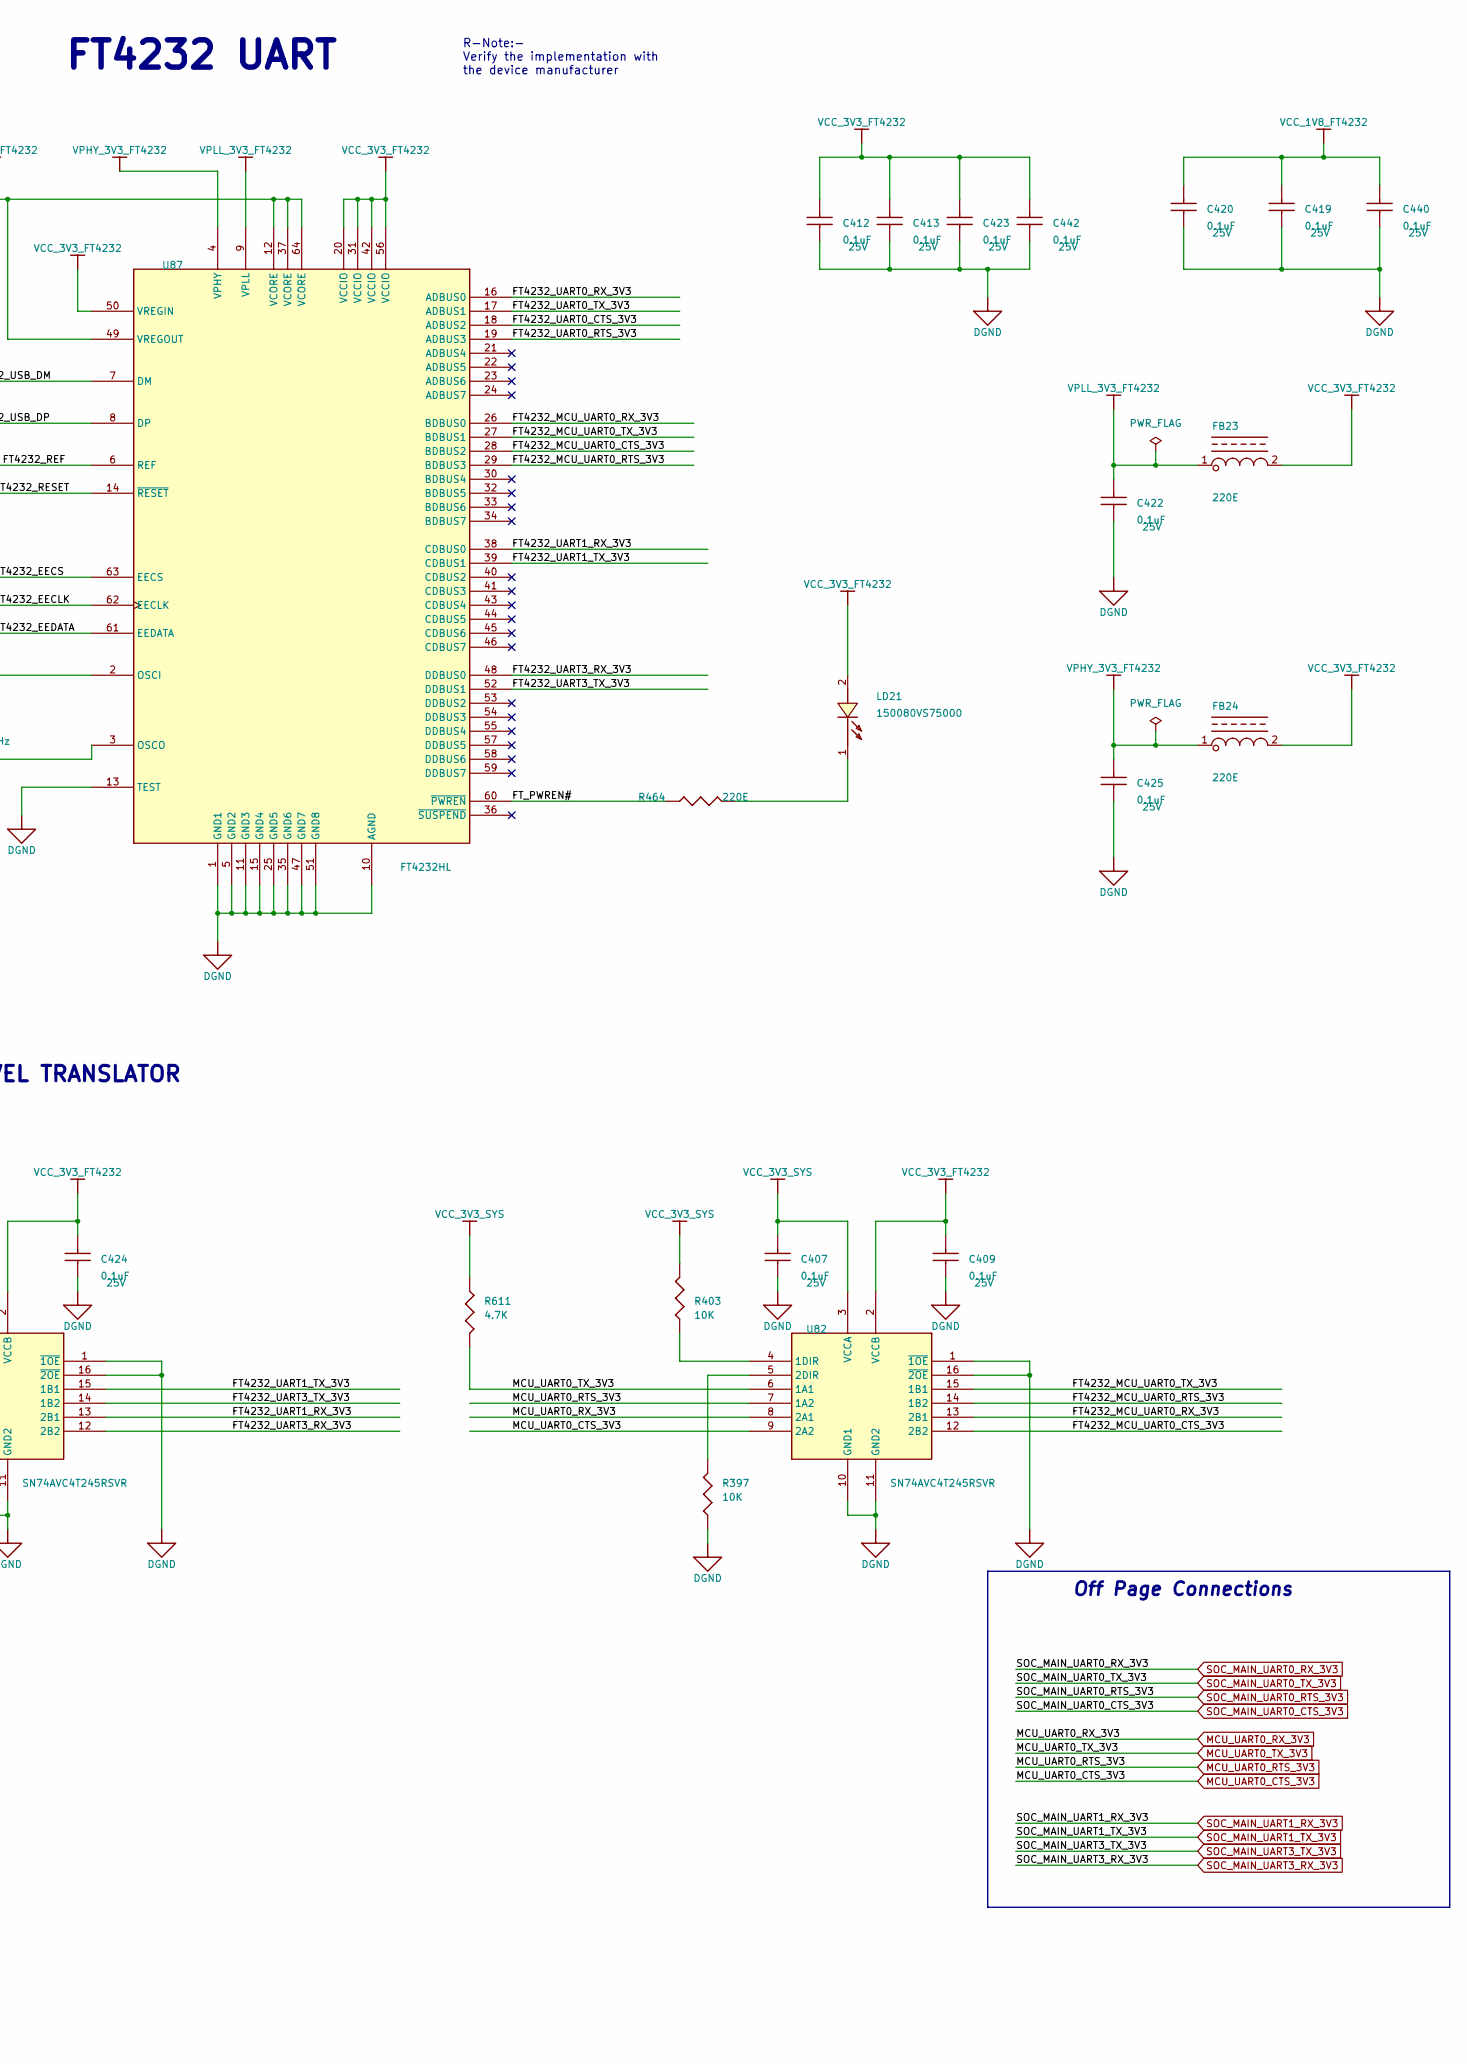
[picture p34: schematic 26.kicad_sch, part in row 1, column 2]

Parts:
C152: 10uF; CAP0402_0-75; VOLTAGE 10V; TOLERANCE 20%; PART_TYPE CAPACITOR~{S}CERAMIC
C154, C408, C412, C413, C414, C416, C442, C445: 0.1uF; CAP0402_0-75; VOLTAGE 25V; TOLERANCE 20%; PART_TYPE CAPACITOR~{S}CERAMIC
C158: 2.2uF; CAP0402_0-75; VOLTAGE 10V; TOLERANCE 20%; PART_TYPE CAPACITOR~{S}CERAMIC
C159: 0.01uF; CAP0402N; TOLERANCE 10%; VOLTAGE 25V; MISTRAL PART NO 120011090040-R
C160: 1000pF; CAP1206_1-75; VOLTAGE 2KV; TOLERANCE 10%; PART_TYPE CAPACITOR~{S}CERAMIC
C407, C409, C419, C420, C422, C423, C424, C425, C429, C440: 0.1uF; CAP0402_0-75; TOLERANCE 20%; VOLTAGE 25V; MISTRAL PART NO 120020080003-R
C433: 18pF; CAP0402_0-75; VOLTAGE 50V; TOLERANCE 5%; PART_TYPE CAPACITOR~{S}CERAMIC
C439: 18pF; CAP0402_0-75; TOLERANCE 5%; VOLTAGE 50V; MISTRAL PART NO 120011090034-R
C441: 3.3uF; CAP0603_1; VOLTAGE 6.3V; TOLERANCE 20%; PART_TYPE CAPACITOR~{S}CERAMIC
D6: TPD1E10B06DPYR; DIO_DFN0402_0-5; TOLERANCE NA; VOLTAGE NA; MISTRAL PART NO 130014110022-R
FB23, FB24: 220E; IND0402_0-6; TOLERANCE 25%; VOLTAGE NA; MISTRAL PART NO 130020080018-R
J26: CON_MUSB-B_5_F; CON_MUSBB5_1051640001_S_R_S_2-5; VOLTAGE NA; TOLERANCE NA; PART_TYPE CONNECTO~{R}USB
LD21: 150080VS75000; LED_150080VS75000_80X50_SMD_0-8; TOLERANCE NA; VOLTAGE NA; MISTRAL PART NO 130020080012-R
R175: 12K_1%; RES0402_0-5; TOLERANCE 1%; VOLTAGE NA; MISTRAL PART NO 110019040053-R
R182: 0E; RES1206_0-75; TOLERANCE NA; VOLTAGE NA; MISTRAL PART NO 110010030045-R
R186, R191, R397, R403, R406, R438, R445: 10K; RES0402_0-5; VOLTAGE NA; TOLERANCE 5%; PART_TYPE RESISTOR~{S}FIXED
R192: 2.2K; RES0402_0-5; TOLERANCE 5%; VOLTAGE NA; MISTRAL PART NO 110010120018-R
R400, R463: 10K; RES0402_0-5; TOLERANCE 5%; VOLTAGE NA; MISTRAL PART NO 110011060021-R
R417: 10K_1%; RES0402N; VOLTAGE NA; TOLERANCE 1%; MISTRAL PART NO 110015090015-R
R464: 220E; RES0402_0-5; TOLERANCE 5%; VOLTAGE NA; MISTRAL PART NO 110009030506-R
R608, R610, R611: 4.7K; RES0402_0-5; TOLERANCE 5%; VOLTAGE NA; MISTRAL PART NO 110011060001-R
R609: 4.7K; RES0402_0-5; VOLTAGE NA; TOLERANCE 5%; PART_TYPE RESISTOR~{S}FIXED
U42: TPD4E004DRYR; SON6_19-68_40X60_PB_0-6; TOLERANCE NA; VOLTAGE NA; MISTRAL PART NO 141010020012-R
U43: TPS73533DRVR; SON6_25-59_85X85; VOLTAGE NA; TOLERANCE NA; PART_TYPE IC~{S}POWE~{R}VOLTAGE REGULATOR
U82, U89: SN74AVC4T245RSVR; UQFN16_TMUX1574_70X100_0-6; VOLTAGE NA; TOLERANCE NA; PART_TYPE IC~{S}DIGITA~{L}BUSTRANSCEIVER
U84: SN74AVC4T245RSVR; UQFN16_TMUX1574_70X100_0-6; TOLERANCE NA; VOLTAGE NA; MISTRAL PART NO 141011040011-R
U87: FT4232HL; LQF64; TOLERANCE NA; VOLTAGE NA; MISTRAL PART NO 141013080006-R
U92: 93LC46B; MSOP8_25-59_125X125_1-1; TOLERANCE NA; VOLTAGE NA; MISTRAL PART NO 141118020002-R
Y3: 12.000MHz; XTAL_ABM3_205X130_SMD_1-4; TOLERANCE NA; VOLTAGE NA; MISTRAL PART NO 130018080040-R

Connections:
DGND: C152.1, C154.1, C158.2, C159.1, C160.1, C407.1, C408.1, C409.1, C412.1, C413.1, C414.1, C416.1, C419.1, C420.1, C422.1, C423.1, C424.1, C425.1, C429.1, C433.2, C439.2, C440.1, C441.2, C442.1, C445.1, D6.1, J26.5 (GND), R175.1, R182.1, R397.1, R400.1, R445.1, U42.3 (GND), U43.3 (GND), U43.7 (EP), U82.1 (~1OE), U82.10 (GND1), U82.11 (GND2), U82.16 (~2OE), U84.1 (~1OE), U84.10 (GND1), U84.11 (GND2), U84.16 (~2OE), U87.1 (GND1), U87.5 (GND2), U87.10 (AGND), U87.11 (GND3), U87.13 (TEST), U87.15 (GND4), U87.25 (GND5), U87.35 (GND6), U87.47 (GND7), U87.51 (GND8), U89.1 (~1OE), U89.10 (GND1), U89.11 (GND2), U89.16 (~2OE), U92.5 (VSS)
FT4232_DO: R191.1, R192.2, U92.4 (DO)
FT4232_EECLK: R186.1, U87.62 (EECLK), U92.2 (CLK)
FT4232_EECS: R463.1, U87.63 (EECS), U92.1 (CS)
FT4232_EEDATA: R192.1, U87.61 (EEDATA), U92.3 (DI)
FT4232_MCU_UART0_CTS_3V3: U82.12 (2B2), U87.28 (BDBUS2)
FT4232_MCU_UART0_RTS_3V3: U82.14 (1B2), U87.29 (BDBUS3)
FT4232_MCU_UART0_RX_3V3: U82.13 (2B1), U87.26 (BDBUS0)
FT4232_MCU_UART0_TX_3V3: U82.15 (1B1), U87.27 (BDBUS1)
FT4232_REF: R175.2, U87.6 (REF)
FT4232_RESET: C416.2, R417.1, U87.14 (~RESET)
FT4232_UART0_CTS_3V3: U84.12 (2B2), U87.18 (ADBUS2)
FT4232_UART0_RTS_3V3: U84.14 (1B2), U87.19 (ADBUS3)
FT4232_UART0_RX_3V3: U84.13 (2B1), U87.16 (ADBUS0)
FT4232_UART0_TX_3V3: U84.15 (1B1), U87.17 (ADBUS1)
FT4232_UART1_RX_3V3: U87.38 (CDBUS0), U89.13 (2B1)
FT4232_UART1_TX_3V3: U87.39 (CDBUS1), U89.15 (1B1)
FT4232_UART3_RX_3V3: U87.48 (DDBUS0), U89.12 (2B2)
FT4232_UART3_TX_3V3: U87.52 (DDBUS1), U89.14 (1B2)
FT4232_USB_DM: J26.2 (D-), U42.5 (IO4), U87.7 (DM)
FT4232_USB_DP: J26.3 (D+), U42.4 (IO3), U87.8 (DP)
FT4232_USB_VBUS: C152.2, C154.2, D6.2, J26.1 (VBUS), U42.6 (VCC), U43.4 (EN), U43.6 (IN)
FT_PWREN#: R464.1, U87.60 (~PWREN)
GNDUSB: C160.2, J26.SH1, J26.SH2, J26.SH3, J26.SH4, J26.SH5, J26.SH6, R182.2
MCU_UART0_CTS_3V3: U82.9 (2A2)
MCU_UART0_RTS_3V3: U82.7 (1A2)
MCU_UART0_RX_3V3: U82.8 (2A1)
MCU_UART0_TX_3V3: R611.2, U82.6 (1A1)
unnamed: C159.2, U43.2 (NR/FB)
unnamed: C433.1, U87.3 (OSCO), Y3.2
unnamed: C439.1, U87.2 (OSCI), Y3.1
unnamed: LD21.1 (CATHODE), R464.2
unnamed: R397.2, U82.5 (2DIR)
unnamed: R400.2, U84.5 (2DIR)
unnamed: R403.1, U82.4 (1DIR)
unnamed: R406.1, U84.4 (1DIR)
unnamed: R438.1, U89.4 (1DIR)
unnamed: R445.2, U89.5 (2DIR)
SOC_MAIN_UART0_CTS_3V3: U84.9 (2A2)
SOC_MAIN_UART0_RTS_3V3: U84.7 (1A2)
SOC_MAIN_UART0_RX_3V3: U84.8 (2A1)
SOC_MAIN_UART0_TX_3V3: R608.2, U84.6 (1A1)
SOC_MAIN_UART1_RX_3V3: U89.8 (2A1)
SOC_MAIN_UART1_TX_3V3: R609.2, U89.6 (1A1)
SOC_MAIN_UART3_RX_3V3: U89.9 (2A2)
SOC_MAIN_UART3_TX_3V3: R610.2, U89.7 (1A2)
VCC_1V8_FT4232: C419.2, C420.2, C440.2, C441.1, U87.12 (VCORE), U87.37 (VCORE), U87.49 (VREGOUT), U87.64 (VCORE)
VCC_3V3_FT4232: C158.1, C409.2, C412.2, C413.2, C414.2, C423.2, C424.2, C442.2, C445.2, FB23.2, FB24.2, LD21.2 (ANODE), R186.2, R191.2, R463.2, U43.1 (OUT), U82.2 (VCCB), U84.2 (VCCB), U87.20 (VCCIO), U87.31 (VCCIO), U87.42 (VCCIO), U87.50 (VREGIN), U87.56 (VCCIO), U89.2 (VCCB), U92.8 (VCC)
VCC_3V3_SYS: C407.2, C408.2, C429.2, R403.2, R406.2, R438.2, R608.1, R609.1, R610.1, R611.1, U82.3 (VCCA), U84.3 (VCCA), U89.3 (VCCA)
VPHY_3V3_FT4232: C425.2, FB24.1, U87.4 (VPHY)
VPLL_3V3_FT4232: C422.2, FB23.1, R417.2, U87.9 (VPLL)

Notes on the sheet:
D-Note :- Follow SK-AM62P-LP SK implementations for latest updates on FT4232
R-Note:- Verify the implementation with the device manufacturer
D-Note :- Add a filter cap (0.1uF)
FT4232 UART
FT4232: 5V to 3.3V@500mA LDO
USB Micro B
Off Page Connections
FT4232 LEVEL TRANSLATOR
EEPROM
