gingerologist/am64x/27.kicad_sch

## KiCad design 27.kicad_sch (2024-08-05)

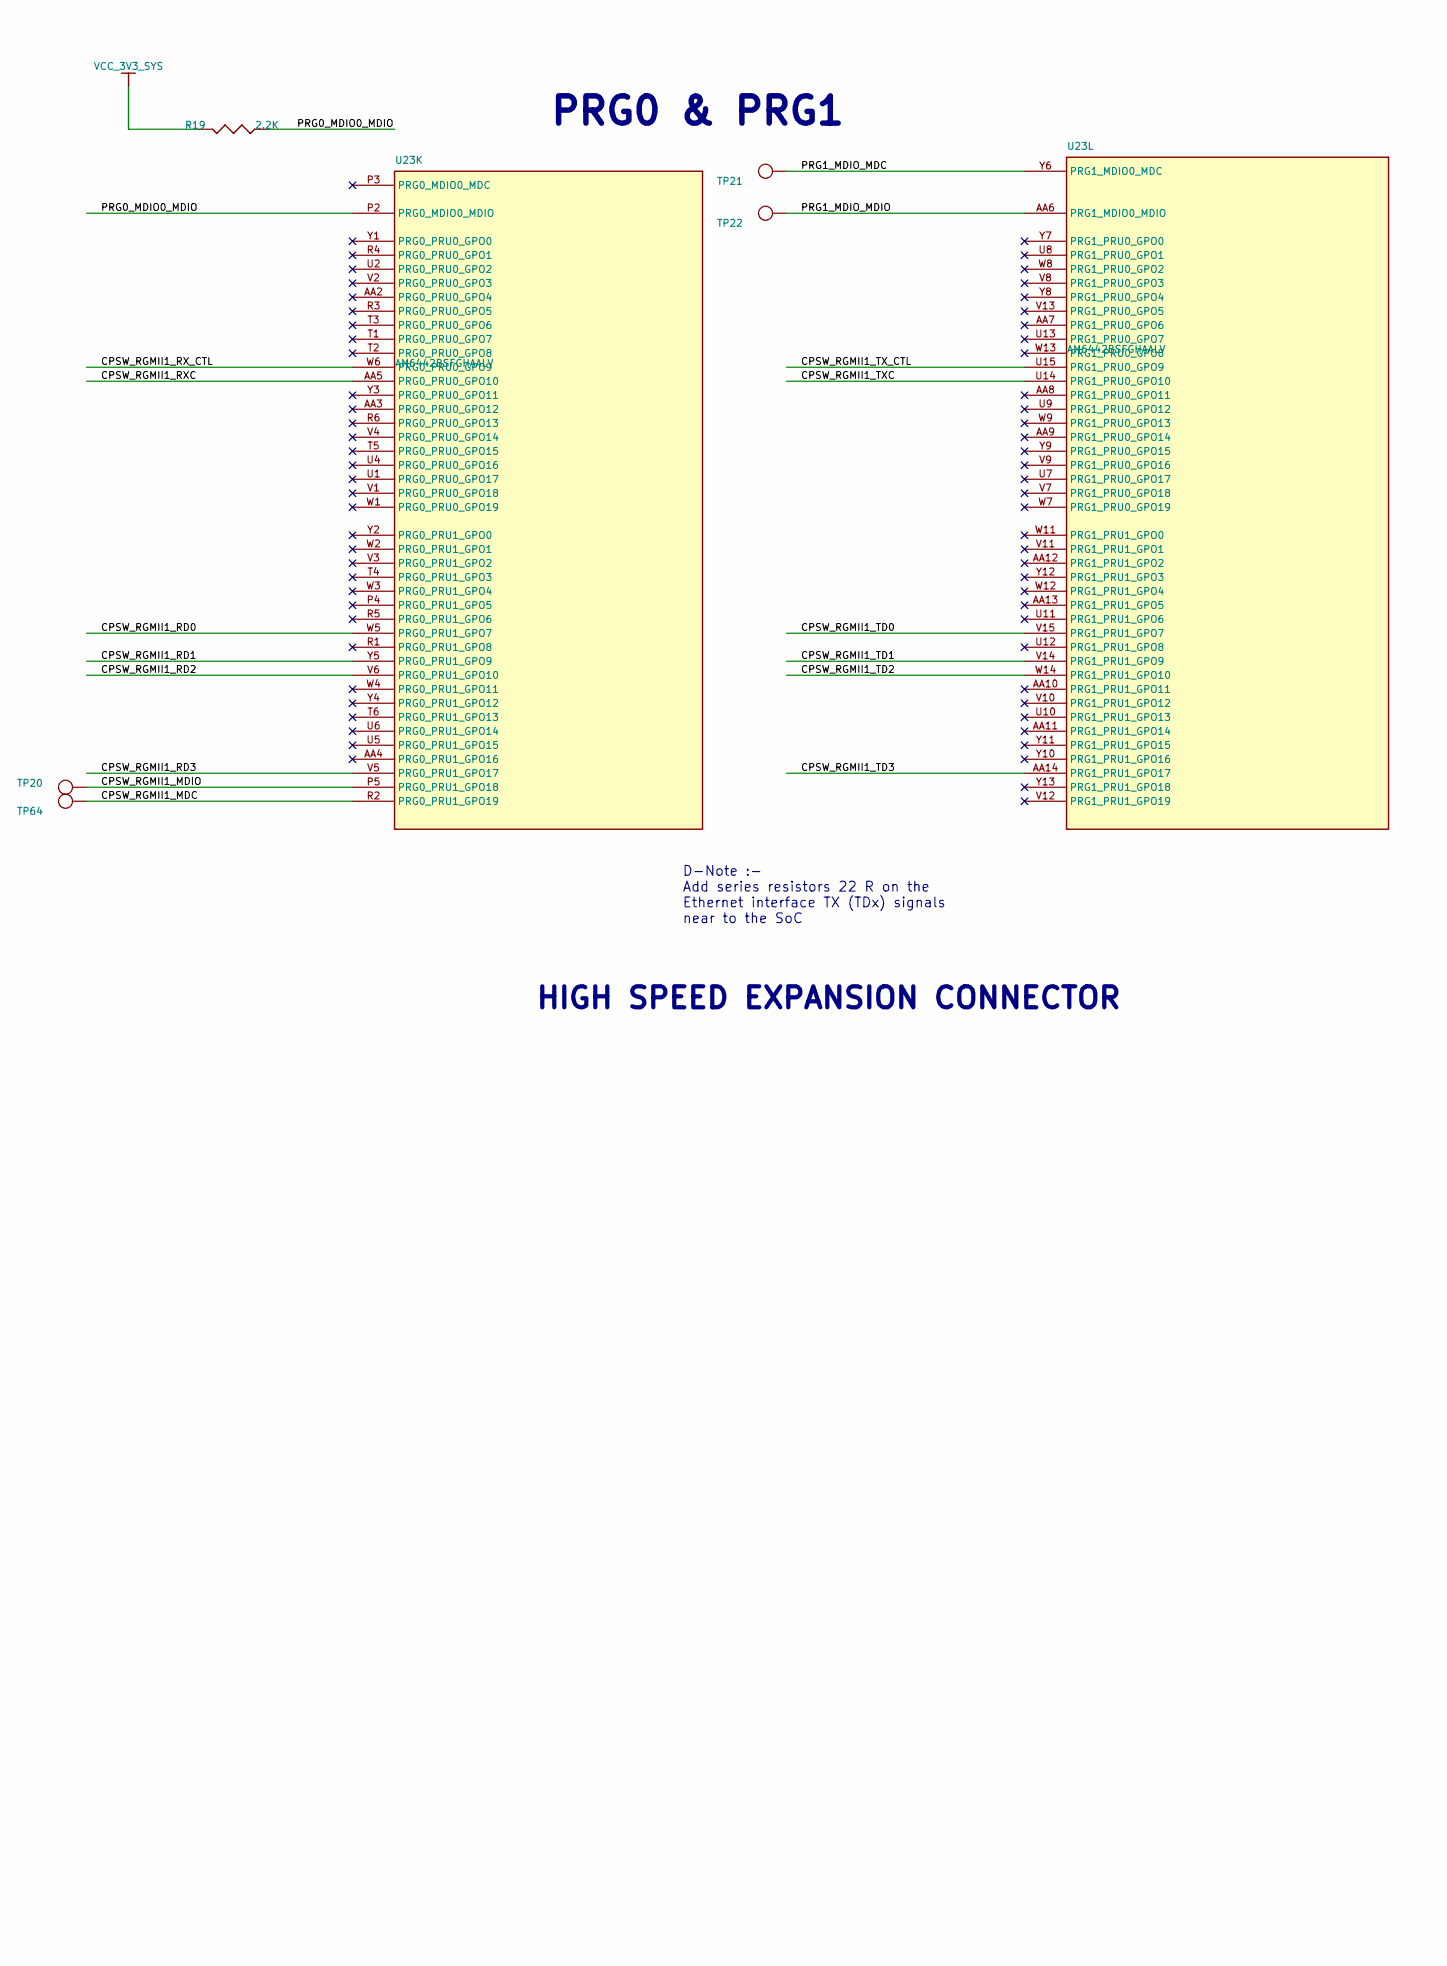
[picture p35: schematic 27.kicad_sch, part in row 1, column 1]

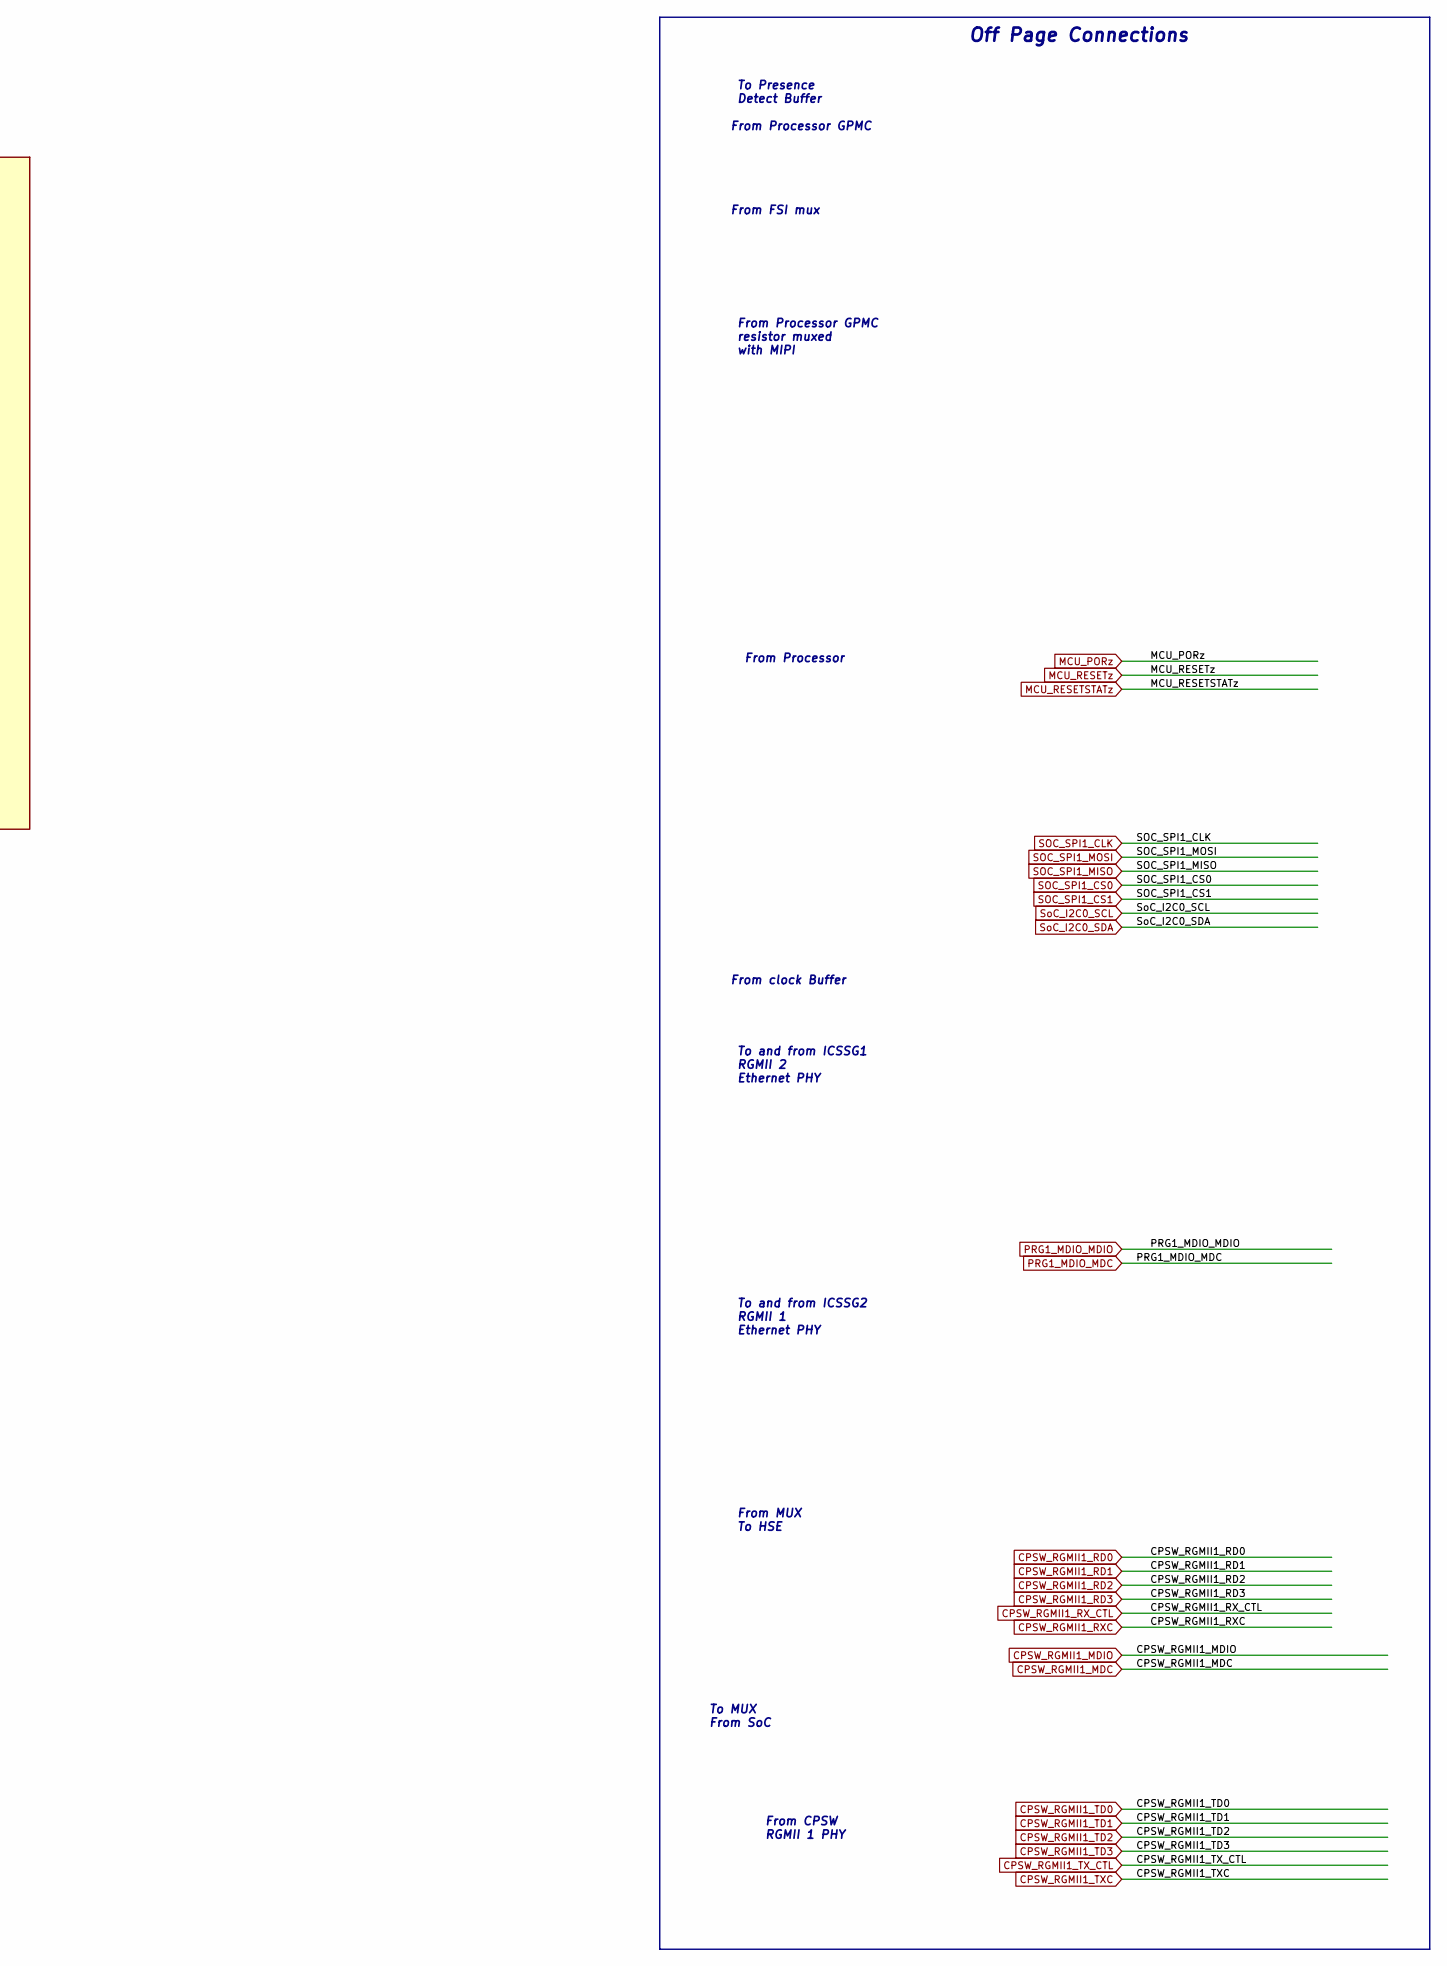
[picture p36: schematic 27.kicad_sch, part in row 1, column 2]

Parts:
R19: 2.2K; RES0402_0-5; TOLERANCE 5%; VOLTAGE NA; MISTRAL PART NO 110010120018-R
TP20, TP21, TP64: TP20_SMD; TOLERANCE NA; VOLTAGE NA; MISTRAL PART NO NA
TP22: TP20_SMD; VOLTAGE NA; TOLERANCE NA; PART_TYPE TESTPOINT
U23: AM6442BSFGHAALV; FCBGA441_31-49_680X680_2-6; TOLERANCE NA; VOLTAGE NA; MISTRAL PART NO 141220080002

Connections:
CPSW_RGMII1_MDC: TP64.1, U23.R2 (PRG0_PRU1_GPO19)
CPSW_RGMII1_MDIO: TP20.1, U23.P5 (PRG0_PRU1_GPO18)
CPSW_RGMII1_RD0: U23.W5 (PRG0_PRU1_GPO7)
CPSW_RGMII1_RD1: U23.Y5 (PRG0_PRU1_GPO9)
CPSW_RGMII1_RD2: U23.V6 (PRG0_PRU1_GPO10)
CPSW_RGMII1_RD3: U23.V5 (PRG0_PRU1_GPO17)
CPSW_RGMII1_RXC: U23.AA5 (PRG0_PRU0_GPO10)
CPSW_RGMII1_RX_CTL: U23.W6 (PRG0_PRU0_GPO9)
CPSW_RGMII1_TD0: U23.V15 (PRG1_PRU1_GPO7)
CPSW_RGMII1_TD1: U23.V14 (PRG1_PRU1_GPO9)
CPSW_RGMII1_TD2: U23.W14 (PRG1_PRU1_GPO10)
CPSW_RGMII1_TD3: U23.AA14 (PRG1_PRU1_GPO17)
CPSW_RGMII1_TXC: U23.U14 (PRG1_PRU0_GPO10)
CPSW_RGMII1_TX_CTL: U23.U15 (PRG1_PRU0_GPO9)
PRG0_MDIO0_MDIO: R19.1, U23.P2 (PRG0_MDIO0_MDIO)
PRG1_MDIO_MDC: TP21.1, U23.Y6 (PRG1_MDIO0_MDC)
PRG1_MDIO_MDIO: TP22.1, U23.AA6 (PRG1_MDIO0_MDIO)
VCC_3V3_SYS: R19.2

Notes on the sheet:
To Presence Detect Buffer
From MUX To HSE
To and from ICSSG1 RGMII 2 Ethernet PHY
D-Note :- Add series resistors 22 R on the Ethernet interface TX (TDx) signals near to the SoC
From Processor GPMC resistor muxed with MIPI
To and from ICSSG2 RGMII 1 Ethernet PHY
To MUX From SoC
From CPSW RGMII 1 PHY
From clock Buffer
HIGH SPEED EXPANSION CONNECTOR
Off Page Connections
From Processor
PRG0 & PRG1
From Processor GPMC
From FSI mux
