gingerologist/am64x/29.kicad_sch

## KiCad design 29.kicad_sch (2024-08-05)

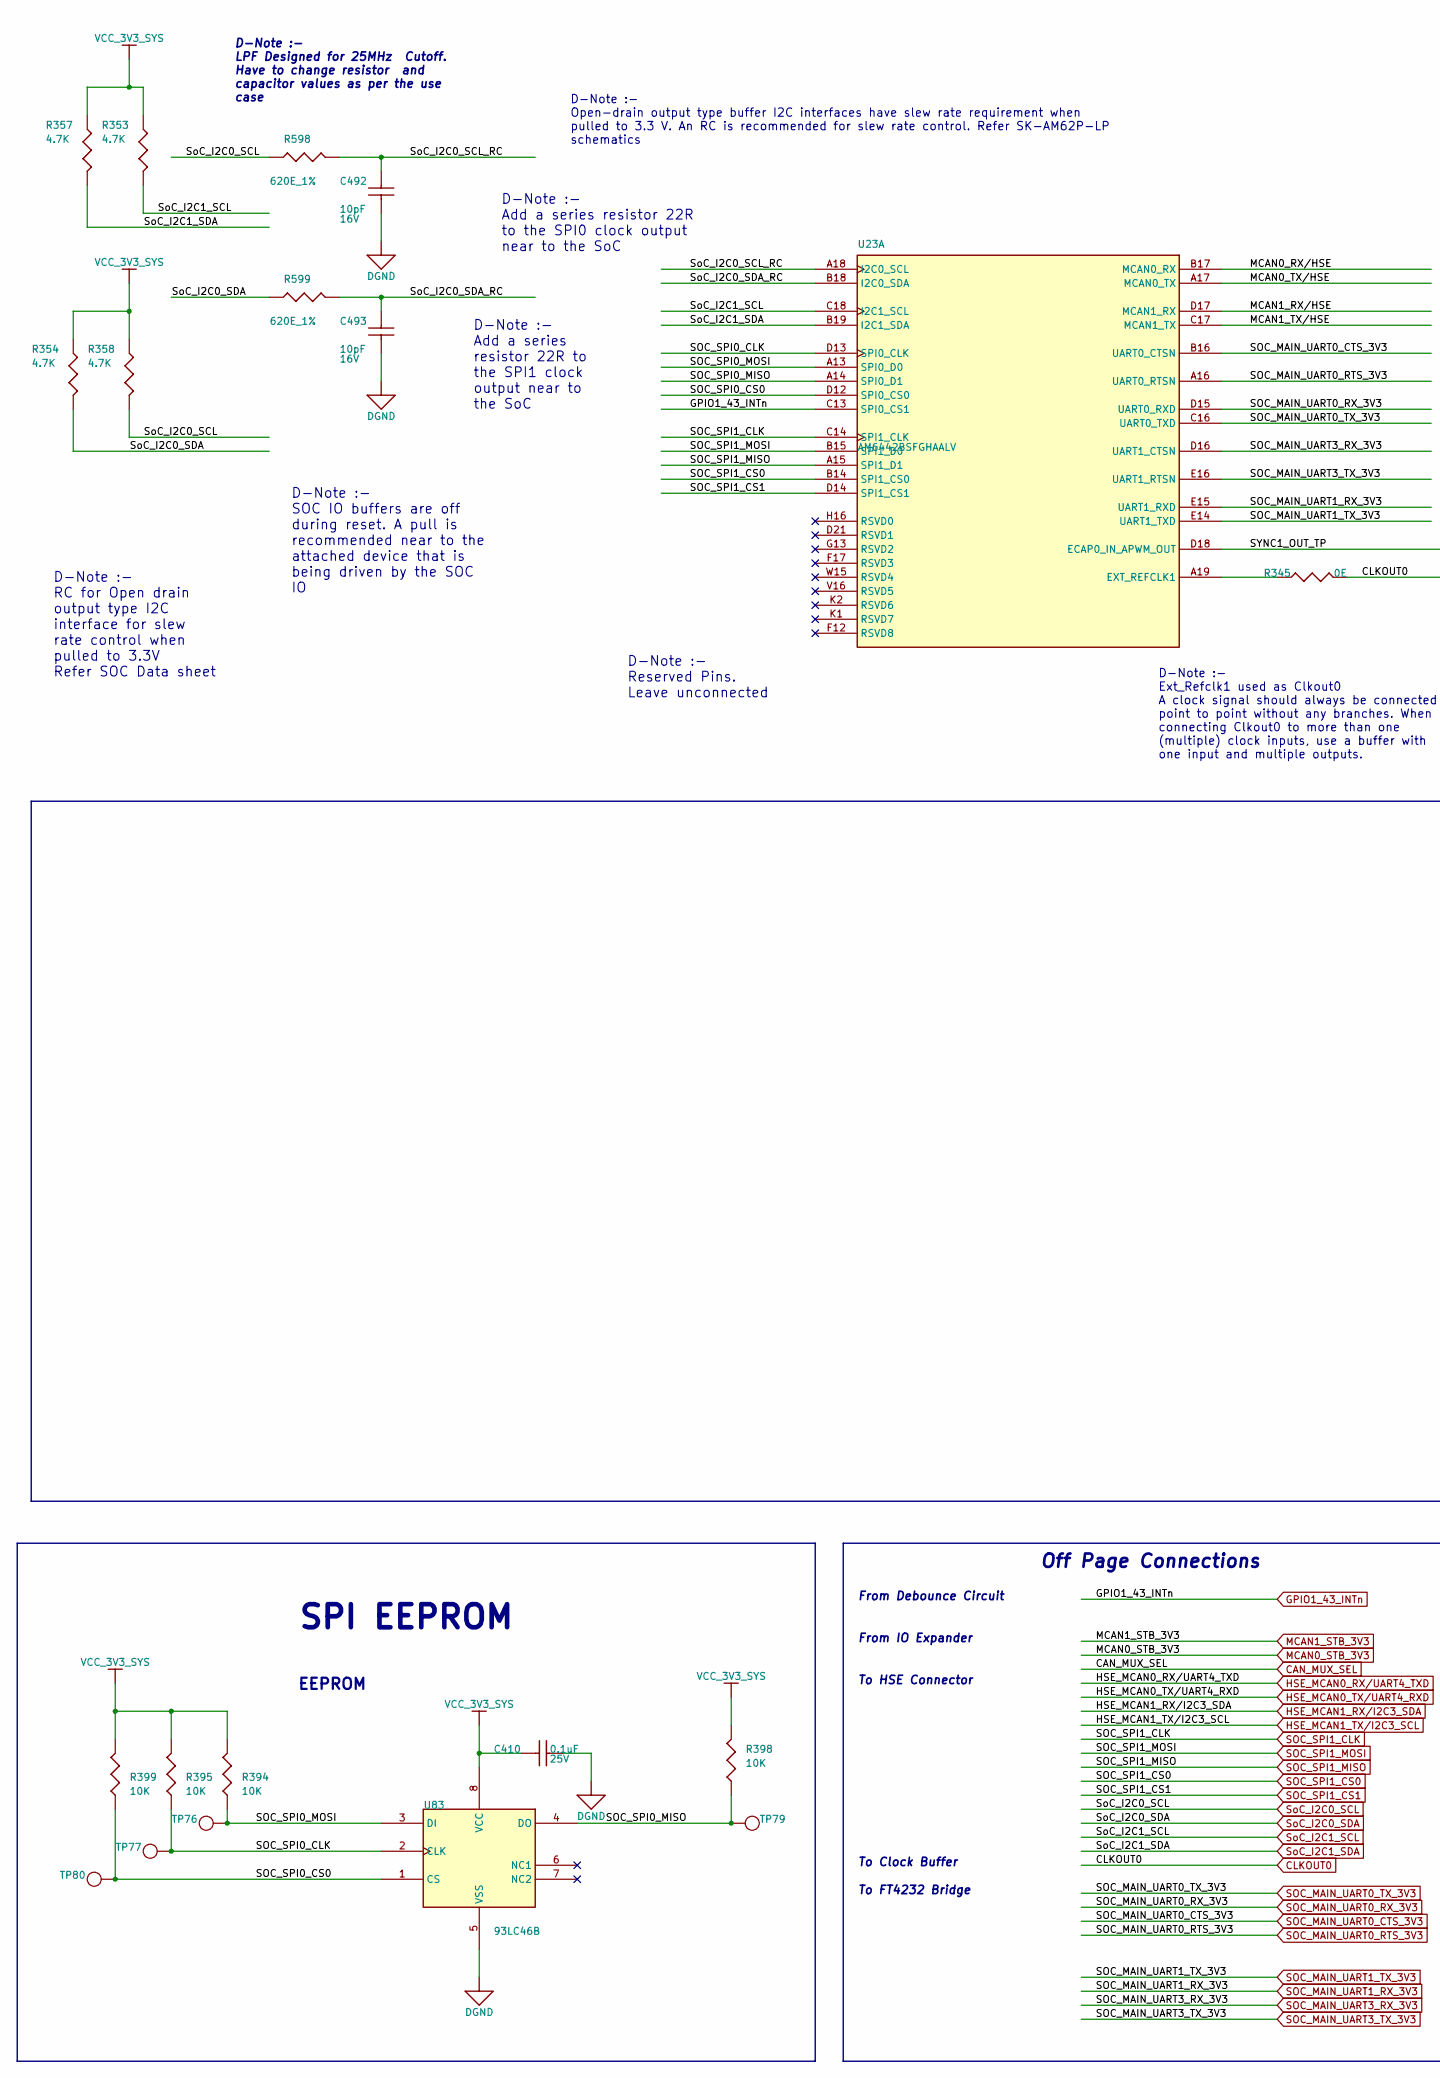
[picture p37: schematic 29.kicad_sch, part in row 1, column 1]

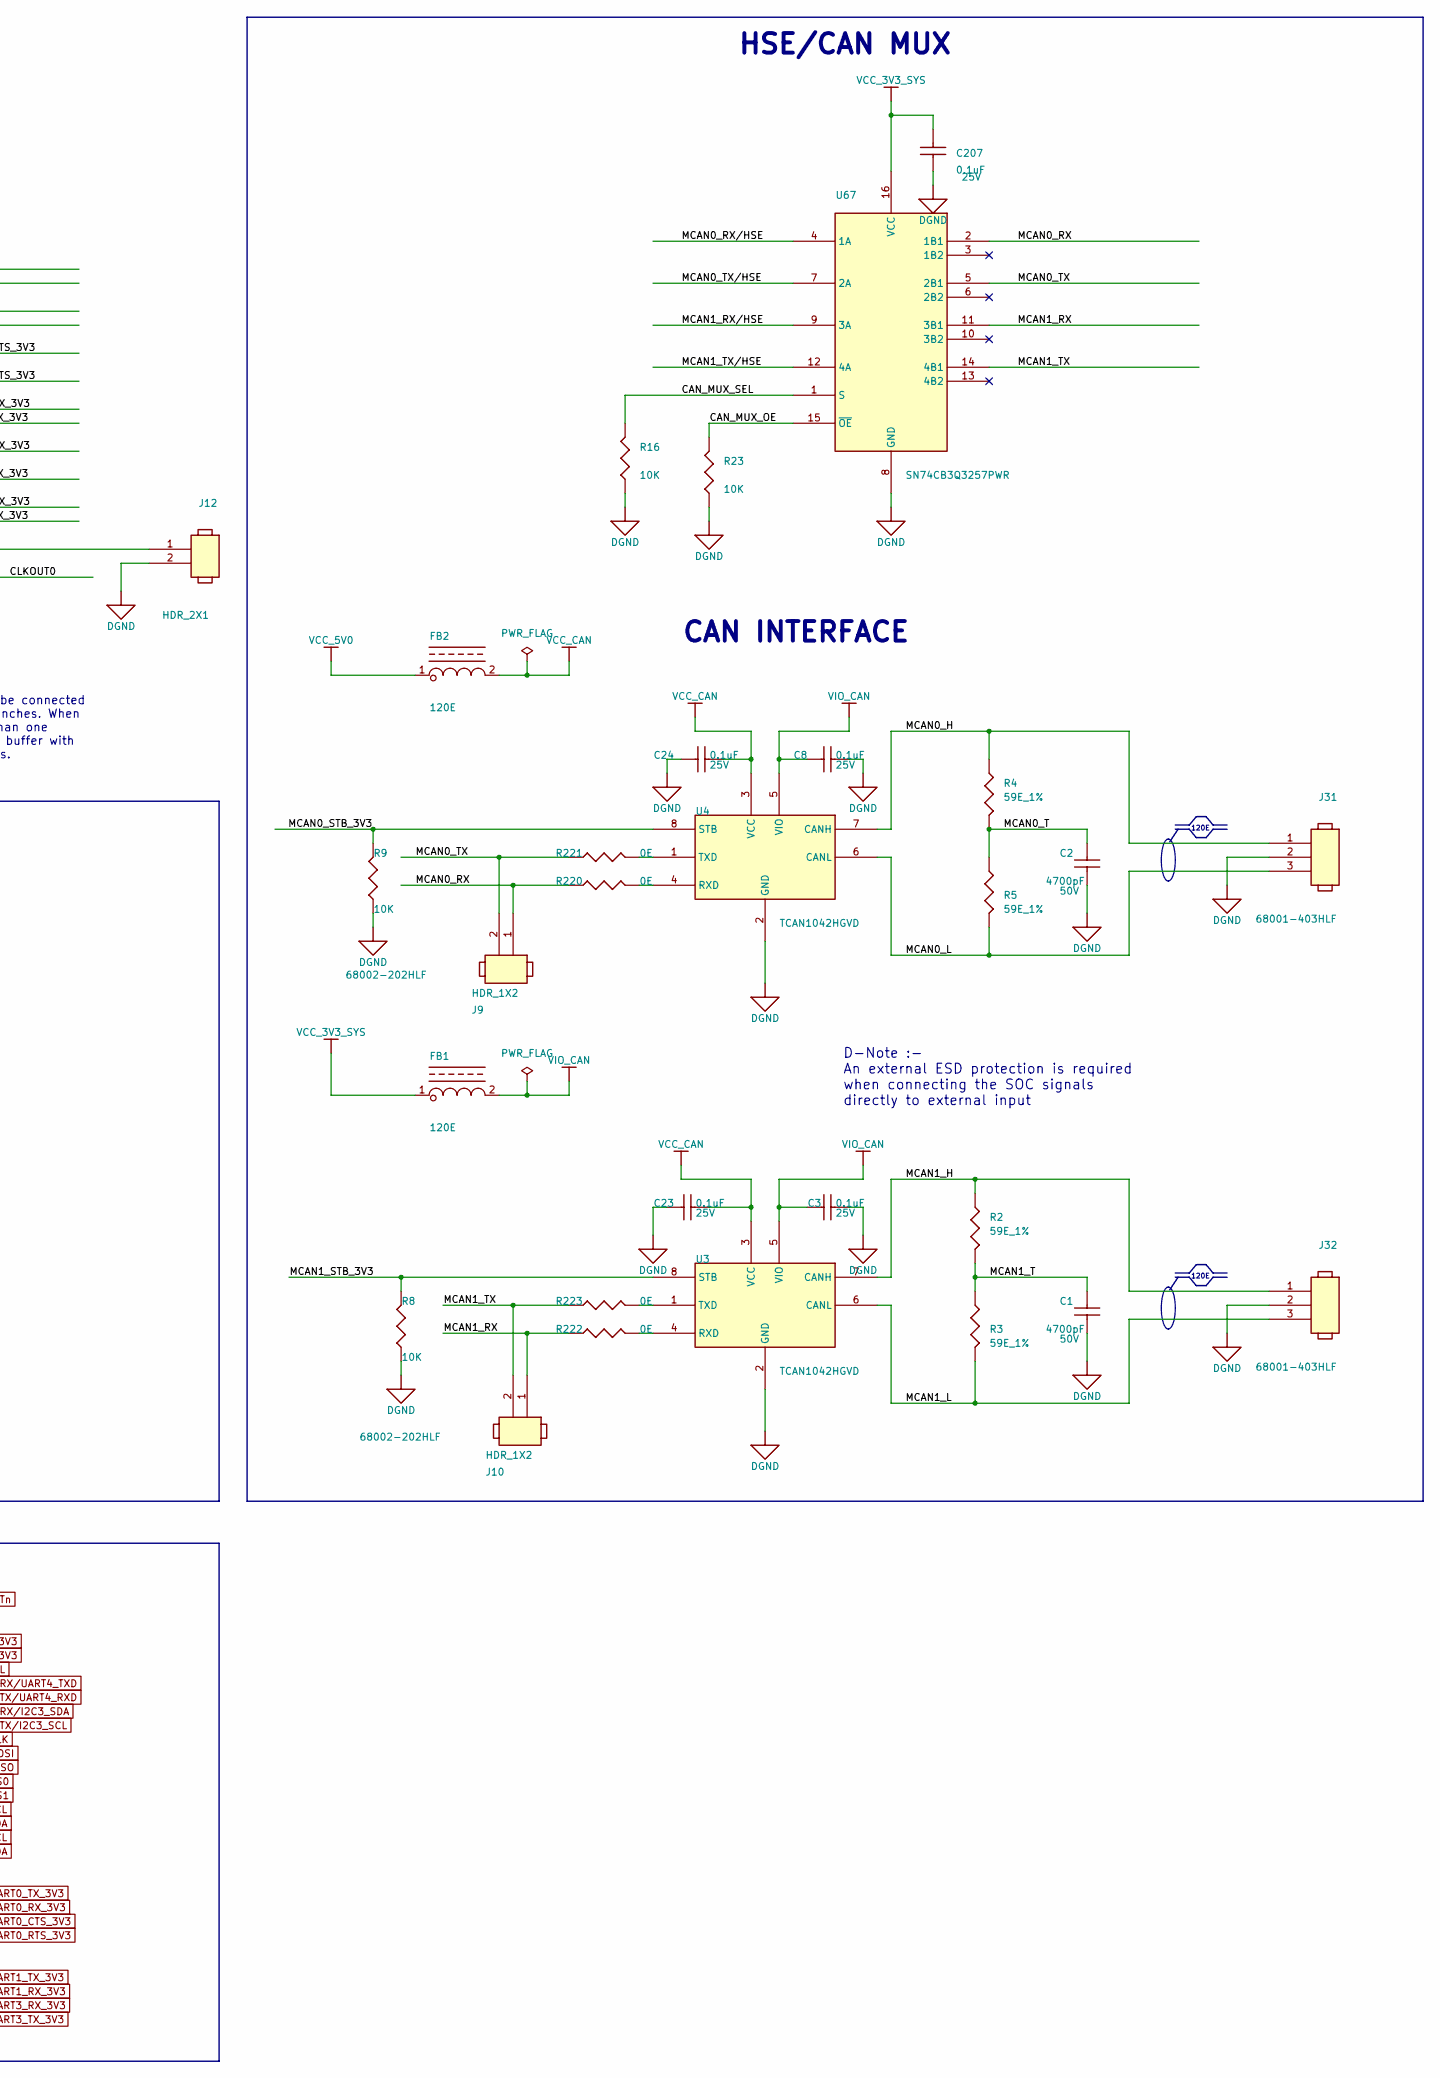
[picture p38: schematic 29.kicad_sch, part in row 1, column 2]

Parts:
C1: 4700pF; CAP0402_0-75; TOLERANCE 10%; VOLTAGE 50V; MISTRAL PART NO 120009030440-R
C2: 4700pF; CAP0402_0-75; VOLTAGE 50V; TOLERANCE 10%; PART_TYPE CAPACITOR~{S}CERAMIC
C3, C24: 0.1uF; CAP0402_0-75; TOLERANCE 20%; VOLTAGE 25V; MISTRAL PART NO 120020080003-R
C8, C23, C207, C410: 0.1uF; CAP0402_0-75; VOLTAGE 25V; TOLERANCE 20%; PART_TYPE CAPACITOR~{S}CERAMIC
C492, C493: 10pF; CAP0402_0-75; VOLTAGE 16V; TOLERANCE 5%; PART_TYPE CAPACITOR~{S}CERAMIC
FB1, FB2: 120E; IND0603_1; TOLERANCE 25%; VOLTAGE NA; MISTRAL PART NO 130020080015-R
J9: HDR_1X2; HDR_1X2_68002-202_S_T_8-6; VOLTAGE NA; TOLERANCE NA; PART_TYPE CONNECTO~{R}HEADERS
J10: HDR_1X2; HDR_1X2_68002-202_S_T_8-6; TOLERANCE NA; VOLTAGE NA; MISTRAL PART NO 150018010012-R
J12: HDR_2X1; HDR_2X1_100_S_T; VOLTAGE NA; TOLERANCE NA; PART_TYPE CONNECTO~{R}HEADERS
J31, J32: HDR_1X3; HDR_3X1_100_S_T; TOLERANCE NA; VOLTAGE NA; MISTRAL PART NO 150016060025-R
R2, R3, R5: 59E_1%; RES0402_0-5; VOLTAGE NA; TOLERANCE 1%; PART_TYPE RESISTOR~{S}FIXED
R4: 59E_1%; RES0402_0-5; TOLERANCE 1%; VOLTAGE NA; MISTRAL PART NO 110009031010-R
R8, R9, R394, R395, R398: 10K; RES0402_0-5; TOLERANCE 5%; VOLTAGE NA; MISTRAL PART NO 110011060021-R
R16, R23, R399: 10K; RES0402_0-5; VOLTAGE NA; TOLERANCE 5%; PART_TYPE RESISTOR~{S}FIXED
R220, R221, R223: 0E; RES0402_0-5; TOLERANCE NA; VOLTAGE NA; MISTRAL PART NO 110010080019-R
R222, R345: 0E; RES0402_0-5; VOLTAGE NA; TOLERANCE NA; PART_TYPE RESISTOR~{S}FIXED
R353, R357: 4.7K; RES0402_0-5; TOLERANCE 5%; VOLTAGE NA; MISTRAL PART NO 110011060001-R
R354, R358: 4.7K; RES0402_0-5; VOLTAGE NA; TOLERANCE 5%; PART_TYPE RESISTOR~{S}FIXED
R598, R599: 620E_1%; RES0402_0-5; VOLTAGE NA; TOLERANCE 1%; PART_TYPE RESISTOR~{S}FIXED
TP76, TP79, TP80: TP20_SMD; TOLERANCE NA; VOLTAGE NA; PART_TYPE TESTPOINT
TP77: TP20_SMD; VOLTAGE NA; TOLERANCE NA; MISTRAL PART NO NA
U3, U4: TCAN1042HGVD; SOIC8_1-8; VOLTAGE NA; TOLERANCE NA; PART_TYPE IC~{S}TELECO~{M}TRANSCEIVER
U23: AM6442BSFGHAALV; FCBGA441_31-49_680X680_2-6; TOLERANCE NA; VOLTAGE NA; MISTRAL PART NO 141220080002
U67: SN74CB3Q3257PWR; TSSOP16_25-59_205X180; PART_TYPE IC~{S}DIGITA~{L}COMBINATIONAL
U83: 93LC46B; MSOP8_25-59_125X125_1-1; VOLTAGE NA; TOLERANCE NA; PART_TYPE IC~{S}DIGITA~{L}MEMORY

Connections:
CAN_MUX_OE: R23.1, U67.15 (~OE)
CAN_MUX_SEL: R16.1, U67.1 (S)
CLKOUT0: R345.2
DGND: C1.2, C2.2, C3.2, C8.2, C23.1, C24.1, C207.1, C410.1, C492.2, C493.2, J12.2, J31.2, J32.2, R8.1, R9.1, R16.2, R23.2, U3.2 (GND), U4.2 (GND), U67.8 (GND), U83.5 (VSS)
GPIO1_43_INTn: U23.C13 (SPI0_CS1)
MCAN0_H: J31.1, R4.1, U4.7 (CANH)
MCAN0_L: J31.3, R5.2, U4.6 (CANL)
MCAN0_RX: J9.1, R220.1, U67.2 (1B1)
MCAN0_RX/HSE: U23.B17 (MCAN0_RX), U67.4 (1A)
MCAN0_STB_3V3: R9.2, U4.8 (STB)
MCAN0_T: C2.1, R4.2, R5.1
MCAN0_TX: J9.2, R221.1, U67.5 (2B1)
MCAN0_TX/HSE: U23.A17 (MCAN0_TX), U67.7 (2A)
MCAN1_H: J32.1, R2.1, U3.7 (CANH)
MCAN1_L: J32.3, R3.2, U3.6 (CANL)
MCAN1_RX: J10.1, R222.1, U67.11 (3B1)
MCAN1_RX/HSE: U23.D17 (MCAN1_RX), U67.9 (3A)
MCAN1_STB_3V3: R8.2, U3.8 (STB)
MCAN1_T: C1.1, R2.2, R3.1
MCAN1_TX: J10.2, R223.1, U67.14 (4B1)
MCAN1_TX/HSE: U23.C17 (MCAN1_TX), U67.12 (4A)
unnamed: R220.2, U4.4 (RXD)
unnamed: R221.2, U4.1 (TXD)
unnamed: R222.2, U3.4 (RXD)
unnamed: R223.2, U3.1 (TXD)
unnamed: R345.1, U23.A19 (EXT_REFCLK1)
SOC_MAIN_UART0_CTS_3V3: U23.B16 (UART0_CTSN)
SOC_MAIN_UART0_RTS_3V3: U23.A16 (UART0_RTSN)
SOC_MAIN_UART0_RX_3V3: U23.D15 (UART0_RXD)
SOC_MAIN_UART0_TX_3V3: U23.C16 (UART0_TXD)
SOC_MAIN_UART1_RX_3V3: U23.E15 (UART1_RXD)
SOC_MAIN_UART1_TX_3V3: U23.E14 (UART1_TXD)
SOC_MAIN_UART3_RX_3V3: U23.D16 (UART1_CTSN)
SOC_MAIN_UART3_TX_3V3: U23.E16 (UART1_RTSN)
SOC_SPI0_CLK: R395.1, TP77.1, U23.D13 (SPI0_CLK), U83.2 (CLK)
SOC_SPI0_CS0: R399.1, TP80.1, U23.D12 (SPI0_CS0), U83.1 (CS)
SOC_SPI0_MISO: R398.1, TP79.1, U23.A14 (SPI0_D1), U83.4 (DO)
SOC_SPI0_MOSI: R394.1, TP76.1, U23.A13 (SPI0_D0), U83.3 (DI)
SOC_SPI1_CLK: U23.C14 (SPI1_CLK)
SOC_SPI1_CS0: U23.B14 (SPI1_CS0)
SOC_SPI1_CS1: U23.D14 (SPI1_CS1)
SOC_SPI1_MISO: U23.A15 (SPI1_D1)
SOC_SPI1_MOSI: U23.B15 (SPI1_D0)
SYNC1_OUT_TP: J12.1, U23.D18 (ECAP0_IN_APWM_OUT)
SoC_I2C0_SCL: R358.2, R598.1
SoC_I2C0_SCL_RC: C492.1, R598.2, U23.A18 (I2C0_SCL)
SoC_I2C0_SDA: R354.2, R599.1
SoC_I2C0_SDA_RC: C493.1, R599.2, U23.B18 (I2C0_SDA)
SoC_I2C1_SCL: R353.2, U23.C18 (I2C1_SCL)
SoC_I2C1_SDA: R357.2, U23.B19 (I2C1_SDA)
VCC_3V3_SYS: C207.2, C410.2, FB1.1, R353.1, R354.1, R357.1, R358.1, R394.2, R395.2, R398.2, R399.2, U67.16 (VCC), U83.8 (VCC)
VCC_5V0: FB2.1
VCC_CAN: C23.2, C24.2, FB2.2, U3.3 (VCC), U4.3 (VCC)
VIO_CAN: C3.1, C8.1, FB1.2, U3.5 (VIO), U4.5 (VIO)

Notes on the sheet:
D-Note :- RC for Open drain output type I2C interface for slew rate control when pulled to 3.3V Refer SOC Data sheet
D-Note :- Reserved Pins. Leave unconnected
D-Note :- Add a series resistor 22R to the SPI1 clock output near to the SoC
D-Note :- SOC IO buffers are off during reset. A pull is recommended near to the attached device that is being driven by the SOC IO
D-Note :- Open-drain output type buffer I2C interfaces have slew rate requirement when pulled to 3.3 V. An RC is recommended for slew rate control. Refer SK-AM62P-LP schematics
D-Note :- Ext_Refclk1 used as Clkout0 A clock signal should always be connected point to point without any branches. When connecting Clkout0 to more than one (multiple) clock inputs, use a buffer with one input and multiple outputs.
D-Note :- An external ESD protection is required when connecting the SOC signals directly to external input
D-Note :- Add a series resistor 22R to the SPI0 clock output near to the SoC
D-Note :- LPF Designed for 25MHz Cutoff. Have to change resistor and capacitor values as per the use case
120E
HSE/CAN MUX
To FT4232 Bridge
To HSE Connector
Off Page Connections
SPI EEPROM
CAN INTERFACE
To Clock Buffer
From Debounce Circuit
From IO Expander
EEPROM
