gingerologist/am64x/30.kicad_sch

## KiCad design 30.kicad_sch (2024-08-05)

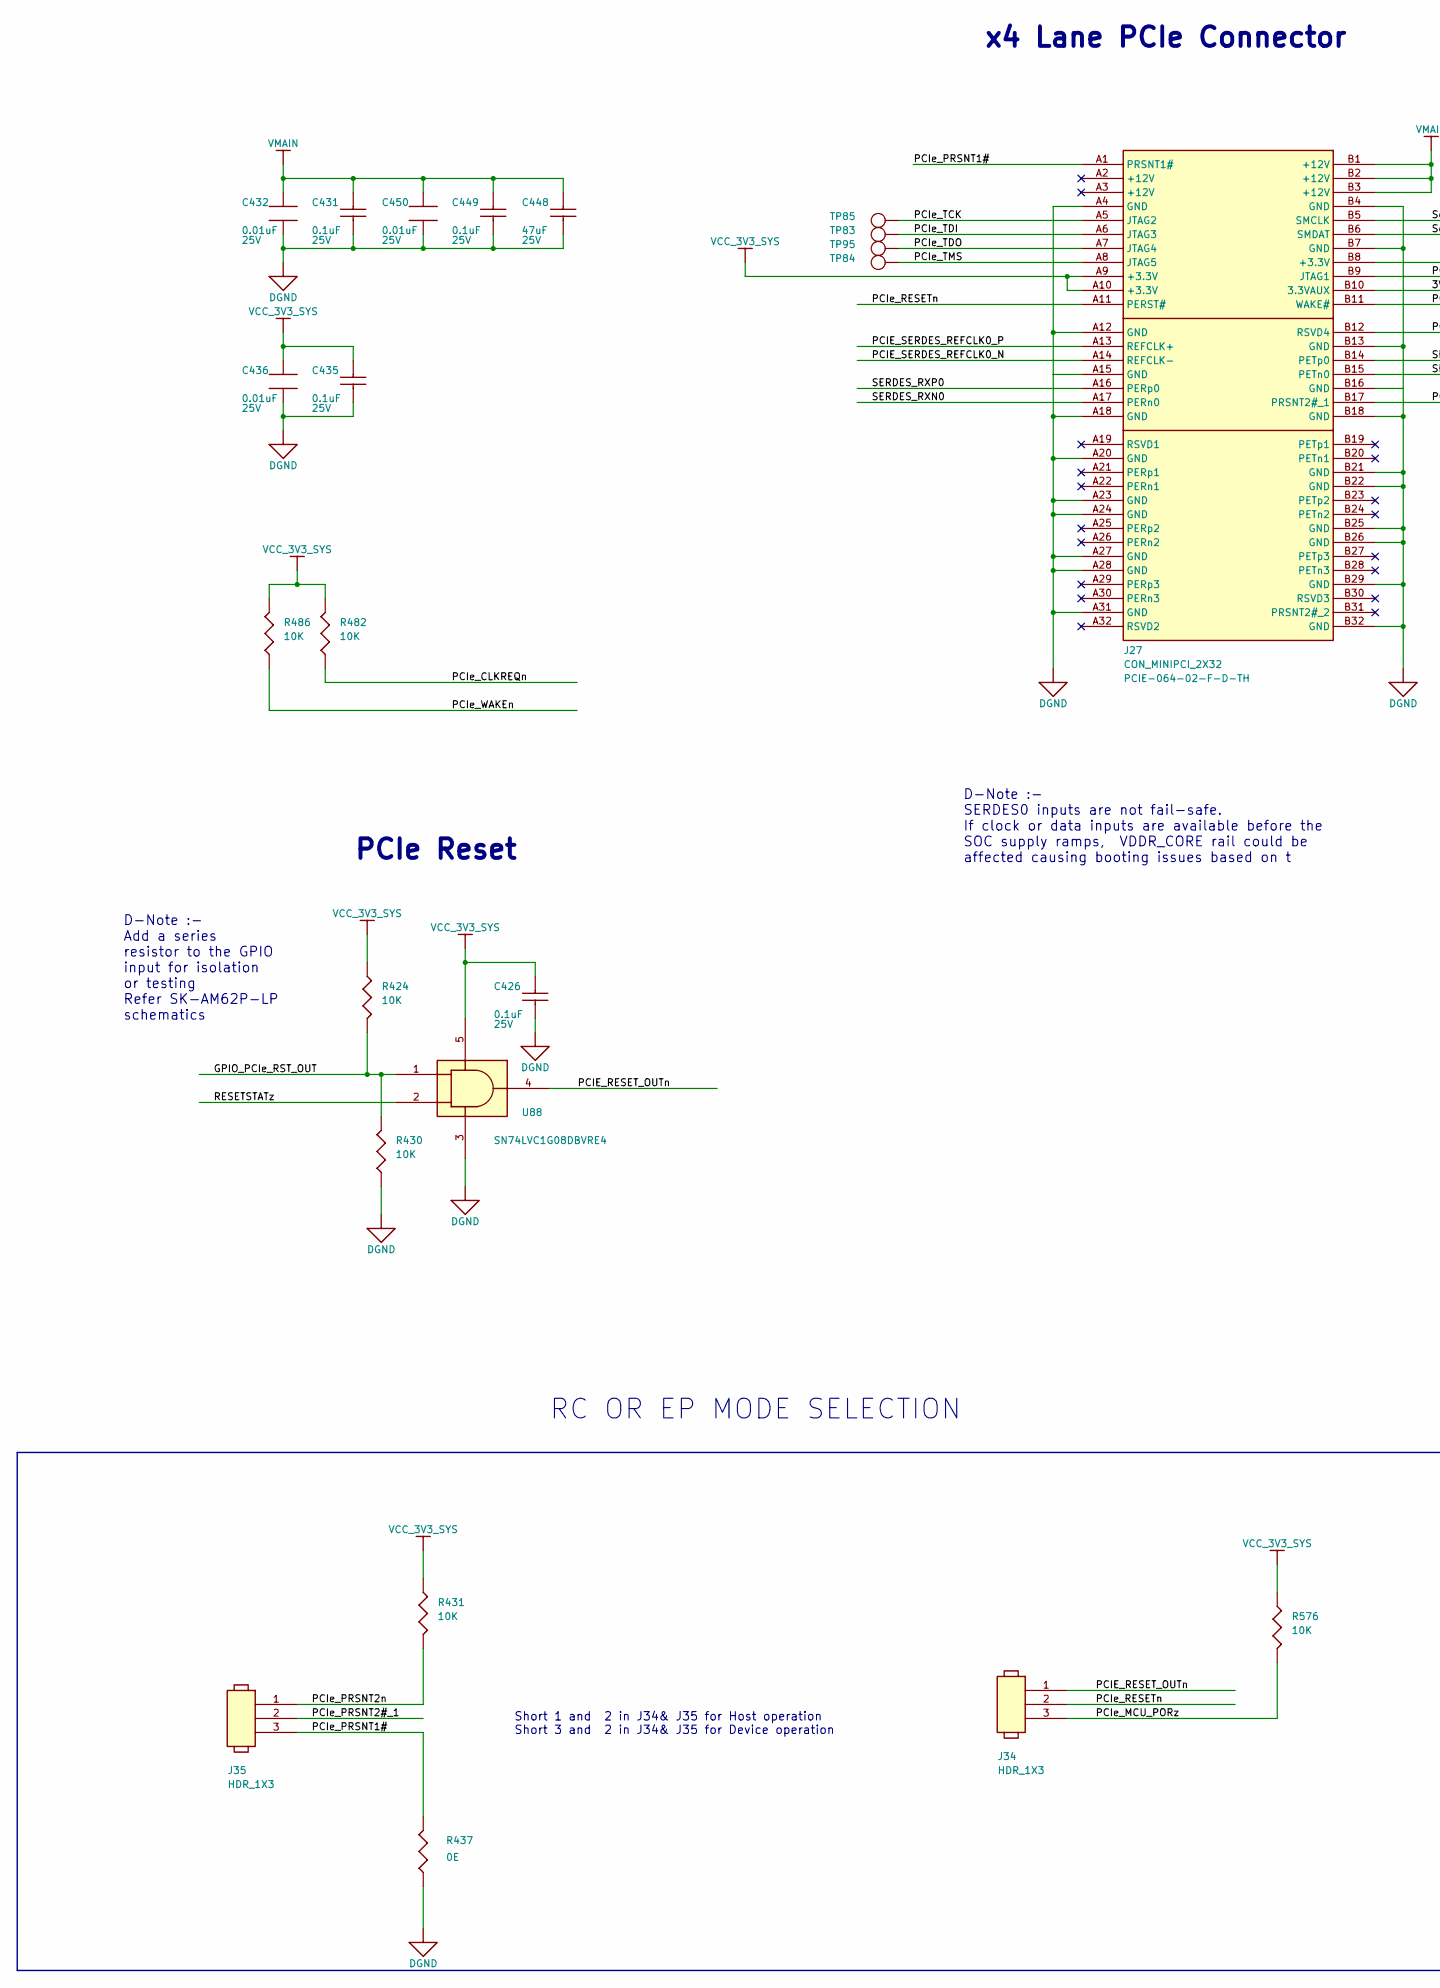
[picture p39: schematic 30.kicad_sch, part in row 1, column 1]

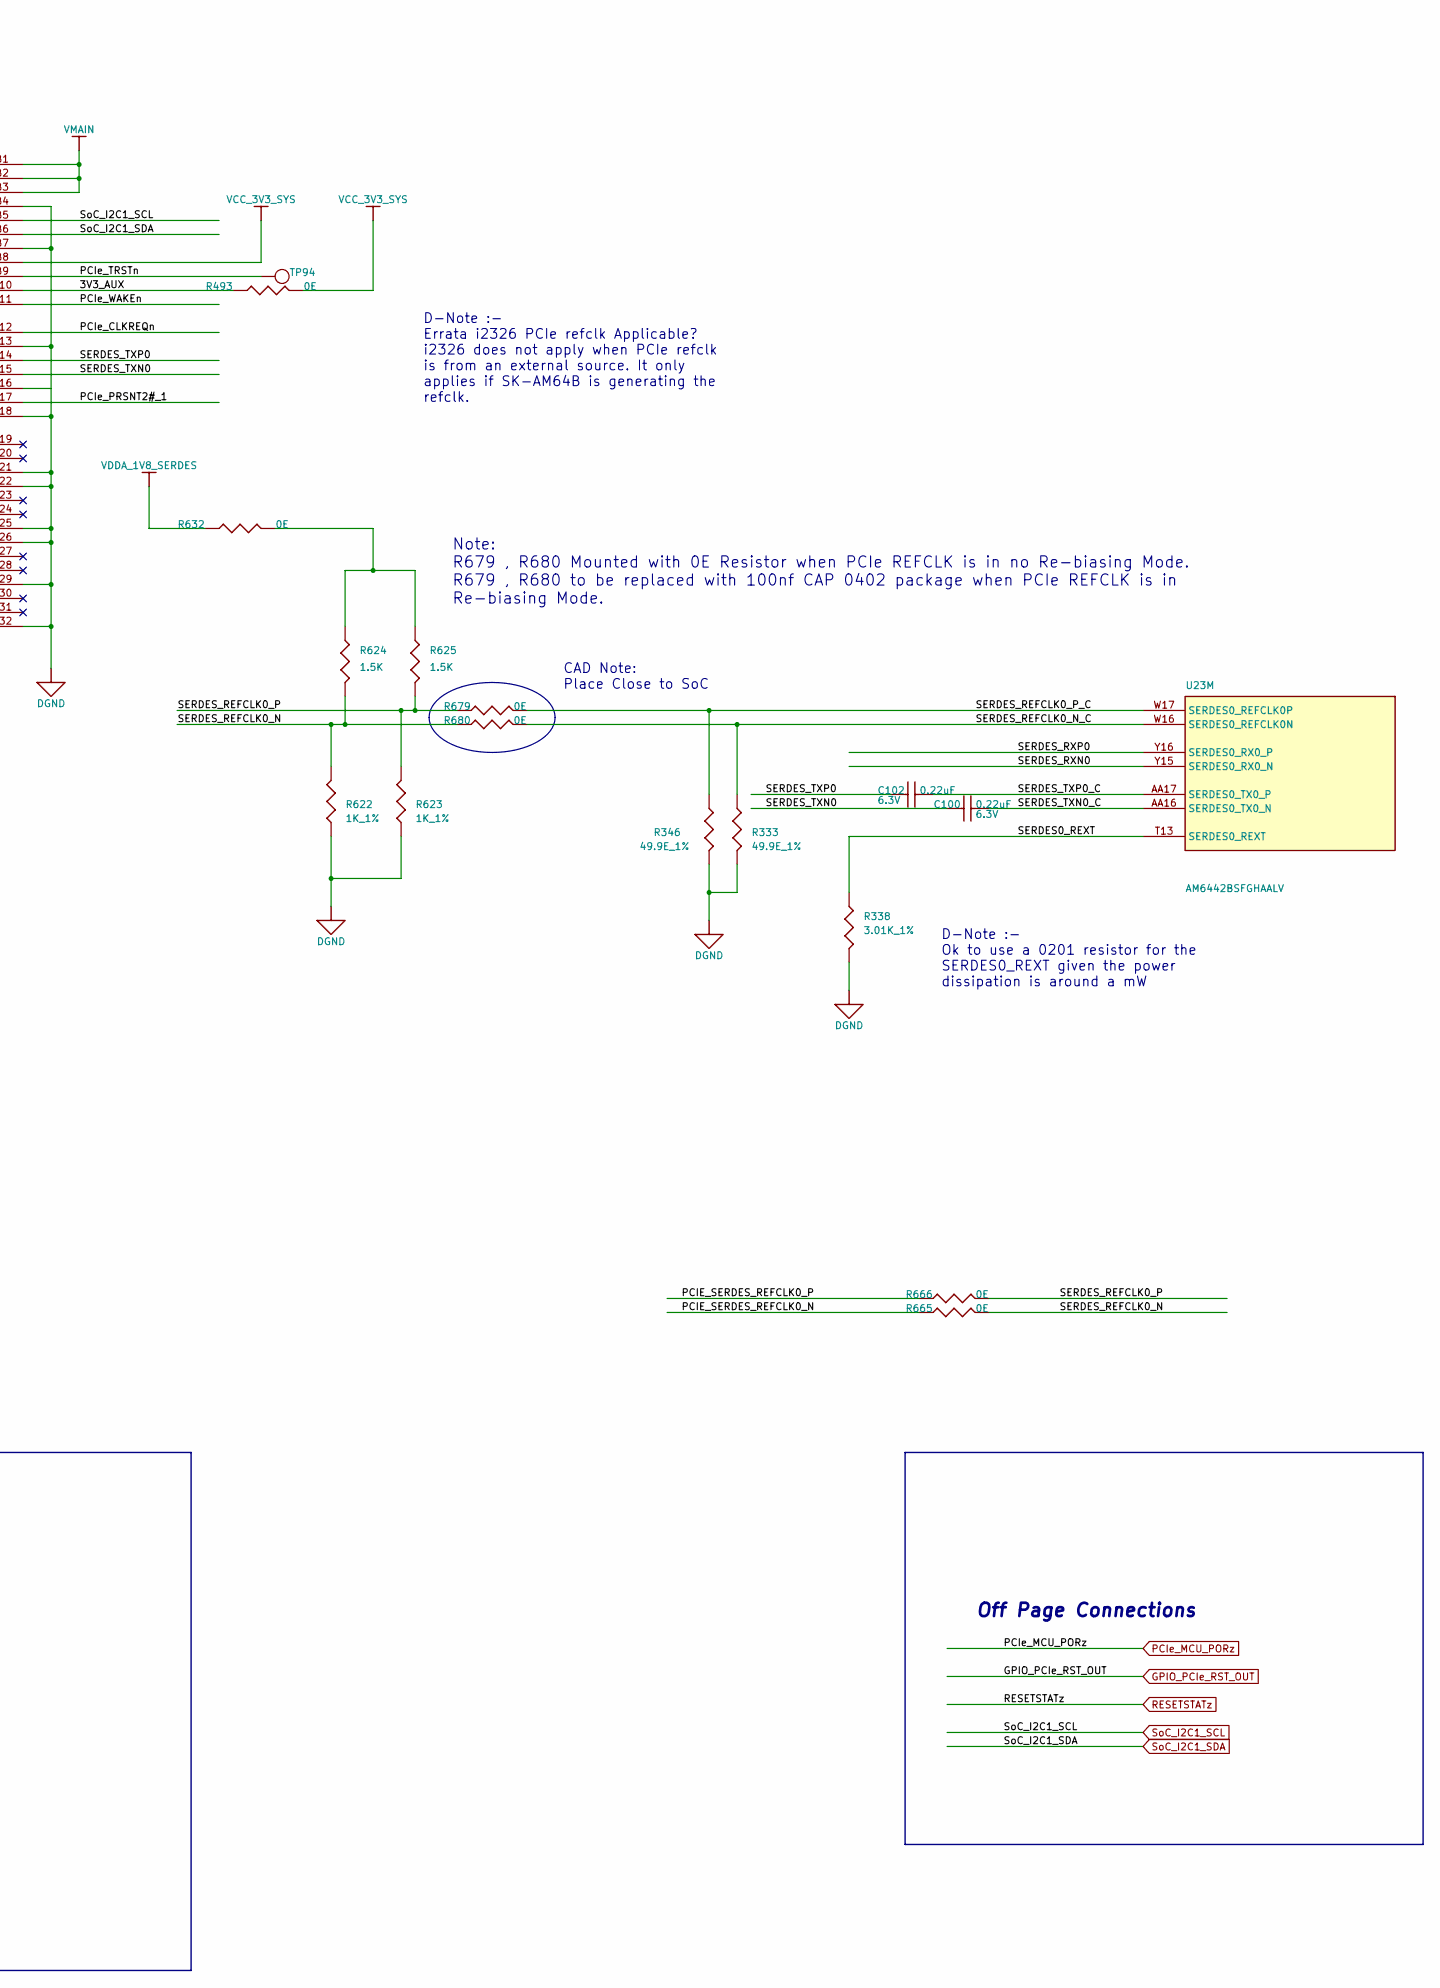
[picture p40: schematic 30.kicad_sch, part in row 1, column 2]

Parts:
C100, C102: 0.22uF; CAP0201_0-5; TOLERANCE 10%; VOLTAGE 6.3V; MISTRAL PART NO 120021060017-R
C426, C449: 0.1uF; CAP0402_0-75; TOLERANCE 20%; VOLTAGE 25V; MISTRAL PART NO 120020080003-R
C431, C435: 0.1uF; CAP0402_0-75; VOLTAGE 25V; TOLERANCE 20%; PART_TYPE CAPACITOR~{S}CERAMIC
C432, C436: 0.01uF; CAP0402N; VOLTAGE 25V; TOLERANCE 10%; PART_TYPE CAPACITOR~{S}CERAMIC
C448: 47uF; CAP1206_2; VOLTAGE 25V; TOLERANCE 20%; PART_TYPE CAPACITOR~{S}CERAMIC
C450: 0.01uF; CAP0402N; TOLERANCE 10%; VOLTAGE 25V; MISTRAL PART NO 120011090040-R
J27: CON_MINIPCI_2X32; CON_MINIPCI2X32_PCIE-064-02_S_S_T_11; TOLERANCE NA; VOLTAGE NA; MISTRAL PART NO 150017100015-R
J34, J35: HDR_1X3; HDR_3X1_100_S_T; VOLTAGE NA; TOLERANCE NA; PART_TYPE CONNECTO~{R}HEADERS
R333, R346: 49.9E_1%; RES0402_0-5; TOLERANCE 1%; VOLTAGE NA; MISTRAL PART NO 110009030846-R
R338: 3.01K_1%; RES0402_0-5; VOLTAGE NA; TOLERANCE 1%; PART_TYPE RESISTOR~{S}FIXED
R424, R431, R576: 10K; RES0402_0-5; TOLERANCE 5%; VOLTAGE NA; MISTRAL PART NO 110011060021-R
R430, R482, R486: 10K; RES0402_0-5; VOLTAGE NA; TOLERANCE 5%; PART_TYPE RESISTOR~{S}FIXED
R437, R493, R632: 0E; RES0402_0-5; TOLERANCE NA; VOLTAGE NA; MISTRAL PART NO 110010080019-R
R622, R623: 1K_1%; RES0402_0-5; VOLTAGE NA; TOLERANCE 1%; PART_TYPE RESISTOR~{S}FIXED
R624: 1.5K; RES0402_0-5; TOLERANCE 5%; VOLTAGE NA; MISTRAL PART NO 110010120012-R
R625: 1.5K; RES0402_0-5; VOLTAGE NA; TOLERANCE 5%; PART_TYPE RESISTOR~{S}FIXED
R665, R666, R679, R680: 0E; RES0402_0-5; VOLTAGE NA; TOLERANCE NA; PART_TYPE RESISTOR~{S}FIXED
TP83, TP84, TP85, TP95: TP20_SMD; TOLERANCE NA; VOLTAGE NA; MISTRAL PART NO NA
TP94: TP20_SMD; VOLTAGE NA; TOLERANCE NA; MISTRAL PART NO NA
U23: AM6442BSFGHAALV; FCBGA441_31-49_680X680_2-6; VOLTAGE NA; TOLERANCE NA; PART_TYPE IC~{S}DIGITA~{L}MICROPROCESSOR
U88: SN74LVC1G08DBVRE4; SOT23-5; MISTRAL PART NO 141009060026-R

Connections:
3V3_AUX: J27.B10 (3.3VAUX), R493.2
DGND: C426.2, C431.2, C432.2, C435.2, C436.2, C448.2, C449.2, C450.2, J27.A4 (GND), J27.A12 (GND), J27.A15 (GND), J27.A18 (GND), J27.A20 (GND), J27.A23 (GND), J27.A24 (GND), J27.A27 (GND), J27.A28 (GND), J27.A31 (GND), J27.B4 (GND), J27.B7 (GND), J27.B13 (GND), J27.B16 (GND), J27.B18 (GND), J27.B21 (GND), J27.B22 (GND), J27.B25 (GND), J27.B26 (GND), J27.B29 (GND), J27.B32 (GND), R333.2, R338.2, R346.2, R430.2, R437.1, R622.1, R623.1, U88.3 (GND)
GPIO_PCIe_RST_OUT: R424.2, R430.1, U88.1 (A)
unnamed: R624.1, R625.1, R632.1
PCIE_RESET_OUTn: J34.1, U88.4 (Y)
PCIE_SERDES_REFCLK0_N: J27.A14 (REFCLK-), R665.1
PCIE_SERDES_REFCLK0_P: J27.A13 (REFCLK+), R666.1
PCIe_CLKREQn: J27.B12 (RSVD4), R482.1
PCIe_MCU_PORz: J34.3, R576.2
PCIe_PRSNT1#: J27.A1 (PRSNT1#), J35.3, R437.2
PCIe_PRSNT2#_1: J27.B17 (PRSNT2#_1), J35.2
PCIe_PRSNT2n: J35.1, R431.2
PCIe_RESETn: J27.A11 (PERST#), J34.2
PCIe_TCK: J27.A5 (JTAG2), TP85.1
PCIe_TDI: J27.A6 (JTAG3), TP83.1
PCIe_TDO: J27.A7 (JTAG4), TP95.1
PCIe_TMS: J27.A8 (JTAG5), TP84.1
PCIe_TRSTn: J27.B9 (JTAG1), TP94.1
PCIe_WAKEn: J27.B11 (WAKE#), R486.1
RESETSTATz: U88.2 (B)
SERDES0_REXT: R338.1, U23.T13 (SERDES0_REXT)
SERDES_REFCLK0_N: R622.2, R624.2, R665.2, R680.1
SERDES_REFCLK0_N_C: R333.1, R680.2, U23.W16 (SERDES0_REFCLK0N)
SERDES_REFCLK0_P: R623.2, R625.2, R666.2, R679.1
SERDES_REFCLK0_P_C: R346.1, R679.2, U23.W17 (SERDES0_REFCLK0P)
SERDES_RXN0: J27.A17 (PERn0), U23.Y15 (SERDES0_RX0_N)
SERDES_RXP0: J27.A16 (PERp0), U23.Y16 (SERDES0_RX0_P)
SERDES_TXN0: C100.1, J27.B15 (PETn0)
SERDES_TXN0_C: C100.2, U23.AA16 (SERDES0_TX0_N)
SERDES_TXP0: C102.1, J27.B14 (PETp0)
SERDES_TXP0_C: C102.2, U23.AA17 (SERDES0_TX0_P)
SoC_I2C1_SCL: J27.B5 (SMCLK)
SoC_I2C1_SDA: J27.B6 (SMDAT)
VCC_3V3_SYS: C426.1, C435.1, C436.1, J27.A9 (+3.3V), J27.A10 (+3.3V), J27.B8 (+3.3V), R424.1, R431.1, R482.2, R486.2, R493.1, R576.1, U88.5 (VCC)
VDDA_1V8_SERDES: R632.2
VMAIN: C431.1, C432.1, C448.1, C449.1, C450.1, J27.B1 (+12V), J27.B2 (+12V), J27.B3 (+12V)

Notes on the sheet:
D-Note :- SERDES0 inputs are not fail-safe. If clock or data inputs are available before the SOC supply ramps, VDDR_CORE rail could be affected causing booting issues based on t
D-Note :- Ok to use a 0201 resistor for the SERDES0_REXT given the power dissipation is around a mW
D-Note :- Add a series resistor to the GPIO input for isolation or testing Refer SK-AM62P-LP schematics
Short 1 and 2 in J34& J35 for Host operation Short 3 and 2 in J34& J35 for Device operation
D-Note :- Errata i2326 PCIe refclk Applicable? i2326 does not apply when PCIe refclk is from an external source. It only applies if SK-AM64B is generating the refclk.
CAD Note: Place Close to SoC
Note: R679 , R680 Mounted with 0E Resistor when PCIe REFCLK is in no Re-biasing Mode. R679 , R680 to be replaced with 100nf CAP 0402 package when PCIe REFCLK is in Re-biasing Mode.
PCIe Reset
RC OR EP MODE SELECTION
x4 Lane PCIe Connector
Off Page Connections
