gingerologist/am64x/31.kicad_sch

## KiCad design 31.kicad_sch (2024-08-05)

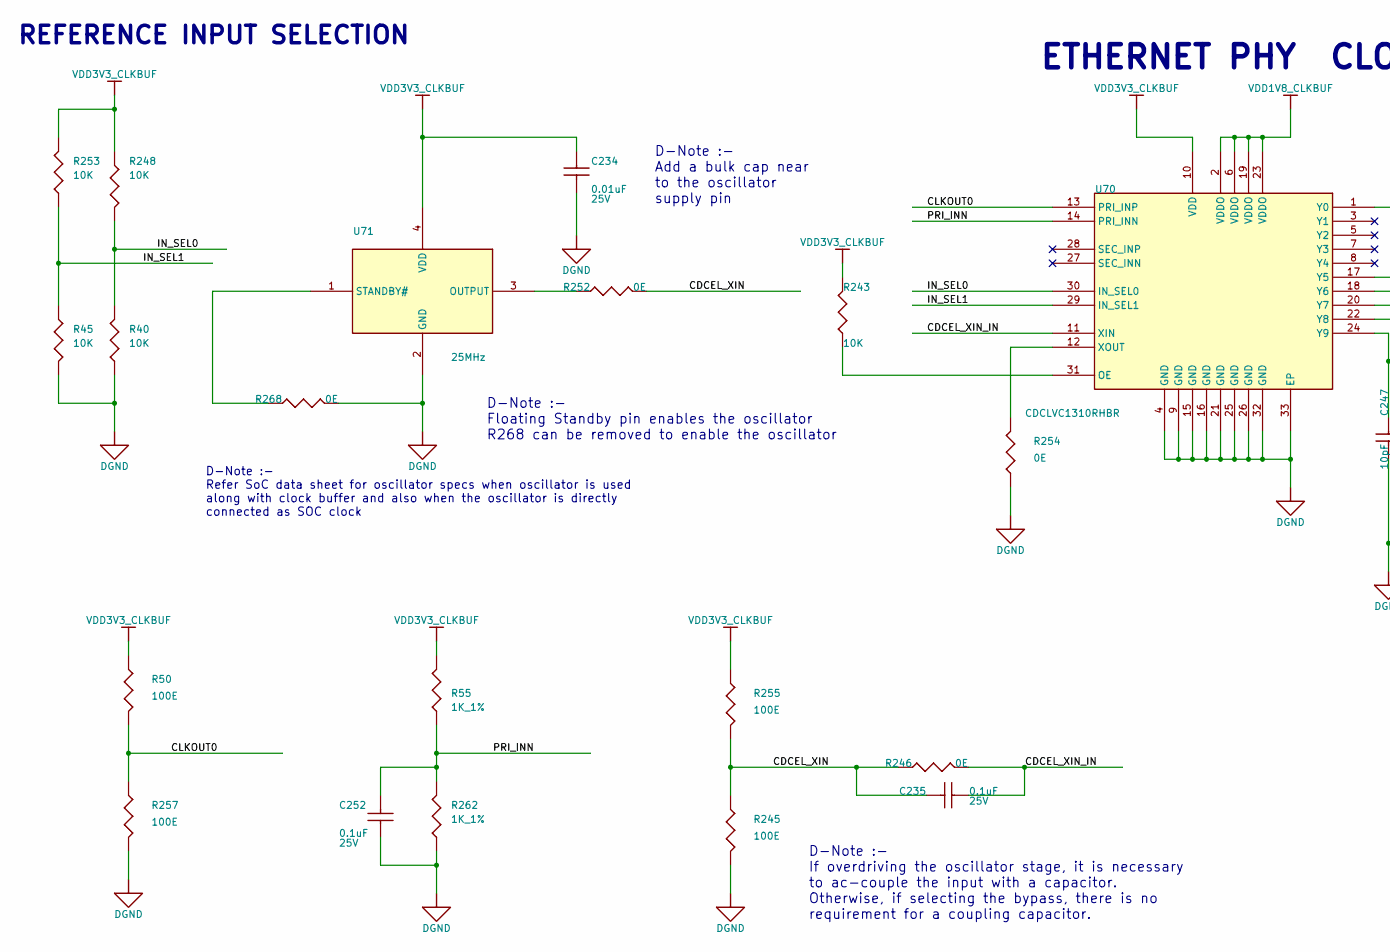
[picture p41: schematic 31.kicad_sch, part in row 1, column 1]

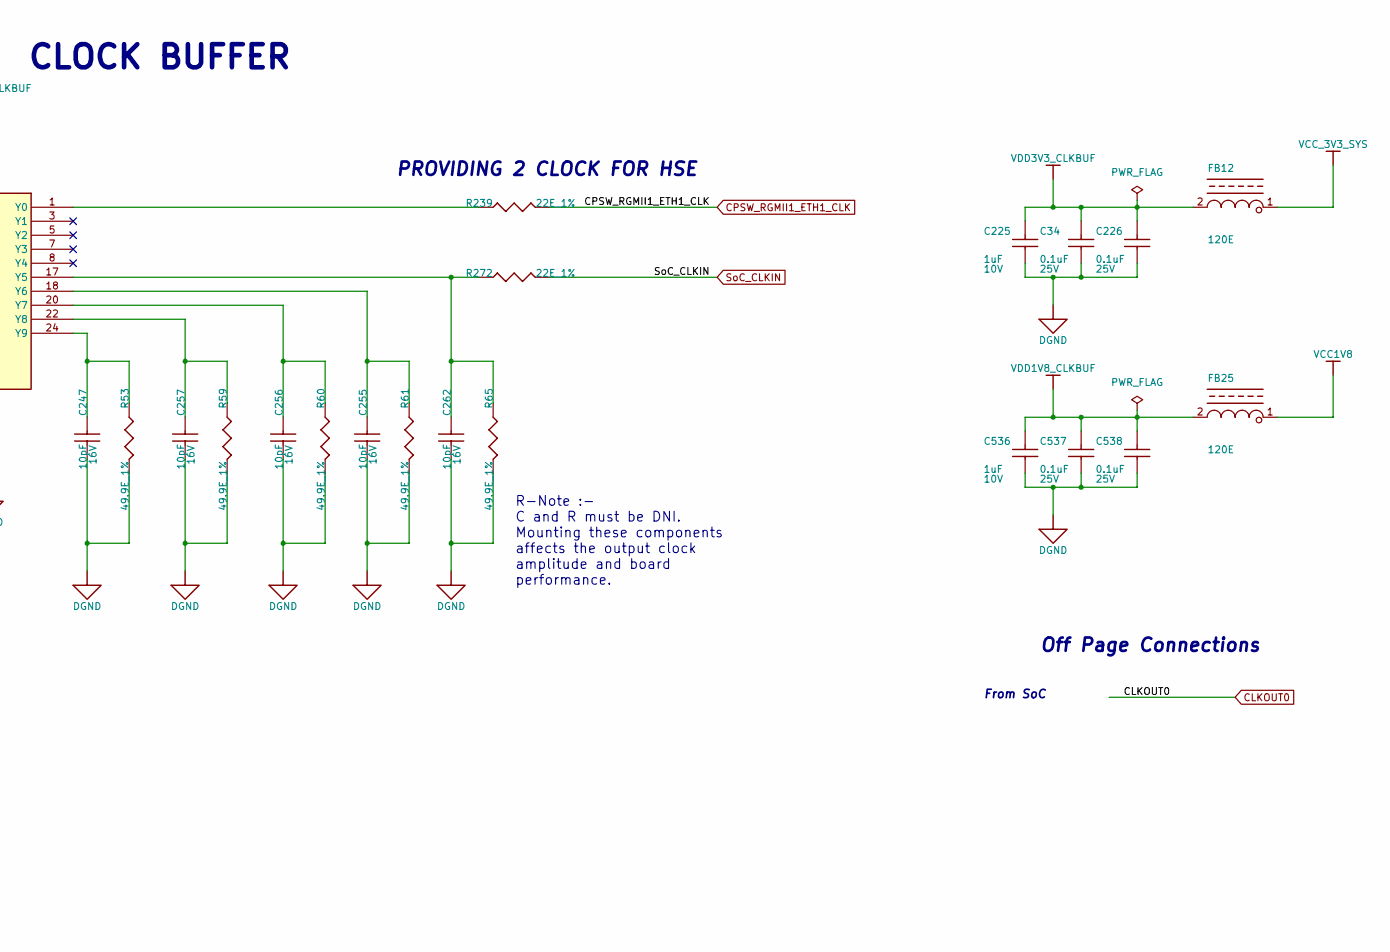
[picture p42: schematic 31.kicad_sch, part in row 1, column 2]

Parts:
C34, C226, C235: 0.1uF; CAP0402_0-75; VOLTAGE 25V; TOLERANCE 20%; PART_TYPE CAPACITOR~{S}CERAMIC
C225: 1uF; CAP0402_0-75; VOLTAGE 10V; TOLERANCE 20%; PART_TYPE CAPACITOR~{S}CERAMIC
C234: 0.01uF; CAP0201_0-5; VOLTAGE 25V; TOLERANCE 10%; PART_TYPE CAPACITOR~{S}CERAMIC
C247, C255, C256, C257, C262: 10pF; CAP0402_0-75; TOLERANCE 5%; VOLTAGE 16V; MISTRAL PART NO 120018030015-R
C252, C537, C538: 0.1uF; CAP0402_0-75; TOLERANCE 20%; VOLTAGE 25V; MISTRAL PART NO 120020080003-R
C536: 1uF; CAP0402_0-75; TOLERANCE 20%; VOLTAGE 10V; MISTRAL PART NO 120020080009-R
FB12: 120E; IND0603_1; TOLERANCE 25%; VOLTAGE NA; MISTRAL PART NO 130020080015-R
FB25: 120E; IND0603_1; VOLTAGE NA; TOLERANCE 25%; PART_TYPE INDUCTOR
R40, R45, R243: 10K; RES0402_0-5; VOLTAGE NA; TOLERANCE 5%; PART_TYPE RESISTOR~{S}FIXED
R50, R257: 100E; RES0402_0-5; TOLERANCE 5%; VOLTAGE NA; MISTRAL PART NO 110014060039-R
R53, R59, R60, R61, R65: 49.9E_1%; RES0402_0-5; VOLTAGE NA; TOLERANCE 1%; PART_TYPE RESISTOR~{S}FIXED
R55: 1K_1%; RES0402_0-5; VOLTAGE NA; TOLERANCE 1%; PART_TYPE RESISTOR~{S}FIXED
R239, R272: 22E_1%; RES0402_0-5; TOLERANCE 1%; VOLTAGE NA; MISTRAL PART NO 110009090004-R
R245, R255: 100E; RES0402_0-5; VOLTAGE NA; TOLERANCE 5%; PART_TYPE RESISTOR~{S}FIXED
R246, R252: 0E; RES0402_0-5; VOLTAGE NA; TOLERANCE NA; PART_TYPE RESISTOR~{S}FIXED
R248, R253: 10K; RES0402_0-5; TOLERANCE 5%; VOLTAGE NA; MISTRAL PART NO 110011060021-R
R254, R268: 0E; RES0402_0-5; TOLERANCE NA; VOLTAGE NA; MISTRAL PART NO 110010080019-R
R262: 1K_1%; RES0402_0-5; TOLERANCE 1%; VOLTAGE NA; MISTRAL PART NO 110009030411-R
U70: CDCLVC1310RHBR; QFN32_19-68_200X200_1; VOLTAGE NA; TOLERANCE NA; PART_TYPE IC~{S}INTERFAC~{E}LEVEL TRANSLATOR
U71: 25MHz; OSC4_ASFLMB_200X130_SMD; TOLERANCE NA; VOLTAGE NA; MISTRAL PART NO 130013110024-R

Connections:
CDCEL_XIN: C235.2, R245.1, R246.1, R252.2, R255.2
CDCEL_XIN_IN: C235.1, R246.2, U70.11 (XIN)
CLKOUT0: R50.2, R257.1, U70.13 (PRI_INP)
CPSW_RGMII1_ETH1_CLK: R239.2
DGND: C34.1, C225.1, C226.1, C234.2, C247.2, C252.1, C255.2, C256.2, C257.2, C262.2, C536.1, C537.1, C538.1, R40.1, R45.2, R53.2, R59.2, R60.2, R61.2, R65.2, R245.2, R254.1, R257.2, R262.1, R268.2, U70.4 (GND), U70.9 (GND), U70.15 (GND), U70.16 (GND), U70.21 (GND), U70.25 (GND), U70.26 (GND), U70.32 (GND), U70.33 (EP), U71.2 (GND)
IN_SEL0: R40.2, R248.2, U70.30 (IN_SEL0)
IN_SEL1: R45.1, R253.1, U70.29 (IN_SEL1)
unnamed: C247.1, R53.1, U70.24 (Y9)
unnamed: C255.1, R61.1, U70.18 (Y6)
unnamed: C256.1, R60.1, U70.20 (Y7)
unnamed: C257.1, R59.1, U70.22 (Y8)
unnamed: C262.1, R65.1, R272.1, U70.17 (Y5)
unnamed: R239.1, U70.1 (Y0)
unnamed: R243.1, U70.31 (OE)
unnamed: R252.1, U71.3 (OUTPUT)
unnamed: R254.2, U70.12 (XOUT)
unnamed: R268.1, U71.1 (STANDBY#)
PRI_INN: C252.2, R55.1, R262.2, U70.14 (PRI_INN)
SoC_CLKIN: R272.2
VCC1V8: FB25.1
VCC_3V3_SYS: FB12.1
VDD1V8_CLKBUF: C536.2, C537.2, C538.2, FB25.2, U70.2 (VDDO), U70.6 (VDDO), U70.19 (VDDO), U70.23 (VDDO)
VDD3V3_CLKBUF: C34.2, C225.2, C226.2, C234.1, FB12.2, R50.1, R55.2, R243.2, R248.1, R253.2, R255.1, U70.10 (VDD), U71.4 (VDD)

Notes on the sheet:
D-Note :- Add a bulk cap near to the oscillator supply pin
D-Note :- Floating Standby pin enables the oscillator R268 can be removed to enable the oscillator
R-Note :- C and R must be DNI. Mounting these components affects the output clock amplitude and board performance.
D-Note :- Refer SoC data sheet for oscillator specs when oscillator is used along with clock buffer and also when the oscillator is directly connected as SOC clock
D-Note :- If overdriving the oscillator stage, it is necessary to ac-couple the input with a capacitor. Otherwise, if selecting the bypass, there is no requirement for a coupling capacitor.
From SoC
Off Page Connections
PROVIDING 2 CLOCK FOR HSE
REFERENCE INPUT SELECTION
ETHERNET PHY CLOCK BUFFER
