gingerologist/am64x/33.kicad_sch

## KiCad design 33.kicad_sch (2024-08-05)

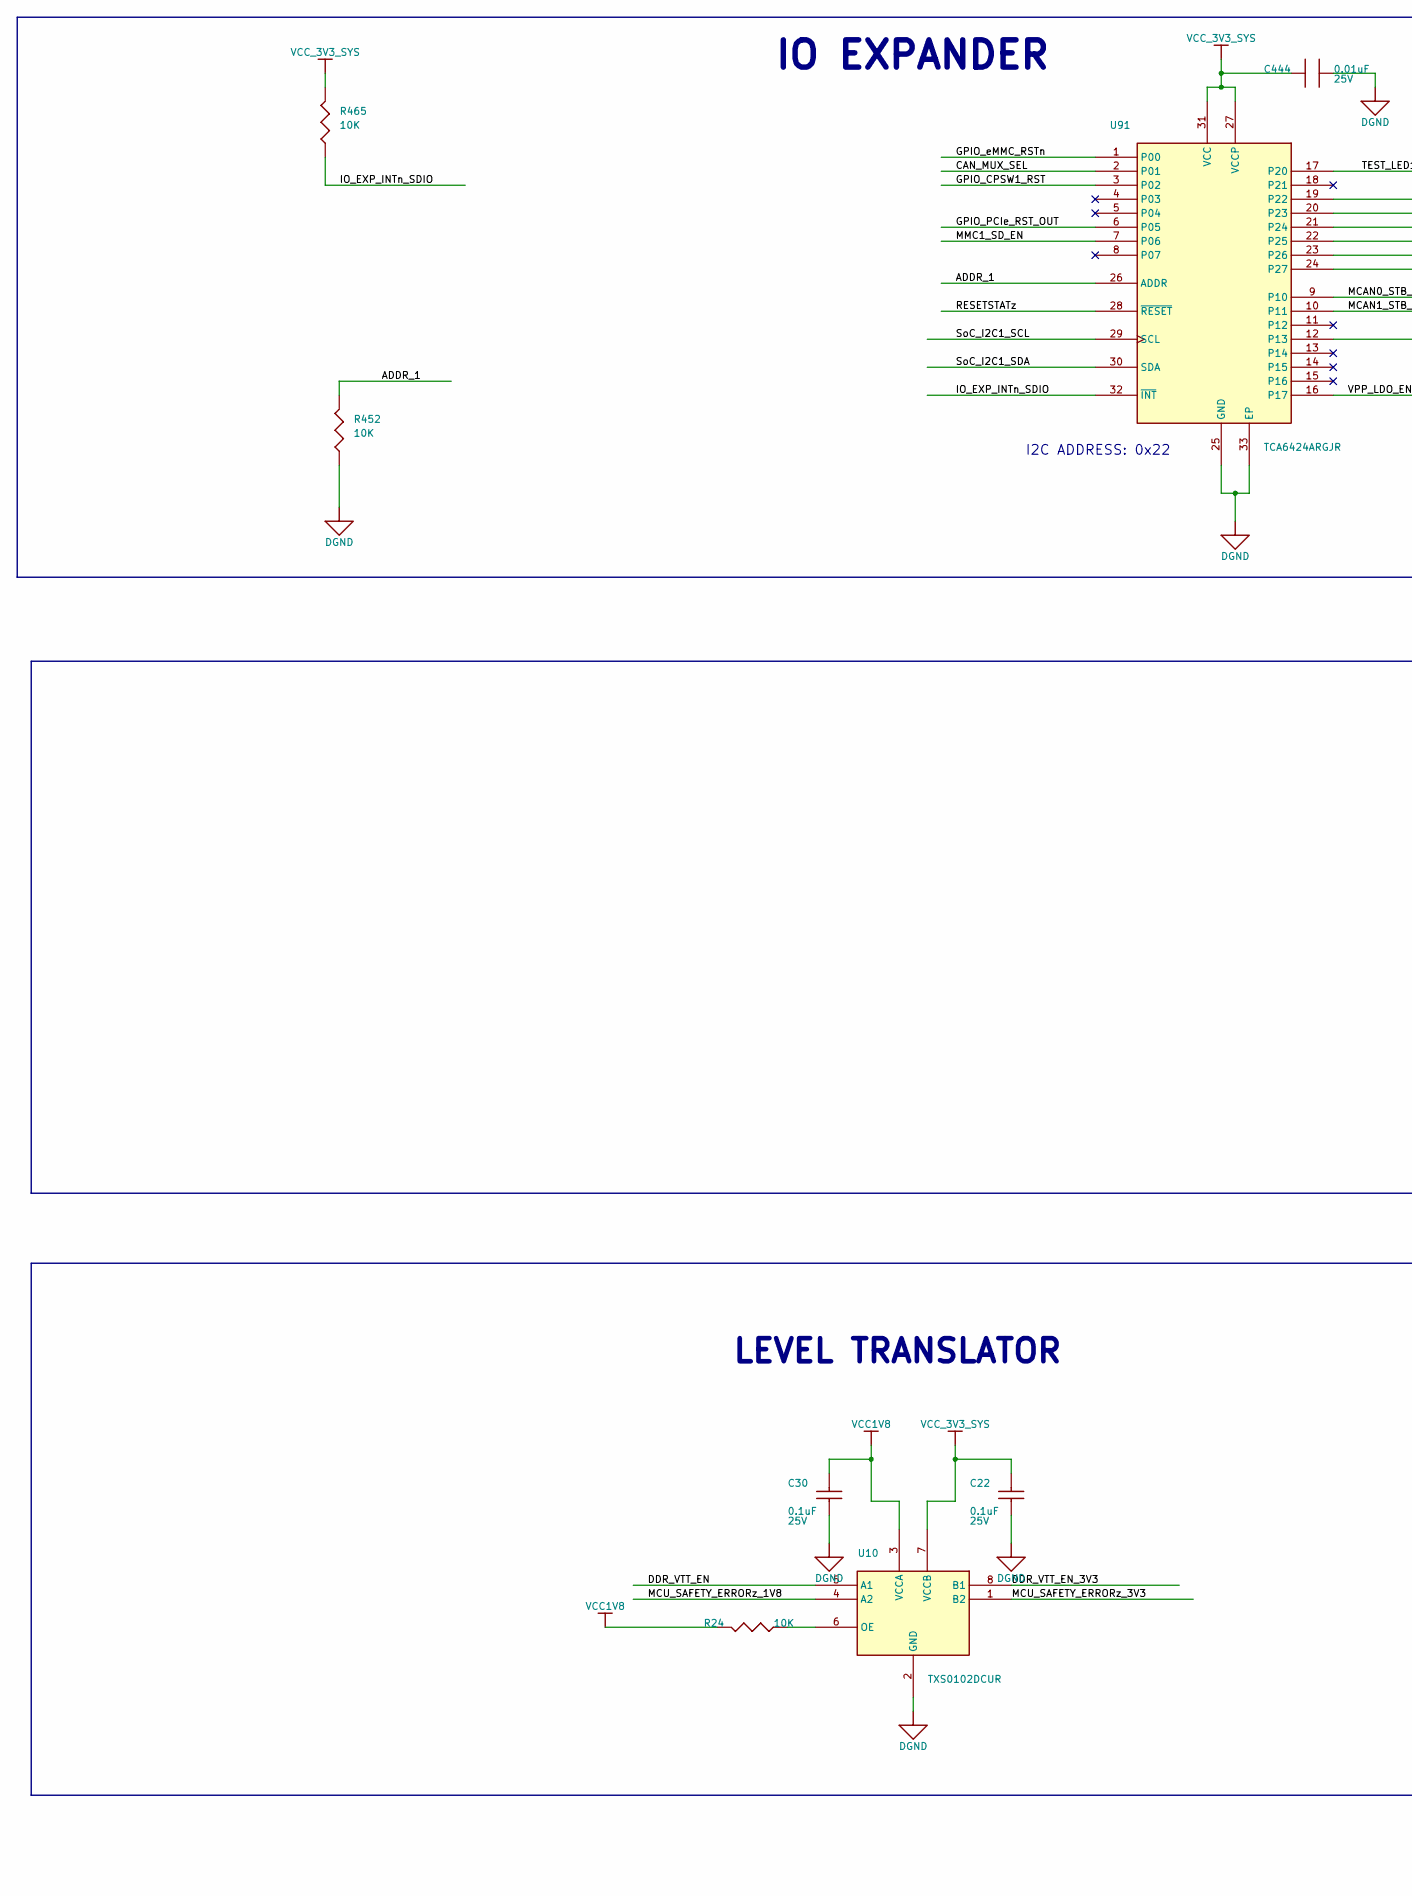
[picture p43: schematic 33.kicad_sch, part in row 1, column 1]

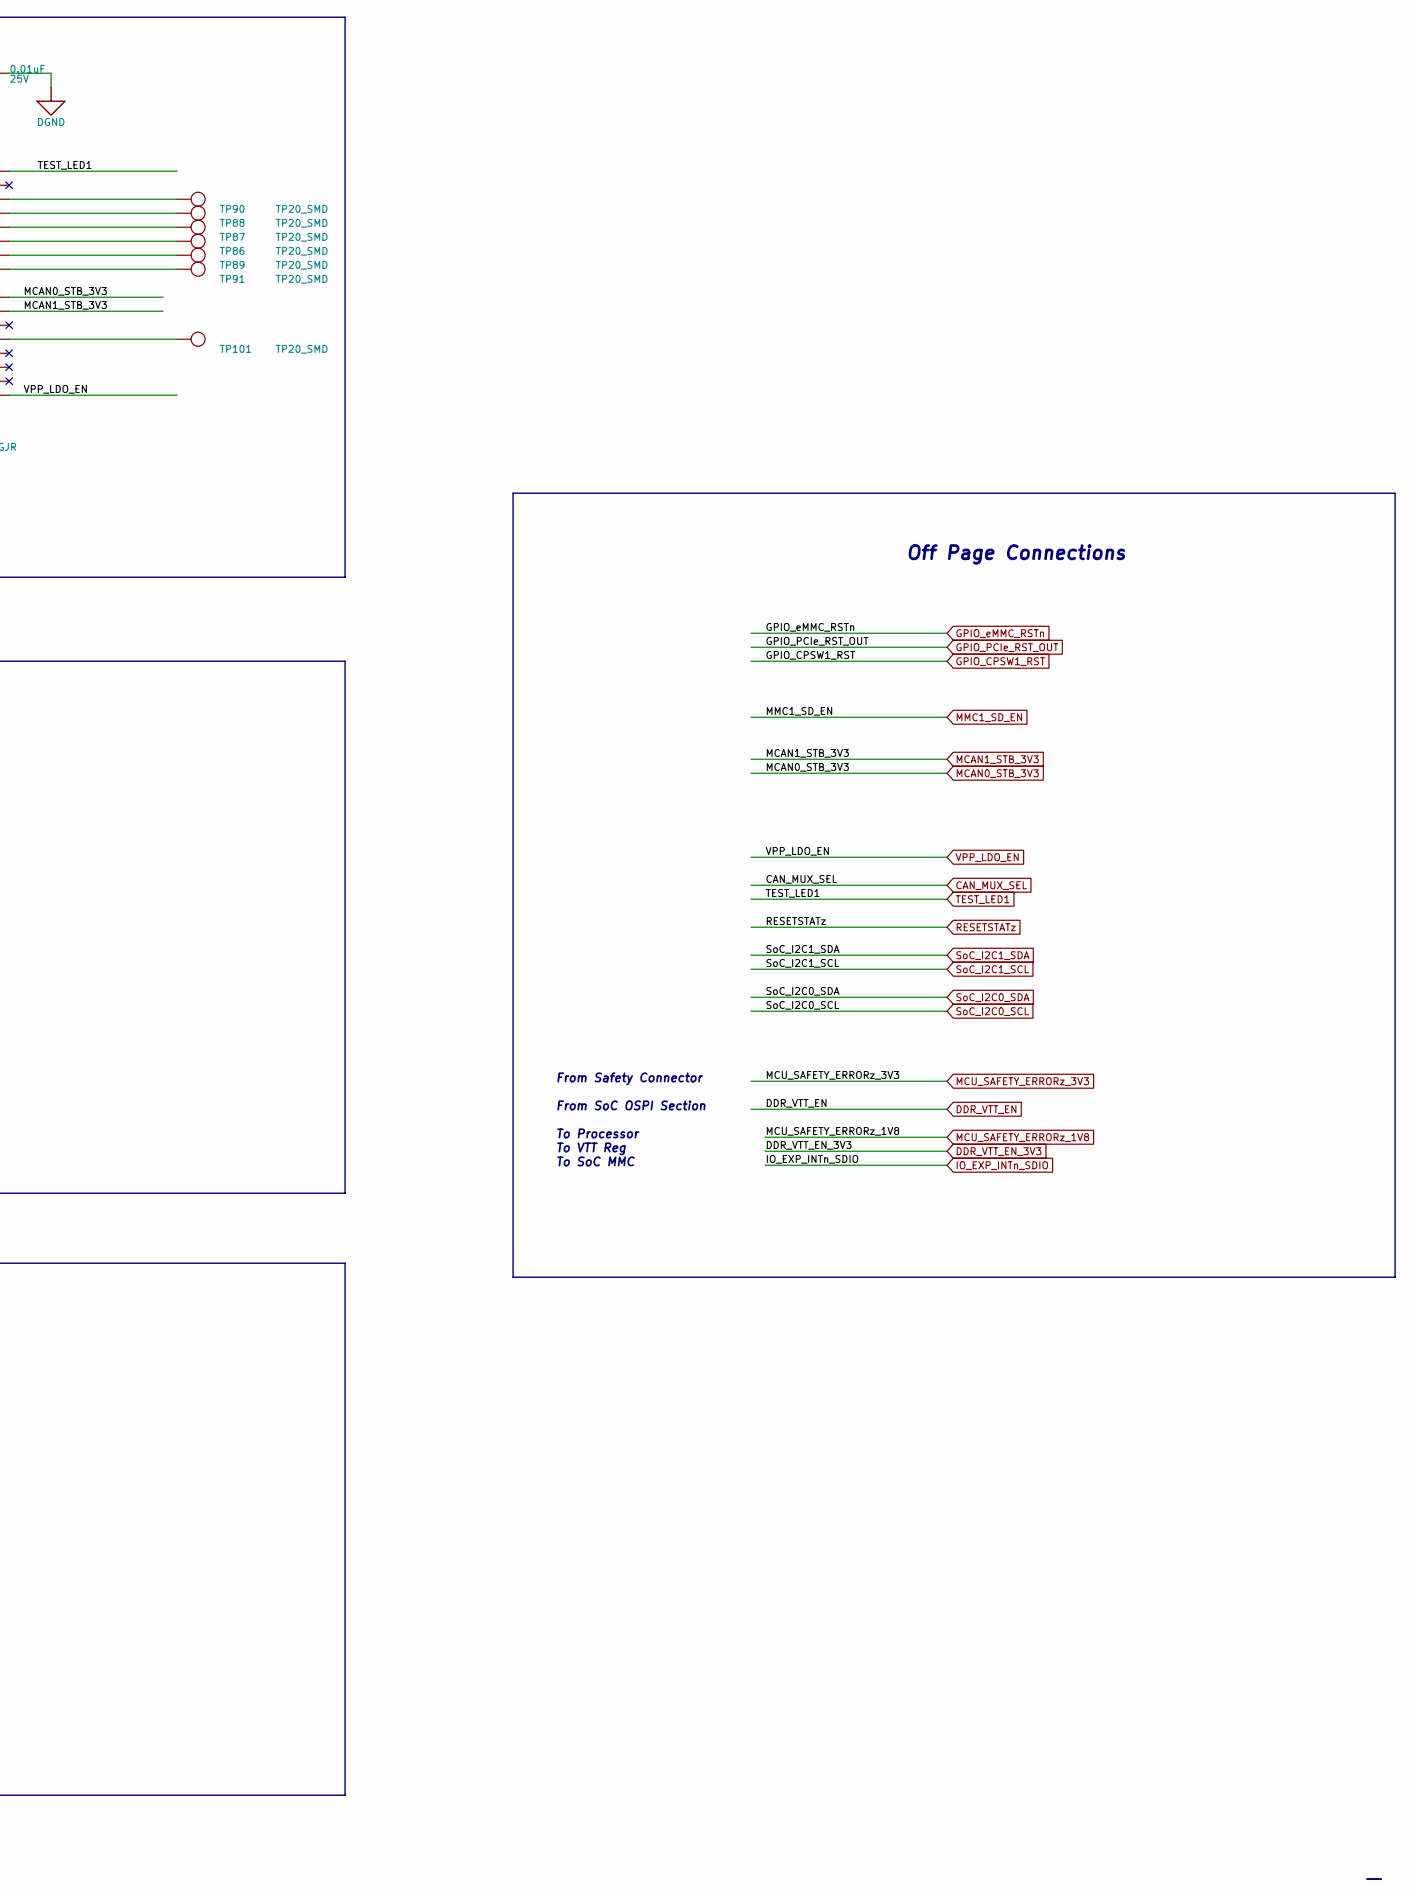
[picture p44: schematic 33.kicad_sch, part in row 1, column 2]

Parts:
C22, C30: 0.1uF; CAP0402_0-75; VOLTAGE 25V; TOLERANCE 20%; PART_TYPE CAPACITOR~{S}CERAMIC
C444: 0.01uF; CAP0402N; VOLTAGE 25V; TOLERANCE 10%; PART_TYPE CAPACITOR~{S}CERAMIC
R24, R452: 10K; RES0402_0-5; VOLTAGE NA; TOLERANCE 5%; PART_TYPE RESISTOR~{S}FIXED
R465: 10K; RES0402_0-5; TOLERANCE 5%; VOLTAGE NA; MISTRAL PART NO 110011060021-R
TP86, TP87, TP88, TP89, TP90, TP91: TP20_SMD; VOLTAGE NA; TOLERANCE NA; PART_TYPE TESTPOINT
TP101: TP20_SMD; TOLERANCE NA; VOLTAGE NA; MISTRAL PART NO NA
U10: TXS0102DCUR; VSSOP8_19-68_85X95_0-9; TOLERANCE NA; VOLTAGE NA; MISTRAL PART NO 141009030376-R
U91: TCA6424ARGJR; QFN32_19-68_200X200; PART_TYPE IC~{S}DIGITA~{L}BUSTRANSCEIVER

Connections:
ADDR_1: R452.2, U91.26 (ADDR)
CAN_MUX_SEL: U91.2 (P01)
DDR_VTT_EN: U10.5 (A1)
DDR_VTT_EN_3V3: U10.8 (B1)
DGND: C22.1, C30.1, C444.1, R452.1, U10.2 (GND), U91.25 (GND), U91.33 (EP)
GPIO_CPSW1_RST: U91.3 (P02)
GPIO_PCIe_RST_OUT: U91.6 (P05)
GPIO_eMMC_RSTn: U91.1 (P00)
IO_EXP_INTn_SDIO: R465.1, U91.32 (~INT)
MCAN0_STB_3V3: U91.9 (P10)
MCAN1_STB_3V3: U91.10 (P11)
MCU_SAFETY_ERRORz_1V8: U10.4 (A2)
MCU_SAFETY_ERRORz_3V3: U10.1 (B2)
MMC1_SD_EN: U91.7 (P06)
unnamed: R24.1, U10.6 (OE)
unnamed: TP86.1, U91.22 (P25)
unnamed: TP87.1, U91.21 (P24)
unnamed: TP88.1, U91.20 (P23)
unnamed: TP89.1, U91.23 (P26)
unnamed: TP90.1, U91.19 (P22)
unnamed: TP91.1, U91.24 (P27)
unnamed: TP101.1, U91.12 (P13)
RESETSTATz: U91.28 (~RESET)
SoC_I2C1_SCL: U91.29 (SCL)
SoC_I2C1_SDA: U91.30 (SDA)
TEST_LED1: U91.17 (P20)
VCC1V8: C30.2, R24.2, U10.3 (VCCA)
VCC_3V3_SYS: C22.2, C444.2, R465.2, U10.7 (VCCB), U91.27 (VCCP), U91.31 (VCC)
VPP_LDO_EN: U91.16 (P17)

Notes on the sheet:
LEVEL TRANSLATOR
IO EXPANDER
From Safety Connector
From SoC OSPI Section
To SoC MMC
Off Page Connections
I2C ADDRESS: 0x22
To Processor
To VTT Reg
