gingerologist/am64x/34.kicad_sch

## KiCad design 34.kicad_sch (2024-08-05)

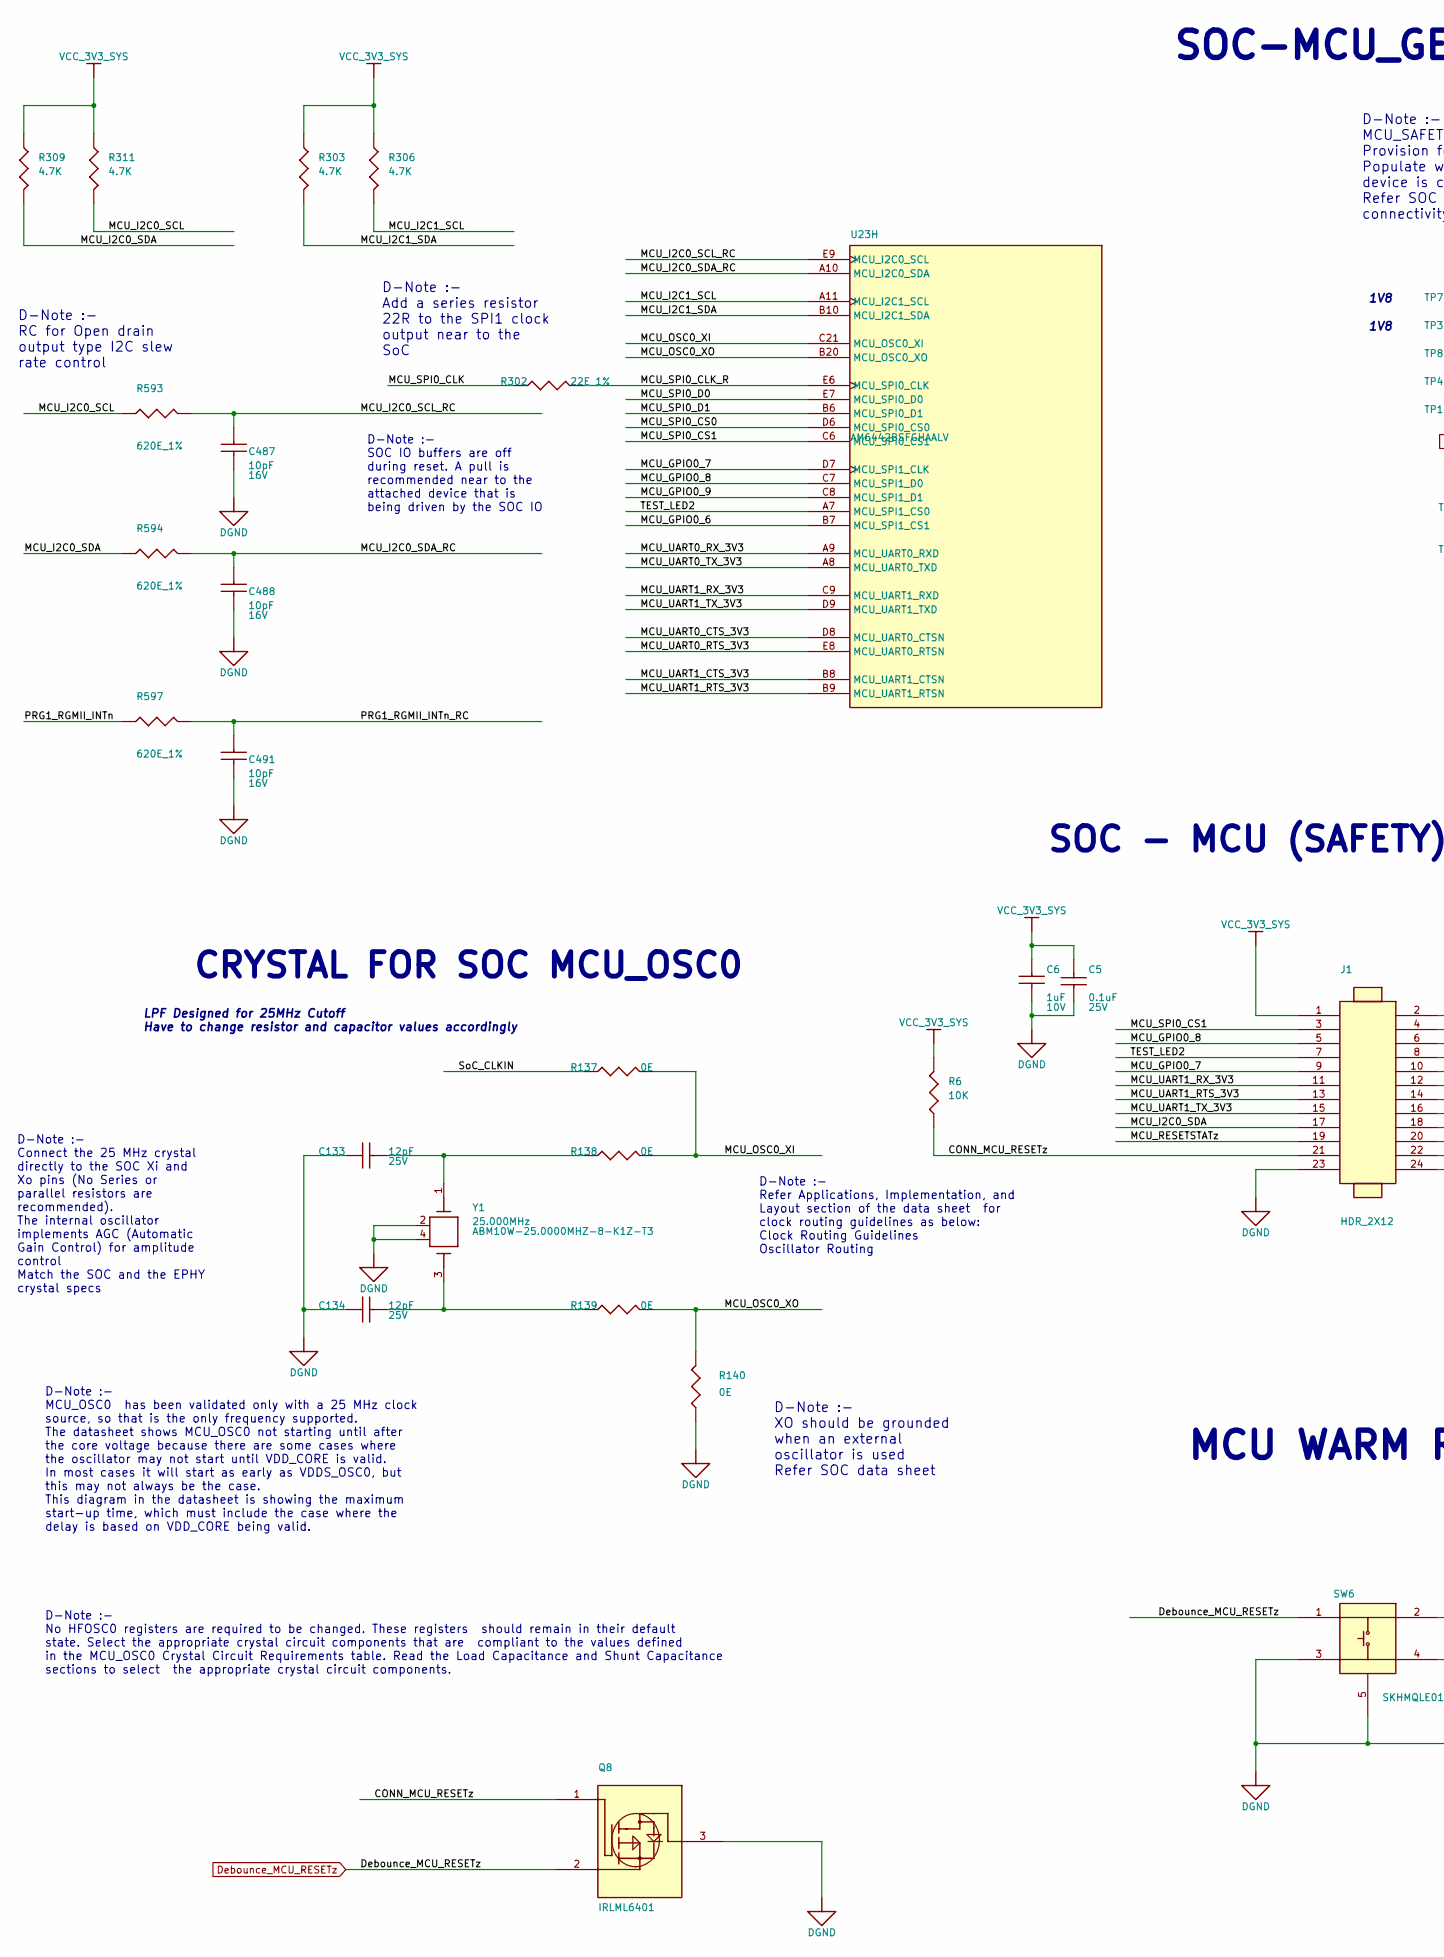
[picture p45: schematic 34.kicad_sch, part in row 1, column 1]

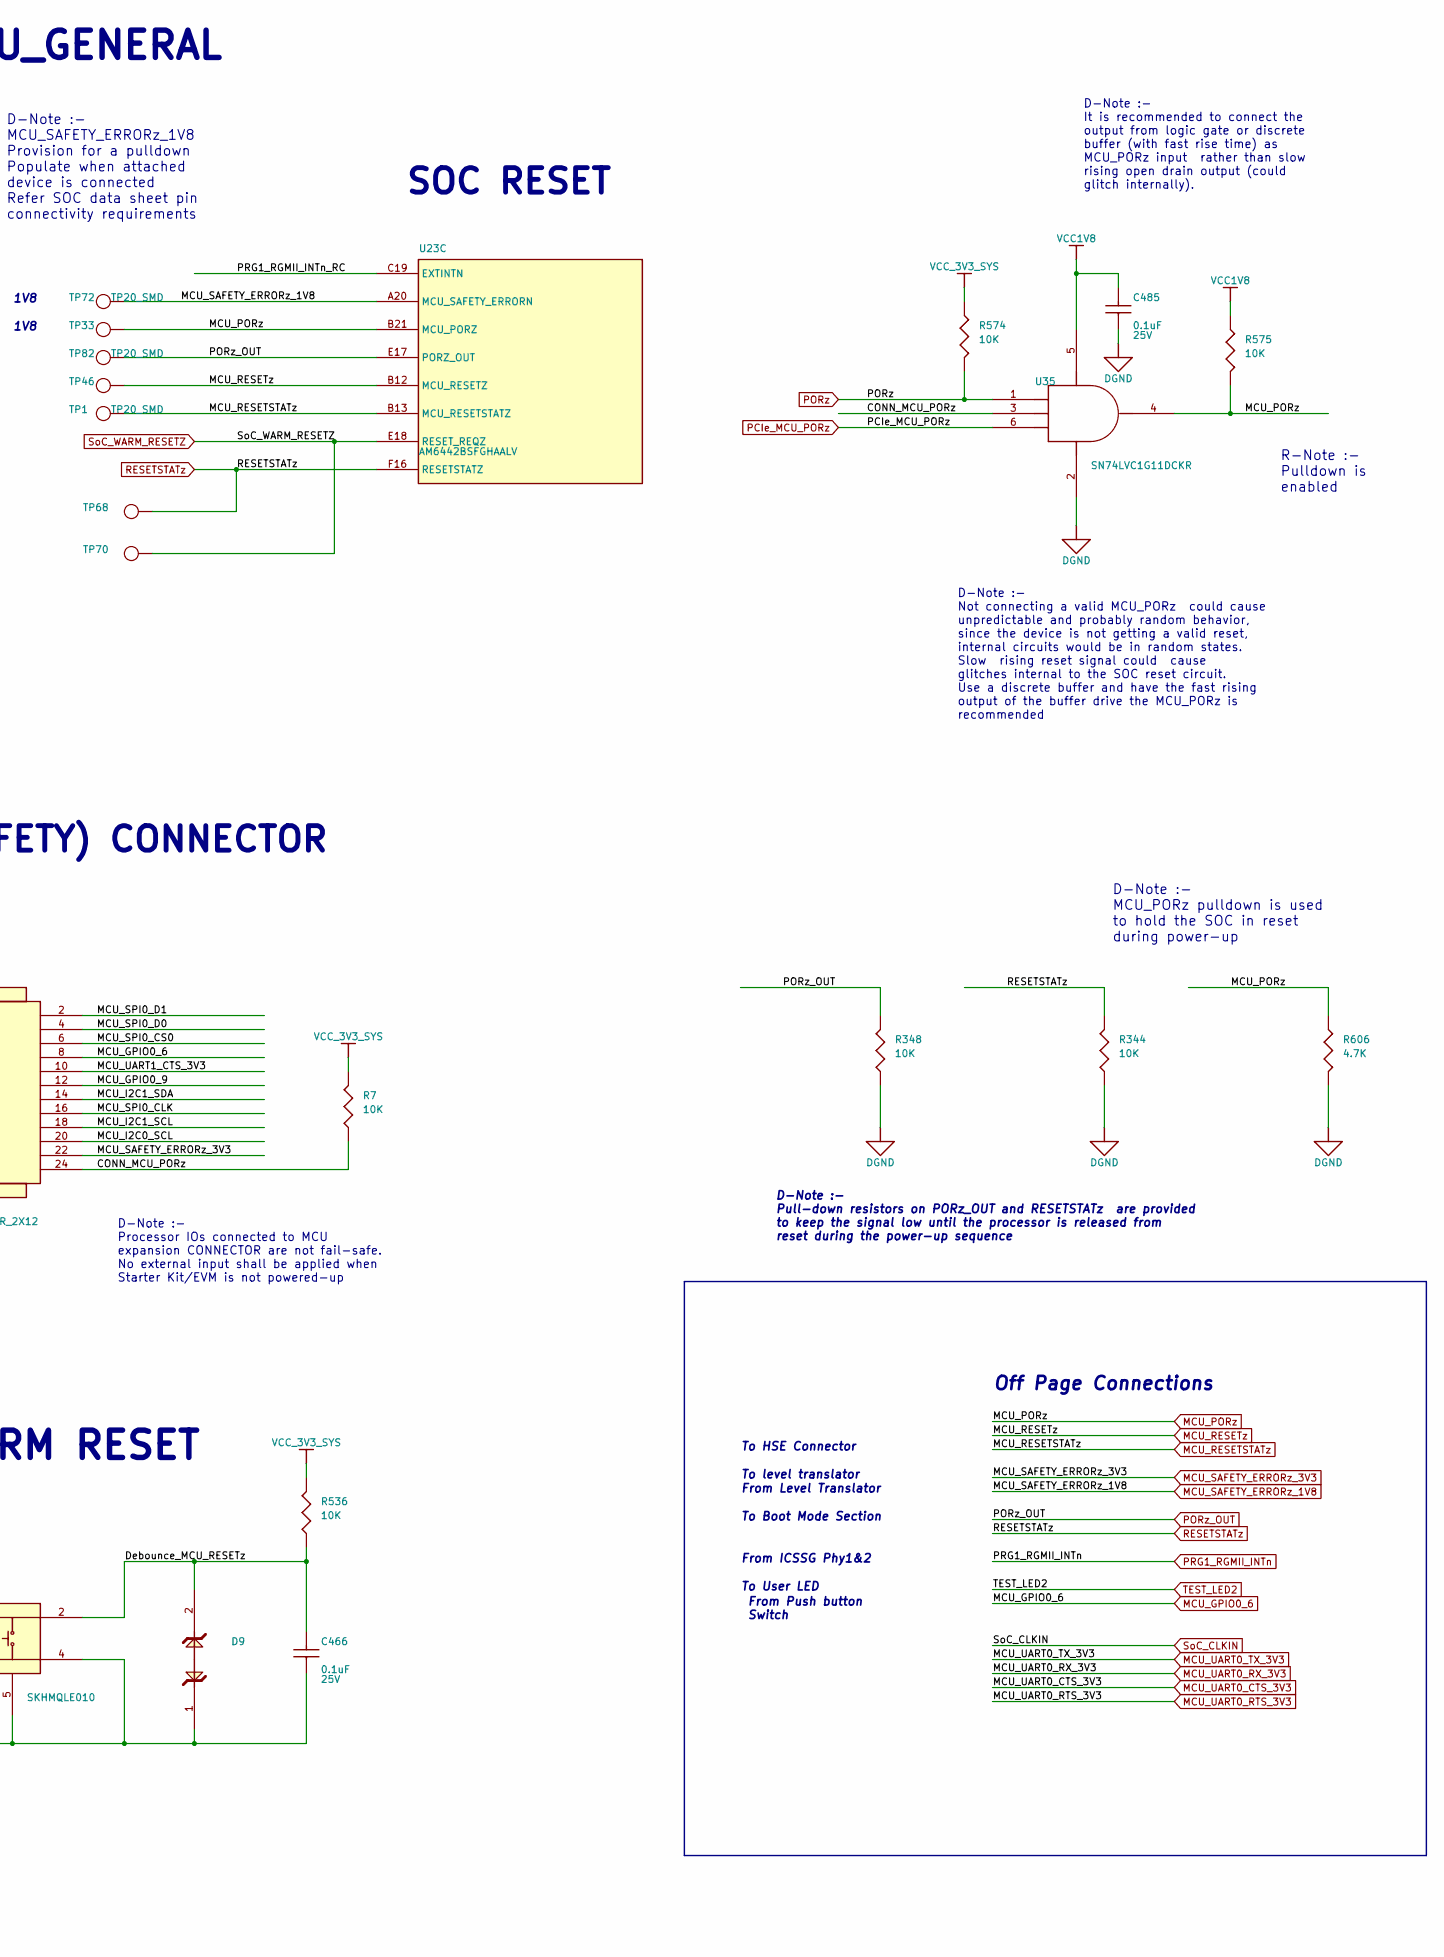
[picture p46: schematic 34.kicad_sch, part in row 1, column 2]

Parts:
C5: 0.1uF; CAP0402_0-75; VOLTAGE 25V; TOLERANCE 20%; PART_TYPE CAPACITOR~{S}CERAMIC
C6: 1uF; CAP0402_0-75; VOLTAGE 10V; TOLERANCE 20%; PART_TYPE CAPACITOR~{S}CERAMIC
C133: 12pF; CAP0201_0-5; VOLTAGE 25V; TOLERANCE 5%; PART_TYPE CAPACITOR~{S}CERAMIC
C134: 12pF; CAP0201_0-5; TOLERANCE 5%; VOLTAGE 25V; MISTRAL PART NO 120009030213-R
C466, C485: 0.1uF; CAP0402_0-75; TOLERANCE 20%; VOLTAGE 25V; MISTRAL PART NO 120020080003-R
C487, C488, C491: 10pF; CAP0402_0-75; TOLERANCE 5%; VOLTAGE 16V; MISTRAL PART NO 120018030015-R
D9: TPD1E10B06DPYR; DIO_DFN0402_0-5; TOLERANCE NA; VOLTAGE NA; MISTRAL PART NO 130014110022-R
J1: HDR_2X12; HDR_2X12_TSW-112-07-D_S_T_8-6; TOLERANCE NA; VOLTAGE NA; MISTRAL PART NO 150020040027-R
Q8: IRLML6401; TO_SOT23-123; VOLTAGE NA; TOLERANCE NA; PART_TYPE TRANSISTO~{R}MOSFET
R6, R7, R344, R574, R575: 10K; RES0402_0-5; TOLERANCE 5%; VOLTAGE NA; MISTRAL PART NO 110011060021-R
R137, R138, R139, R140: 0E; RES0402_0-5; VOLTAGE NA; TOLERANCE NA; PART_TYPE RESISTOR~{S}FIXED
R302: 22E_1%; RES0402_0-5; TOLERANCE 1%; VOLTAGE NA; MISTRAL PART NO 110009090004-R
R303, R306, R606: 4.7K; RES0402_0-5; TOLERANCE 5%; VOLTAGE NA; MISTRAL PART NO 110011060001-R
R309, R311: 4.7K; RES0402_0-5; VOLTAGE NA; TOLERANCE 5%; PART_TYPE RESISTOR~{S}FIXED
R348, R536: 10K; RES0402_0-5; VOLTAGE NA; TOLERANCE 5%; PART_TYPE RESISTOR~{S}FIXED
R593, R594, R597: 620E_1%; RES0402_0-5; TOLERANCE 1%; VOLTAGE NA; MISTRAL PART NO 110012090013-R
SW6: SKHMQLE010; SW4_SKHMQLE010_240X260_SMD_3-1; TOLERANCE NA; VOLTAGE NA; MISTRAL PART NO 130017100007-R
TP1, TP46, TP68, TP82: TP20_SMD; TOLERANCE NA; VOLTAGE NA; MISTRAL PART NO NA
TP33, TP70, TP72: TP20_SMD; VOLTAGE NA; TOLERANCE NA; PART_TYPE TESTPOINT
U23: AM6442BSFGHAALV; FCBGA441_31-49_680X680_2-6; TOLERANCE NA; VOLTAGE NA; MISTRAL PART NO 141220080002
U35: SN74LVC1G11DCKR; SC70-6; MISTRAL PART NO 141009030230-R
Y1: 25.000MHz; XTAL4_ABM10W_100X80_SMD_0-6; TOLERANCE NA; VOLTAGE NA; MISTRAL PART NO 130020060044-R

Connections:
CONN_MCU_PORz: J1.24, R7.1, U35.3 (B)
CONN_MCU_RESETz: J1.21, Q8.1 (G), R6.1
DGND: C5.1, C6.2, C133.1, C134.1, C466.1, C485.1, C487.2, C488.2, C491.2, D9.1, J1.23, Q8.3 (D), R140.1, R344.1, R348.1, R606.2, SW6.3, SW6.4, SW6.5 (GND), U35.2 (GND), Y1.2 (GND1), Y1.4 (GND2)
Debounce_MCU_RESETz: C466.2, D9.2, Q8.2 (S), R536.1, SW6.1, SW6.2
MCU_GPIO0_6: J1.8, U23.B7 (MCU_SPI1_CS1)
MCU_GPIO0_7: J1.9, U23.D7 (MCU_SPI1_CLK)
MCU_GPIO0_8: J1.5, U23.C7 (MCU_SPI1_D0)
MCU_GPIO0_9: J1.12, U23.C8 (MCU_SPI1_D1)
MCU_I2C0_SCL: J1.20, R311.2, R593.1
MCU_I2C0_SCL_RC: C487.1, R593.2, U23.E9 (MCU_I2C0_SCL)
MCU_I2C0_SDA: J1.17, R309.2, R594.1
MCU_I2C0_SDA_RC: C488.1, R594.2, U23.A10 (MCU_I2C0_SDA)
MCU_I2C1_SCL: J1.18, R306.2, U23.A11 (MCU_I2C1_SCL)
MCU_I2C1_SDA: J1.14, R303.2, U23.B10 (MCU_I2C1_SDA)
MCU_OSC0_XI: R137.2, R138.2, U23.C21 (MCU_OSC0_XI)
MCU_OSC0_XO: R139.2, R140.2, U23.B20 (MCU_OSC0_XO)
MCU_PORz: R575.2, R606.1, TP33.1, U23.B21 (MCU_PORZ), U35.4 (Y)
MCU_RESETSTATz: J1.19, TP1.1, U23.B13 (MCU_RESETSTATZ)
MCU_RESETz: TP46.1, U23.B12 (MCU_RESETZ)
MCU_SAFETY_ERRORz_1V8: TP72.1, U23.A20 (MCU_SAFETY_ERRORN)
MCU_SAFETY_ERRORz_3V3: J1.22
MCU_SPI0_CLK: J1.16, R302.1
MCU_SPI0_CLK_R: R302.2, U23.E6 (MCU_SPI0_CLK)
MCU_SPI0_CS0: J1.6, U23.D6 (MCU_SPI0_CS0)
MCU_SPI0_CS1: J1.3, U23.C6 (MCU_SPI0_CS1)
MCU_SPI0_D0: J1.4, U23.E7 (MCU_SPI0_D0)
MCU_SPI0_D1: J1.2, U23.B6 (MCU_SPI0_D1)
MCU_UART0_CTS_3V3: U23.D8 (MCU_UART0_CTSN)
MCU_UART0_RTS_3V3: U23.E8 (MCU_UART0_RTSN)
MCU_UART0_RX_3V3: U23.A9 (MCU_UART0_RXD)
MCU_UART0_TX_3V3: U23.A8 (MCU_UART0_TXD)
MCU_UART1_CTS_3V3: J1.10, U23.B8 (MCU_UART1_CTSN)
MCU_UART1_RTS_3V3: J1.13, U23.B9 (MCU_UART1_RTSN)
MCU_UART1_RX_3V3: J1.11, U23.C9 (MCU_UART1_RXD)
MCU_UART1_TX_3V3: J1.15, U23.D9 (MCU_UART1_TXD)
unnamed: C133.2, R138.1, Y1.1
unnamed: C134.2, R139.1, Y1.3
PCIe_MCU_PORz: U35.6 (C)
PORz: R574.2, U35.1 (A)
PORz_OUT: R348.2, TP82.1, U23.E17 (PORZ_OUT)
PRG1_RGMII_INTn: R597.1
PRG1_RGMII_INTn_RC: C491.1, R597.2, U23.C19 (EXTINTN)
RESETSTATz: R344.2, TP68.1, U23.F16 (RESETSTATZ)
SoC_CLKIN: R137.1
SoC_WARM_RESETZ: TP70.1, U23.E18 (RESET_REQZ)
TEST_LED2: J1.7, U23.A7 (MCU_SPI1_CS0)
VCC1V8: C485.2, R575.1, U35.5 (VCC)
VCC_3V3_SYS: C5.2, C6.1, J1.1, R6.2, R7.2, R303.1, R306.1, R309.1, R311.1, R536.2, R574.1

Notes on the sheet:
D-Note :- MCU_SAFETY_ERRORz_1V8 Provision for a pulldown Populate when attached device is connected Refer SOC data sheet pin connectivity requirements
D-Note :- XO should be grounded when an external oscillator is used Refer SOC data sheet
D-Note :- SOC IO buffers are off during reset. A pull is recommended near to the attached device that is being driven by the SOC IO
D-Note :- MCU_PORz pulldown is used to hold the SOC in reset during power-up
D-Note :- Refer Applications, Implementation, and Layout section of the data sheet for clock routing guidelines as below: Clock Routing Guidelines Oscillator Routing
D-Note :- No HFOSC0 registers are required to be changed. These registers should remain in their default state. Select the appropriate crystal circuit components that are compliant to the values defined in the MCU_OSC0 Crystal Circuit Requirements table. Read the Load Capacitance and Shunt Capacita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
R-Note :- Pulldown is enabled
From Push button Switch
D-Note :- MCU_OSC0 has been validated only with a 25 MHz clock source, so that is the only frequency supported. The datasheet shows MCU_OSC0 not starting until after the core voltage because there are some cases where the oscillator may not start until VDD_CORE is valid. In most cases it will start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
D-Note :- Processor IOs connected to MCU expansion CONNECTOR are not fail-safe. No external input shall be applied when Starter Kit/EVM is not powered-up
D-Note :- Pull-down resistors on PORz_OUT and RESETSTATz are provided to keep the signal low until the processor is released from reset during the power-up sequence
D-Note :- RC for Open drain output type I2C slew rate control
D-Note :- Not connecting a valid MCU_PORz could cause unpredictable and probably random behavior, since the device is not getting a valid reset, internal circuits would be in random states. Slow rising reset signal could cause glitches internal to the SOC reset circuit. Use a discrete buffer and ha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
D-Note :- Add a series resistor 22R to the SPI1 clock output near to the SoC
LPF Designed for 25MHz Cutoff Have to change resistor and capacitor values accordingly
D-Note :- Connect the 25 MHz crystal directly to the SOC Xi and Xo pins (No Series or parallel resistors are recommended). The internal oscillator implements AGC (Automatic Gain Control) for amplitude control Match the SOC and the EPHY crystal specs
D-Note :- It is recommended to connect the output from logic gate or discrete buffer (with fast rise time) as MCU_PORz input rather than slow rising open drain output (could glitch internally).
SOC-MCU_GENERAL
From ICSSG Phy1&2
SOC RESET
SOC - MCU (SAFETY) CONNECTOR
To level translator
MCU WARM RESET
1V8
To Boot Mode Section
Off Page Connections
CRYSTAL FOR SOC MCU_OSC0
From Level Translator
To HSE Connector
To User LED
