gingerologist/am64x/35.kicad_sch

## KiCad design 35.kicad_sch (2024-08-05)

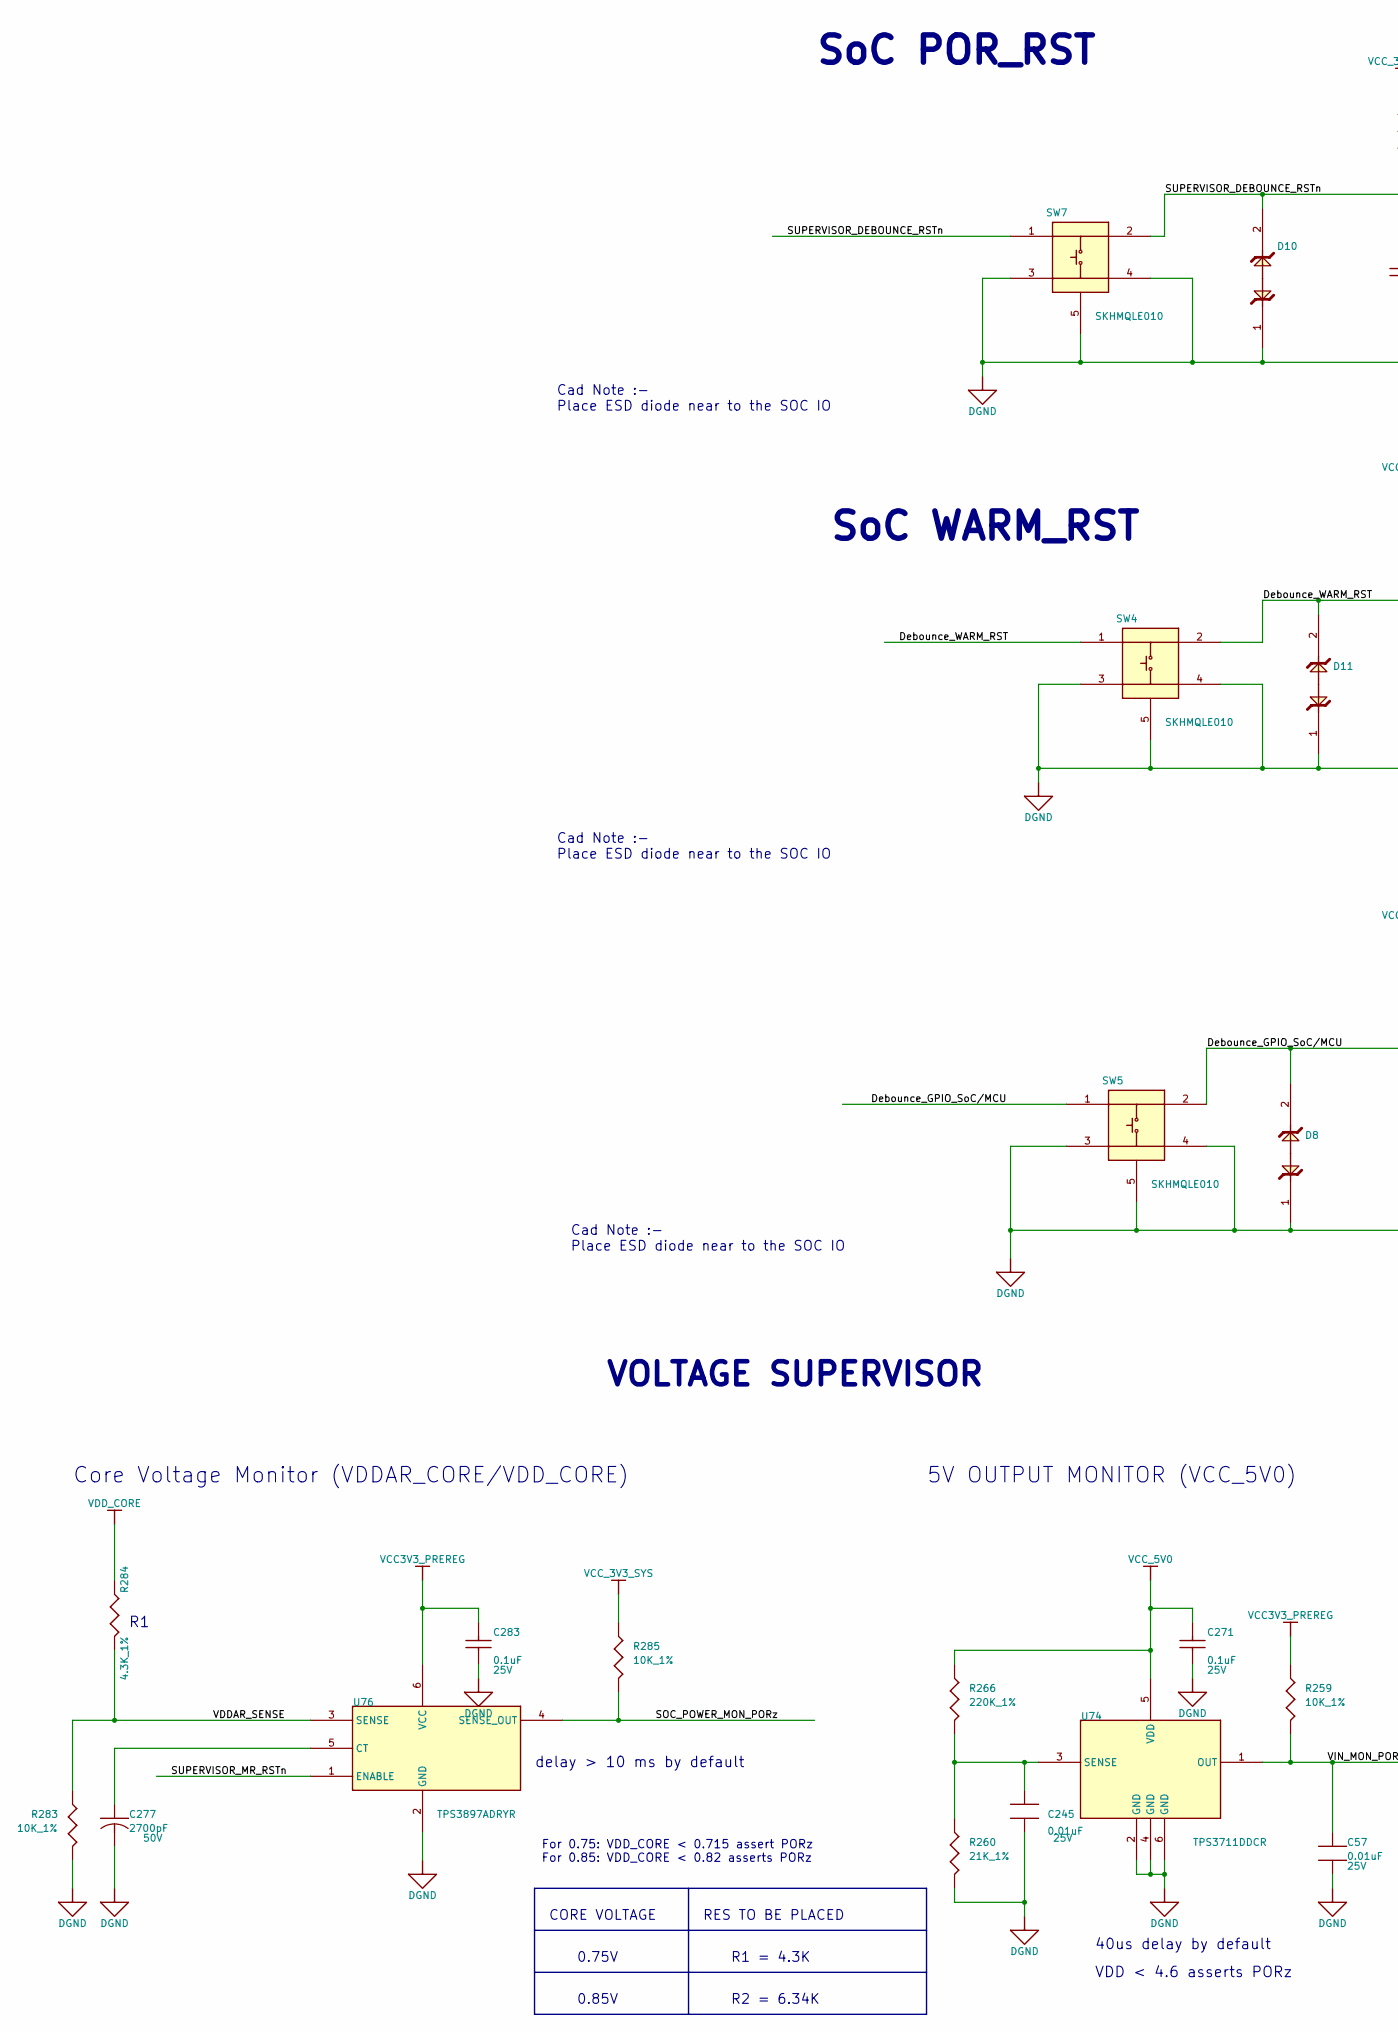
[picture p47: schematic 35.kicad_sch, part in row 1, column 1]

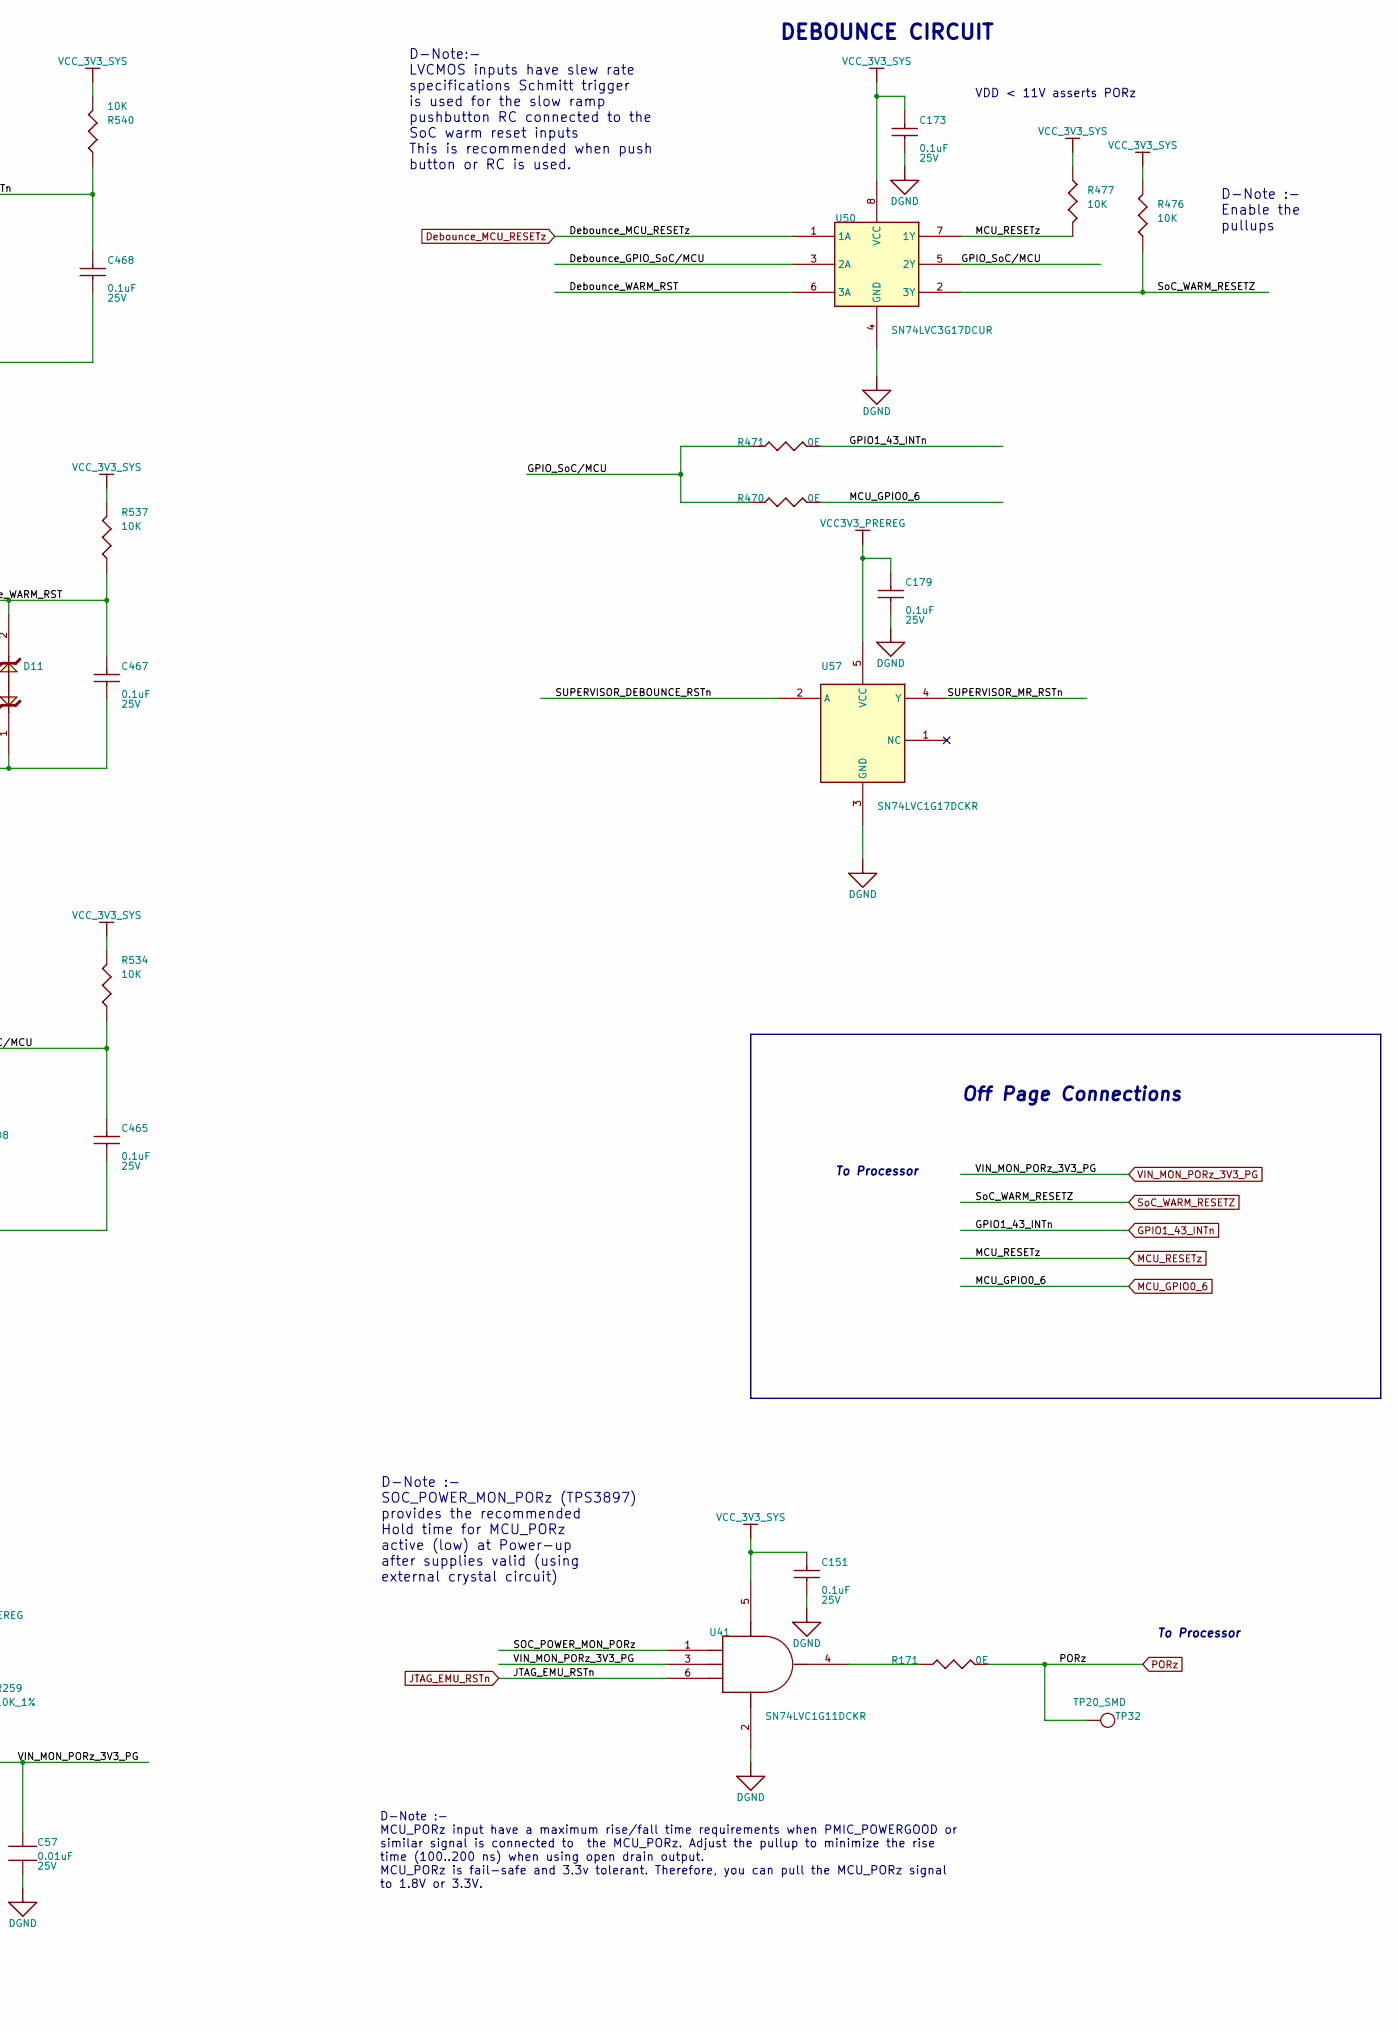
[picture p48: schematic 35.kicad_sch, part in row 1, column 2]

Parts:
C57, C245: 0.01uF; CAP0402N; TOLERANCE 10%; VOLTAGE 25V; MISTRAL PART NO 120011090040-R
C151, C173, C179, C271, C283, C467, C468: 0.1uF; CAP0402_0-75; VOLTAGE 25V; TOLERANCE 20%; PART_TYPE CAPACITOR~{S}CERAMIC
C277: 2700pF; CAP0603_1; VOLTAGE 50V; TOLERANCE 5%; PART_TYPE CAPACITOR~{S}CERAMIC
C465: 0.1uF; CAP0402_0-75; TOLERANCE 20%; VOLTAGE 25V; MISTRAL PART NO 120020080003-R
D8, D10: TPD1E10B06DPYR; DIO_DFN0402_0-5; TOLERANCE NA; VOLTAGE NA; MISTRAL PART NO 130014110022-R
D11: TPD1E10B06DPYR; DIO_DFN0402_0-5; VOLTAGE NA; TOLERANCE NA; PART_TYPE DIODE
R171: 0E; RES0402_0-5; VOLTAGE NA; TOLERANCE NA; PART_TYPE RESISTOR~{S}FIXED
R259, R283, R285: 10K_1%; RES0402_0-5; TOLERANCE 1%; VOLTAGE NA; PART_TYPE RESISTOR~{S}FIXED
R260: 21K_1%; RES0402_0-5; TOLERANCE 1%; VOLTAGE NA; MISTRAL PART NO 110015080019-R
R266: 220K_1%; RES0402_0-5; TOLERANCE 1%; VOLTAGE NA; MISTRAL PART NO 110017080025-R
R284: 4.3K_1%; RES0402_0-5; VOLTAGE NA; TOLERANCE 1%; PART_TYPE RESISTOR~{S}FIXED
R470, R471: 0E; RES0402_0-5; TOLERANCE NA; VOLTAGE NA; MISTRAL PART NO 110010080019-R
R476, R477, R534, R540: 10K; RES0402_0-5; TOLERANCE 5%; VOLTAGE NA; MISTRAL PART NO 110011060021-R
R537: 10K; RES0402_0-5; VOLTAGE NA; TOLERANCE 5%; PART_TYPE RESISTOR~{S}FIXED
SW4: SKHMQLE010; SW4_SKHMQLE010_240X260_SMD_3-1; VOLTAGE NA; TOLERANCE NA; PART_TYPE ELECTRO-MECHANICA~{L}SWITCH
SW5, SW7: SKHMQLE010; SW4_SKHMQLE010_240X260_SMD_3-1; TOLERANCE NA; VOLTAGE NA; MISTRAL PART NO 130017100007-R
TP32: TP20_SMD; TOLERANCE NA; VOLTAGE NA; PART_TYPE TESTPOINT
U41: SN74LVC1G11DCKR; SC70-6; PART_TYPE IC~{S}DIGITA~{L}GATES
U50: SN74LVC3G17DCUR; VSSOP8_19-68_85X95_0-9; TOLERANCE NA; VOLTAGE NA; MISTRAL PART NO 141017090019-R
U57: SN74LVC1G17DCKR; SC70-5; TOLERANCE NA; VOLTAGE NA; MISTRAL PART NO 141010110012-R
U74: TPS3711DDCR; SOT23-6_1-1; VOLTAGE NA; TOLERANCE NA; PART_TYPE IC~{S}POWE~{R}MANAGEMENT
U76: TPS3897ADRYR; SON6_19-68_40X60_0-6; VOLTAGE NA; TOLERANCE NA; PART_TYPE IC~{S}POWE~{R}MANAGEMENT

Connections:
DGND: C57.2, C151.1, C173.1, C179.1, C245.2, C271.1, C277.2, C283.1, C465.1, C467.1, C468.1, D8.1, D10.1, D11.1, R260.2, R283.2, SW4.3, SW4.4, SW4.5 (GND), SW5.3, SW5.4, SW5.5 (GND), SW7.3, SW7.4, SW7.5 (GND), U41.2 (GND), U50.4 (GND), U57.3 (GND), U74.2 (GND), U74.4 (GND), U74.6 (GND), U76.2 (GND)
Debounce_GPIO_SoC/MCU: C465.2, D8.2, R534.1, SW5.1, SW5.2, U50.3 (2A)
Debounce_MCU_RESETz: U50.1 (1A)
Debounce_WARM_RST: C467.2, D11.2, R537.1, SW4.1, SW4.2, U50.6 (3A)
GPIO1_43_INTn: R471.2
GPIO_SoC/MCU: R470.1, R471.1, U50.5 (2Y)
JTAG_EMU_RSTn: U41.6 (C)
MCU_GPIO0_6: R470.2
MCU_RESETz: R477.2, U50.7 (1Y)
unnamed: C245.1, R260.1, R266.2, U74.3 (SENSE)
unnamed: C277.1, U76.5 (CT)
unnamed: R171.1, U41.4 (Y)
PORz: R171.2, TP32.1
SOC_POWER_MON_PORz: R285.2, U41.1 (A), U76.4 (SENSE_OUT)
SUPERVISOR_DEBOUNCE_RSTn: C468.2, D10.2, R540.1, SW7.1, SW7.2, U57.2 (A)
SUPERVISOR_MR_RSTn: U57.4 (Y), U76.1 (ENABLE)
SoC_WARM_RESETZ: R476.1, U50.2 (3Y)
VCC3V3_PREREG: C179.2, C283.2, R259.1, U57.5 (VCC), U76.6 (VCC)
VCC_3V3_SYS: C151.2, C173.2, R285.1, R476.2, R477.1, R534.2, R537.2, R540.2, U41.5 (VCC), U50.8 (VCC)
VCC_5V0: C271.2, R266.1, U74.5 (VDD)
VDDAR_SENSE: R283.1, R284.2, U76.3 (SENSE)
VDD_CORE: R284.1
VIN_MON_PORz_3V3_PG: C57.1, R259.2, U41.3 (B), U74.1 (OUT)

Notes on the sheet:
D-Note :- MCU_PORz input have a maximum rise/fall time requirements when PMIC_POWERGOOD or similar signal is connected to the MCU_PORz. Adjust the pullup to minimize the rise time (100..200 ns) when using open drain output. MCU_PORz is fail-safe and 3.3v tolerant. Therefore, you can pull the MCU_PO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
For 0.75: VDD_CORE < 0.715 assert PORz For 0.85: VDD_CORE < 0.82 asserts PORz
Cad Note :- Place ESD diode near to the SOC IO
D-Note:- LVCMOS inputs have slew rate specifications Schmitt trigger is used for the slow ramp pushbutton RC connected to the SoC warm reset inputs This is recommended when push button or RC is used.
D-Note :- Enable the pullups
D-Note :- SOC_POWER_MON_PORz (TPS3897) provides the recommended Hold time for MCU_PORz active (low) at Power-up after supplies valid (using external crystal circuit)
DEBOUNCE CIRCUIT
R2 = 6.34K
40us delay by default
RES TO BE PLACED
5V OUTPUT MONITOR (VCC_5V0)
CORE VOLTAGE
0.75V
VDD < 11V asserts PORz
SoC WARM_RST
Core Voltage Monitor (VDDAR_CORE/VDD_CORE)
VDD < 4.6 asserts PORz
VOLTAGE SUPERVISOR
Off Page Connections
To Processor
delay > 10 ms by default
R1 = 4.3K
SoC POR_RST
0.85V
