gingerologist/am64x/36.kicad_sch

## KiCad design 36.kicad_sch (2024-08-05)

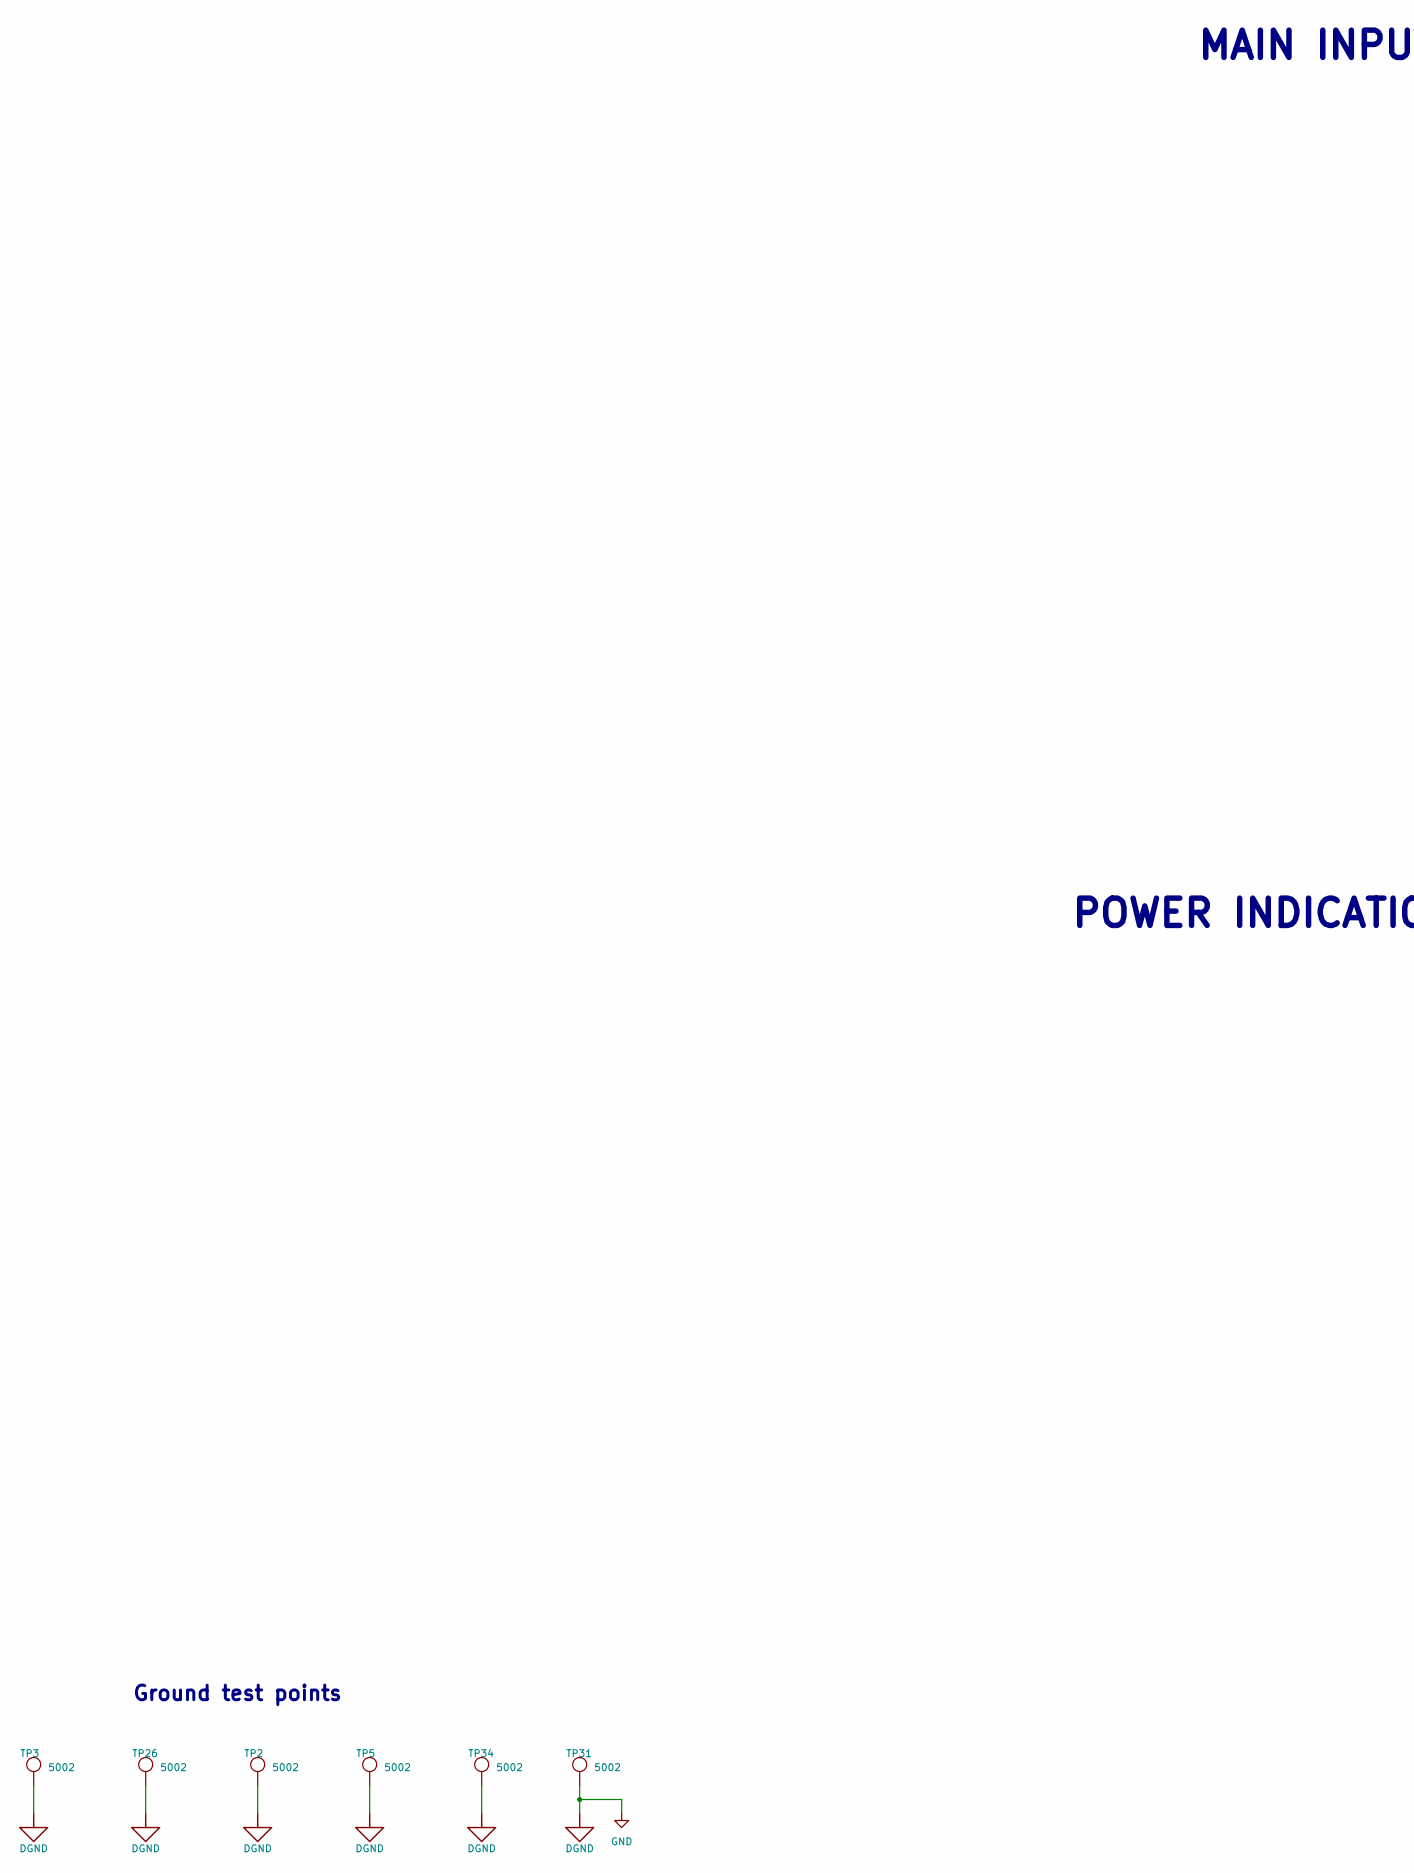
[picture p49: schematic 36.kicad_sch, part in row 1, column 1]

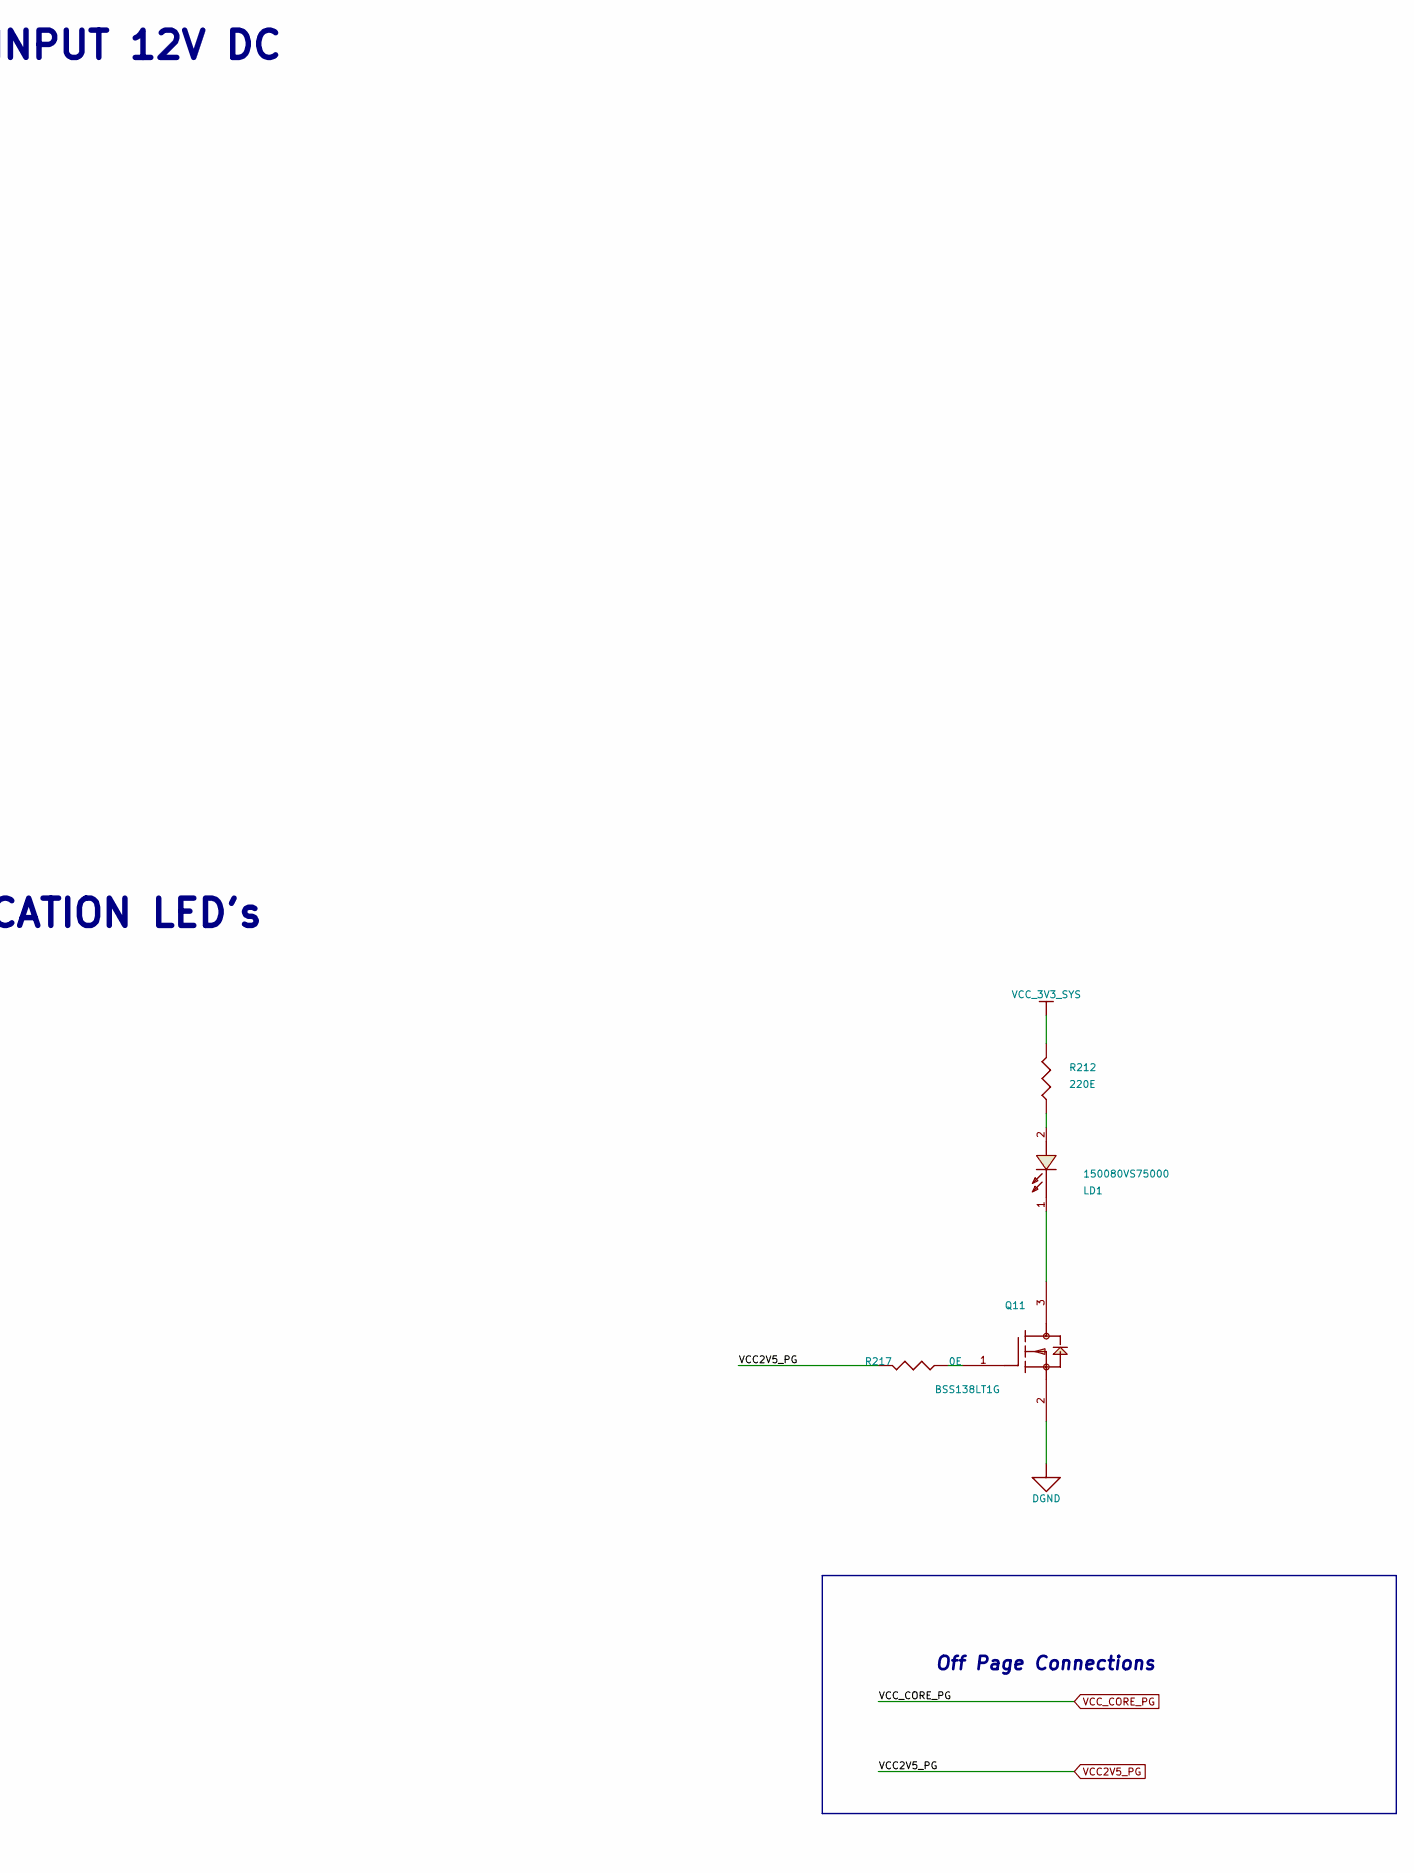
[picture p50: schematic 36.kicad_sch, part in row 1, column 2]

Parts:
LD1: 150080VS75000; LED_150080VS75000_80X50_SMD_0-8; VOLTAGE NA; TOLERANCE NA; PART_TYPE OPT~{O}LED
Q11: BSS138LT1G; SOT23-123_1-2; TOLERANCE NA; VOLTAGE NA; MISTRAL PART NO 142016040001-R
R212: 220E; RES0402_0-5; VOLTAGE NA; TOLERANCE 5%; MISTRAL PART NO 110009030506-R
R217: 0E; RES0402_0-5; VOLTAGE NA; TOLERANCE NA; PART_TYPE RESISTOR~{S}FIXED
TP2, TP3, TP5, TP26, TP31: 5002; TP_CIR67D40_TH_4-6; TOLERANCE NA; VOLTAGE NA; MISTRAL PART NO 160016120008-R
TP34: 5002; TP_CIR67D40_TH_4-6; VOLTAGE NA; TOLERANCE NA; PART_TYPE ACCESSORIES

Connections:
DGND: Q11.2 (S), TP2.1, TP3.1, TP5.1, TP26.1, TP31.1, TP34.1
unnamed: LD1.1 (CATHODE), Q11.3 (D)
unnamed: LD1.2 (ANODE), R212.1
unnamed: Q11.1 (G), R217.1
VCC2V5_PG: R217.2
VCC_3V3_SYS: R212.2

Notes on the sheet:
POWER INDICATION LED's
Off Page Connections
MAIN INPUT 12V DC
Ground test points
