gingerologist/am64x/37.kicad_sch

## KiCad design 37.kicad_sch (2024-08-05)

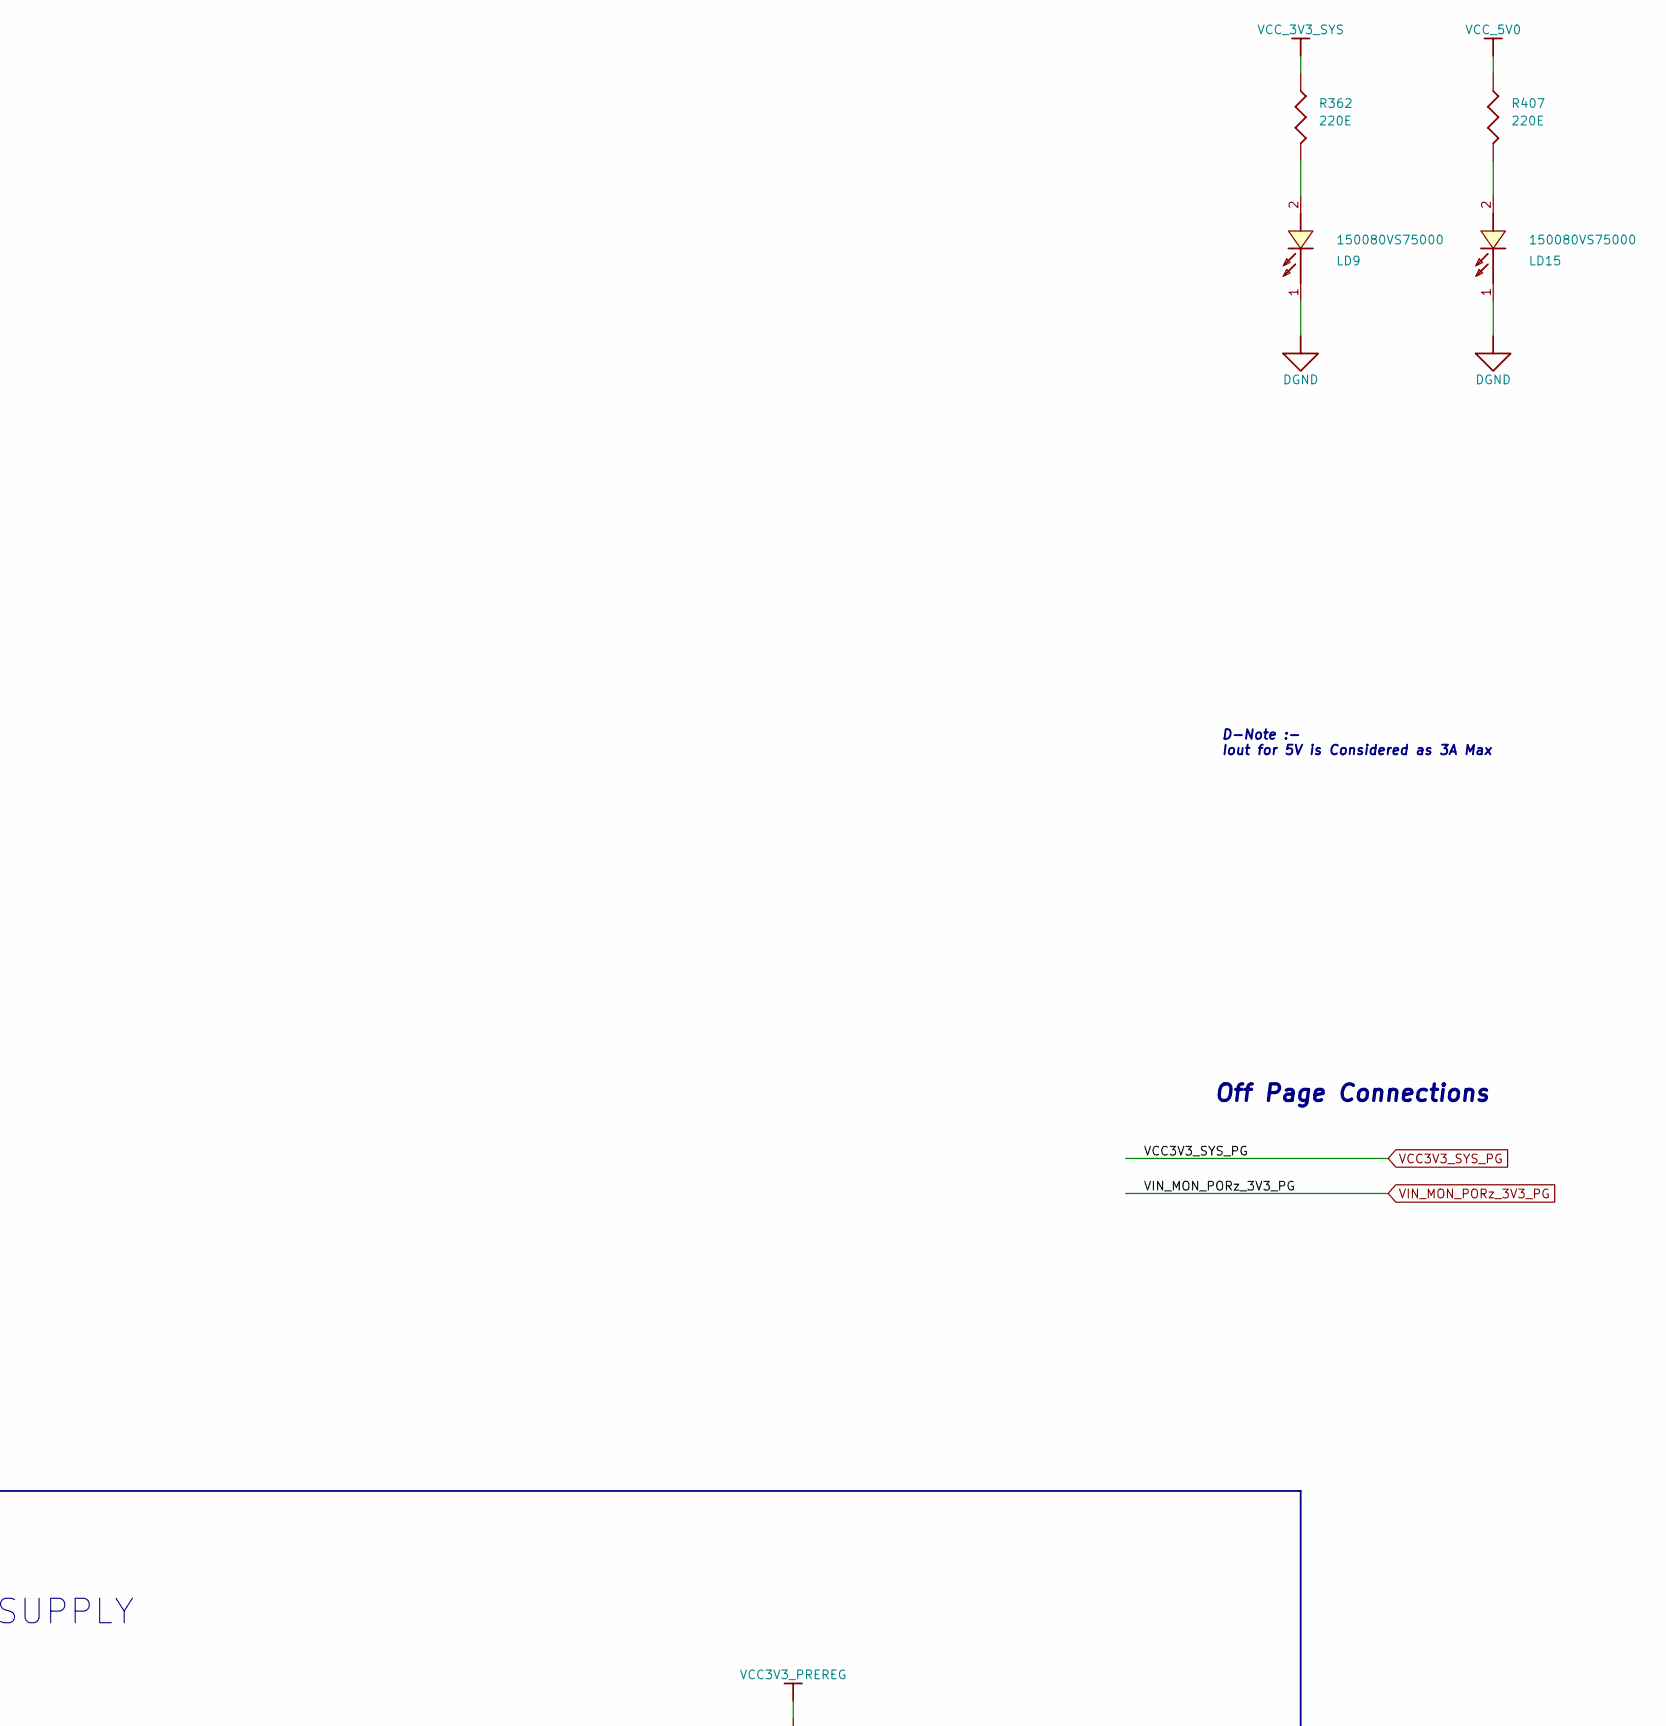
[picture p51: schematic 37.kicad_sch, part in row 1, column 2]

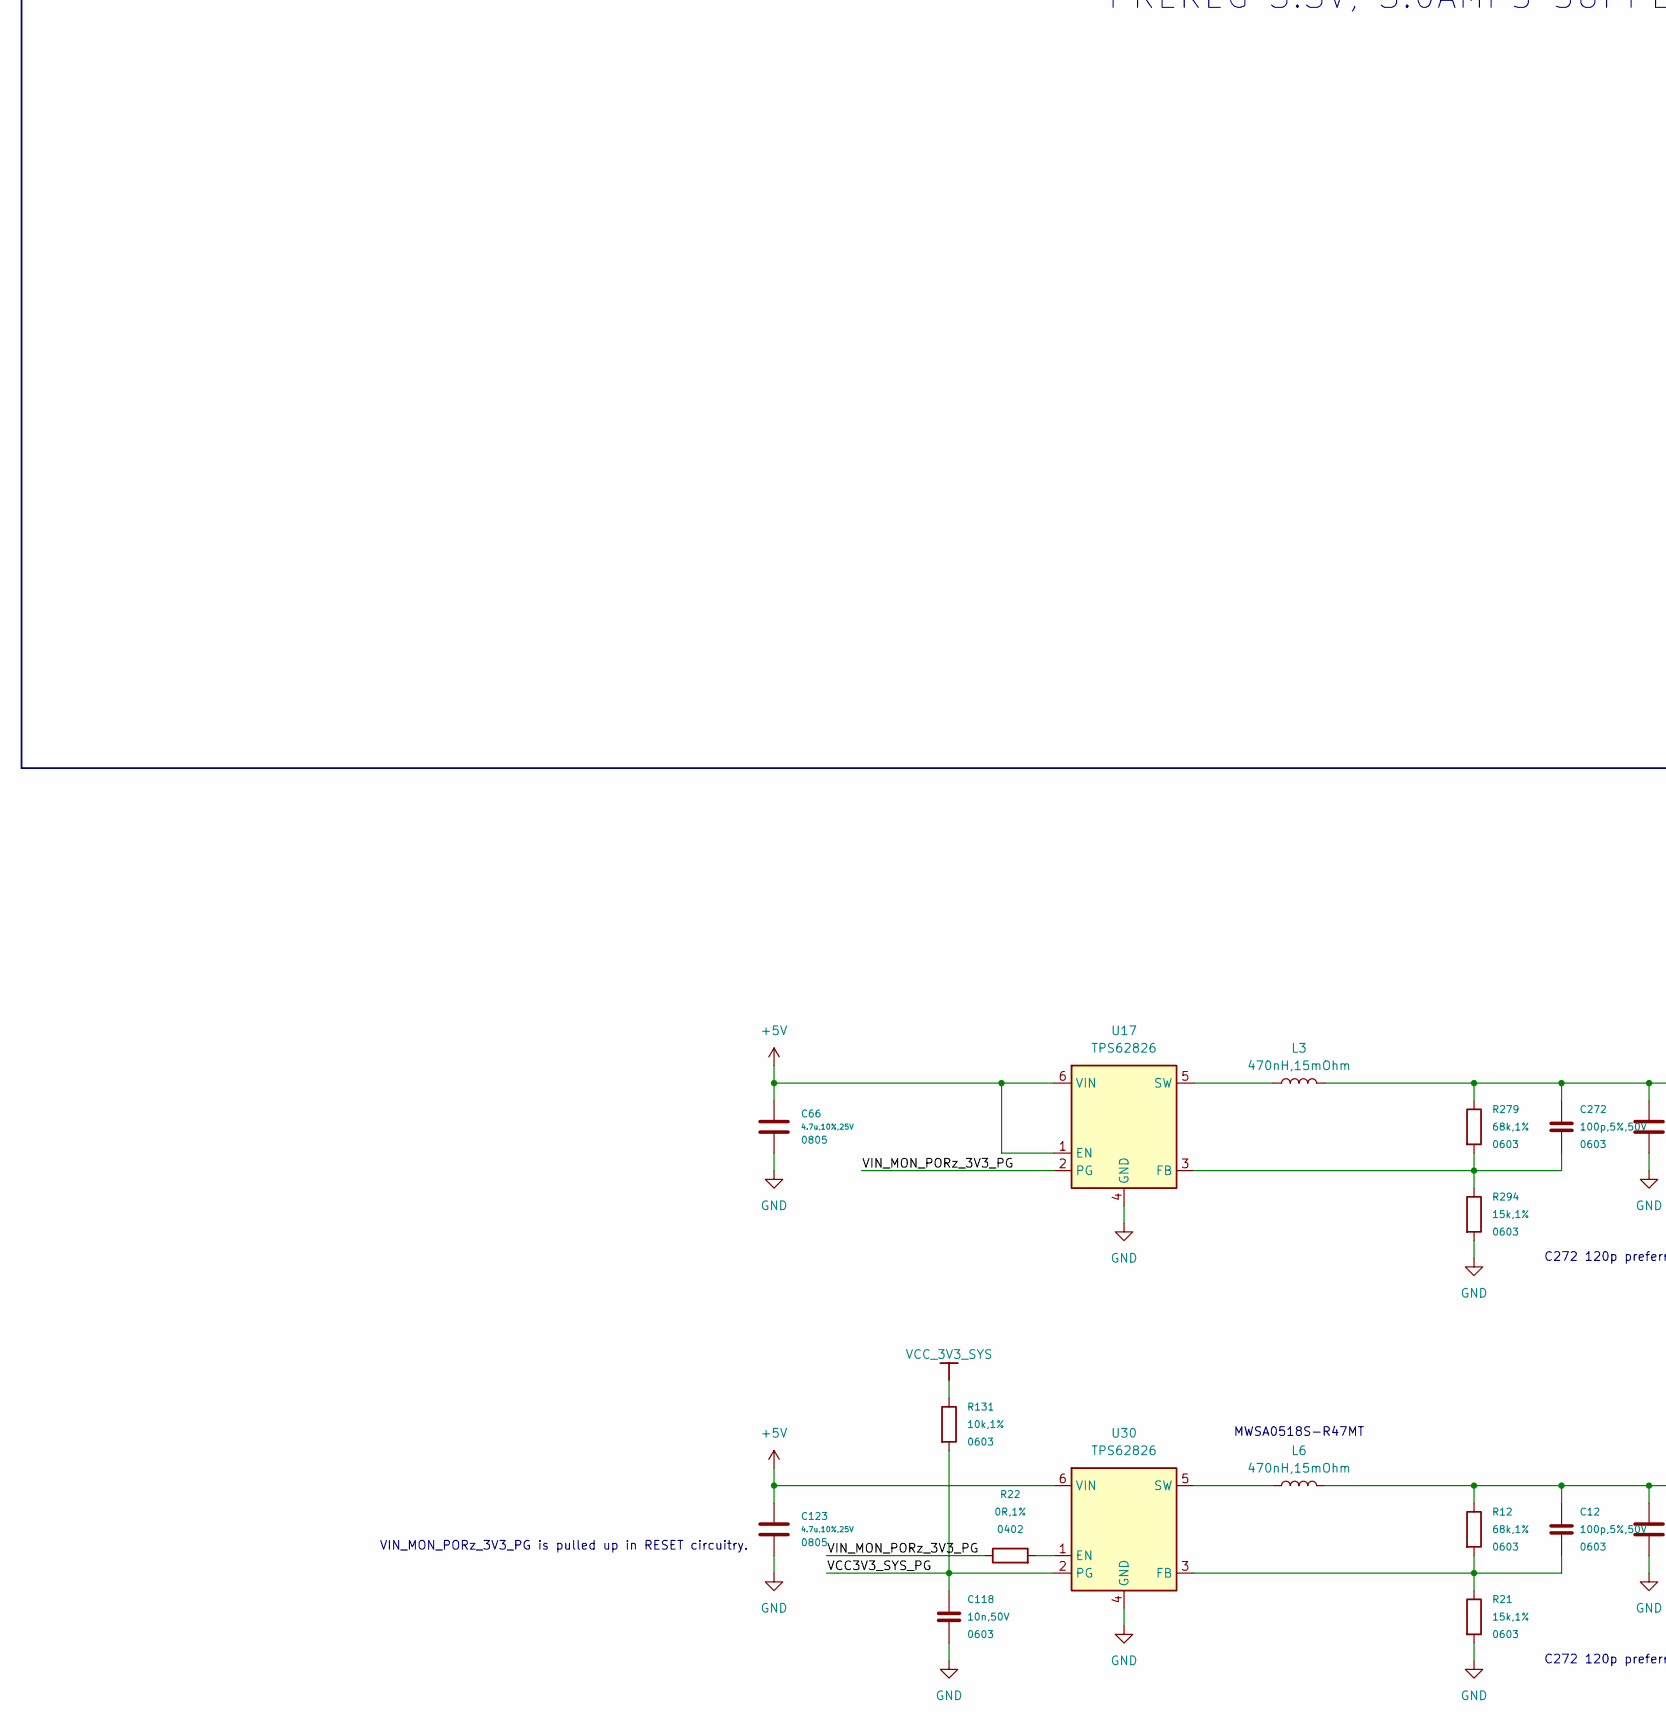
[picture p52: schematic 37.kicad_sch, part in row 2, column 1]

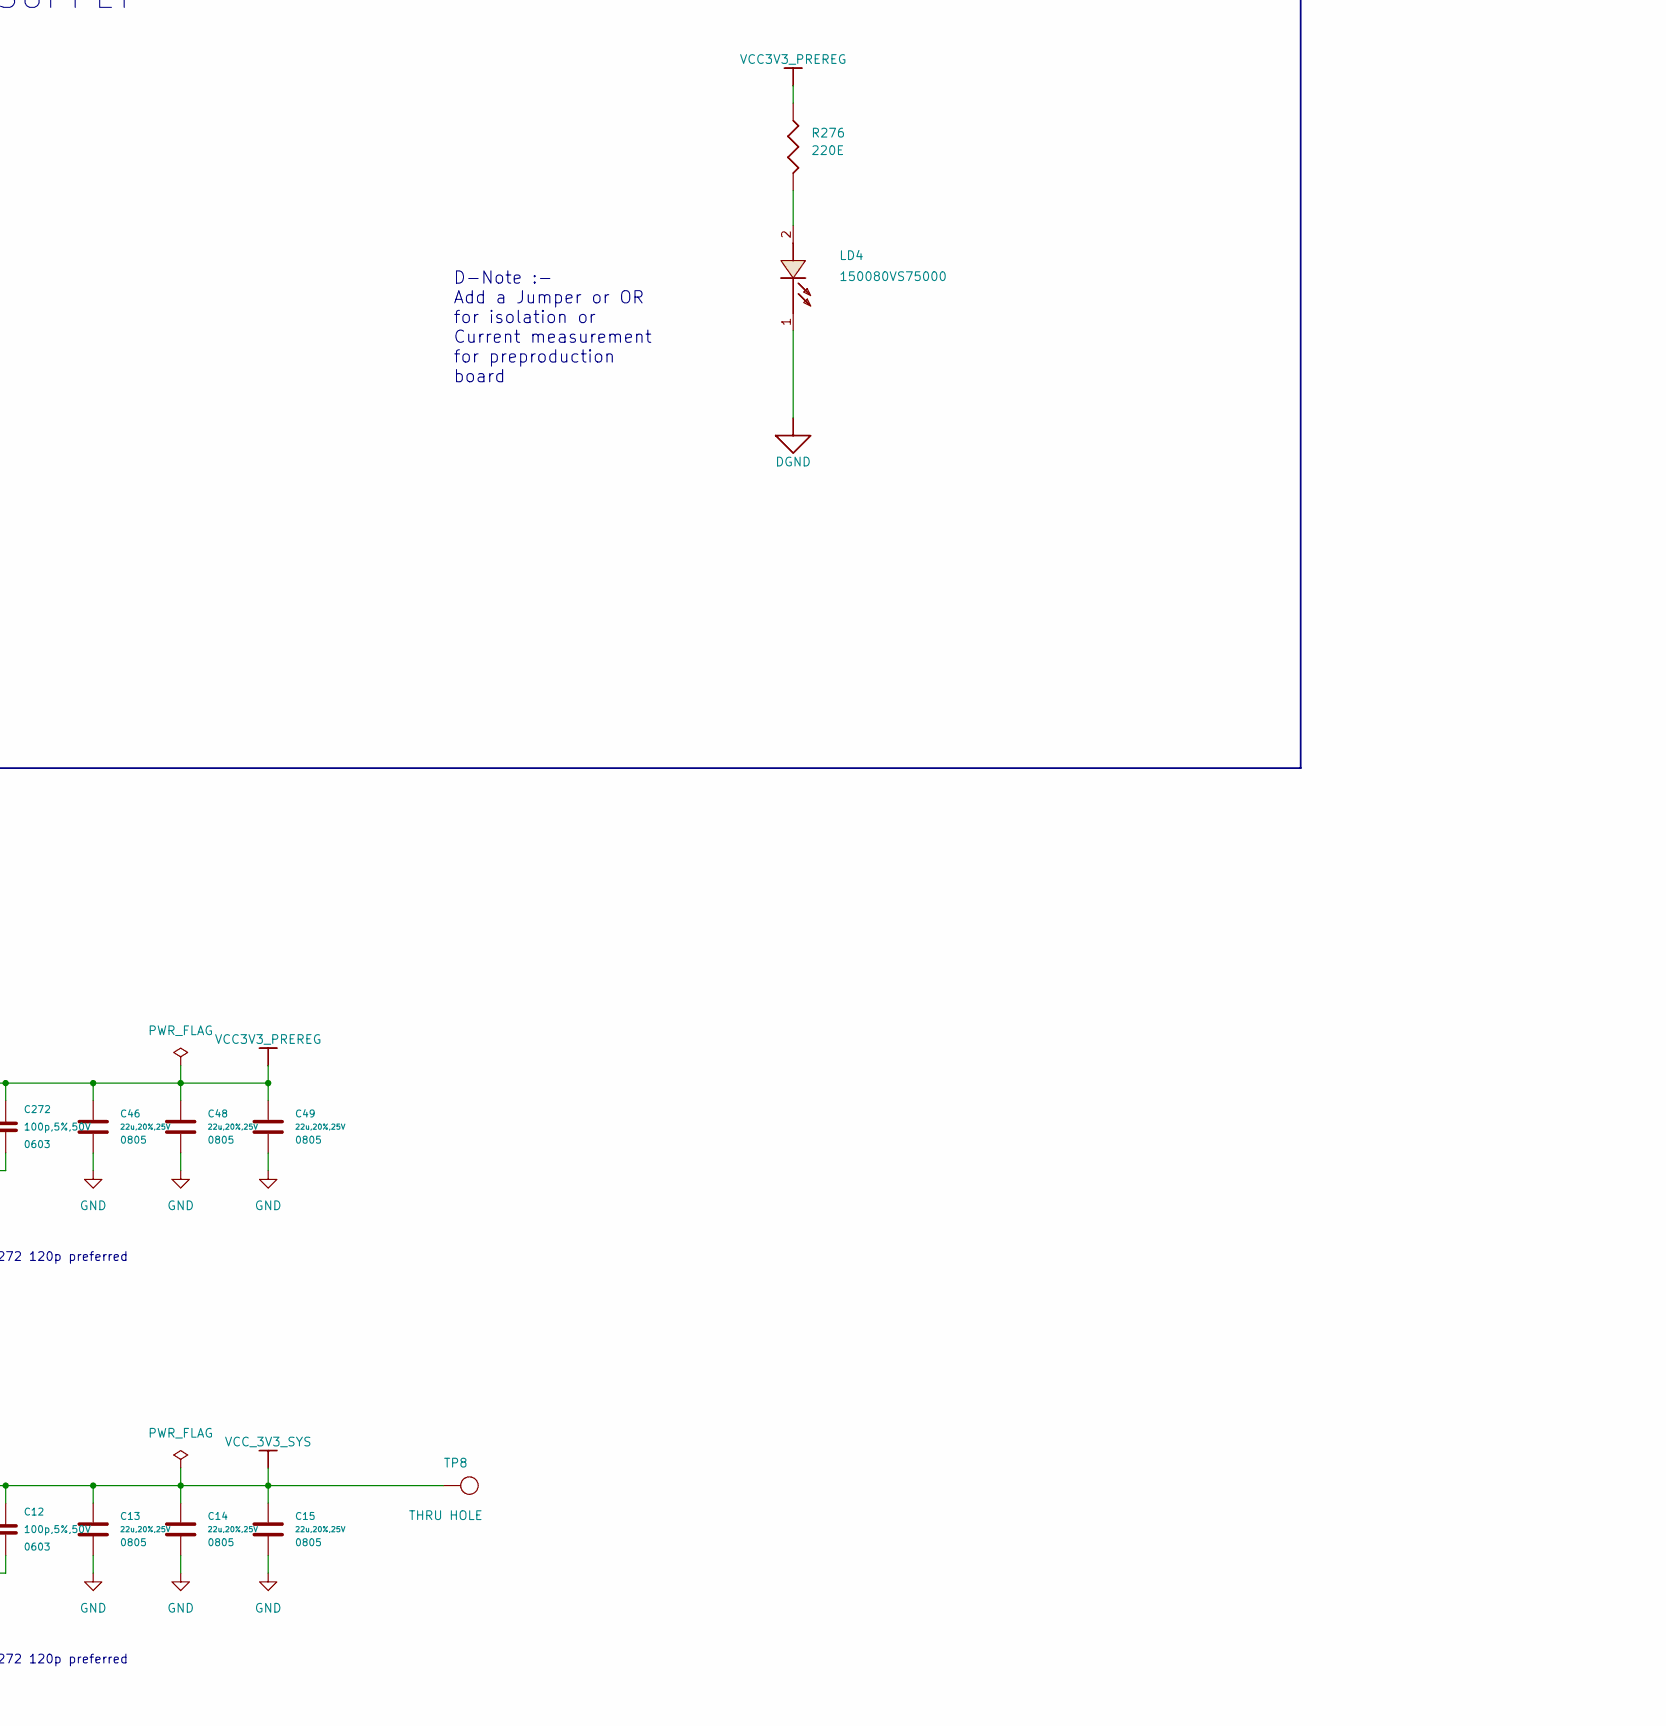
[picture p53: schematic 37.kicad_sch, part in row 2, column 2]

Parts:
C12, C272: 100p,5%,50V; C_0603_1608Metric_1.28x0.64mm_Courtyard; Manufacturer Part CL10C101JB8NNNC
C13, C14, C15, C46, C48, C49: 22u,20%,25V; C_0805_2012Metric; Manufacturer Part CL21A226MAQNNNE
C66, C123: 4.7u,10%,25V; C_0805_2012Metric; Manufacturer Part CL21A475KAQNNNE
C118: 10n,50V; C_0603_1608Metric_1.28x0.64mm_Courtyard; Manufacturer Part 0603B103K500NT
L3, L6: 470nH,15mOhm; L_Sunlord_MWSA0518S
LD4, LD9, LD15: 150080VS75000; LED_150080VS75000_80X50_SMD_0-8; VOLTAGE NA; TOLERANCE NA; PART_TYPE OPT~{O}LED
R12, R279: 68k,1%; R_0603_1608Metric_1.28x0.64mm_Courtyard; Manufacturer Part 0603WAF6802T5E
R21, R294: 15k,1%; R_0603_1608Metric_1.28x0.64mm_Courtyard; Manufacturer Part 0603WAF1502T5E
R22: 0R,1%; R_0402_1005Metric_for_0.25mm_grid; Manufacturer Part 0402WGF0000TCE
R131: 10k,1%; R_0603_1608Metric_1.28x0.64mm_Courtyard; Manufacturer Part 0603WAF1002T5E
R276: 220E; RES0402_0-5; TOLERANCE 5%; VOLTAGE NA; MISTRAL PART NO 110009030506-R
R362, R407: 220E; RES0402_0-5; VOLTAGE NA; TOLERANCE 5%; PART_TYPE RESISTOR~{S}FIXED
TP8: THRU HOLE; TP_40X65; MISTRAL PART NO 130009030938
U17, U30: TPS62826; Texas_VSON-HR-6_1.5x1.5mm_P0.5mm

Connections:
+5V: C66.1, C123.1, U17.1 (EN), U17.6 (VIN), U30.6 (VIN)
DGND: LD4.1 (CATHODE), LD9.1 (CATHODE), LD15.1 (CATHODE)
GND: C13.2, C14.2, C15.2, C46.2, C48.2, C49.2, C66.2, C118.2, C123.2, R21.2, R294.2, U17.4 (GND), U30.4 (GND)
unnamed: C12.2, R12.2, R21.1, U30.3 (FB)
unnamed: C272.2, R279.2, R294.1, U17.3 (FB)
unnamed: L3.1, U17.5 (SW)
unnamed: L6.1, U30.5 (SW)
unnamed: LD4.2 (ANODE), R276.2
unnamed: LD9.2 (ANODE), R362.2
unnamed: LD15.2 (ANODE), R407.2
unnamed: R22.2, U30.1 (EN)
VCC3V3_PREREG: C46.1, C48.1, C49.1, C272.1, L3.2, R276.1, R279.1
VCC3V3_SYS_PG: C118.1, R131.2, U30.2 (PG)
VCC_3V3_SYS: C12.1, C13.1, C14.1, C15.1, L6.2, R12.1, R131.1, R362.1, TP8.1
VCC_5V0: R407.1
VIN_MON_PORz_3V3_PG: R22.1, U17.2 (PG)

Notes on the sheet:
D-Note :- Add a Jumper or OR for isolation or Current measurement for preproduction board
D-Note :- Iout for 5V is Considered as 3A Max
MWSA0518S-R47MT
C272 120p preferred
VIN_MON_PORz_3V3_PG is pulled up in RESET circuitry.
PREREG 3.3V, 3.0AMPS SUPPLY
Off Page Connections
