gingerologist/am64x/38.kicad_sch

## KiCad design 38.kicad_sch (2024-08-05)

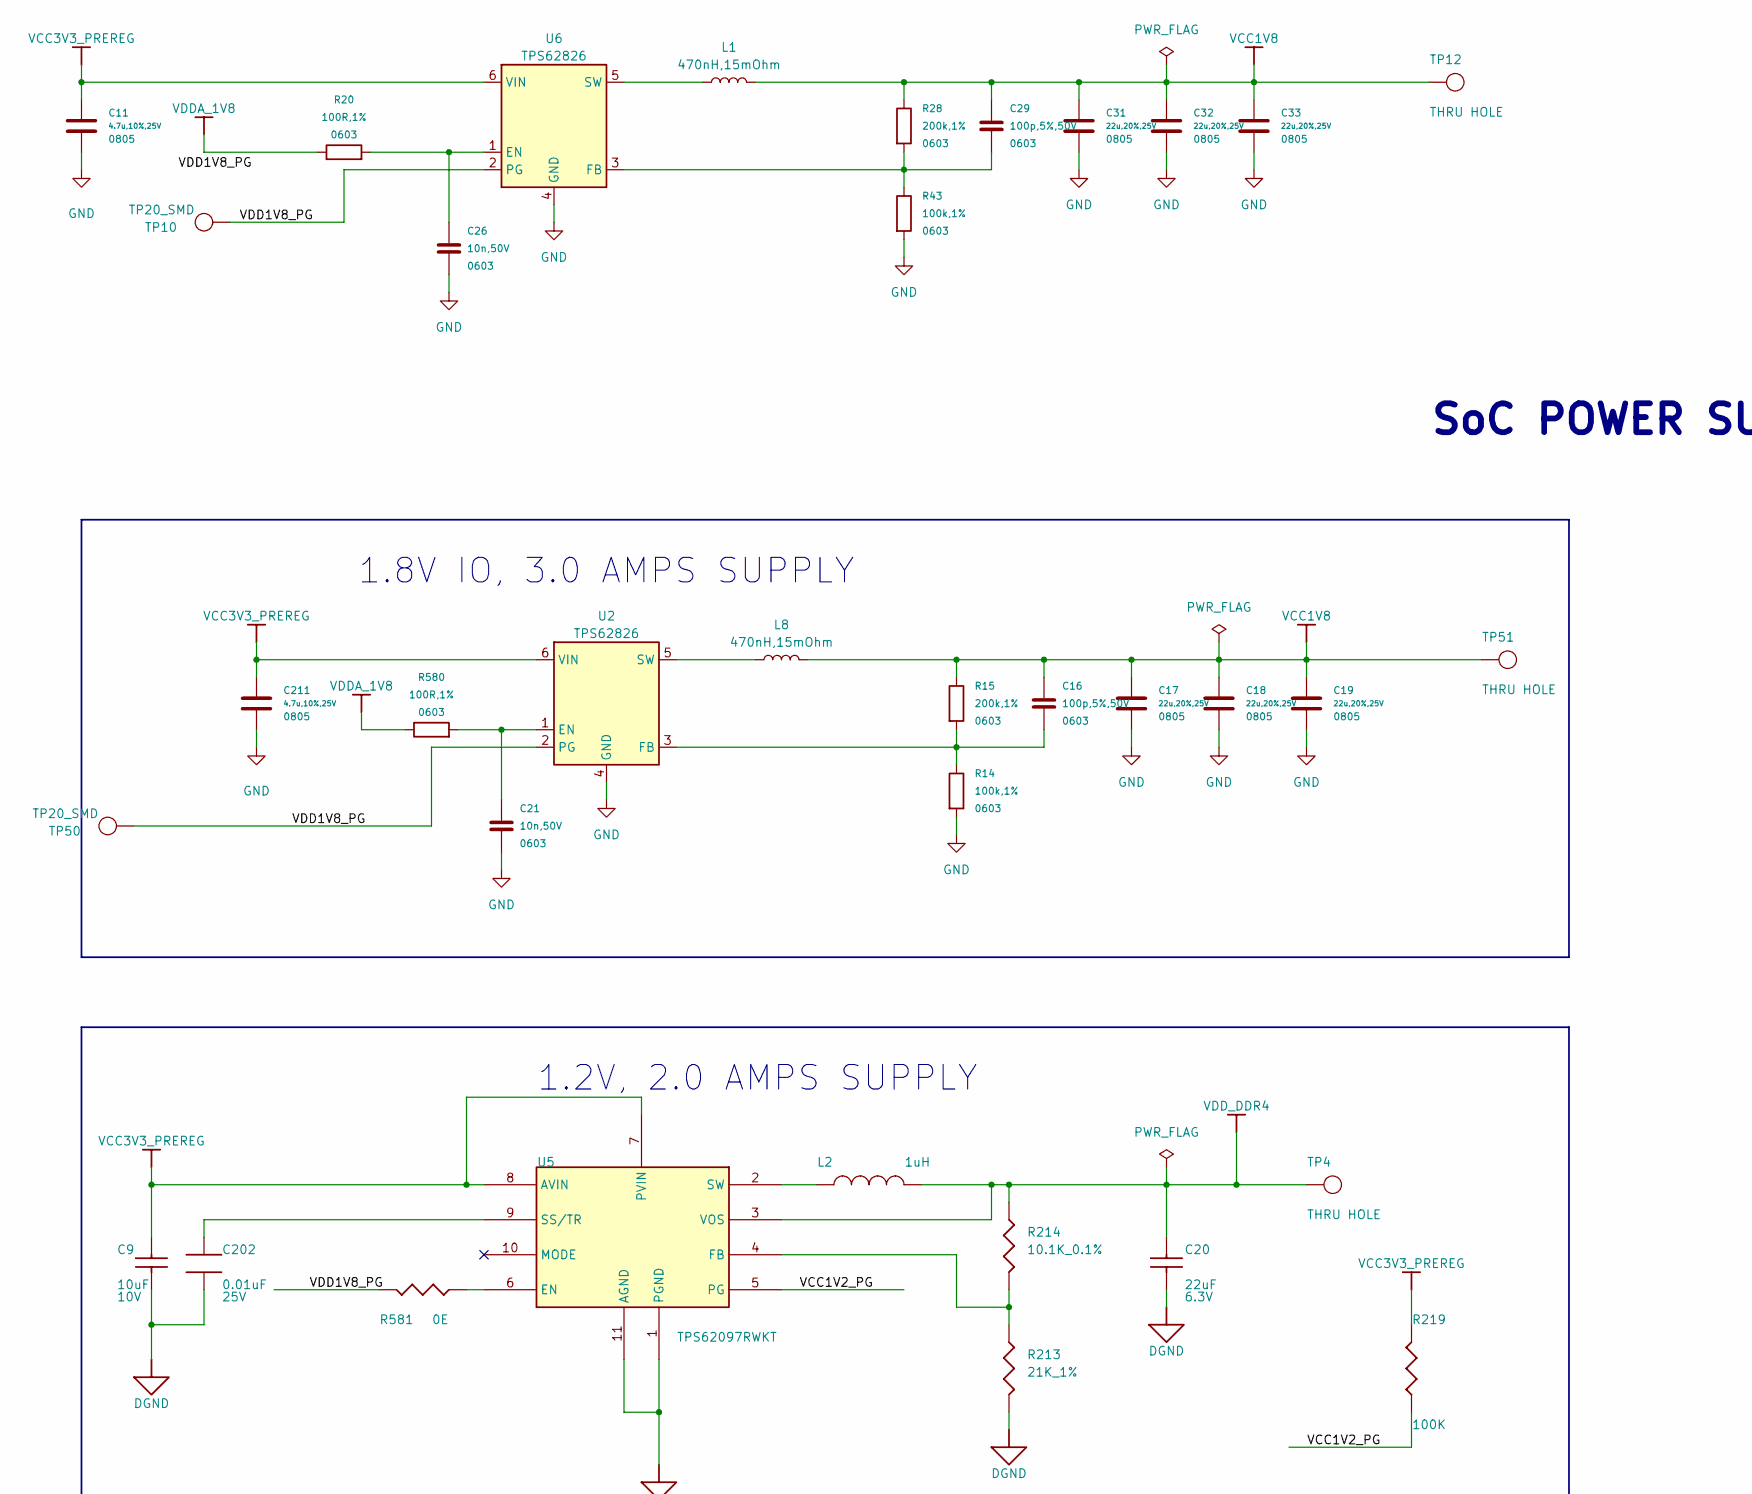
[picture p54: schematic 38.kicad_sch, part in row 1, column 1]

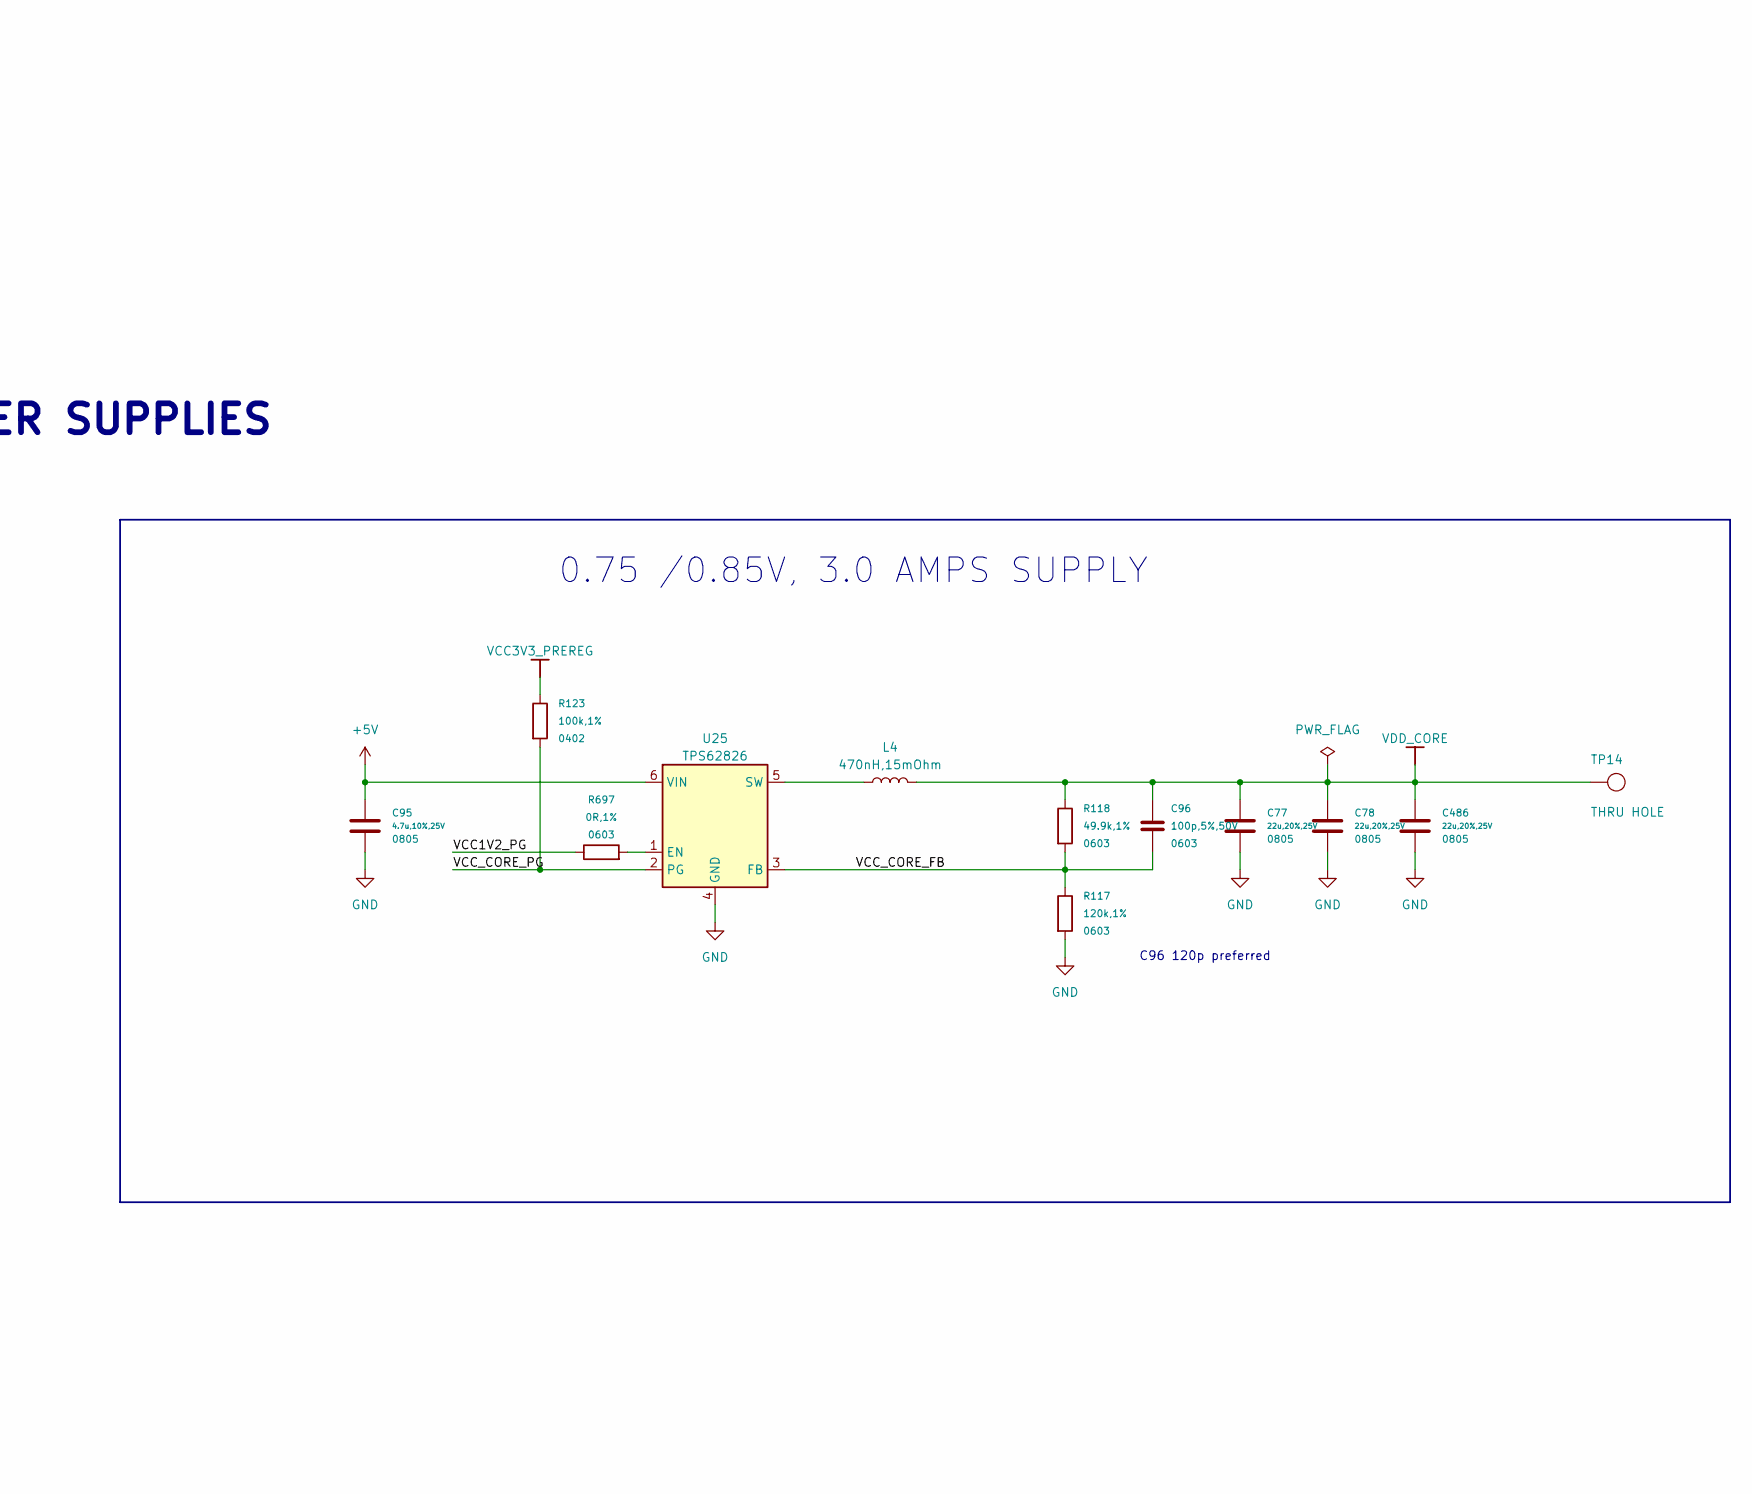
[picture p55: schematic 38.kicad_sch, part in row 1, column 2]

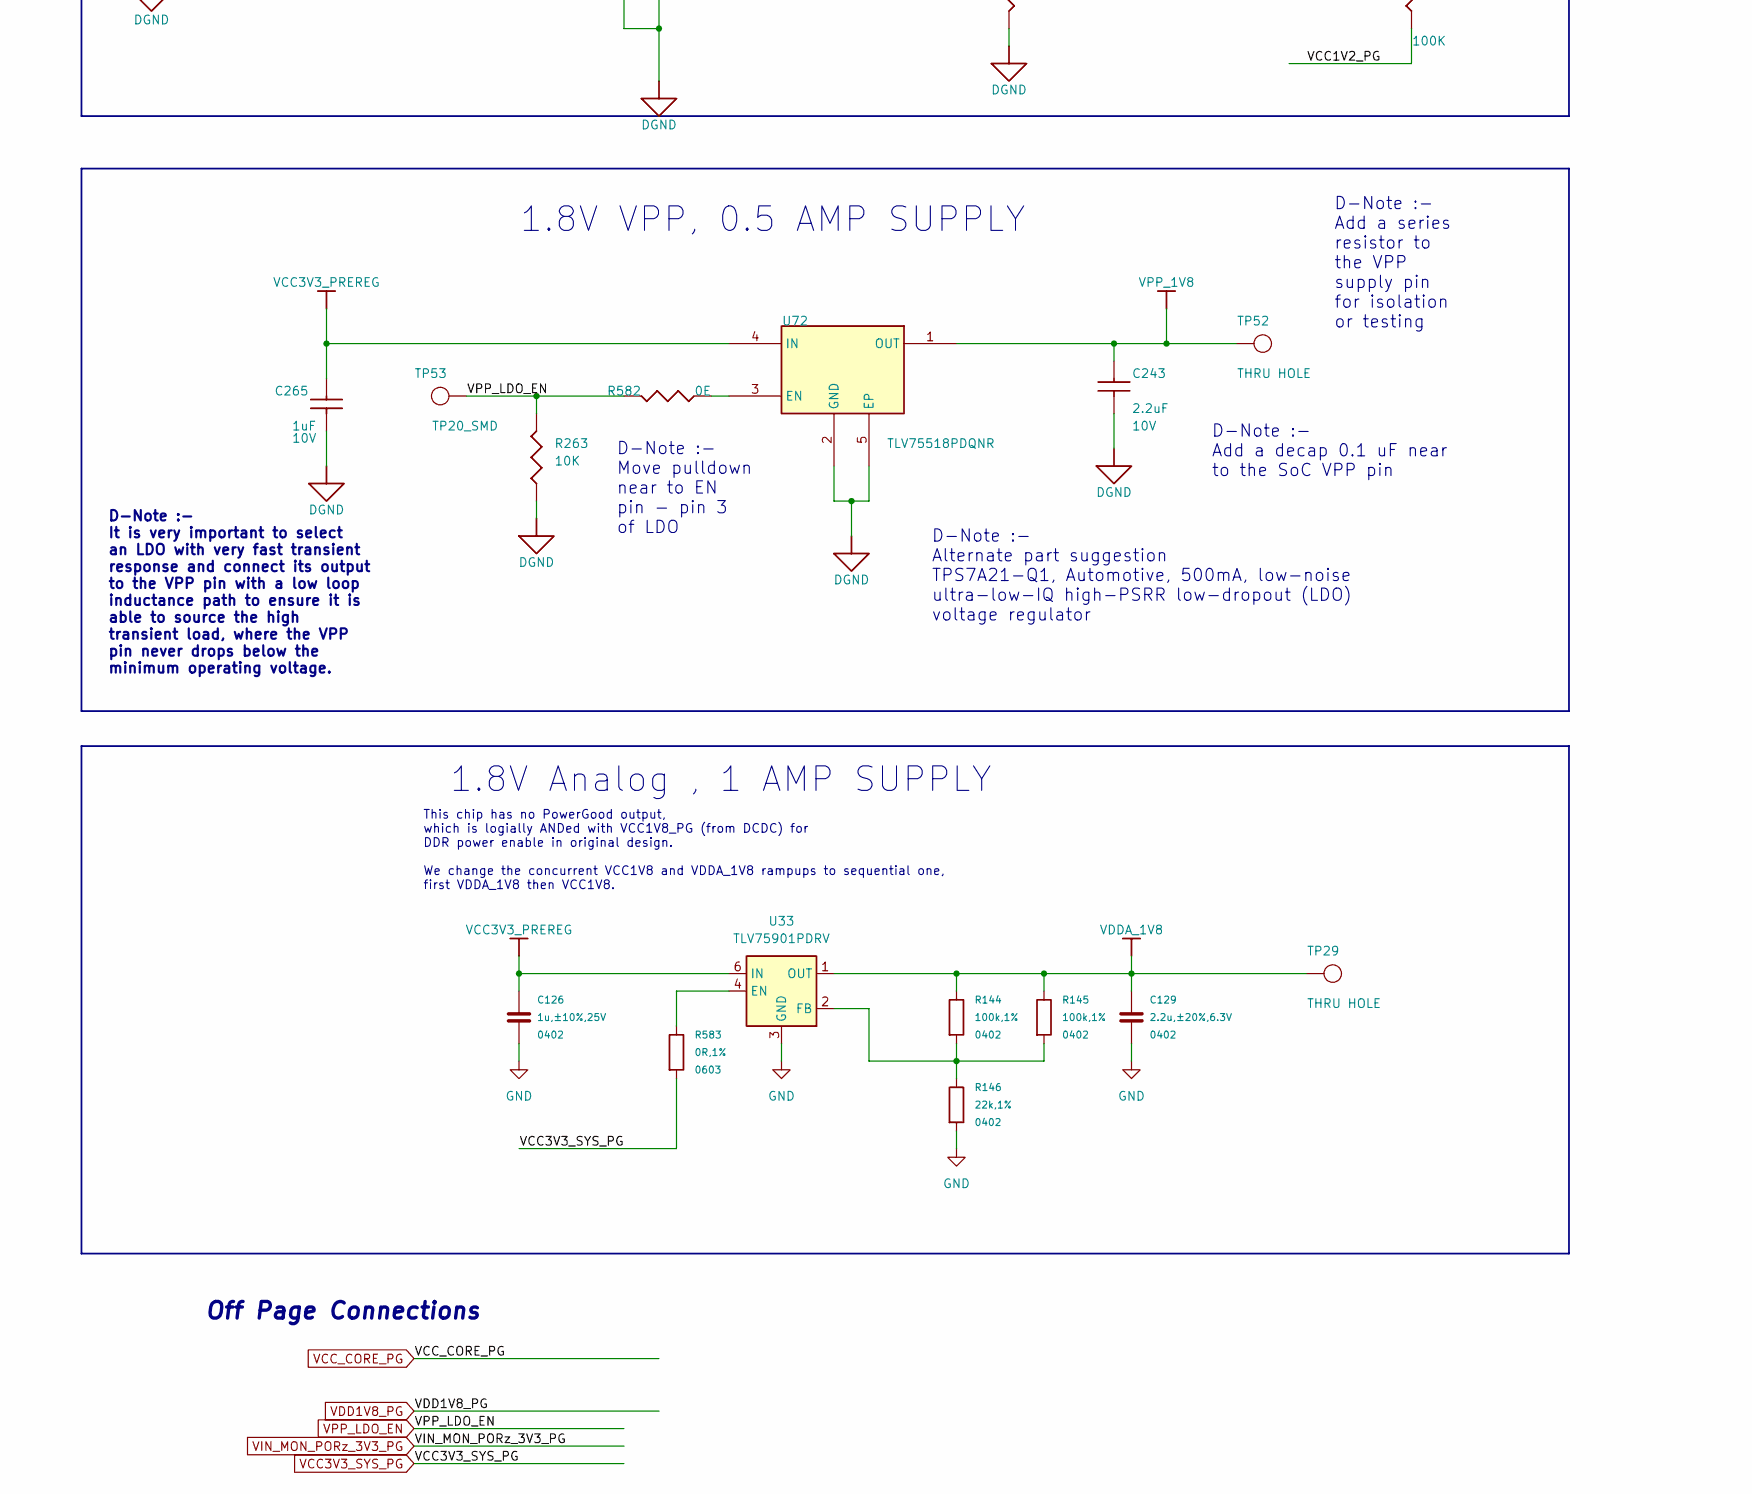
[picture p56: schematic 38.kicad_sch, part in row 2, column 1]

Parts:
C9: 10uF; CAP0402_0-75; VOLTAGE 10V; TOLERANCE 20%; PART_TYPE CAPACITOR~{S}CERAMIC
C11, C95, C211: 4.7u,10%,25V; C_0805_2012Metric; Manufacturer Part CL21A475KAQNNNE
C16, C29, C96: 100p,5%,50V; C_0603_1608Metric_1.28x0.64mm_Courtyard; Manufacturer Part CL10C101JB8NNNC
C17, C18, C19, C31, C32, C33, C77, C78, C486: 22u,20%,25V; C_0805_2012Metric; Manufacturer Part CL21A226MAQNNNE
C20: 22uF; CAP0603_1; TOLERANCE 20%; VOLTAGE 6.3V; MISTRAL PART NO 120015090007-R
C21, C26: 10n,50V; C_0603_1608Metric_1.28x0.64mm_Courtyard; Manufacturer Part 0603B103K500NT
C126: 1u,±10%,25V; C_0402_1005Metric_for_0.25mm_grid; Manufacturer Part CL05A105KA5NQNC
C129: 2.2u,±20%,6.3V; C_0402_1005Metric_for_0.25mm_grid; Manufacturer Part CL05A225MQ5NSNC
C202: 0.01uF; CAP0402N; VOLTAGE 25V; TOLERANCE 10%; PART_TYPE CAPACITOR~{S}CERAMIC
C243: 2.2uF; CAP0402_0-75; TOLERANCE 20%; VOLTAGE 10V; MISTRAL PART NO 120019040036-R
C265: 1uF; CAP0402_0-75; VOLTAGE 10V; TOLERANCE 20%; PART_TYPE CAPACITOR~{S}CERAMIC
L1, L4, L8: 470nH,15mOhm; L_Sunlord_MWSA0518S
L2: 1uH; IND_744316100_230X220_SMD_4-3; TOLERANCE 20%; VOLTAGE NA; MISTRAL PART NO 130020050041-R
R14, R43: 100k,1%; R_0603_1608Metric_1.28x0.64mm_Courtyard
R15, R28: 200k,1%; R_0603_1608Metric_1.28x0.64mm_Courtyard; Manufacturer Part 0603WAF2003T5E
R20, R580: 100R,1%; R_0603_1608Metric_1.28x0.64mm_Courtyard; Manufacturer Part 0603WAF1000T5E
R117: 120k,1%; R_0603_1608Metric_1.28x0.64mm_Courtyard; Manufacturer Part 0603WAF1203T5E
R118: 49.9k,1%; R_0603_1608Metric_1.28x0.64mm_Courtyard; Manufacturer Part 0603WAF4992T5E
R123, R144, R145: 100k,1%; R_0402_1005Metric_for_0.25mm_grid; Manufacturer Part 0402WGF1003TCE
R146: 22k,1%; R_0402_1005Metric_for_0.25mm_grid; Manufacturer Part 0402WGF2202TCE
R213: 21K_1%; RES0402_0-5; VOLTAGE NA; TOLERANCE 1%; PART_TYPE RESISTOR~{S}FIXED
R214: 10.1K_0.1%; RES0603_0-75; VOLTAGE NA; TOLERANCE 0.1%; PART_TYPE RESISTOR~{S}FIXED
R219: 100K; RES0402_0-5; VOLTAGE NA; TOLERANCE 5%; PART_TYPE RESISTOR~{S}FIXED
R263: 10K; RES0402_0-5; TOLERANCE 5%; VOLTAGE NA; MISTRAL PART NO 110011060021-R
R581, R582: 0E; RES0402_0-5; VOLTAGE NA; TOLERANCE NA; PART_TYPE RESISTOR~{S}FIXED
R583, R697: 0R,1%; R_0603_1608Metric_1.28x0.64mm_Courtyard; Manufacturer Part 0603WAF0000T5E
TP4, TP14, TP52: THRU HOLE; TP_40X65; PART_TYPE TESTPOINT
TP10, TP50, TP53: TP20_SMD; VOLTAGE NA; TOLERANCE NA; PART_TYPE TESTPOINT
TP12, TP29, TP51: THRU HOLE; TP_40X65; MISTRAL PART NO 130009030938
U2, U6, U25: TPS62826; Texas_VSON-HR-6_1.5x1.5mm_P0.5mm
U5: TPS62097RWKT; VQFNHR11_TPS62097_80X80_1; VOLTAGE NA; TOLERANCE NA; PART_TYPE IC~{S}POWE~{R}CONVERTER
U33: TLV75901PDRV; WSON-6-1EP_2x2mm_P0.65mm_EP1x1.6mm
U72: TLV75518PDQNR; X2SON4_TLV71318P_40X40_0-4; VOLTAGE NA; TOLERANCE NA; PART_TYPE IC~{S}POWE~{R}VOLTAGE REGULATOR

Connections:
+5V: C95.1, U25.6 (VIN)
DGND: C9.2, C20.2, C202.2, C243.2, C265.2, R213.2, R263.1, U5.1 (PGND), U5.11 (AGND), U72.2 (GND), U72.5 (EP)
GND: C11.2, C17.2, C18.2, C19.2, C21.2, C26.2, C31.2, C32.2, C33.2, C77.2, C78.2, C95.2, C126.2, C129.2, C211.2, C486.2, R14.2, R43.2, R117.2, R146.2, U2.4 (GND), U6.4 (GND), U25.4 (GND), U33.3 (GND), U33.7 (GND)
unnamed: C16.2, R14.1, R15.2, U2.3 (FB)
unnamed: C21.1, R580.2, U2.1 (EN)
unnamed: C26.1, R20.2, U6.1 (EN)
unnamed: C29.2, R28.2, R43.1, U6.3 (FB)
unnamed: C202.1, U5.9 (SS/TR)
unnamed: L1.1, U6.5 (SW)
unnamed: L2.1, U5.2 (SW)
unnamed: L4.1, U25.5 (SW)
unnamed: L8.1, U2.5 (SW)
unnamed: R144.2, R145.2, R146.1, U33.2 (FB)
unnamed: R213.1, R214.2, U5.4 (FB)
unnamed: R581.1, U5.6 (EN)
unnamed: R582.1, U72.3 (EN)
unnamed: R583.1, U33.4 (EN)
unnamed: R697.2, U25.1 (EN)
VCC1V2_PG: R219.1, R697.1, U5.5 (PG)
VCC1V8: C16.1, C17.1, C18.1, C19.1, C29.1, C31.1, C32.1, C33.1, L1.2, L8.2, R15.1, R28.1, TP12.1, TP51.1
VCC3V3_PREREG: C9.1, C11.1, C126.1, C211.1, C265.1, R123.1, R219.2, U2.6 (VIN), U5.7 (PVIN), U5.8 (AVIN), U6.6 (VIN), U33.6 (IN), U72.4 (IN)
VCC3V3_SYS_PG: R583.2
VCC_CORE_FB: C96.2, R117.1, R118.2, U25.3 (FB)
VCC_CORE_PG: R123.2, U25.2 (PG)
VDD1V8_PG: R581.2, TP10.1, TP50.1, U2.2 (PG), U6.2 (PG)
VDDA_1V8: C129.1, R20.1, R144.1, R145.1, R580.1, TP29.1, U33.1 (OUT)
VDD_CORE: C77.1, C78.1, C96.1, C486.1, L4.2, R118.1, TP14.1
VDD_DDR4: C20.1, L2.2, R214.1, TP4.1, U5.3 (VOS)
VPP_1V8: C243.1, TP52.1, U72.1 (OUT)
VPP_LDO_EN: R263.2, R582.2, TP53.1

Notes on the sheet:
D-Note :- An alternative way to source the VPP is to use an external supply. The required caps and termination/Discharge resistor are recommended to be placed near to the SoC VPP pin. SOC GPIO output can be used to control or time the external power supply output
D-Note :- Move pulldown near to EN pin - pin 3 of LDO
D-Note :- Alternate part suggestion TPS7A21-Q1, Automotive, 500mA, low-noise ultra-low-IQ high-PSRR low-dropout (LDO) voltage regulator
D-Note :- Add a decap 0.1 uF near to the SoC VPP pin
D-Note :- Add a series resistor to the VPP supply pin for isolation or testing
D-Note :- It is very important to select an LDO with very fast transient response and connect its output to the VPP pin with a low loop inductance path to ensure it is able to source the high transient load, where the VPP pin never drops below the minimum operating voltage.
D-Note :- Given the transient current requirement during eFuse programming, using load switch or FET switch may not be a recommended approach, It is recommended to use an LDO. A load or FET switch is likely to have too much voltage drop that can't be compensated like when using an LDO.
This chip has no PowerGood output, which is logially ANDed with VCC1V8_PG (from DCDC) for DDR power enable in original design. We change the concurrent VCC1V8 and VDDA_1V8 rampups to sequential one, first VDDA_1V8 then VCC1V8.
1.8V Analog , 1 AMP SUPPLY
SoC POWER SUPPLIES
1.8V VPP, 0.5 AMP SUPPLY
C96 120p preferred
1.2V, 2.0 AMPS SUPPLY
Off Page Connections
1.8V IO, 3.0 AMPS SUPPLY
0.75 /0.85V, 3.0 AMPS SUPPLY
