gingerologist/am64x/39.kicad_sch

## KiCad design 39.kicad_sch (2024-08-05)

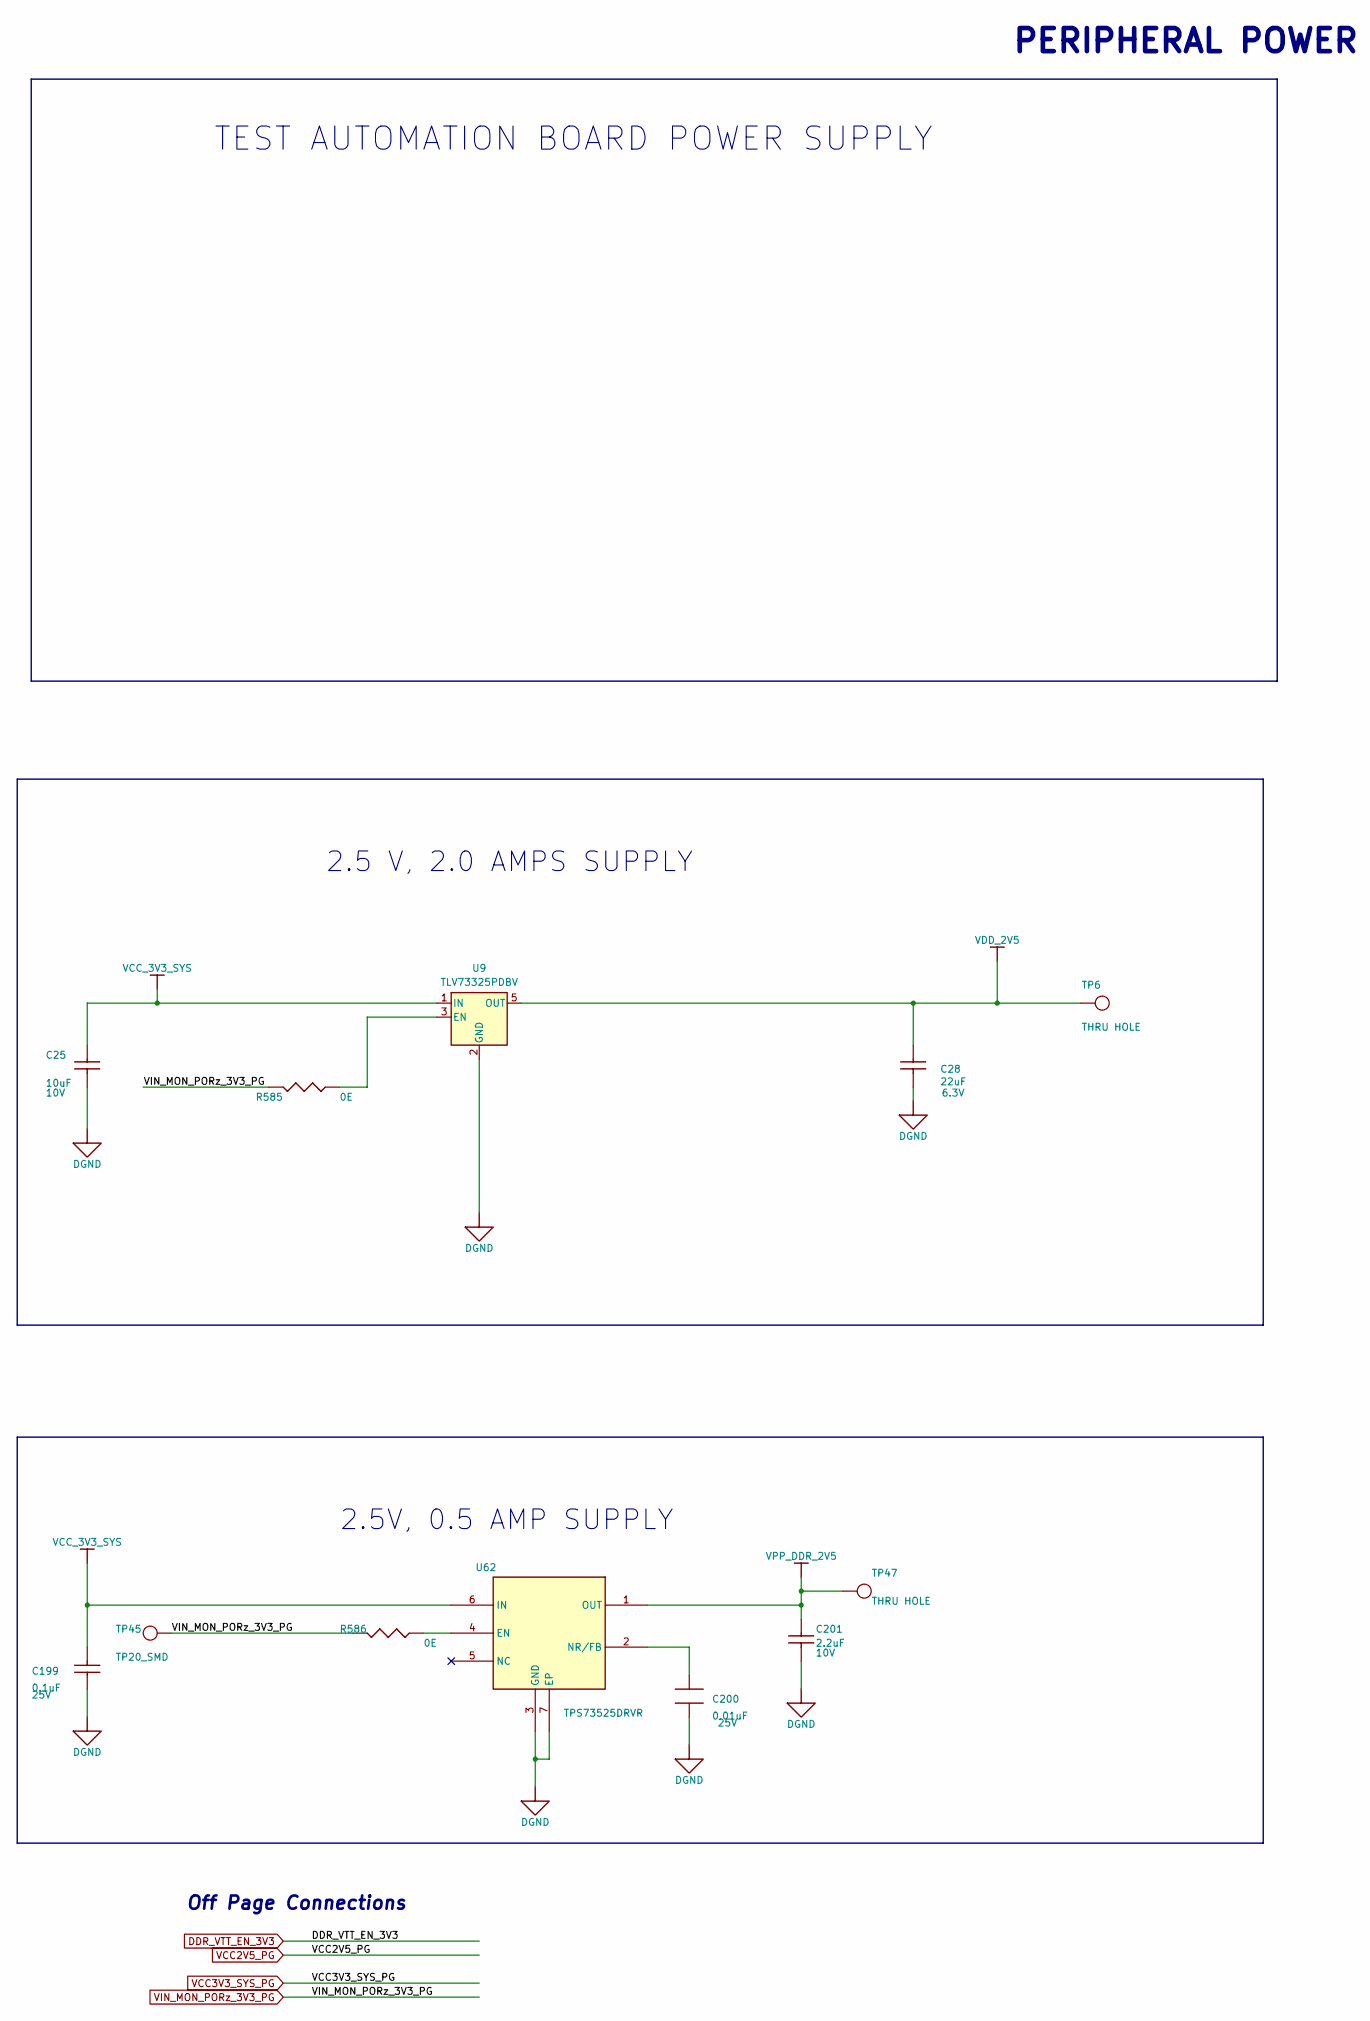
[picture p57: schematic 39.kicad_sch, part in row 1, column 1]

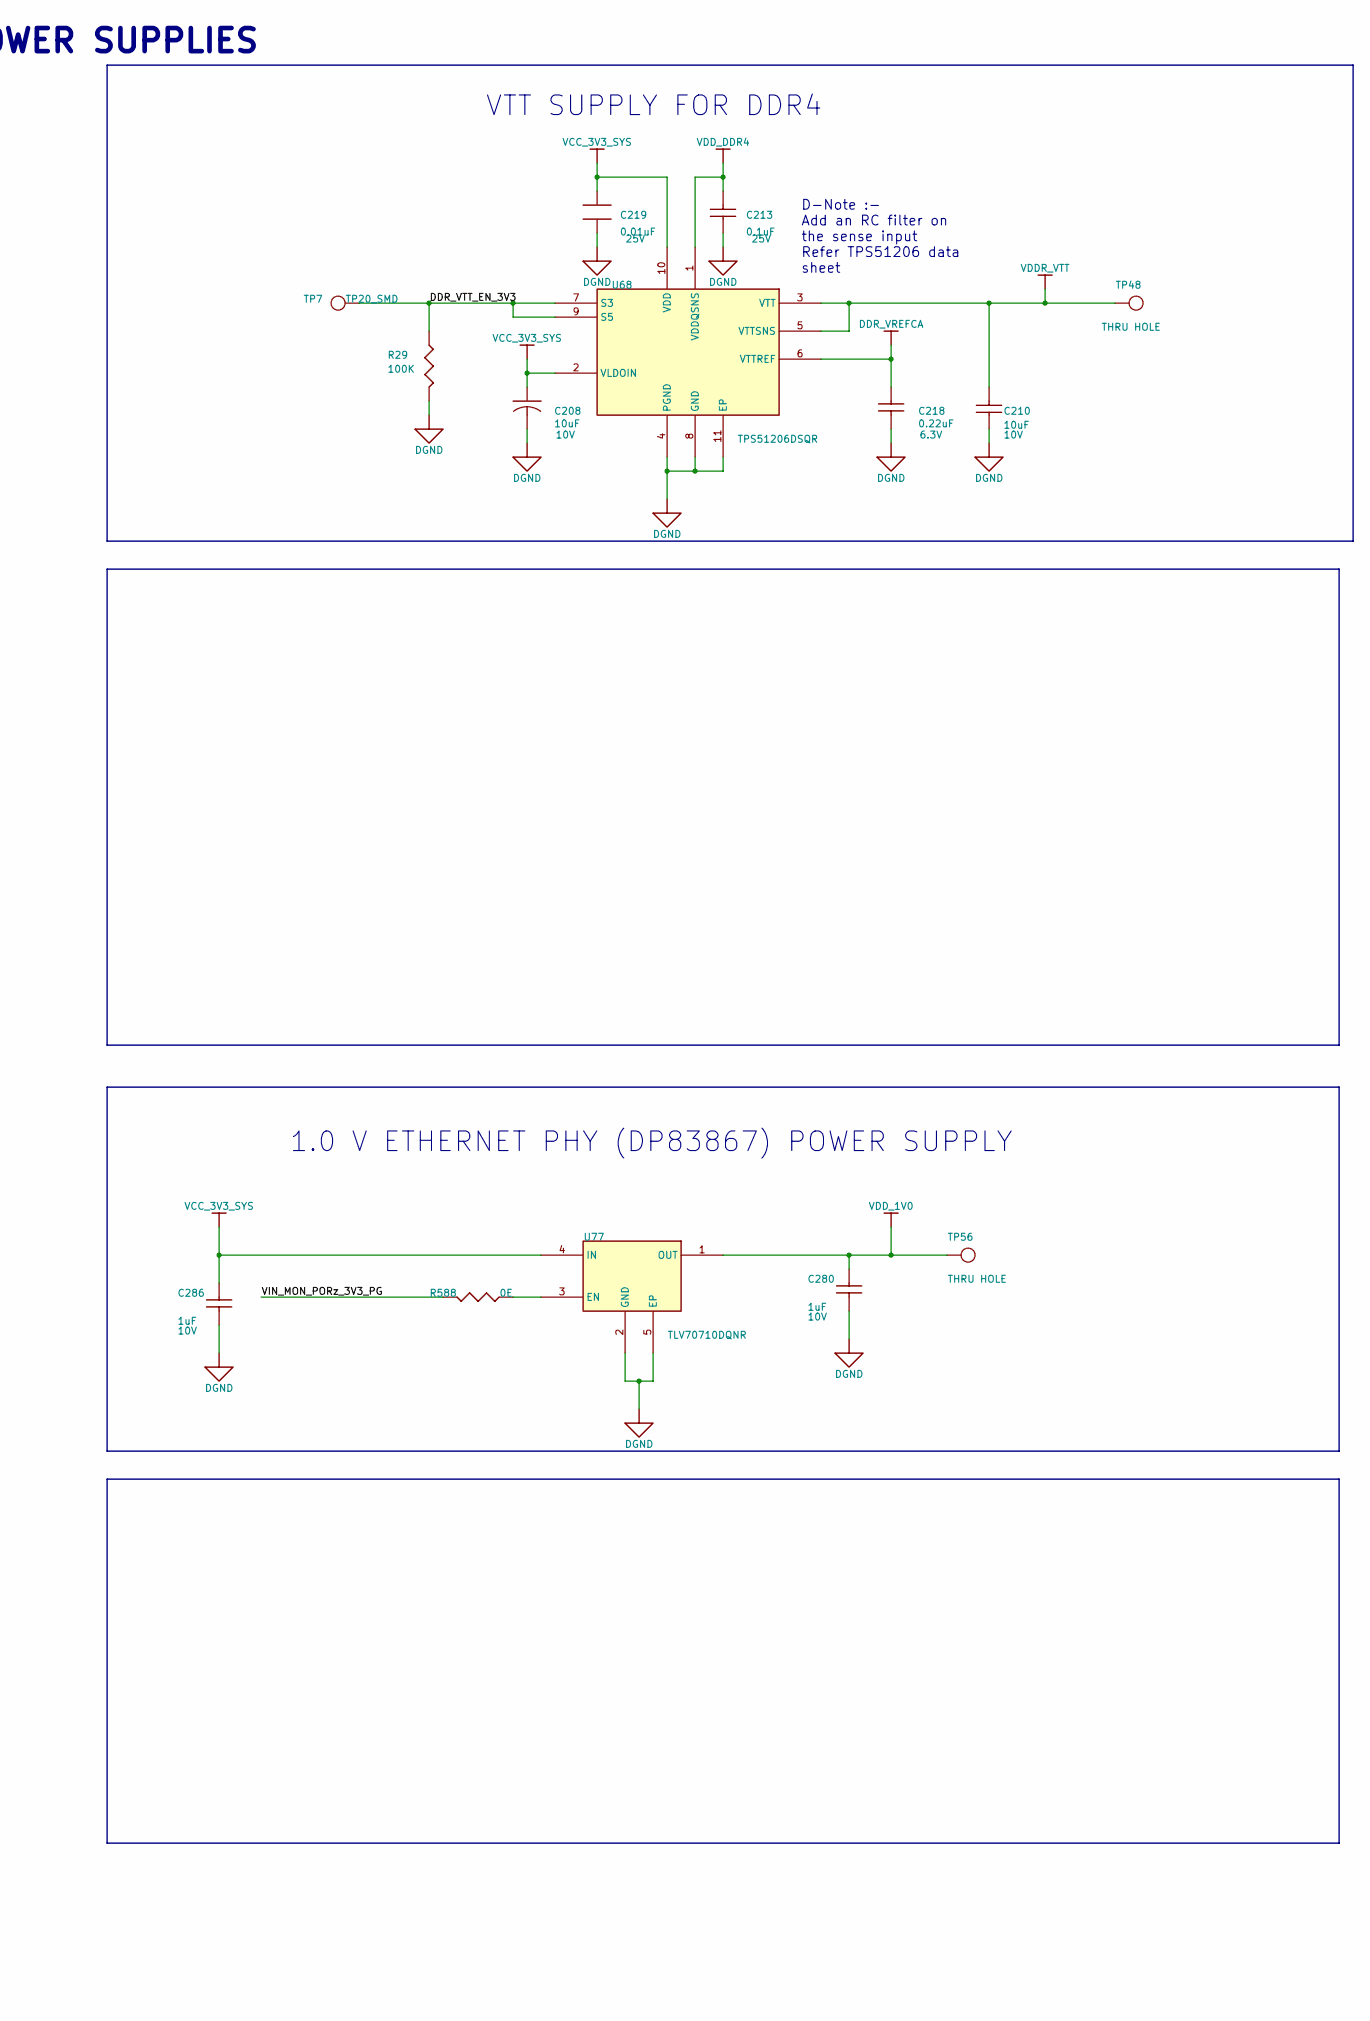
[picture p58: schematic 39.kicad_sch, part in row 1, column 2]

Parts:
C25: 10uF; CAP0402_0-75; TOLERANCE 20%; VOLTAGE 10V; MISTRAL PART NO 120013110019-R
C28: 22uF; CAP0603_1; VOLTAGE 6.3V; TOLERANCE 20%; PART_TYPE CAPACITOR~{S}CERAMIC
C199, C213: 0.1uF; CAP0402_0-75; TOLERANCE 20%; VOLTAGE 25V; MISTRAL PART NO 120020080003-R
C200: 0.01uF; CAP0402N; TOLERANCE 10%; VOLTAGE 25V; MISTRAL PART NO 120011090040-R
C201: 2.2uF; CAP0402_0-75; TOLERANCE 20%; VOLTAGE 10V; MISTRAL PART NO 120019040036-R
C208, C210: 10uF; CAP0402_0-75; VOLTAGE 10V; TOLERANCE 20%; PART_TYPE CAPACITOR~{S}CERAMIC
C218: 0.22uF; CAP0201_0-5; VOLTAGE 6.3V; TOLERANCE 10%; PART_TYPE CAPACITOR~{S}CERAMIC
C219: 0.01uF; CAP0402N; VOLTAGE 25V; TOLERANCE 10%; PART_TYPE CAPACITOR~{S}CERAMIC
C280, C286: 1uF; CAP0402_0-75; VOLTAGE 10V; TOLERANCE 20%; PART_TYPE CAPACITOR~{S}CERAMIC
R29: 100K; RES0402_0-5; TOLERANCE 5%; VOLTAGE NA; MISTRAL PART NO 110011060002-R
R585: 0E; RES0402_0-5; TOLERANCE NA; VOLTAGE NA; MISTRAL PART NO 110010080019-R
R586, R588: 0E; RES0402_0-5; VOLTAGE NA; TOLERANCE NA; PART_TYPE RESISTOR~{S}FIXED
TP6, TP47, TP56: THRU HOLE; TP_40X65; MISTRAL PART NO 130009030938
TP7: TP20_SMD; VOLTAGE NA; TOLERANCE NA; PART_TYPE TESTPOINT
TP45: TP20_SMD; TOLERANCE NA; VOLTAGE NA; MISTRAL PART NO NA
TP48: THRU HOLE; TP_40X65; PART_TYPE TESTPOINT
U9: TLV73325PDBV; SOT-23-5
U62: TPS73525DRVR; SON6_25-59_85X85_0-8; VOLTAGE NA; TOLERANCE NA; PART_TYPE IC~{S}POWE~{R}VOLTAGE REGULATOR
U68: TPS51206DSQR; EDFN10_15-74_80X80_0-8; VOLTAGE NA; TOLERANCE NA; PART_TYPE IC~{S}POWE~{R}VOLTAGE REGULATOR
U77: TLV70710DQNR; X2SON4_TLV71318P_40X40_0-4; TOLERANCE NA; VOLTAGE NA; MISTRAL PART NO 142020050029-R

Connections:
DDR_VREFCA: C218.1, U68.6 (VTTREF)
DDR_VTT_EN_3V3: R29.1, TP7.1, U68.7 (S3), U68.9 (S5)
DGND: C25.2, C28.2, C199.1, C200.2, C201.2, C208.2, C210.1, C213.1, C218.2, C219.2, C280.2, C286.2, R29.2, U9.2 (GND), U62.3 (GND), U62.7 (EP), U68.4 (PGND), U68.8 (GND), U68.11 (EP), U77.2 (GND), U77.5 (EP)
unnamed: C200.1, U62.2 (NR/FB)
unnamed: R585.1, U9.3 (EN)
unnamed: R586.1, U62.4 (EN)
unnamed: R588.1, U77.3 (EN)
VCC_3V3_SYS: C25.1, C199.2, C208.1, C219.1, C286.1, U9.1 (IN), U62.6 (IN), U68.2 (VLDOIN), U68.10 (VDD), U77.4 (IN)
VDDR_VTT: C210.2, TP48.1, U68.3 (VTT), U68.5 (VTTSNS)
VDD_1V0: C280.1, TP56.1, U77.1 (OUT)
VDD_2V5: C28.1, TP6.1, U9.5 (OUT)
VDD_DDR4: C213.2, U68.1 (VDDQSNS)
VIN_MON_PORz_3V3_PG: R585.2, R586.2, R588.2, TP45.1
VPP_DDR_2V5: C201.1, TP47.1, U62.1 (OUT)

Notes on the sheet:
D-Note :- Add an RC filter on the sense input Refer TPS51206 data sheet
1.0 V ETHERNET PHY (DP83867) POWER SUPPLY
2.5V, 0.5 AMP SUPPLY
Off Page Connections
PERIPHERAL POWER SUPPLIES
VTT SUPPLY FOR DDR4
TEST AUTOMATION BOARD POWER SUPPLY
2.5 V, 2.0 AMPS SUPPLY
