gingerologist/am64x/40.kicad_sch

## KiCad design 40.kicad_sch (2024-07-28)

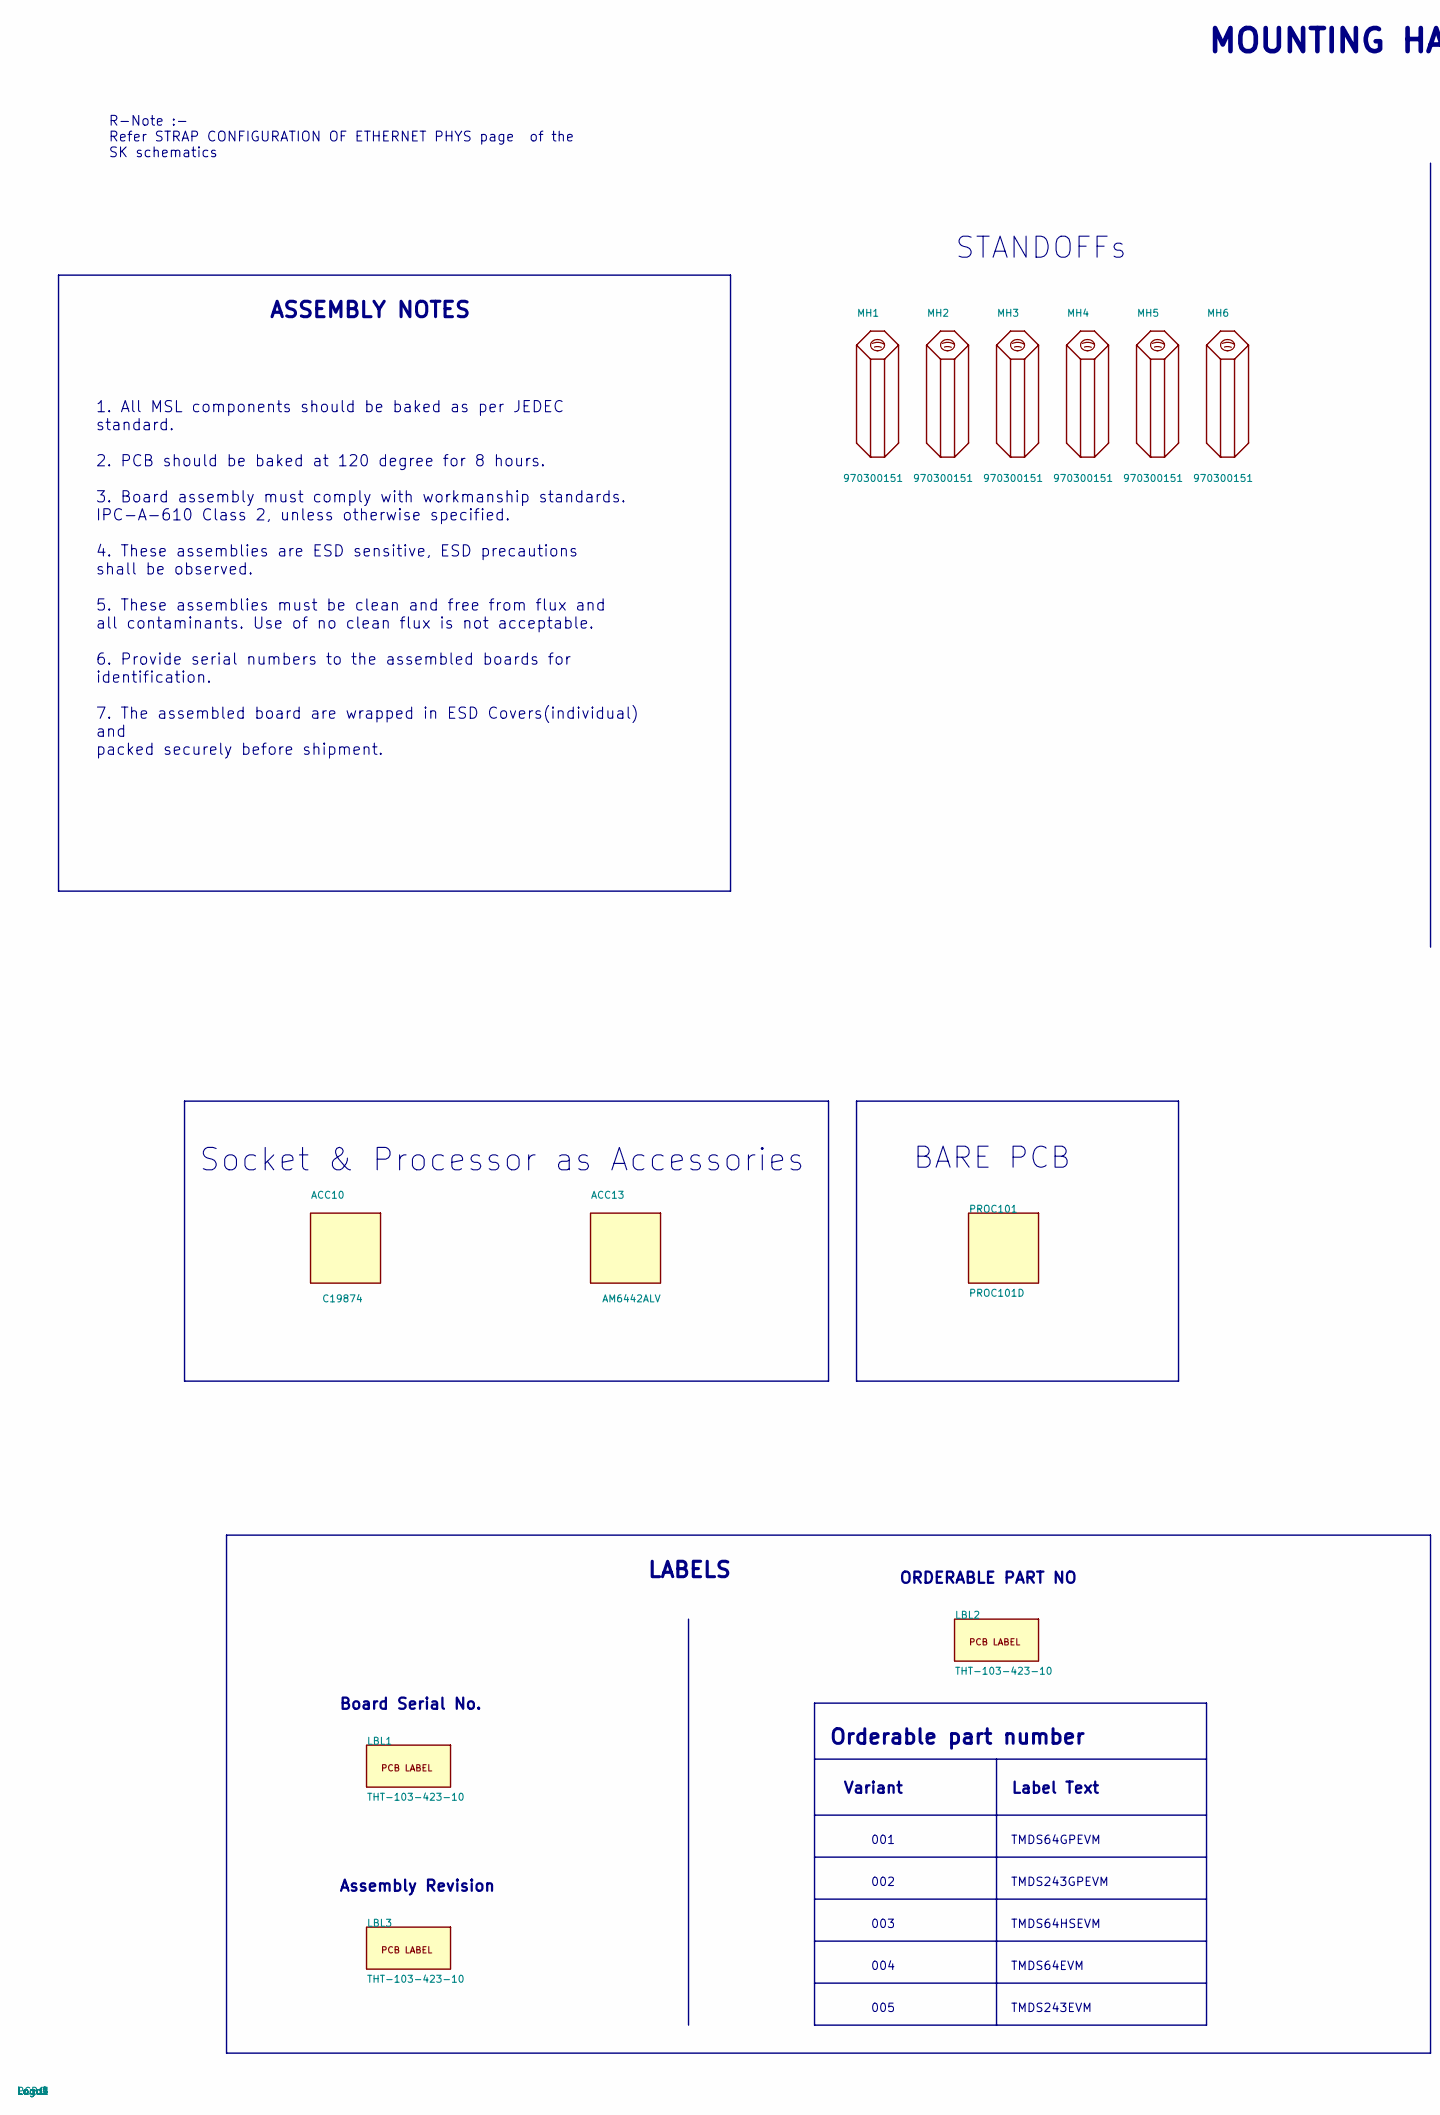
[picture p59: schematic 40.kicad_sch, part in row 1, column 1]

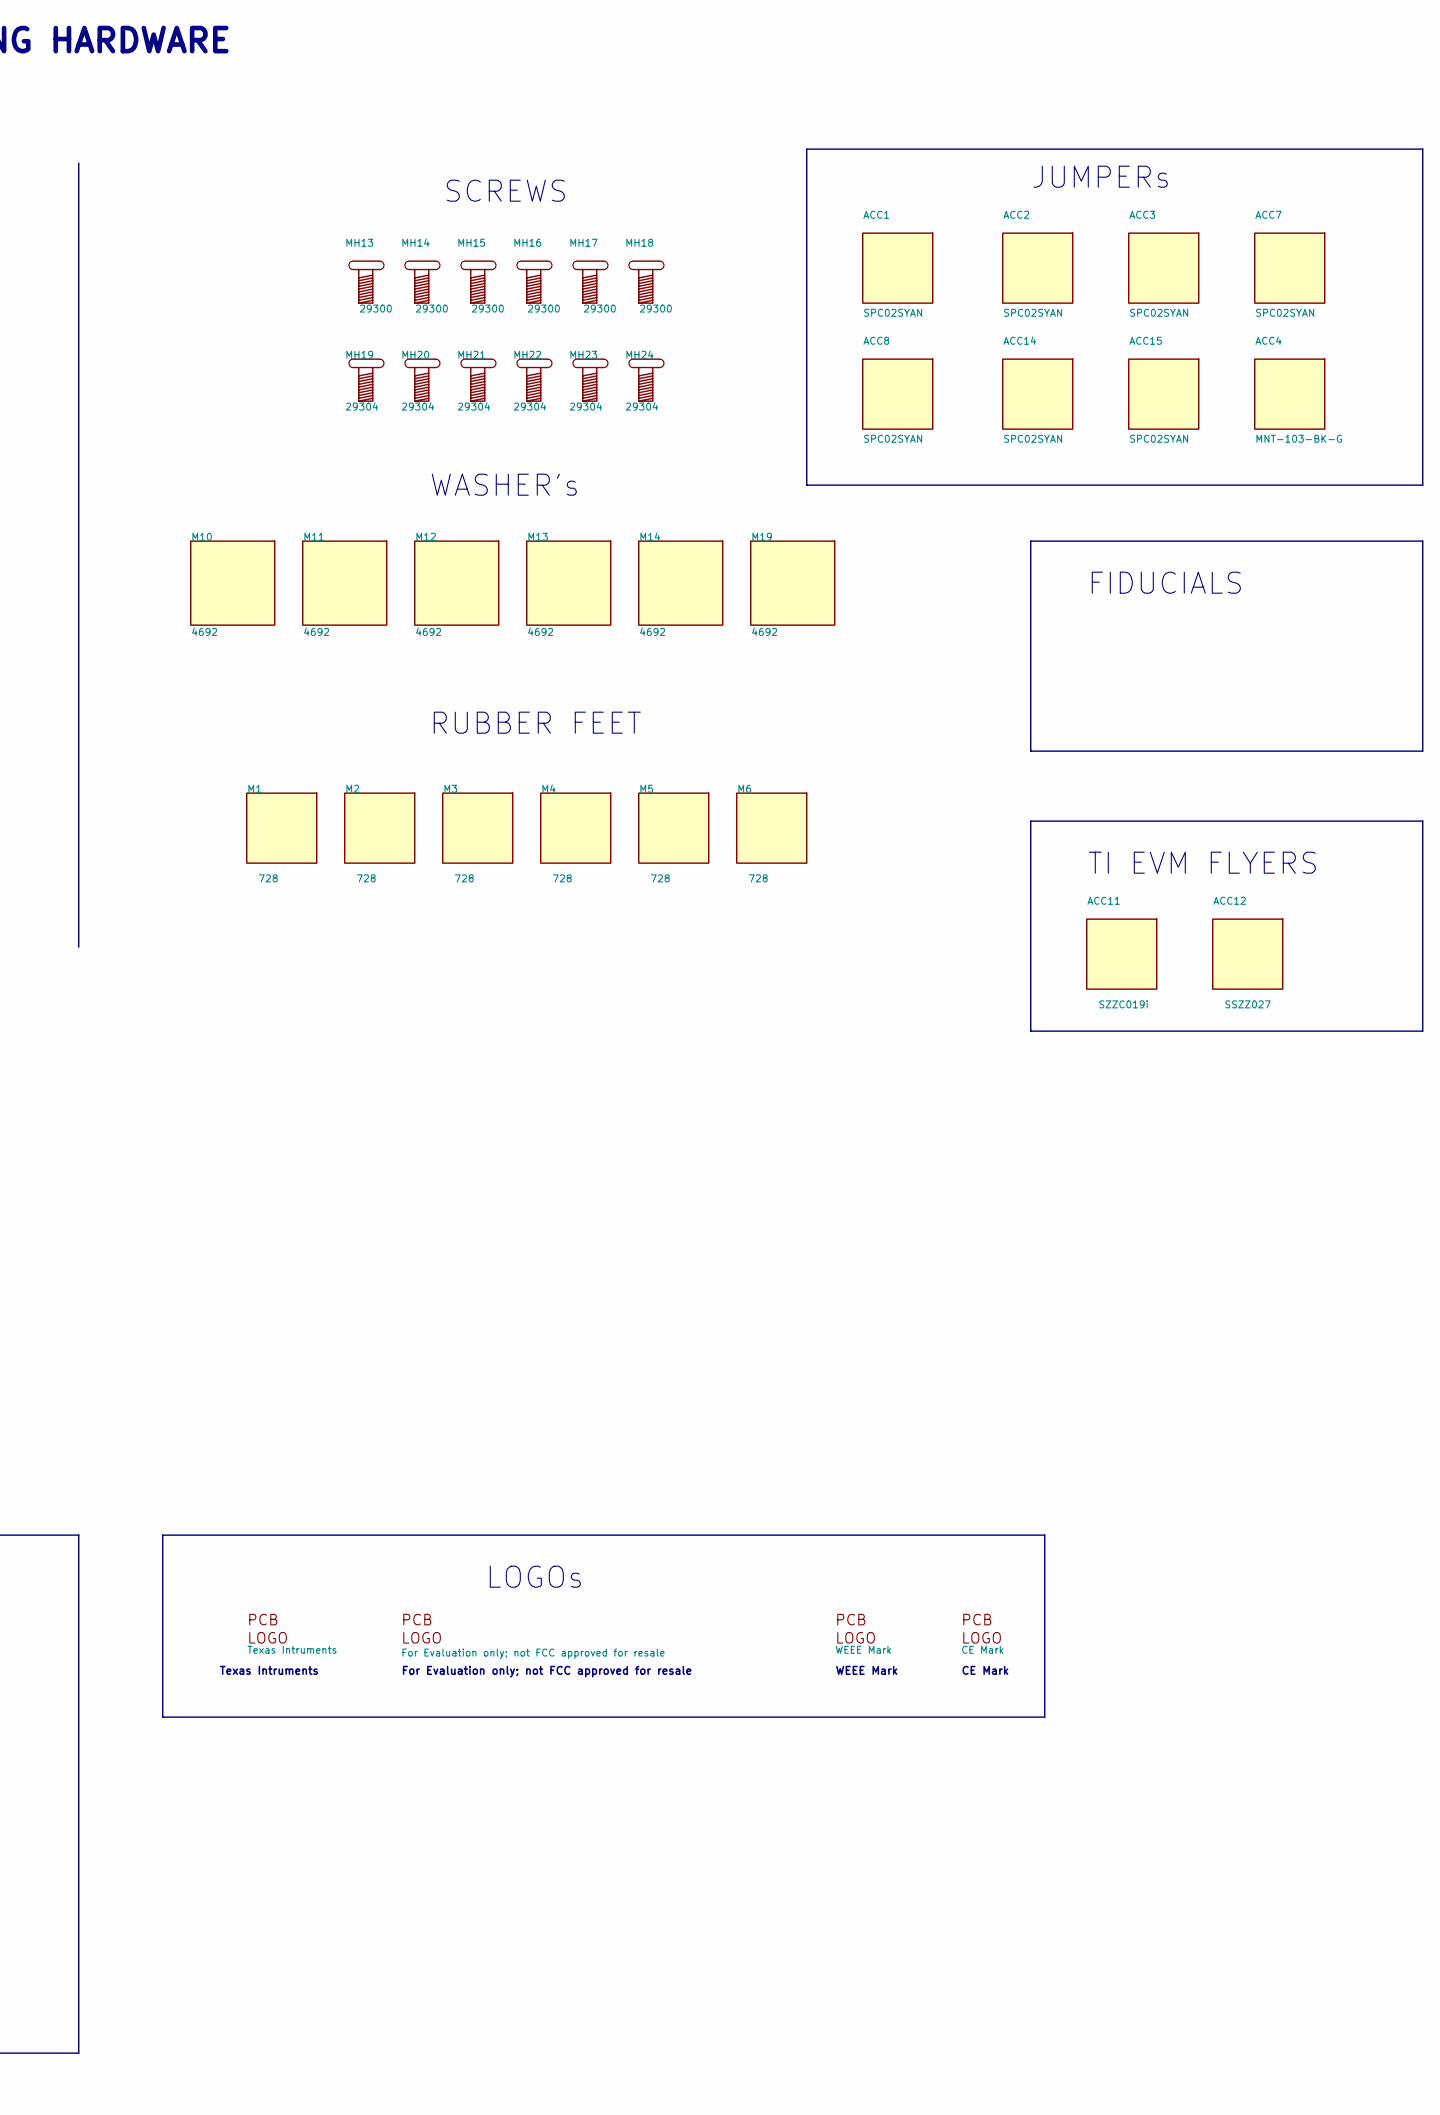
[picture p60: schematic 40.kicad_sch, part in row 1, column 2]

Parts:
ACC1, ACC3, ACC14, ACC15: SPC02SYAN; NA; VOLTAGE NA; TOLERANCE NA; MISTRAL PART NO 160009030153-R
ACC2: SPC02SYAN; NA; VOLTAGE NA; TOLERANCE NA; PART_TYPE ACCESSORIES
ACC4: MNT-103-BK-G; NA; VOLTAGE NA; TOLERANCE NA; PART_TYPE ACCESSORIES
ACC7: SPC02SYAN; NA; TOLERANCE NA; VOLTAGE NA; MISTRAL PART NO 160009030153-R
ACC8: SPC02SYAN; NA; TOLERANCE NA; VOLTAGE NA; PART_TYPE ACCESSORIES
ACC10: C19874; BGASKT441_C19874_1190X1190_11; VOLTAGE NA; TOLERANCE NA; PART_TYPE ACCESSORIES
ACC11: SZZC019i; NA; VOLTAGE NA; TOLERANCE NA; PART_TYPE ACCESSORIES
ACC12: SSZZ027; NA; VOLTAGE NA; TOLERANCE NA; PART_TYPE ACCESSORIES
ACC13: AM6442ALV; TOLERANCE NA; VOLTAGE NA; MISTRAL PART NO 141220040002
LBL1, LBL3: THT-103-423-10; NA; TOLERANCE NA; VOLTAGE NA; MISTRAL PART NO 160018020185
LBL2: THT-103-423-10; NA; VOLTAGE NA; TOLERANCE NA; PART_TYPE ACCESSORIES
Logo1: Texas Intruments; TI_Stacked_Overlay_Small
Logo2: For Evaluation only; not FCC approved for resale; FCC_disclaimer
Logo3: WEEE Mark; TI_Stacked_Overlay_Small
Logo4: CE Mark; TI_Stacked_Overlay_Small
M1, M4: 728; NA; VOLTAGE NA; TOLERANCE NA; PART_TYPE ACCESSORIES
M2, M3, M5, M6: 728; NA; TOLERANCE NA; VOLTAGE NA; MISTRAL PART NO 160018070042-R
M10, M11, M13: PLAIN WASHER_M3; NA; VOLTAGE NA; TOLERANCE NA; PART_TYPE MECHANICA~{L}WASHERS
M12, M14, M19: PLAIN WASHER_M3; NA; TOLERANCE NA; VOLTAGE NA; MISTRAL PART NO 160018020078-R
MH1: HEX SPACER_M2.5 X 30; NA; TOLERANCE NA; VOLTAGE NA; MISTRAL PART NO 160018020071-R
MH2, MH3, MH4, MH5, MH6: HEX SPACER_M2.5 X 30; NA; VOLTAGE NA; TOLERANCE NA; PART_TYPE MECHANICA~{L}SPACER
MH13, MH14, MH18: PAN HEAD_M2.5 X 4; NA; TOLERANCE NA; VOLTAGE NA; MISTRAL PART NO 160018020076-R
MH15, MH16, MH17: PAN HEAD_M2.5 X 4; NA; VOLTAGE NA; TOLERANCE NA; PART_TYPE MECHANICA~{L}SCREWS
MH19, MH21, MH23: PAN HEAD_M2.5 X 12; NA; TOLERANCE NA; VOLTAGE NA; MISTRAL PART NO 160018070043-R
MH20, MH22, MH24: PAN HEAD_M2.5 X 12; NA; VOLTAGE NA; TOLERANCE NA; PART_TYPE ACCESSORIES
PCB1: PROC101; MFR_PART_NUMBER PROC101D

Notes on the sheet:
R-Note :- Refer STRAP CONFIGURATION OF ETHERNET PHYS page of the SK schematics
1. All MSL components should be baked as per JEDEC standard. 2. PCB should be baked at 120 degree for 8 hours. 3. Board assembly must comply with workmanship standards. IPC-A-610 Class 2, unless otherwise specified. 4. These assemblies are ESD sensitive, ESD precautions shall be observed. 5. These 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
WASHER's
WEEE Mark
004
MOUNTING HARDWARE
TMDS64HSEVM
Board Serial No.
STANDOFFs
For Evaluation only; not FCC approved for resale
TI EVM FLYERS
Label Text
ASSEMBLY NOTES
Variant
LABELS
CE Mark
TMDS243EVM
ORDERABLE PART NO
003
Texas Intruments
BARE PCB
TMDS243GPEVM
FIDUCIALS
SCREWS
TMDS64EVM
Orderable part number
005
001
TMDS64GPEVM
JUMPERs
Socket & Processor as Accessories
LOGOs
002
Assembly Revision
RUBBER FEET
