gingerologist/am64x/fixpcb.kicad_sch

## KiCad design fixpcb.kicad_sch (2024-08-05)

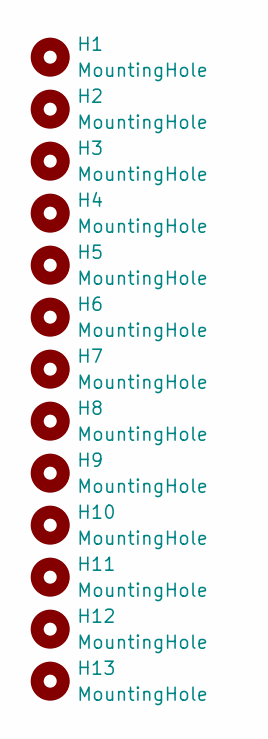
[picture p61: schematic fixpcb.kicad_sch]

Parts:
H1, H2, H3, H4, H5, H6, H7, H8, H9, H10, H11, H12, H13: MountingHole; MountingHole_2.7mm_M2.5
