gingerologist/am64x/usb-power-efuse.kicad_sch

## KiCad design usb-power-efuse.kicad_sch (2024-08-05)

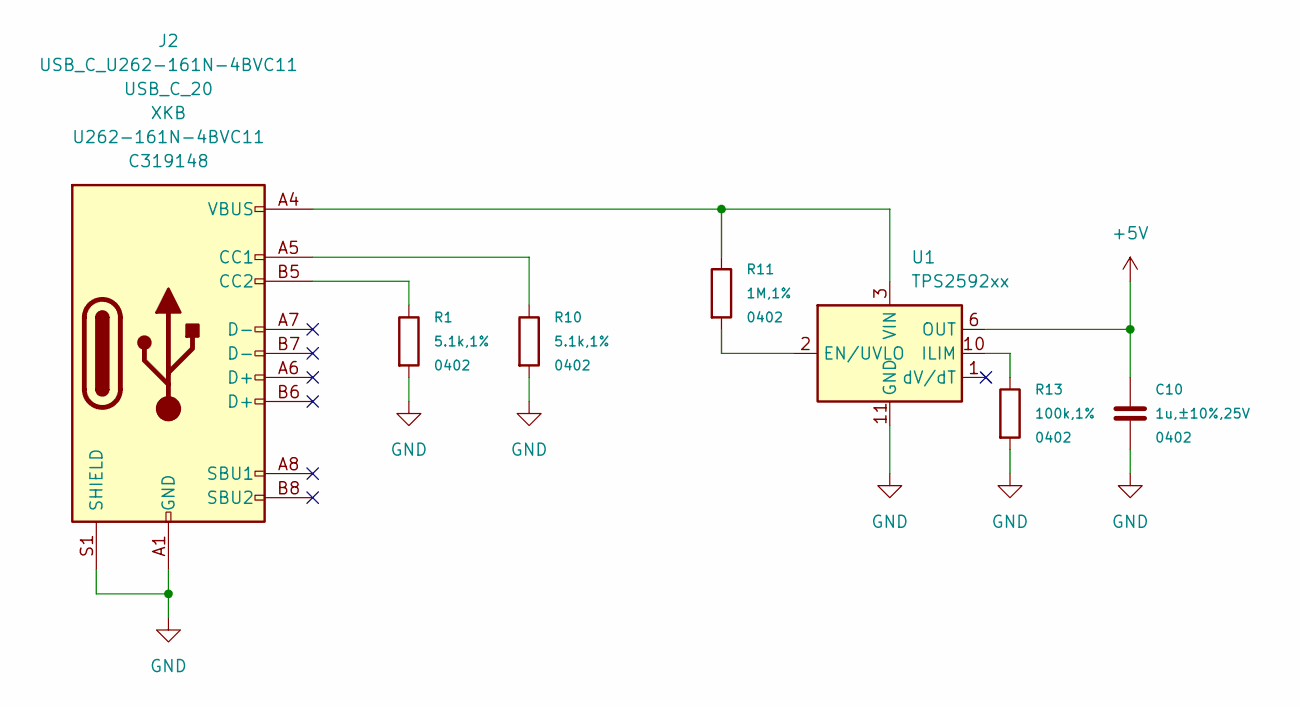
[picture p62: schematic usb-power-efuse.kicad_sch]

Parts:
C10: 1u,±10%,25V; C_0402_1005Metric_for_0.25mm_grid; Manufacturer Part CL05A105KA5NQNC
J2: USB_C_U262-161N-4BVC11; USB_C_Receptacle_XKB_U262-16XN-4BVC11; Manufacturer Part U262-161N-4BVC11
R1, R10: 5.1k,1%; R_0402_1005Metric_for_0.25mm_grid; Manufacturer Part 0402WGF5101TCE
R11: 1M,1%; R_0402_1005Metric_for_0.25mm_grid; Manufacturer Part 0402WGF1004TCE
R13: 100k,1%; R_0402_1005Metric_for_0.25mm_grid; Manufacturer Part 0402WGF1003TCE
U1: TPS2592xx; VSON-10-1EP_3x3mm_P0.5mm_EP1.65x2.4mm_ThermalVias

Connections:
+5V: C10.1, U1.6 (OUT), U1.7 (OUT), U1.8 (OUT)
GND: C10.2, J2.A1 (GND), J2.A12 (GND), J2.B1 (GND), J2.B12 (GND), J2.S1 (SHIELD), R1.2, R10.2, R13.2, U1.11 (GND)
unnamed: J2.A4 (VBUS), J2.A9 (VBUS), J2.B4 (VBUS), J2.B9 (VBUS), R11.1, U1.3 (VIN), U1.4 (VIN), U1.5 (VIN)
unnamed: J2.A5 (CC1), R10.1
unnamed: J2.B5 (CC2), R1.1
unnamed: R11.2, U1.2 (EN/UVLO)
unnamed: R13.1, U1.10 (ILIM)
