gingerologist/am64x/(commit log)

2024-07-25 initial commit, see README.md
    [01.SchDoc, 01.kicad_sch, 02.SchDoc, 02.kicad_sch, 03.SchDoc, 03.kicad_sch, 04.SchDoc, 04.kicad_sch]
2024-07-25 fix joint, offpage, and typo
    DRC errors are cleared, some warnings remain.
    [01.kicad_sch, 09.kicad_sch, 10.kicad_sch, 11.kicad_sch, 12.kicad_sch, 13.kicad_sch, 14.kicad_sch, 15.kicad_sch]
2024-07-26 fix 1. add mounting holes, remove rule areas around. 2. change net class clearance and minimal via size.
    [09.kicad_sch, 11.kicad_sch, 12.kicad_sch, 13.kicad_sch, 14.kicad_sch, 16.kicad_sch, 17.kicad_sch, 18.kicad_sch]
2024-07-28 fixpcb.
    TODO clean up zones and keepouts on all layers. (top done almost)
    [19.kicad_sch, 25.kicad_sch, 40.kicad_sch]
2024-08-05 a lot, mpu power almost ready.
    [09.kicad_sch, 10.kicad_sch, 11.kicad_sch, 12.kicad_sch, 13.kicad_sch, 14.kicad_sch, 15.kicad_sch, 16.kicad_sch]
